SiwaNetwork/CASS/Прототип исходника фото.jpg

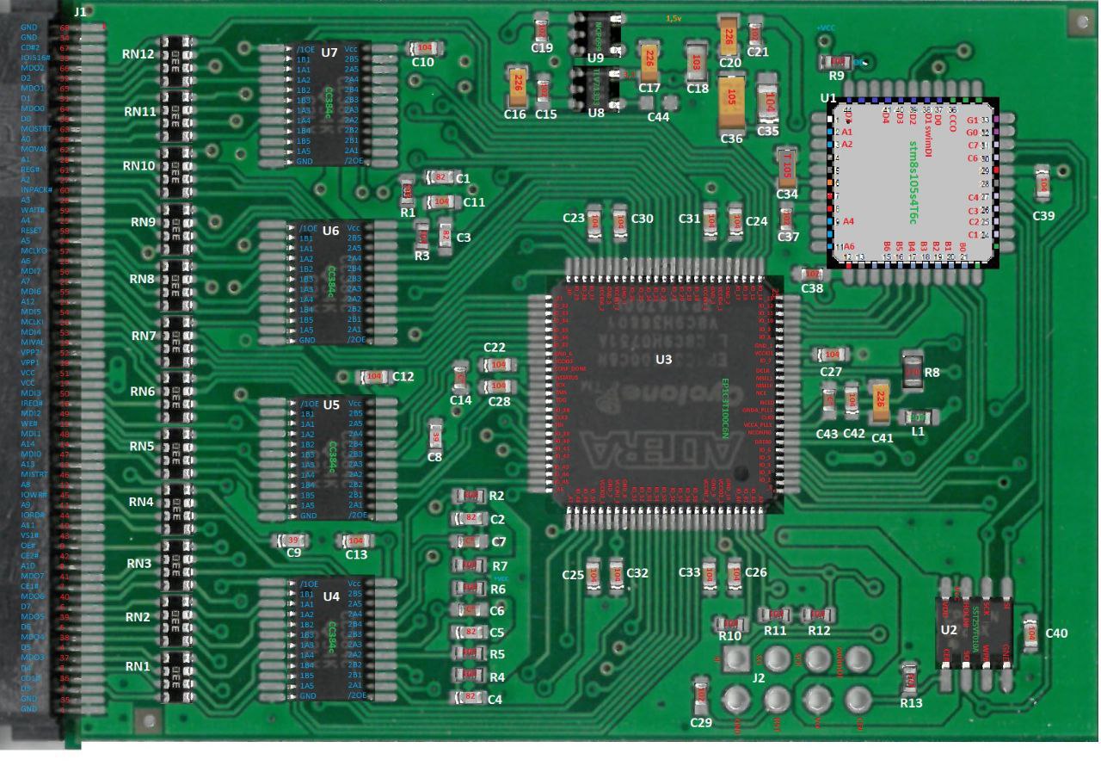
Прототип исходника фото.jpg
