SiwaNetwork/CASS/Корпус/Новая папка/Безымянный.png

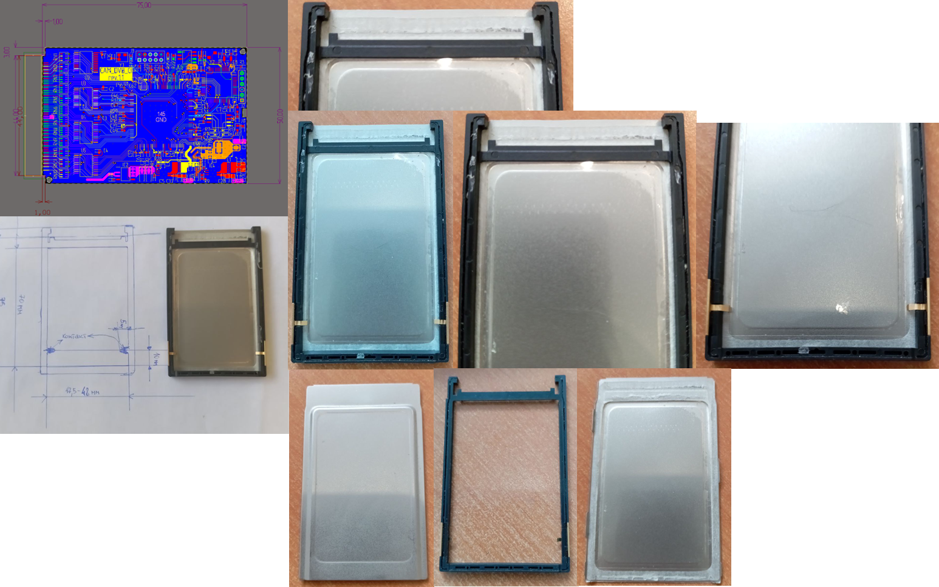
Корпус/Новая папка/Безымянный.png
