SiwaNetwork/CASS/CAM_LATTICE_STM/ECAD/README.md

# CAM_DVB_CI_v2

CAM модуль версии 2:
rev.2.0
* ПЛИС Lattice LFE5U-25F-6BG256C 
* шинники изменены на прямую версию
* добавлены тестовые пады для прошивки на станке

rev.2.01
* изменена распиновка ПЛИС

rev.2.02
* уменьшена ширина на 1мм

rev.2.1
todo
* изменить габариты платы в соответствии с новым корпусом
* внедрить коммутатор PCMCIA - JTAG
после тестирования на altera

* отказаться от шинников
