SiwaNetwork/CASS/CAM_LATTICE_STM/LATTICE REFERENCE/FPGA-SC-02033-2-0-ECP5U-25-Pinout color.xlsx

PAD | Pin/Ball Function | Bank | Dual Function | Differential | High Speed | DQS | CABGA256
0 | GND | - | - | - | - | - | A1
315 | PT42B | 1 | - | Comp_OF_PT42A | - | - | A10
304 | PT53A | 1 | - | True_OF_PT53B | - | - | A11
301 | PT53B | 1 | - | Comp_OF_PT53A | - | - | A12
288 | PT65A | 1 | - | True_OF_PT65B | - | - | A13
285 | PT65B | 1 | - | Comp_OF_PT65A | - | - | A14
283 | PT67B | 1 | - | Comp_OF_PT67A | - | - | A15
0 | GND | - | - | - | - | - | A16
368 | PT4A | 0 | - | True_OF_PT4B | - | - | A2
366 | PT6A | 0 | - | True_OF_PT6B | - | - | A3
363 | PT6B | 0 | - | Comp_OF_PT6A | - | - | A4
3 | VSSIO7 | - | - | - | - | - | -
350 | PT18A | 0 | - | True_OF_PT18B | - | - | A5
5 | VCCIO7 | - | - | - | - | - | -
347 | PT18B | 0 | - | Comp_OF_PT18A | - | - | A6
336 | PT29A | 0 | PCLKT0_0 | True_OF_PT29B | - | - | A7
8 | VCCAUX | - | - | - | - | - | -
333 | PT29B | 0 | PCLKC0_0 | Comp_OF_PT29A | - | - | A8
318 | PT42A | 1 | - | True_OF_PT42B | - | - | A9
11 | VSS | - | - | - | - | - | -
1 | PL2A | 7 | - | True_OF_PL2B | TRUE | LDQ8 | B1
316 | PT44A | 1 | - | True_OF_PT44B | - | - | B10
14 | VCC | - | - | - | - | - | -
310 | PT49A | 1 | - | True_OF_PT49B | - | - | B11
300 | PT56A | 1 | - | True_OF_PT56B | - | - | B12
17 | VSS | - | - | - | - | - | -
294 | PT60A | 1 | - | True_OF_PT60B | - | - | B13
286 | PT67A | 1 | - | True_OF_PT67B | - | - | B14
20 | VSSIO7 | - | - | - | - | - | -
277 | PR2B | 2 | S0_IN | Comp_OF_PR2A | TRUE | RDQ8 | B15
278 | PR2A | 2 | - | True_OF_PR2B | TRUE | RDQ8 | B16
23 | VCCIO7 | - | - | - | - | - | -
2 | PL2B | 7 | - | Comp_OF_PL2A | TRUE | LDQ8 | B2
365 | PT4B | 0 | - | Comp_OF_PT4A | - | - | B3
26 | VSSIO7 | - | - | - | - | - | -
357 | PT11B | 0 | - | Comp_OF_PT11A | - | - | B4
351 | PT15B | 0 | - | Comp_OF_PT15A | - | - | B5
29 | VCCIO7 | - | - | - | - | - | -
341 | PT22B | 0 | - | Comp_OF_PT22A | - | - | B6
335 | PT27B | 0 | PCLKC0_1 | Comp_OF_PT27A | - | - | B7
32 | VCCAUX | - | - | - | - | - | -
325 | PT35B | 1 | PCLKC1_0 | Comp_OF_PT35A | - | - | B8
324 | PT38A | 1 | GR_PCLK1_0 | True_OF_PT38B | - | - | B9
35 | VSS | - | - | - | - | - | -
7 | PL5A | 7 | - | True_OF_PL5B | TRUE | LDQ8 | C1
313 | PT44B | 1 | - | Comp_OF_PT44A | - | - | C10
38 | VCC | - | - | - | - | - | -
307 | PT49B | 1 | - | Comp_OF_PT49A | - | - | C11
297 | PT56B | 1 | - | Comp_OF_PT56A | - | - | C12
41 | VSS | - | - | - | - | - | -
291 | PT60B | 1 | - | Comp_OF_PT60A | - | - | C13
275 | PR2C | 2 | - | True_OF_PR2D | - | RDQ8 | C14
44 | VSSIO7 | - | - | - | - | - | -
269 | PR5B | 2 | - | Comp_OF_PR5A | TRUE | RDQ8 | C15
272 | PR5A | 2 | - | True_OF_PR5B | TRUE | RDQ8 | C16
47 | VCCIO7 | - | - | - | - | - | -
10 | PL5B | 7 | - | Comp_OF_PL5A | TRUE | LDQ8 | C2
4 | PL2C | 7 | - | True_OF_PL2D | - | LDQ8 | C3
50 | VSSIO6 | - | - | - | - | - | -
360 | PT11A | 0 | - | True_OF_PT11B | - | - | C4
354 | PT15A | 0 | - | True_OF_PT15B | - | - | C5
53 | VCCIO6 | - | - | - | - | - | -
344 | PT22A | 0 | - | True_OF_PT22B | - | - | C6
338 | PT27A | 0 | PCLKT0_1 | True_OF_PT27B | - | - | C7
56 | VCCAUX | - | - | - | - | - | -
328 | PT35A | 1 | PCLKT1_0 | True_OF_PT35B | - | - | C8
321 | PT38B | 1 | GR_PCLK1_1 | Comp_OF_PT38A | - | - | C9
59 | VSS | - | - | - | - | - | -
13 | PL8A | 7 | - | True_OF_PL8B | TRUE | LDQS8 | D1
312 | PT47A | 1 | - | True_OF_PT47B | - | - | D10
62 | VCC | - | - | - | - | - | -
306 | PT51A | 1 | - | True_OF_PT51B | - | - | D11
298 | PT58A | 1 | - | True_OF_PT58B | - | - | D12
65 | VSS | - | - | - | - | - | -
292 | PT62A | 1 | - | True_OF_PT62B | - | - | D13
273 | PR2D | 2 | - | Comp_OF_PR2C | - | RDQ8 | D14
68 | VSSIO6 | - | - | - | - | - | -
0 | GND | - | - | - | - | - | D15
266 | PR8A | 2 | - | True_OF_PR8B | TRUE | RDQS8 | D16
71 | VCCIO6 | - | - | - | - | - | -
0 | GND | - | - | - | - | - | D2
6 | PL2D | 7 | - | Comp_OF_PL2C | - | LDQ8 | D3
74 | VSSIO6 | - | - | - | - | - | -
359 | PT9B | 0 | - | Comp_OF_PT9A | - | - | D4
353 | PT13B | 0 | - | Comp_OF_PT13A | - | - | D5
77 | VCCIO6 | - | - | - | - | - | -
345 | PT20B | 0 | - | Comp_OF_PT20A | - | - | D6
339 | PT24B | 0 | GR_PCLK0_0 | Comp_OF_PT24A | - | - | D7
80 | VCCAUX | - | - | - | - | - | -
327 | PT33B | 1 | PCLKC1_1 | Comp_OF_PT33A | - | - | D8
322 | PT40A | 1 | - | True_OF_PT40B | - | - | D9
83 | VSS | - | - | - | - | - | -
24 | PL11D | 7 | - | Comp_OF_PL11C | - | LDQ8 | E1
309 | PT47B | 1 | - | Comp_OF_PT47A | - | - | E10
86 | VCC | - | - | - | - | - | -
303 | PT51B | 1 | - | Comp_OF_PT51A | - | - | E11
295 | PT58B | 1 | - | Comp_OF_PT58A | - | - | E12
89 | VSS | - | - | - | - | - | -
289 | PT62B | 1 | - | Comp_OF_PT62A | - | - | E13
270 | PR5C | 2 | - | True_OF_PR5D | - | RDQ8 | E14
92 | VSSIO6 | - | - | - | - | - | -
263 | PR8B | 2 | - | Comp_OF_PR8A | TRUE | RDQSN8 | E15
94 | VCCIO6 | - | - | - | - | - | -
255 | PR11D | 2 | - | Comp_OF_PR11C | - | RDQ8 | E16
16 | PL8B | 7 | - | Comp_OF_PL8A | TRUE | LDQSN8 | E2
97 | NC | - | - | - | - | - | -
98 | NC | - | - | - | - | - | -
99 | GND | - | - | - | - | - | -
100 | VCC | - | - | - | - | - | -
101 | VCC | - | - | - | - | - | -
102 | VSS | - | - | - | - | - | -
9 | PL5C | 7 | - | True_OF_PL5D | - | LDQ8 | E3
362 | PT9A | 0 | - | True_OF_PT9B | - | - | E4
105 | VCC | - | - | - | - | - | -
356 | PT13A | 0 | - | True_OF_PT13B | - | - | E5
348 | PT20A | 0 | - | True_OF_PT20B | - | - | E6
108 | VSS | - | - | - | - | - | -
342 | PT24A | 0 | GR_PCLK0_1 | True_OF_PT24B | - | - | E7
330 | PT33A | 1 | PCLKT1_1 | True_OF_PT33B | - | - | E8
111 | VSSIO8 | - | - | - | - | - | -
319 | PT40B | 1 | - | Comp_OF_PT40A | - | - | E9
25 | PL14A | 7 | - | True_OF_PL14B | TRUE | LDQ20 | F1
114 | VCCIO8 | - | - | - | - | - | -
0 | VCCIO1 | 1 | - | - | - | - | F10
0 | VCCIO1 | 1 | - | - | - | - | F11
117 | VSSIO8 | - | - | - | - | - | -
261 | PR8D | 2 | - | Comp_OF_PR8C | - | RDQ8 | F12
264 | PR8C | 2 | - | True_OF_PR8D | - | RDQ8 | F13
120 | VCCIO8 | - | - | - | - | - | -
267 | PR5D | 2 | - | Comp_OF_PR5C | - | RDQ8 | F14
258 | PR11C | 2 | - | True_OF_PR11D | - | RDQ8 | F15
123 | VCCAUX | - | - | - | - | - | -
254 | PR14A | 2 | - | True_OF_PR14B | TRUE | RDQ20 | F16
21 | PL11C | 7 | - | True_OF_PL11D | - | LDQ8 | F2
126 | VSS | - | - | - | - | - | -
12 | PL5D | 7 | - | Comp_OF_PL5C | - | LDQ8 | F3
15 | PL8C | 7 | - | True_OF_PL8D | - | LDQ8 | F4
129 | VCC | - | - | - | - | - | -
18 | PL8D | 7 | - | Comp_OF_PL8C | - | LDQ8 | F5
0 | VCCIO0 | 0 | - | - | - | - | F6
132 | VSS | - | - | - | - | - | -
0 | VCCIO0 | 0 | - | - | - | - | F7
0 | GND | - | - | - | - | - | F8
135 | VSSIO8 | - | - | - | - | - | -
0 | GND | - | - | - | - | - | F9
37 | PL20A | 7 | GR_PCLK7_1 | True_OF_PL20B | TRUE | LDQS20 | G1
138 | VCCIO8 | - | - | - | - | - | -
139 | VCC | - | - | - | - | - | -
140 | VCC | - | - | - | - | - | -
141 | VSS | - | - | - | - | - | -
142 | VSS | - | - | - | - | - | -
143 | VCC | - | - | - | - | - | -
144 | VCC | - | - | - | - | - | -
145 | GND | - | - | - | - | - | -
146 | GND | - | - | - | - | - | -
147 | RESERVED | - | - | - | - | - | -
148 | GND | - | - | - | - | - | -
149 | RESERVED | - | - | - | - | - | -
150 | GND | - | - | - | - | - | -
151 | GND | - | - | - | - | - | -
152 | GND | - | - | - | - | - | -
153 | GND | - | - | - | - | - | -
154 | GND | - | - | - | - | - | -
155 | GND | - | - | - | - | - | -
156 | GND | - | - | - | - | - | -
157 | GND | - | - | - | - | - | -
158 | GND | - | - | - | - | - | -
159 | GND | - | - | - | - | - | -
160 | GND | - | - | - | - | - | -
161 | GND | - | - | - | - | - | -
162 | GND | - | - | - | - | - | -
163 | GND | - | - | - | - | - | -
164 | RESERVED | - | - | - | - | - | -
165 | GND | - | - | - | - | - | -
166 | RESERVED | - | - | - | - | - | -
167 | GND | - | - | - | - | - | -
168 | GND | - | - | - | - | - | -
169 | RESERVED | - | - | - | - | - | -
170 | GND | - | - | - | - | - | -
171 | RESERVED | - | - | - | - | - | -
172 | GND | - | - | - | - | - | -
173 | GND | - | - | - | - | - | -
174 | GND | - | - | - | - | - | -
175 | GND | - | - | - | - | - | -
176 | GND | - | - | - | - | - | -
177 | VCC | - | - | - | - | - | -
178 | VSS | - | - | - | - | - | -
179 | VCC | - | - | - | - | - | -
180 | GND | - | - | - | - | - | -
181 | NC | - | - | - | - | - | -
182 | NC | - | - | - | - | - | -
0 | GND | - | - | - | - | - | G10
0 | VCCAUX | - | - | - | - | - | G11
185 | VCCIO3 | - | - | - | - | - | -
260 | PR11A | 2 | - | True_OF_PR11B | TRUE | RDQ8 | G12
187 | VSSIO3 | - | - | - | - | - | -
257 | PR11B | 2 | - | Comp_OF_PR11A | TRUE | RDQ8 | G13
252 | PR14C | 2 | VREF1_2 | True_OF_PR14D | - | RDQ20 | G14
190 | VSS | - | - | - | - | - | -
251 | PR14B | 2 | - | Comp_OF_PR14A | TRUE | RDQ20 | G15
242 | PR20A | 2 | GR_PCLK2_1 | True_OF_PR20B | TRUE | RDQS20 | G16
193 | VCC | - | - | - | - | - | -
28 | PL14B | 7 | - | Comp_OF_PL14A | TRUE | LDQ20 | G2
27 | PL14C | 7 | VREF1_7 | True_OF_PL14D | - | LDQ20 | G3
196 | VSS | - | - | - | - | - | -
22 | PL11B | 7 | - | Comp_OF_PL11A | TRUE | LDQ8 | G4
19 | PL11A | 7 | - | True_OF_PL11B | TRUE | LDQ8 | G5
199 | VCCAUX | - | - | - | - | - | -
0 | VCC | - | - | - | - | - | G6
0 | VCC | - | - | - | - | - | G7
202 | VCCIO3 | - | - | - | - | - | -
0 | GND | - | - | - | - | - | G8
0 | VCC | - | - | - | - | - | G9
205 | VSSIO3 | - | - | - | - | - | -
0 | GND | - | - | - | - | - | H1
0 | GND | - | - | - | - | - | H10
208 | VCCIO3 | - | - | - | - | - | -
0 | VCCIO2 | 2 | - | - | - | - | H11
248 | PR17A | 2 | - | True_OF_PR17B | TRUE | RDQ20 | H12
211 | VSSIO3 | - | - | - | - | - | -
245 | PR17B | 2 | - | Comp_OF_PR17A | TRUE | RDQ20 | H13
249 | PR14D | 2 | - | Comp_OF_PR14C | - | RDQ20 | H14
214 | VSS | - | - | - | - | - | -
239 | PR20B | 2 | - | Comp_OF_PR20A | TRUE | RDQSN20 | H15
0 | GND | - | - | - | - | - | H16
217 | VCC | - | - | - | - | - | -
40 | PL20B | 7 | - | Comp_OF_PL20A | TRUE | LDQSN20 | H2
30 | PL14D | 7 | - | Comp_OF_PL14C | - | LDQ20 | H3
220 | VSS | - | - | - | - | - | -
34 | PL17B | 7 | - | Comp_OF_PL17A | TRUE | LDQ20 | H4
31 | PL17A | 7 | - | True_OF_PL17B | TRUE | LDQ20 | H5
223 | VCCAUX | - | - | - | - | - | -
0 | VCCIO7 | 7 | - | - | - | - | H6
0 | VCCIO7 | 7 | - | - | - | - | H7
226 | VCCIO3 | - | - | - | - | - | -
0 | GND | - | - | - | - | - | H8
0 | GND | - | - | - | - | - | H9
229 | VSSIO3 | - | - | - | - | - | -
43 | PL23A | 7 | PCLKT7_1 | True_OF_PL23B | TRUE | LDQ20 | J1
0 | GND | - | - | - | - | - | J10
232 | VCCIO2 | - | - | - | - | - | -
0 | VCCIO2 | 2 | - | - | - | - | J11
243 | PR17D | 2 | - | Comp_OF_PR17C | - | RDQ20 | J12
235 | VSSIO2 | - | - | - | - | - | -
246 | PR17C | 2 | - | True_OF_PR17D | - | RDQ20 | J13
240 | PR20C | 2 | GR_PCLK2_0 | True_OF_PR20D | - | RDQ20 | J14
238 | VSS | - | - | - | - | - | -
233 | PR23B | 2 | PCLKC2_1 | Comp_OF_PR23A | TRUE | RDQ20 | J15
236 | PR23A | 2 | PCLKT2_1 | True_OF_PR23B | TRUE | RDQ20 | J16
241 | VCC | - | - | - | - | - | -
46 | PL23B | 7 | PCLKC7_1 | Comp_OF_PL23A | TRUE | LDQ20 | J2
39 | PL20C | 7 | GR_PCLK7_0 | True_OF_PL20D | - | LDQ20 | J3
244 | VSS | - | - | - | - | - | -
33 | PL17C | 7 | - | True_OF_PL17D | - | LDQ20 | J4
36 | PL17D | 7 | - | Comp_OF_PL17C | - | LDQ20 | J5
247 | VCCAUX | - | - | - | - | - | -
0 | VCCIO6 | 6 | - | - | - | - | J6
0 | VCCIO6 | 6 | - | - | - | - | J7
250 | VCCIO2 | - | - | - | - | - | -
0 | GND | - | - | - | - | - | J8
0 | GND | - | - | - | - | - | J9
253 | VSSIO2 | - | - | - | - | - | -
45 | PL23C | 7 | PCLKT7_0 | True_OF_PL23D | - | LDQ20 | K1
0 | GND | - | - | - | - | - | K10
256 | VCCIO2 | - | - | - | - | - | -
0 | VCCIO3 | 3 | - | - | - | - | K11
221 | PR29B | 3 | - | Comp_OF_PR29A | TRUE | RDQ32 | K12
259 | VSSIO2 | - | - | - | - | - | -
224 | PR29A | 3 | GR_PCLK3_0 | True_OF_PR29B | TRUE | RDQ32 | K13
237 | PR20D | 2 | - | Comp_OF_PR20C | - | RDQ20 | K14
262 | VSS | - | - | - | - | - | -
231 | PR23D | 2 | PCLKC2_0 | Comp_OF_PR23C | - | RDQ20 | K15
234 | PR23C | 2 | PCLKT2_0 | True_OF_PR23D | - | RDQ20 | K16
265 | VCC | - | - | - | - | - | -
48 | PL23D | 7 | PCLKC7_0 | Comp_OF_PL23C | - | LDQ20 | K2
42 | PL20D | 7 | - | Comp_OF_PL20C | - | LDQ20 | K3
268 | VSS | - | - | - | - | - | -
55 | PL29A | 6 | GR_PCLK6_0 | True_OF_PL29B | TRUE | LDQ32 | K4
58 | PL29B | 6 | - | Comp_OF_PL29A | TRUE | LDQ32 | K5
271 | VCCAUX | - | - | - | - | - | -
0 | GND | - | - | - | - | - | K6
0 | GND | - | - | - | - | - | K7
274 | VCCIO2 | - | - | - | - | - | -
0 | GND | - | - | - | - | - | K8
276 | VSSIO2 | - | - | - | - | - | -
0 | GND | - | - | - | - | - | K9
49 | PL26A | 6 | PCLKT6_1 | True_OF_PL26B | TRUE | LDQ32 | L1
279 | GND | - | - | - | - | - | -
280 | VCC | - | - | - | - | - | -
281 | VSS | - | - | - | - | - | -
282 | VCC | - | - | - | - | - | -
0 | VCC | - | - | - | - | - | L10
284 | VCCIO1 | - | - | - | - | - | -
0 | VCCIO3 | 3 | - | - | - | - | L11
219 | PR29D | 3 | - | Comp_OF_PR29C | - | RDQ32 | L12
287 | VSSIO1 | - | - | - | - | - | -
222 | PR29C | 3 | GR_PCLK3_1 | True_OF_PR29D | - | RDQ32 | L13
216 | PR32C | 3 | - | True_OF_PR32D | - | RDQ32 | L14
290 | VSS | - | - | - | - | - | -
227 | PR26B | 3 | PCLKC3_1 | Comp_OF_PR26A | TRUE | RDQ32 | L15
230 | PR26A | 3 | PCLKT3_1 | True_OF_PR26B | TRUE | RDQ32 | L16
293 | VCC | - | - | - | - | - | -
52 | PL26B | 6 | PCLKC6_1 | Comp_OF_PL26A | TRUE | LDQ32 | L2
63 | PL32C | 6 | - | True_OF_PL32D | - | LDQ32 | L3
296 | VSS | - | - | - | - | - | -
57 | PL29C | 6 | GR_PCLK6_1 | True_OF_PL29D | - | LDQ32 | L4
60 | PL29D | 6 | - | Comp_OF_PL29C | - | LDQ32 | L5
299 | VCCAUX | - | - | - | - | - | -
124 | CCLK | 8 | MCLK/SCK | - | - | - | N9
0 | VCCAUX | - | - | - | - | - | L7
302 | VCCIO1 | - | - | - | - | - | -
0 | VCC | - | - | - | - | - | L8
0 | VCC | - | - | - | - | - | L9
305 | VSSIO1 | - | - | - | - | - | -
51 | PL26C | 6 | PCLKT6_0 | True_OF_PL26D | - | LDQ32 | M1
133 | TDO | 40 | - | - | - | - | M10
308 | VCCIO1 | - | - | - | - | - | -
188 | PR47A | 3 | - | True_OF_PR47B | TRUE | RDQ44 | M11
192 | PR44C | 3 | - | True_OF_PR44D | - | RDQ44 | M12
311 | VSSIO1 | - | - | - | - | - | -
210 | PR35C | 3 | - | True_OF_PR35D | - | RDQ32 | M13
213 | PR32D | 3 | - | Comp_OF_PR32C | - | RDQ32 | M14
314 | VSS | - | - | - | - | - | -
225 | PR26D | 3 | PCLKC3_0 | Comp_OF_PR26C | - | RDQ32 | M15
228 | PR26C | 3 | PCLKT3_0 | True_OF_PR26D | - | RDQ32 | M16
317 | VCC | - | - | - | - | - | -
54 | PL26D | 6 | PCLKC6_0 | Comp_OF_PL26C | - | LDQ32 | M2
66 | PL32D | 6 | - | Comp_OF_PL32C | - | LDQ32 | M3
320 | VSS | - | - | - | - | - | -
69 | PL35C | 6 | - | True_OF_PL35D | - | LDQ32 | M4
87 | PL44C | 6 | - | True_OF_PL44D | - | LDQ44 | M5
323 | VCCAUX | - | - | - | - | - | -
91 | PL47A | 6 | - | True_OF_PL47B | TRUE | LDQ44 | M6
131 | CFG_0 | 8 | - | - | - | - | N10
326 | VCCIO1 | - | - | - | - | - | -
128 | CFG_1 | 8 | - | - | - | - | P10
130 | CFG_2 | 8 | - | - | - | - | R10
329 | VSSIO1 | - | - | - | - | - | -
61 | PL32A | 6 | - | True_OF_PL32B | TRUE | LDQS32 | N1
331 | VSS | - | - | - | - | - | -
332 | VCC | - | - | - | - | - | -
127 | DONE | 8 | - | - | - | - | P9
334 | VCCIO0 | - | - | - | - | - | -
186 | PR47B | 3 | - | Comp_OF_PR47A | TRUE | RDQ44 | N11
189 | PR44D | 3 | - | Comp_OF_PR44C | - | RDQ44 | N12
337 | VSSIO0 | - | - | - | - | - | -
206 | PR38A | 3 | - | True_OF_PR38B | TRUE | RDQ44 | N13
207 | PR35D | 3 | - | Comp_OF_PR35C | - | RDQ32 | N14
340 | VSS | - | - | - | - | - | -
0 | GND | - | - | - | - | - | N15
218 | PR32A | 3 | - | True_OF_PR32B | TRUE | RDQS32 | N16
343 | VCC | - | - | - | - | - | -
0 | GND | - | - | - | - | - | N2
72 | PL35D | 6 | - | Comp_OF_PL35C | - | LDQ32 | N3
346 | VSS | - | - | - | - | - | -
73 | PL38A | 6 | - | True_OF_PL38B | TRUE | LDQ44 | N4
90 | PL44D | 6 | - | Comp_OF_PL44C | - | LDQ44 | N5
349 | VCCAUX | - | - | - | - | - | -
93 | PL47B | 6 | - | Comp_OF_PL47A | TRUE | LDQ44 | N6
122 | INITN | 8 | - | - | - | - | T9
352 | VCCIO0 | - | - | - | - | - | -
110 | PB11A | 8 | D1/MISO/IO1 | True_OF_PB11B | - | - | T7
113 | PB11B | 8 | D0/MOSI/IO0 | Comp_OF_PB11A | - | - | T8
355 | VSSIO0 | - | - | - | - | - | -
67 | PL35A | 6 | - | True_OF_PL35B | TRUE | LDQ32 | P1
115 | PB13A | 8 | SN/CSN | True_OF_PB13B | - | - | R8
358 | VCCIO0 | - | - | - | - | - | -
184 | PR47C | 3 | LRC_GPLL0T_IN | True_OF_PR47D | - | RDQ44 | P11
183 | PR47D | 3 | LRC_GPLL0C_IN | Comp_OF_PR47C | - | RDQ44 | P12
361 | VSSIO0 | - | - | - | - | - | -
200 | PR41A | 3 | - | True_OF_PR41B | TRUE | RDQ44 | P13
203 | PR38B | 3 | - | Comp_OF_PR38A | TRUE | RDQ44 | P14
364 | VSS | - | - | - | - | - | -
215 | PR32B | 3 | - | Comp_OF_PR32A | TRUE | RDQSN32 | P15
212 | PR35A | 3 | - | True_OF_PR35B | TRUE | RDQ32 | P16
367 | VCC | - | - | - | - | - | -
64 | PL32B | 6 | - | Comp_OF_PL32A | TRUE | LDQSN32 | P2
369 | VSS | - | - | - | - | - | -
370 | VCC | - | - | - | - | - | -
371 | VCC | - | - | - | - | - | -
372 | GND | - | - | - | - | - | -
0 | NC | - | - | - | - | - | -
76 | PL38B | 6 | - | Comp_OF_PL38A | TRUE | LDQ44 | P3
79 | PL41A | 6 | - | True_OF_PL41B | TRUE | LDQ44 | P4
96 | PL47D | 6 | LLC_GPLL0C_IN | Comp_OF_PL47C | - | LDQ44 | P5
95 | PL47C | 6 | LLC_GPLL0T_IN | True_OF_PL47D | - | LDQ44 | P6
118 | PB13B | 8 | CS1N | Comp_OF_PB13A | - | - | P8
116 | PB15A | 8 | HOLDN/DI/BUSY/CSSPIN/CEN | True_OF_PB15B | - | - | N8
119 | PB15B | 8 | DOUT/CSON | Comp_OF_PB15A | - | - | M8
70 | PL35B | 6 | VREF1_6 | Comp_OF_PL35A | TRUE | LDQ32 | R1
121 | PB18A | 8 | WRITEN | - | - | - | M9
136 | TDI | 40 | - | - | - | - | R11
194 | PR44A | 3 | - | True_OF_PR44B | TRUE | RDQS44 | R12
198 | PR41C | 3 | - | True_OF_PR41D | - | RDQ44 | R13
197 | PR41B | 3 | - | Comp_OF_PR41A | TRUE | RDQ44 | R14
204 | PR38C | 3 | - | True_OF_PR38D | - | RDQ44 | R15
209 | PR35B | 3 | VREF1_3 | Comp_OF_PR35A | TRUE | RDQ32 | R16
75 | PL38C | 6 | - | True_OF_PL38D | - | LDQ44 | R2
82 | PL41B | 6 | - | Comp_OF_PL41A | TRUE | LDQ44 | R3
81 | PL41C | 6 | - | True_OF_PL41D | - | LDQ44 | R4
85 | PL44A | 6 | - | True_OF_PL44B | TRUE | LDQS44 | R5
103 | PB4A | 8 | D7/IO7 | True_OF_PB4B | - | - | T6
106 | PB4B | 8 | D6/IO6 | Comp_OF_PB4A | - | - | R6
104 | PB6A | 8 | D5/MISO2/IO5 | True_OF_PB6B | - | - | R7
107 | PB6B | 8 | D4/MOSI2/IO4 | Comp_OF_PB6A | - | - | P7
0 | GND | - | - | - | - | - | T1
134 | TCK | 40 | - | - | - | - | T10
137 | TMS | 40 | - | - | - | - | T11
0 | GND | - | - | - | - | - | T12
0 | GND | - | - | - | - | - | -
0 | GND | - | - | - | - | - | -
0 | GND | - | - | - | - | - | -
0 | GND | - | - | - | - | - | -
0 | GND | - | - | - | - | - | -
0 | GND | - | - | - | - | - | -
0 | GND | - | - | - | - | - | -
0 | GND | - | - | - | - | - | -
0 | GND | - | - | - | - | - | -
0 | GND | - | - | - | - | - | -
0 | GND | - | - | - | - | - | -
0 | GND | - | - | - | - | - | -
0 | GND | - | - | - | - | - | -
0 | GND | - | - | - | - | - | -
0 | GND | - | - | - | - | - | -
0 | GND | - | - | - | - | - | -
0 | GND | - | - | - | - | - | -
0 | GND | - | - | - | - | - | -
0 | GND | - | - | - | - | - | -
0 | GND | - | - | - | - | - | -
0 | GND | - | - | - | - | - | -
0 | GND | - | - | - | - | - | -
0 | GND | - | - | - | - | - | -
0 | GND | - | - | - | - | - | -
0 | GND | - | - | - | - | - | -
0 | GND | - | - | - | - | - | -
0 | GND | - | - | - | - | - | -
0 | GND | - | - | - | - | - | -
0 | GND | - | - | - | - | - | -
0 | GND | - | - | - | - | - | -
0 | GND | - | - | - | - | - | -
0 | GND | - | - | - | - | - | -
0 | GND | - | - | - | - | - | -
0 | GND | - | - | - | - | - | -
0 | GND | - | - | - | - | - | -
0 | GND | - | - | - | - | - | -
0 | GND | - | - | - | - | - | -
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
0 | NC | - | - | - | - | - | -
0 | NC | - | - | - | - | - | -
0 | NC | - | - | - | - | - | -
0 | NC | - | - | - | - | - | -
0 | NC | - | - | - | - | - | -
0 | NC | - | - | - | - | - | -
0 | NC | - | - | - | - | - | -
0 | NC | - | - | - | - | - | -
0 | NC | - | - | - | - | - | -
0 | NC | - | - | - | - | - | -
0 | NC | - | - | - | - | - | -
0 | NC | - | - | - | - | - | -
0 | NC | - | - | - | - | - | -
0 | NC | - | - | - | - | - | -
0 | NC | - | - | - | - | - | -
0 | NC | - | - | - | - | - | -
0 | NC | - | - | - | - | - | -
0 | NC | - | - | - | - | - | -
0 | NC | - | - | - | - | - | -
0 | NC | - | - | - | - | - | -
0 | NC | - | - | - | - | - | -
0 | NC | - | - | - | - | - | -
0 | NC | - | - | - | - | - | -
0 | NC | - | - | - | - | - | -
0 | NC | - | - | - | - | - | -
0 | NC | - | - | - | - | - | -
0 | NC | - | - | - | - | - | -
0 | NC | - | - | - | - | - | -
0 | NC | - | - | - | - | - | -
0 | NC | - | - | - | - | - | -
0 | NC | - | - | - | - | - | -
0 | NC | - | - | - | - | - | -
0 | NC | - | - | - | - | - | -
0 | NC | - | - | - | - | - | -
0 | NC | - | - | - | - | - | -
