SiwaNetwork/CASS/CAM_TIME/ECAD/cam_time_v3/README.md

# CAM_DVB_CI_v2

CAM модуль версии 2:
rev.2.0
* ПЛИС Lattice LFE5U-25F-6BG256C 
* шинники изменены на прямую версию
* добавлены тестовые пады для прошивки на станке

rev.2.1
todo
* изменить габариты платы в соответствии с новым корпусом

после тестирования на altera
* внедрить коммутатор PCMCIA - JTAG
* отказаться от шинников
