SiwaNetwork/CASS/ТЗ на конструирование оснастки для пресования.docx

ТЕХНИЧЕСКОЕ ЗАДАНИЕ
на конструирование оснастки
(пресс-форма)
для CAM модулей

# 1 Описание

Разрабатываемая оснастка предназначена для нанесения на пластиковую рамку (материал ABS) клея, установки в рамку печатной платы модуля и запрессовывания 2-х металлических крышек в пластиковую рамку.

# 2 Конструктивные требования

## 2.1 Форма для склеивания

Необходимо разработать 2 пластины «A» и «AA» для установки 6 и 12 пластиковых рамок соответственно (см. рисунки 1 и 2).

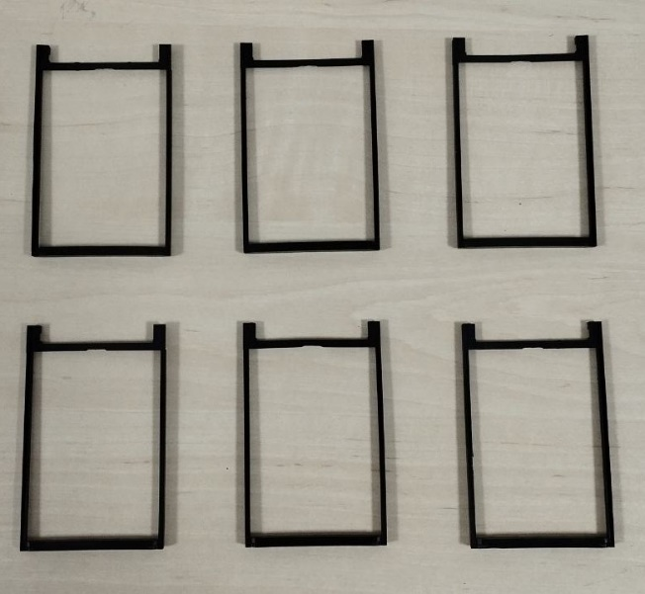
[picture p8: figure]
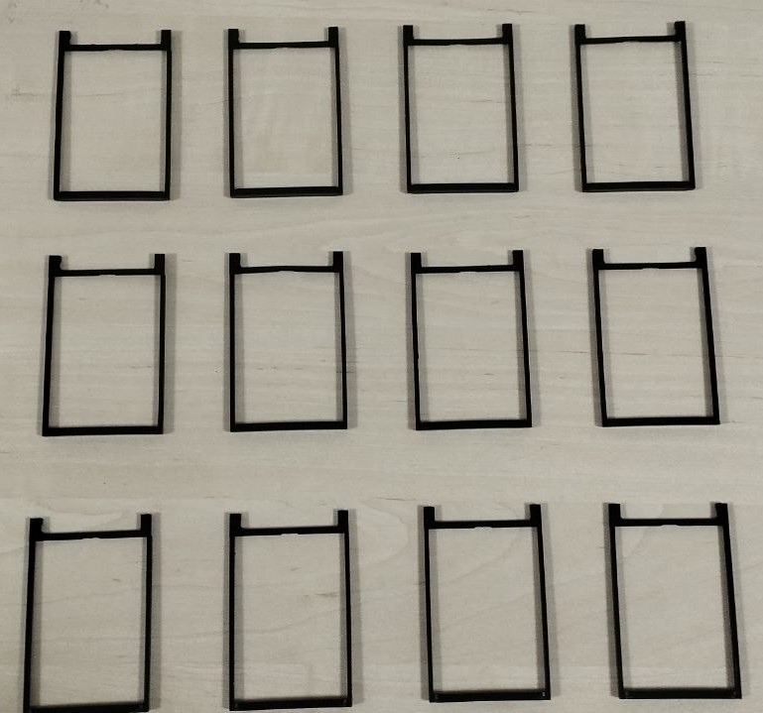
[picture p9: figure]

Рисунок 1 | | Рисунок 2

Пластина «А» должна состоять из склеенных между собой пластин «B», «C» и «D», а пластина «AA» должна состоять из склеенных между собой пластин «BB», «CC» и «DD».

### 2.1.1 Пластины «А» и «AA» отличаются только размером, связанным с количеством устанавливаемых изделий (6 и 12 шт.).

### 2.1.2 Толщина пластин «B», «BB», «C» и «CC» – 1 мм.

### 2.1.3 Толщина пластин «D» и «DD» – 10 мм.

### 2.1.4 В пластинах «B» и «BB» должны быть сделаны вырезы для установки пластиковых рамок, предназначенные для исключения смещения пластиковых рамок во время склеивания (см. рисунок 3 и 4).

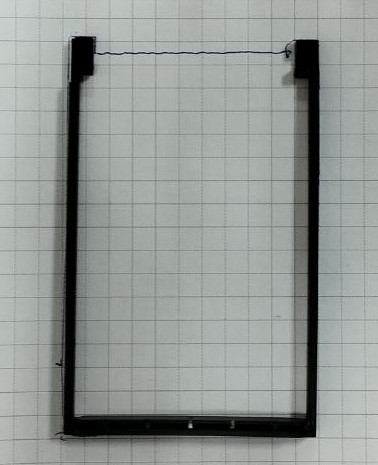
[picture p10: figure]
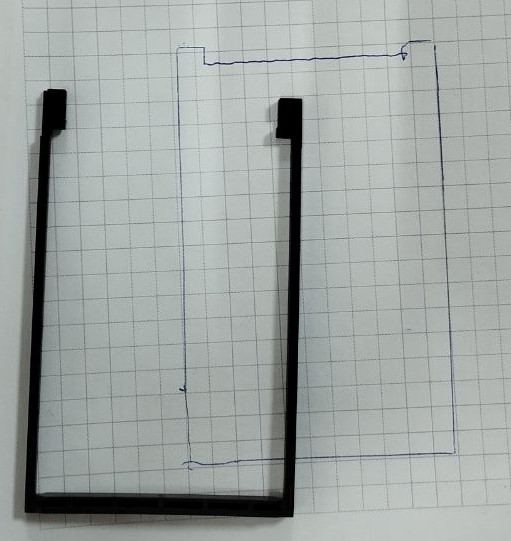
[picture p11: figure]

Рисунок 3 | | Рисунок 4

### 2.1.5 В пластинах «C» и «CC» должны быть сделаны вырезы шириной с пластиковую рамку и высотой с толщину нижней выпирающей части пластиковой рамки.

### 2.1.6 Пластины «D» и «DD» изготавливаются монолитными.

## 2.2 Форма для прессования

Необходимо разработать 2 пластины «E» и «EE» для установки 6 и 12 модулей соответственно (см. рисунки 5 и 6).

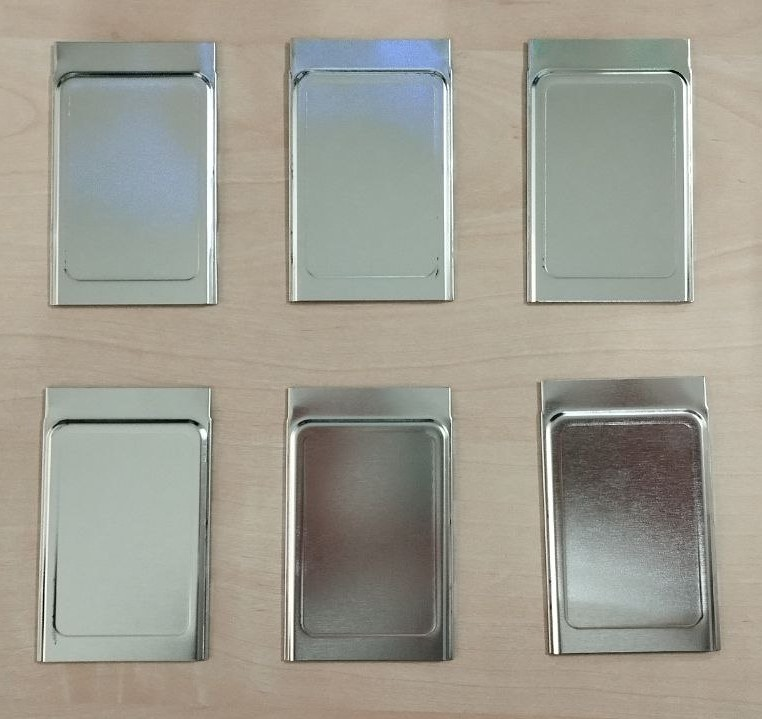
[picture p12: figure]
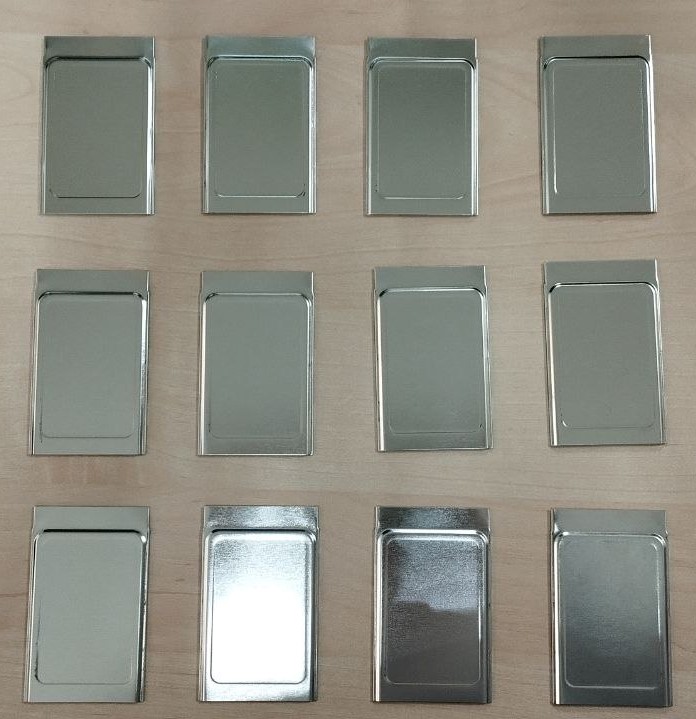
[picture p13: figure]

Рисунок 5 | | Рисунок 6

Пластина «E» должна состоять из склеенных между собой пластин «G», «H» и «K», а пластина «EE» должна состоять из склеенных между собой пластин «GG», «HH» и «KK».

### 2.2.1 Пластины «E» и «EE» отличаются только размером, связанным с количеством устанавливаемых изделий (6 и 12 шт.).

### 2.2.2 Толщина пластин «G», «GG», «H» и «HH» – 1 мм.

### 2.2.3 Толщина пластин «K» и «KK» – не менее 10 мм.

### 2.2.4 В пластинах «G» и «GG» должны быть сделаны вырезы для установки модуля, предназначенные для давления формы на модуль по краям (см. рисунок 7, 8 и 9).

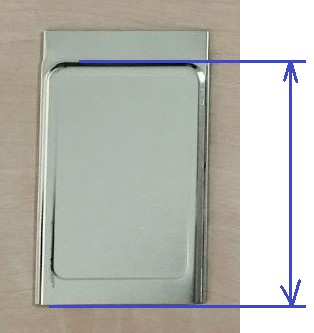
[picture p14: figure]
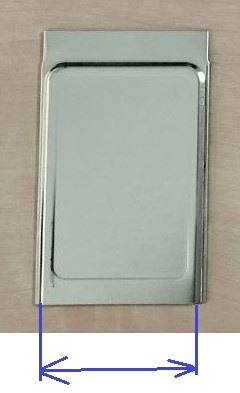
[picture p15: figure]
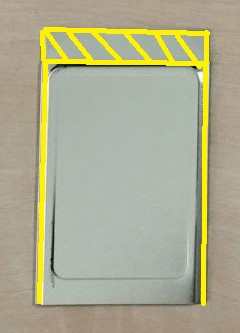
[picture p16: figure]

Рисунок 7 | | Рисунок 8 | | Рисунок 9 – области давления на модуль

### 2.2.5 В пластинах «H» и «HH» должны быть сделаны вырезы для установки модуля, предназначенные для давления формы на модуль (см. рисунок 8, 10 и 11).

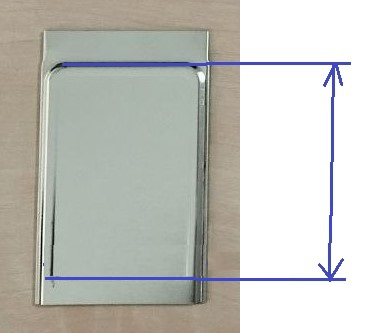
[picture p17: figure]
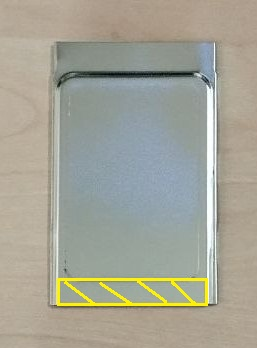
[picture p18: figure]

Рисунок 10 | | Рисунок 11 – область давления на модуль

### 2.2.6 Пластины «K» и «KK» изготавливаются монолитными.

## 2.3 В пластинах «A» и «E», пластинах «AA» и «EE» должны быть сделаны 4 отверстия диаметром 5 мм с целью позиционирования пластин между собой в соответствии с рисунком 12.

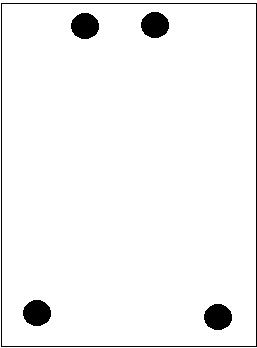
[picture p19: figure]

Рисунок 12 – схема ориентировочного расположения центровочных отверстий.

# 3 Описание использования оснастки

## 3.1 Далее будет описание работы с пластинами «А» и «E», с пластинами «АA» и «EE» аналогично.

## 3.2 В пластину «А» устанавливаются пластиковые рамки (см. рисунок 3).

## 3.3 Далее пластина устанавливается в ЧПУ-клеевой станок.

## 3.4 После нанесения клея на пластиковые рамки сверху них устанавливаются металлические крышки (см. рисунок 13 и 14).

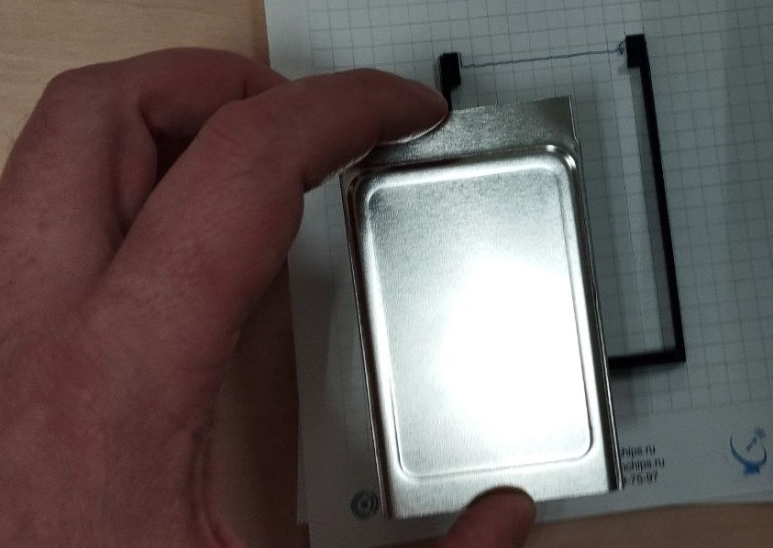
[picture p20: figure]

Рисунок 13

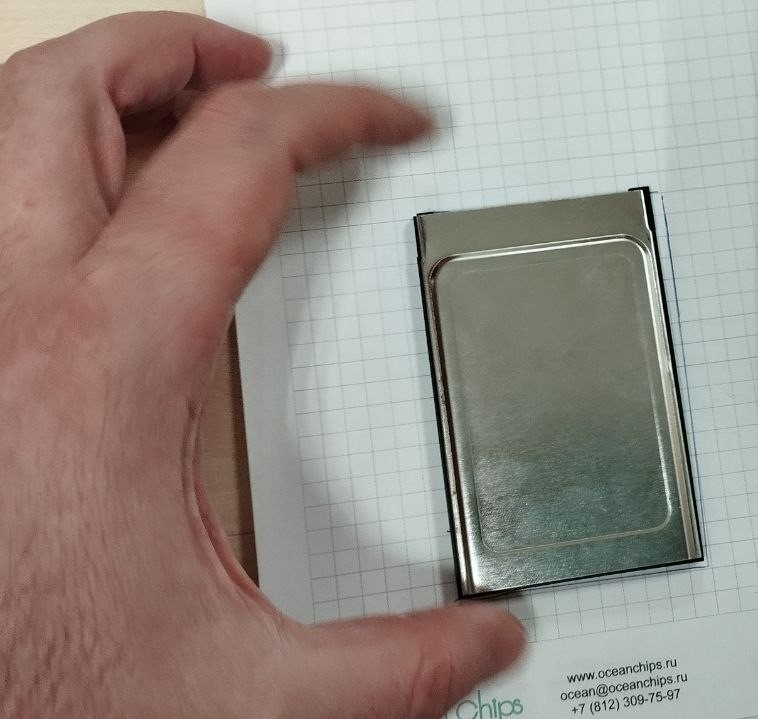
[picture p21: figure]

Рисунок 14

## 3.5 Далее берется пластина «E» и после нанесения на неё разделяющего состава пластина устанавливается сверху на пластину «А».

## 3.6 Обе пластины переворачиваются.

## 3.7 Пластина «А» убирается в сторону, при этом заготовка имеет вид в соответствии с рисунком 15.

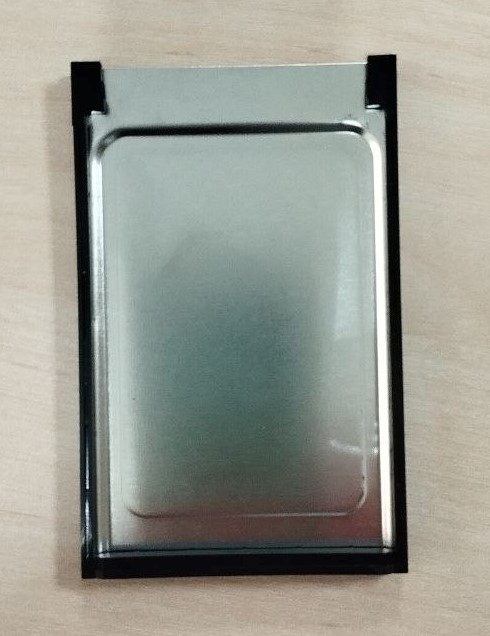
[picture p22: figure]

Рисунок 15

## 3.8 Пластина «EE» устанавливается в ЧПУ-клеевой станок.

## 3.9 После нанесения клея на пластиковые рамки сверху них устанавливаются печатные платы (см. рисунок 16).

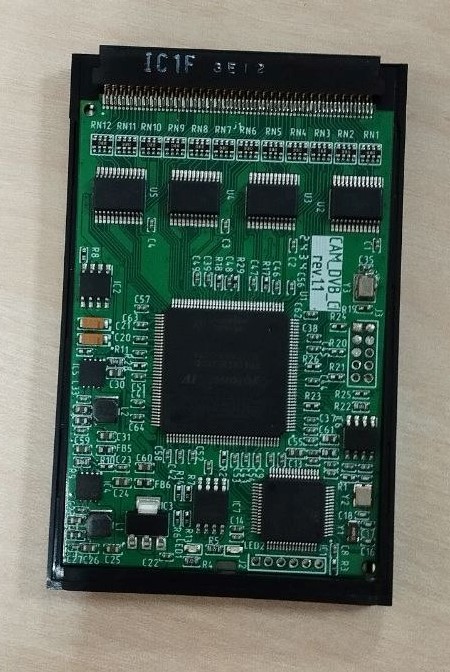
[picture p23: figure]

Рисунок 16

## 3.10 Пластина «EE» повторно устанавливается в ЧПУ-клеевой станок для нанесения клея на разъем модуля.

## 3.11 После нанесения клея на разъем модуля сверху них устанавливаются металлические крышки (см. рисунок 13 и 14).

## 3.12 Сверху пластины «EE» с модулями устанавливается ещё одна пластина «EE» (тоже обработанная разделяющим составом).

## 3.13 Далее этот сэндвич прессуется с помощью пресса или гнёта.

# 4 Материалы и способ прессования

Материалы пластин, выбор клея и способ прессования уточняются в процессе проектирования оснастки.
