SiwaNetwork/CASS/КД и ЭД/ТЕНШ.463269.01 ПС-ЛУ.docx

Изделие 3Ю-00-4Технические условияНМКБ.469332.001 ТУ

Общество с ограниченной ответственностью

### «ШИВА НЕТВОРК»

| | | Утверждаю Генеральный директор В.О. Миронов «___» ___________ 20___ г.

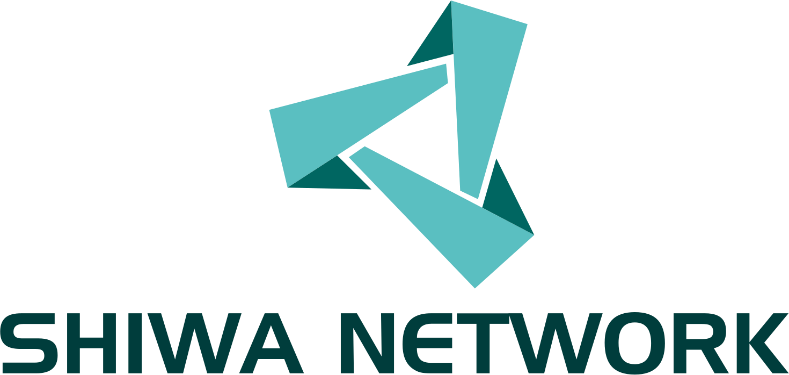
[picture p24: figure]

МОДУЛЬ УСЛОВНОГО ДОСТУПА
PRO

Паспорт

Лист утверждения

ТЕНШ.463269.01 ПС-ЛУ
| | | СОГЛАСОВАНО Главный конструктор А.Б. Михайлов «___» ___________ 20___ г.

Подп. и дата Инв. № дубл. Взам. инв. № Подп. и дата Инв. № подл. Формат А4

Подп. и дата Инв. № дубл. Взам. инв. № Подп. и дата Инв. № подл. Литера____ Формат А4
