SiwaNetwork/CASS/КД и ЭД/ТЕНШ.463269.01 ПС.docx

Блок антенный СДВ-Р-ШПаспортТСЮИ.464659.110 ПСТСЮИ.464659.110

Общество с ограниченной ответственностью

«ШИВА НЕТВОРК»
Утверждено ТЕНШ.463269.01 ПС-ЛУ


МОДУЛЬ УСЛОВНОГО ДОСТУПА
PRO

Паспорт

ТЕНШ.463269.01 ПС

| | | | | ТЕНШ.463269.01 ПС
Изм. | Лист | № докум. | Подп. | Дата
Разраб. | | Михайлов | | | Модуль условного доступа PRO Паспорт | | Лит. | | | | Лист | Листов
Пров. | | Терентьева-Руденко | | | | | | | | | 2 | 15
Норм. кконконтр. | | Миронов
Утв. | | Миронов

Перв. примен. | ТЕНШ.463269.01
Справ. №

# 1 Основные сведения и технические данные

Нач.ОТК Михайлов

## 1.1 Наименование: модуль условного доступа PRO

## 1.2 Обозначение: ТЕНШ.463269.01

## 1.3 Дата выпуска: ____.____.________.

## 1.4 Перед началом эксплуатации модуля условного доступа PRO (далее – Изделие) необходимо внимательно ознакомиться с эксплуатационной документацией.

## 1.5 Настоящий паспорт должен находиться в отделе, ответственном за эксплуатацию изделия.

## 1.6 Изделие разработано компанией ООО «ШИВА НЕТВОРК».

## 1.7 Изготовление, поставка, гарантийное и сервисное обслуживание, ремонт изделия осуществляется компанией ООО «ШИВА НЕТВОРК», 109028, г. Москва, вн. тер. г. муниципальный округ Таганский, ул. Земляной Вал, д. 50А, стр. 2, помещ. 1/13, почта: shiwanetwork@qmail.ru.

# 2 НАЗНАЧЕНИЕ И ОБЛАСТЬ ПРИМЕНЕНИЯ

## 2.1 Изделие представляет собой электронное устройство, используемое как адаптер системы кодирования к общим интерфейсам условного доступа в телевизорах и ресиверах цифрового телевидения для обеспечения доступа абонентов к зашифрованному медиаконтенту в цифровом телевидении.

2.2 Изделие – универсальная аппаратная платформа, предназначенная для установки программного обеспечения (далее – ПО) различных систем условного доступа (далее – СУД) от разных разработчиков. Представляет собой базовую аппаратную платформу с установленным загрузчиком (далее – Bootloader), обеспечивающим возможность работы с различными СУД.

# 3 ОПИСАНИЕ

## 2.3 Изделие выполнено в форум-факторе PCMCIA Type II.

## 2.4 Изделие представляет из себя компактное устройство, являющееся одним из основных элементов архитектуры цифрового телевидения. С помощью данного изделия осуществляется непосредственно дескремблирование сервисов, содержащихся в принятом сигнале.

## 2.5 Установка изделия выполняется в зависимости от выбранной СУД, делает оборудование универсальным и позволяет поменять абоненту или оператору пакет услуг оперативно и с минимальными затратами.

2.6 Изделие позволяет производить дескремблирование до 32 сервисов в зависимости от установленной СУД. Так же изделие является совместимым с профессиональным оборудованием. Для подключения изделия применяется CI интерфейс. Подключение может осуществляться со стороны IRD (профессионального приемника), так и при использовании выделенного оборудования для установки таких модулей так называемых дескремблеров. Контроль над правами для дешифрования осуществляется с помощью встроенных функций, установленных СУД.

## 2.7 Основные особенности:

Универсальная аппаратная база;

Предустановленный безопасный Bootloader;

Поддержка различных форматов шифрования;

Средства защиты от несанкционированного доступа;

Поддержка мультивендорности (возможность установки ПО различных СУД-вендоров);

Защищенная среда исполнения приложений;

Интерфейс DVB-CI: Совместимый с DVB-CI / PCMCIA;

Возможность удаленного обновления ПО;

Бескарточная технология управления доступом.

# 3 Характеристики ИЗДЕЛИЯ

## 3.1 Общие характеристики:

Процессорное ядро: Arm Cortex-M4;

Размеры: Type II PCMCIA-карта (100 мм x 58 мм x 5 мм);

Разъем: 68-контактный PCMCIA слот;

Рабочее напряжение: 3,0V – 5,5V;

Энергопотребление: <500 мВт;

TS пропускная способность: до 96 Mbps (200 Мбит/с);

Степень защиты: IP44.

## 3.2 Поддерживаемые стандарты:

DVB-CI;

MPEG-2, MPEG-4 SD и HD;

Аудио: MPEG2, AAC, HE-AAC, Dolby и др.

## 3.3 Программное обеспечение:

Поддержка различных СУД-систем;

Безопасный загрузчик;

Возможность обновления ПО;

Защита от несанкционированного доступа.

Начальник ОТК
| МП
| | | личная подпись | | расшифровка подписи | | год, месяц, число

# 4 Комплектность

## 4.1 Сведения о комплектности изделия приведены в таблице 5.1.

## 4.2 Комплект поставки оборудования определяется при заключении контракта на поставку. При поставке допускается общая упаковка.

## 4.3 Таблица 5.1

№ п.п | Наименование | Кол. | Номер
1 | Модуль условного доступа PRO ТЕНШ.463269.01 | 1 | Зав. № __________________ ID №____________________
2 | Упаковка | 1 | –

Документация
3 | Паспорт ТЕНШ.463269.01 ПС или гарантийный талон (в соответствии с договором поставки) | 1 | –
4 | Руководство пользователя ТЕНШ.463269.001 РО | 1 | -

Начальник ОТК
| МП
| | | личная подпись | | расшифровка подписи | | год, месяц, число

# 5 Ресурсы, сроки службы и хранения и гарантии изготовителя (поставщика)

## 5.1 Ресурсы, сроки службы и хранения

### 5.1.1 Средний срок службы – 10 лет с момента приемки представителем ОТК на предприятии-изготовителе.

### 5.1.2 Средняя наработка на отказ – 50 000 часов.

### 5.1.3 Указанные срок службы и срок хранения действительны при соблюдении потребителем требований настоящего паспорта.

## 5.2 Гарантии изготовителя (поставщика).

### 5.2.1 Предприятие-изготовитель (поставщик) гарантирует соответствие требований технических условий Изделия при соблюдении потребителем условий и правил хранения, транспортирования и эксплуатации, установленных настоящим паспортом.

### 5.2.2 Гарантийный срок эксплуатации – 1 (один) год с момента ввода изделия в эксплуатацию или продажи потребителю.

### 5.2.3 Гарантийный срок хранения, предшествующий гарантийному сроку эксплуатации – 2 (два) года с момента приемки изделия на предприятии-изготовителе (поставщик) до ввода изделия в эксплуатацию или продажи потребителю.

### 5.2.4 Предприятие изготовитель (поставщик) в пределах срока действия гарантий поставщика производит безвозмездное восстановление изделия в случае возникновения отказов и неисправностей не по вине потребителя.

## 5.3 Условия прерывания гарантийных обязательств

### 5.3.1 Несоответствие серийного или ID номера предъявляемого на гарантийное обслуживание изделия номеру, указанному в паспорте.

### 5.3.2 Наличие явных или скрытых механических повреждений изделия, вызванных нарушением правил транспортировки, хранения или эксплуатации.

### 5.3.3 Выявленное в процессе ремонта несоответствие Правилам и условиям эксплуатации, предъявляемым к изделию данного типа.

### 5.3.4 Наличие внутри корпуса изделия посторонних предметов, независимо от их природы.

### 5.3.5 Отказ изделия, вызванный воздействием факторов непреодолимой силы и/или действиями третьих лиц.

### 5.3.6 Установка и запуск изделия несертифицированным персоналом.

Начальник ОТК
| МП
| | | личная подпись | | расшифровка подписи | | год, месяц, число

# 6 свидетельство об упаковывании

## 6.1 Упаковка изделия осуществляется согласно требованиям, предусмотренным в документации на упаковку Изделия.

# 7 Свидетельство о приемке

## 7.1 Модуль условного доступа PRO ТЕНШ.463269.01 № ______________________ изготовлен и принят в соответствии с обязательными требованиями государственных стандартов, действующей технической документацией и признан годным для

________________________________________________________________________________________

_________________________________________________________________________________________

Руководитель предприятия | | | | | | | ТЕНШ.463269.01 ТУ
| | | | | | | обозначение документа, по которому производится поставка
| МП
| | | личная подпись | | | расшифровка подписи | | | год, месяц, число

Начальник ОТК
| МП
| | | личная подпись | | расшифровка подписи | | год, месяц, число

# 8 Ремонт

## 8.1 Краткие записи о произведенном ремонте

Сведения о проведении ремонтных работ приведены в таблице 9.1.

Таблица 9.1 – Сведения о проведении ремонтных работ

Дата сдачи в ремонт | Причина поступления в ремонт | Краткие сведения о ремонте (вид ремонта и описание) | Подпись лица, проводившего ремонт

## 8.2 Свидетельство о приемке и гарантии

## Модуль условного доступа PRO ТЕНШ.463269.01 № _________________________ после

| ремонта на
вид ремонта | | наименование предприятия, условное обозначение

принято в соответствии с требованиями технических условий на Изделие и признано годным для _________________________________________________________________________________________

_________________________________________________________________________________________

Ресурс изделия до очередного ремонта

параметр, характеризующий наработку

в течение срока службы ____ лет, в том числе срок хранения ____ лет в ___________________________ .

## условия хранения

## Исполнитель ремонта гарантирует соответствие изделия требованиям технических условий при соблюдении потребителем требований действующей эксплуатационной документации.

Начальник ОТК
| МП
| | | личная подпись | | расшифровка подписи | | год, месяц, число

# 9 ЗАМЕТКИ ПО ЭКСПЛУАТАЦИИ и хранению

## 9.1 Требования к условиям эксплуатации

### 9.1.1 Предельно допустимые значения внешних воздействующих факторов при эксплуатации изделия приведены в таблице 10.1.

Таблица 10.1 – Предельно допустимые значения внешних воздействующих факторов

Наименование параметра | Значение
Температура окружающей среды:
Температура хранения повышенная кратковременная, °С, не более | 70
Температура хранения пониженная кратковременная, °С, не менее | минус 50
Рабочая повышенная, °С, не более | 55
Рабочая пониженная, °С, не менее | минус 40
Повышенная относительная влажность среды при температуре 35 °С, %, не более | 80
Пониженное атмосферное давление, Па (мм рт.ст.) | 8,4∙10⁴ (630)
Повышенное атмосферное давление, Па (мм рт.ст.) | 107 (800)

## 9.2 Транспортирование

### 9.2.1 Транспортирование изделия производят в штатной упаковке при температуре от минус 50 °С до 50 °С всеми видами транспорта в условиях, исключающих прямое попадание атмосферных осадков:

- железнодорожным – на расстояние не более 10 000 км со скоростями, допустимыми на железнодорожном транспорте;
- морским, речным;
- воздушным – в герметизированных кабинах на высотах до 10 000 м;
- автомобильным – на расстояние до 1 000 км по шоссейным дорогам со скоростью, регламентируемой правилами дорожного движения, и до 200 км со скоростью, не превышающей 20 км/ч, по грунтовым дорогам.

## 9.3 Хранение

### 9.3.1 Изделие должно храниться в штатной упаковке в отапливаемом хранилище при температуре окружающей среды от 0 °С до плюс 35 °С и относительной влажности воздуха до 80 % в течение всего гарантийного срока хранения. Наличие в воздухе паров агрессивных веществ не допускается.

# 10 СВЕДЕНИЯ ОБ УТИЛИЗАЦИИ

## 10.1 Изделие после выработки технического ресурса подлежит утилизации в соответствии с установленными регламентами страны эксплуатанта.

Лист регистрации изменений

Изм. | Номера листов (страниц) | | | | Всего листов (страниц) в докум. | № докум. | Входящий № сопроводитель-ного докум. и дата | Подп. | Дата
| изме-нен-ных | заме-нен-ных | новых | аннулиро-ванных

Подп. и дата Инв. № дубл. Взам. инв. № Подп. и дата Инв. № подл. Формат А4

Лист 4 ТСЮИ.464659.110 ПС Изм. Лист № докум. Подп. Дата

ТЕНШ.463269.01 ПС Лист 15 Изм. Лист № докум. Подп. Дата Подп. и дата Инв. № дубл. Взам. инв. № Подп. и дата Инв. № подл. Формат А4
