SiwaNetwork/CASS/Корпус/Корпус.pdf

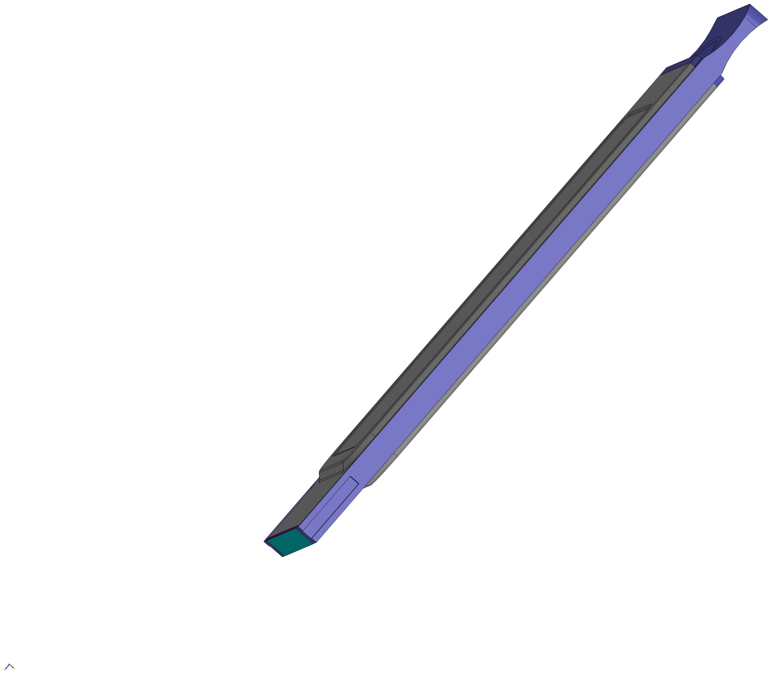
[picture p42: page 1]
