SiwaNetwork/CASS/Демо борд переходник/Демо итог/com_1300.jpg

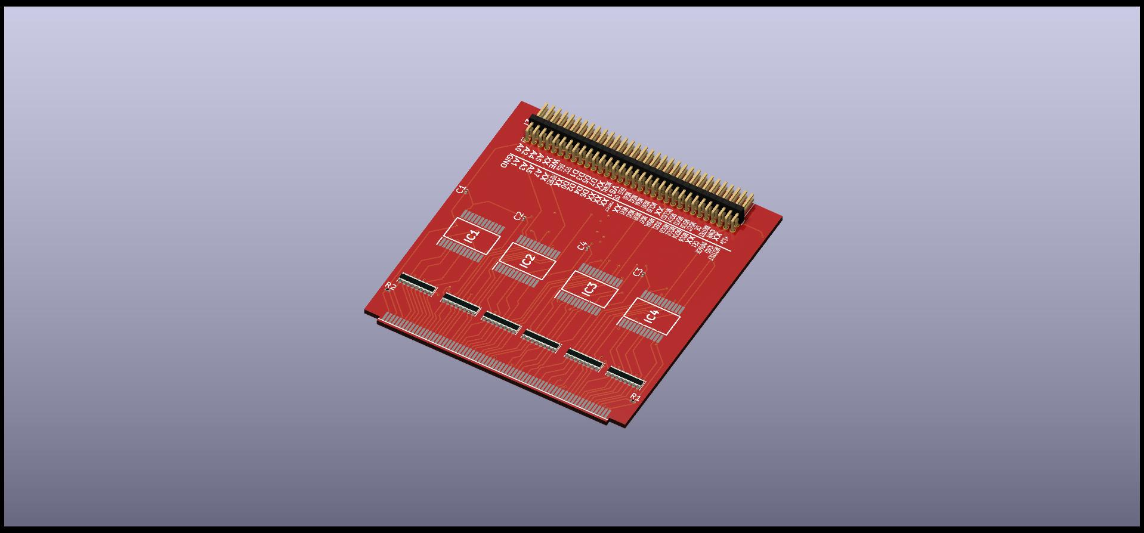
Демо борд переходник/Демо итог/com_1300.jpg
