SiwaNetwork/CASS/Демо борд переходник/Переходник.png

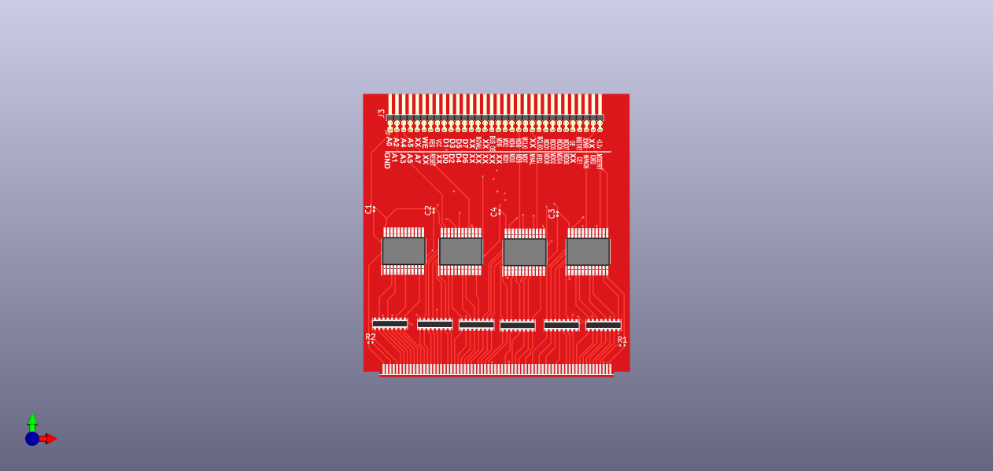
Демо борд переходник/Переходник.png
