SiwaNetwork/CASS/Корпус/Изображение WhatsApp 2025-01-17 в 09.19.33_c310d4a8.jpg

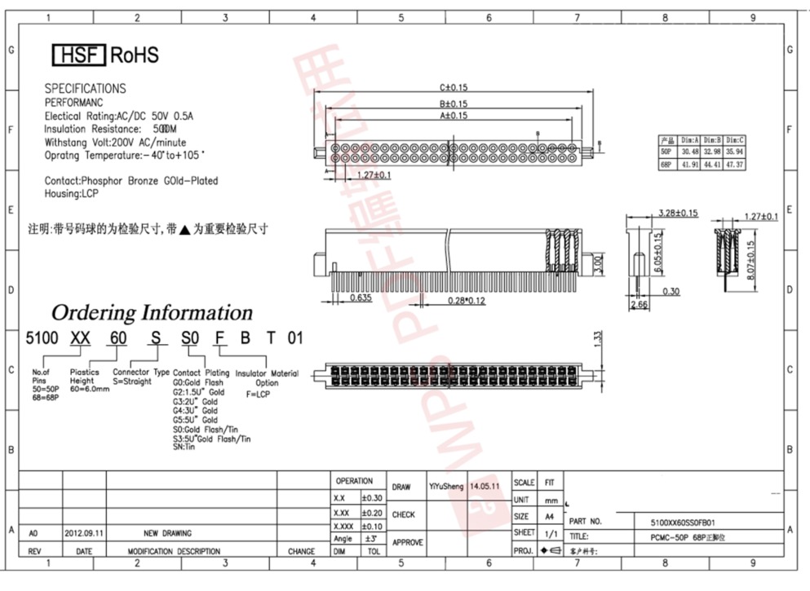
Корпус/Изображение WhatsApp 2025-01-17 в 09.19.33_c310d4a8.jpg
