SiwaNetwork/CASS/CAM_EXTENSION/CAM_EXT_v1_release_rev.1_BOM 2025-09-01 14-21_ans.xlsx

Designator | Comment | Description | Footprint | LibRef | Quantity | HelpURL | Value | EQ | REPLY | PN | MFR | Loss_QTY | 5sets_QTY | 5sets Total_QTY | 5sets_Unit price(CNY) | Total Price(CNY) | Lead time(days）
J1 | PCFSMT-K1-RLE10-B059C | Connector Card Bus Socket | IC9-68RD-0.635SF | IC9-68RD-0.635SF | 1 |  |  | out of stock. | replace with PCM-68P 卧贴 灿科盟 | IC9-68RD-0.635SF | HIROSE |  | 5 | 5 | 0 | 0
J2 | 92140-010LF | Connector | 92140010LF | 92140-010LF | 1 |  |  |  |  | 92140010LF | Amphenol |  | 5 | 5 | 73.33 | 366.65 | 15days
 |  |  |  |  |  |  |  |  |  |  |  |  |  |  | Total Price(CNY) | 366.65
