SiwaNetwork/CASS/CAM_LATTICE_STM/ECAD/CAM_DVB-CI_v2.1_release_rev.2.1_BOM 2025-09-03 00-40.xlsx

Designator | Comment | Description | Footprint | LibRef | Quantity | HelpURL | Value | EQ | REPLY | PN | MFR | Loss_QTY | 5sets_QTY | 5sets Total_QTY | 5sets_Unit price(CNY) | Total Price(CNY) | Lead time(days）
C1, C2, C3, C4, C5, C6, C8, C9, C10, C11, C15, C18, C39, C40, C41, C43, C44, C45, C46, C47, C48, C49, C50, C51, C52, C54, C55, C56, C57, C59, C60, C61, C62, C63, C65 | 0.1 µF | CAP CER 0.1UF 16V X7R 0402 | CAP 0402_1005 | CC0402KRX7R7BB104 | 35 |  | 0.1 µF |  |  | CC0402KRX7R7BB104 | YAGEO | 140 | 350 | 490 | 0.0063 | 3.087 | 7days
C7, C12 | 1 µF | CAP CER 1UF 10V X5R 0402 | CAP 0402_1005 | CC0402KRX5R6BB105 | 2 |  | 1 µF |  |  | CC0402KRX5R6BB105 | YAGEO | 80 | 20 | 100 | 0.0156 | 1.56 | 7days
C13, C42, C53, C58, C64 | 10 uF | CAP CER 10UF 10V X5R 0603 | CAP 0603_1608 | CC0603KRX5R6BB106 | 5 |  | 10 uF |  |  | CC0603KRX5R6BB106 | YAGEO | 50 | 50 | 100 | 0.1666 | 16.66 | 7days
C19, C20, C26, C32, C38 | 22 µF | CAP CER 22UF 16V X7R 1206 | CAP 1206_3216 - 0.8MM | CC1206MKX7R7BB226 | 5 |  | 22 µF | Please confirm the alternative model. | CONFIRM | EMK316BB7226ML-T | TAIYO | 50 | 50 | 100 | 0.9444 | 94.44 | 7days
C21, C27, C33 | 470 pF | CAP CER 470PF 16V X7R 0402 | CAP 0402_1005 | CC0402KRX7R7BB471 | 3 |  | 470 pF |  |  | CC0402KRX7R7BB471 | YAGEO | 70 | 30 | 100 | 0.0076 | 0.76 | 7days
C22, C23, C28, C29, C34, C35 | 22 µF | CAP CER 22UF 6.3V X5R 0603 | CAP 0603_1608 | CC0603MRX5R5BB226 | 6 |  | 22 µF |  |  | CC0603MRX5R5BB226 | YAGEO | 40 | 60 | 100 | 0.1879 | 18.79 | 7days
C24, C25, C30, C31, C36, C37 | 2.2 µF | CAP CER 2.2UF 6.3V X5R 0402 | CAP 0402_1005 | CC0402MRX5R5BB225 | 6 |  | 2.2 µF |  |  | CC0402MRX5R5BB225 | YAGEO | 40 | 60 | 100 | 0.0394 | 3.94 | 7days
C66 | 1 µF | CAP CER 1UF 16V X5R 0402 | CAP 0402_1005 | CC0402KRX5R7BB105 | 1 |  | 1 µF |  |  | CC0402KRX5R7BB105 | YAGEO | 90 | 10 | 100 | 0.0293 | 2.93 | 7days
D1 | 8240136 | TVS Diode (Uni-directional) | 8240136 | 8240136 | 1 |  |  |  |  | 8240136 | Wurth |  | 10 | 10 | 7.0889 | 70.889 | 7days
F1 | 0468.500NR | FUSE BOARD MOUNT 500MA 63VAC/VDC | FUSE 1206_3216 0.6MM | 0468.500NR | 1 |  |  |  |  | 0468.500NRHF | Littelfuse |  | 10 | 10 | 0.2889 | 2.889 | 7days
FB1, FB2, FB3, FB4, FB5, FB6 | 120 Ohms @ 100 MHz | FERRITE BEAD 120 OHM 0603 1LN | FER 0603_1608 | BLM18PG121SZ1D | 6 |  | 120 Ohms @ 100 MHz |  |  | BLM18PG121SZ1D | muRata | 40 | 60 | 100 | 0.1348 | 13.48 | 7days
IC1, IC2, IC3, IC5, IC7 | 74CBTLV3861PW,118 | Integrated Circuit | SOP65P640X110-24N | 74CBTLV3861PW,118 | 5 |  |  |  |  | 74CBTLV3861PW,118 | Nexperia | 1 | 50 | 51 | 2.6778 | 136.5678 | 7days
IC4 | SN74LVC2G08DCU | Integrated Circuit | SOP50P310X90-8N | SN74LVC2G08DCU | 1 |  |  |  |  | SN74LVC2G08DCUR | TI |  | 10 | 10 | 0.6111 | 6.111 | 7days
IC6 | 74HC1G14GW,125 | Integrated Circuit | SOT65P212X110-5N | 74HC1G14GW,125 | 1 |  |  |  |  | 74HC1G14GW,125 | Nexperia | 5 | 10 | 15 | 0.3923 | 5.8845 | 7days
IC9 | STM32F302C8T6 | Integrated Circuit | QFP50P900X900X160-48N | STM32F302C8T6 | 1 |  |  |  |  | STM32F302C8T6 | ST |  | 10 | 10 | 7.7778 | 77.778 | 7days
IC11 | LFE5U-25F-6BG256C | FPGA, 24K LUT, 137kbit RAM | BGA256C80P16X16_1400X1400X170 | LFE5U-25F-6BG256C | 1 |  |  |  |  | LFE5U-25F-6BG256C | LATTICE |  | 10 | 10 | 26.6667 | 266.667 | 7days
IC12 | W25Q64JVZPIQ | IC FLASH 64MBIT SPI/QUAD 8WSON | SON127P600X500X80-9N-D | W25Q64JVZPIQ | 1 |  |  |  |  | W25Q64JVZPIQ | Winbond |  | 10 | 10 | 3.1111 | 31.111 | 7days
J1 | PCFSMT-K1-RLE10-B059C | Connector Card Bus Socket | IC9-68RD-0.635SF | IC9-68RD-0.635SF | 1 |  |  | out of stock. | change with PCM-68P 卧贴 灿科盟 | PCM-68P 卧贴 | 灿科盟 |  | 10 | 10 | 0 | 0
J4 | PBS-4R | Connector | PBS-4R | PBS-4R | 1 |  | do not install | No need to buy? | Yes, no need to buy. My mistake. |  |  |  | 10 | 10 | 0 | 0
J5, J6 | U.FL-R-SMT-1 | Connector | U.FL-R-SMT-1 | U.FL-R-SMT-1 | 2 |  |  |  |  | U.FL-R-SMT-1(80) | HRS |  | 20 | 20 | 0.7177 | 14.354 | 7days
L1, L2, L3 | 2.2uH, 2A | Inductor | FNR3015S | FNR3015S2R2MT | 3 |  |  |  |  | FNR3015S2R2MT | cjiang |  | 30 | 30 | 0.2521 | 7.563 | 7days
LED1, LED2 | LTST-C190KGKT | LED, 0603, GREEN | LEDC1608X80N | LTST-C190KGKT | 2 |  |  |  |  | LTST-C190KGKT | LITEON | 30 | 20 | 50 | 0.1069 | 5.345 | 7days
R1, R2, R4, R5, R7, R8, R9 | CAT16-330J8LF | RES ARRAY 33 OHM 8 RES 2506 | RESNET 2506-16 CONCAVE | CAT16-330J8LF | 7 |  |  | Out of stock, and alternative models with the same parameters are also out of stock. | change with Panasonic EXB2HV330JV (Table 2) | CAT16-330J8LF | BOURNS |  | 70 | 70 | 0 | 0
R3, R6 | 220 Ohms | RES 220 OHM 1% 1/10W 0603 | YAGEO RES 0603_1608 | RC0603FR-07220RL | 2 |  | 220 Ohms |  |  | RC0603FR-07220RL | YAGEO | 80 | 20 | 100 | 0.0083 | 0.83 | 7days
R10, R12, R31, R32, R33, R34, R41 | 10 kOhms | RES 10K OHM 1% 1/16W 0402 | YAGEO RES 0402_1005 | RC0402FR-0710KL | 7 |  | 10 kOhms |  |  | RC0402FR-0710KL | YAGEO | 130 | 70 | 200 | 0.0038 | 0.76 | 7days
R11, R39 | 33 Ohms | RES 33 OHM 1% 1/16W 0402 | YAGEO RES 0402_1005 | RC0402FR-0733RL | 2 |  | 33 Ohms |  |  | RC0402FR-0733RL | YAGEO | 80 | 20 | 100 | 0.0046 | 0.46 | 7days
R13, R15, R17 | 15 kOhms | RES 15K OHM 1% 1/16W 0402 | YAGEO RES 0402_1005 | RC0402FR-0715KL | 3 |  | 15 kOhms |  |  | RC0402FR-0715KL | YAGEO | 70 | 30 | 100 | 0.0043 | 0.43 | 7days
R14 | 18 kOhms | RES 18K OHM 1% 1/16W 0402 | YAGEO RES 0402_1005 | RC0402FR-0718KL | 1 |  | 18 kOhms |  |  | RC0402FR-0718KL | YAGEO | 90 | 10 | 100 | 0.0043 | 0.43 | 7days
R16, R19, R20, R21, R22, R23, R24, R25, R29, R52, R53, R54 | 4.7 kOhms | RES 4.7K OHM 1% 1/16W 0402 | YAGEO RES 0402_1005 | RC0402FR-074K7L | 12 |  | 4.7 kOhms |  |  | RC0402FR-074K7L | YAGEO | 80 | 120 | 200 | 0.0046 | 0.92 | 7days
R18 | 3.3 kOhms | RES 3.3K OHM 1% 1/16W 0402 | YAGEO RES 0402_1005 | RC0402FR-073K3L | 1 |  | 3.3 kOhms |  |  | RC0402FR-073K3L | YAGEO | 90 | 10 | 100 | 0.0047 | 0.47 | 7days
R27 | 4.7 kOhms | RES 4.7K OHM 5% 1/16W 0402 | YAGEO RES 0402_1005 | RC0402JR-074K7L | 1 |  | 4.7 kOhms |  |  | RC0402JR-074K7L | YAGEO | 90 | 10 | 100 | 0.0041 | 0.41 | 7days
R30 | 1.1 kOhms | RES 1.1K OHM 1% 1/16W 0402 | YAGEO RES 0402_1005 | RC0402FR-071K1L | 1 |  | 1.1 kOhms |  |  | RC0402FR-071K1L | YAGEO | 90 | 10 | 100 | 0.0043 | 0.43 | 7days
R35, R37, R38, R40, R42, R43, R45 | 0 Ohms | RES 0 OHM JUMPER 1/16W 0402 | YAGEO RES 0402_1005 | RC0402JR-070RL | 7 |  | 0 Ohms |  |  | RC0402JR-070RL | YAGEO | 130 | 70 | 200 | 0.004 | 0.8 | 7days
R44 | 33 Ohms | RES 33 OHM 5% 1/16W 0402 | YAGEO RES 0402_1005 | RC0402JR-0733RL | 1 |  | 33 Ohms |  |  | RC0402JR-0733RL | YAGEO | 90 | 10 | 100 | 0.004 | 0.4 | 7days
R49, R50, R51 | 0 Ohms | RES 0 OHM JUMPER 1/16W 0402 | YAGEO RES 0402_1005 | RC0402FR-070RL | 3 |  | 0 Ohms |  |  | RC0402FR-070RL | YAGEO | 70 | 30 | 100 | 0.0039 | 0.39 | 7days
U1, U2, U3 | TLV62569DBVR | IC REG BUCK ADJ 2A SOT23-5 | SOT95P280X145-5N | TLV62569DBVR | 3 |  |  |  |  | TLV62569DBVR | TI | 5 | 30 | 35 | 0.4297 | 15.0395 | 7days
Y2 | 27 MHz | XTAL OSC XO 27.0000MHZ CMOS SMD | ABRACON ASE | ASE-27.000MHZ-ET | 1 |  | 27 MHz |  |  | ASE-27.000MHZ-ET | ABRACON |  | 10 | 10 | 10.5556 | 105.556 | 15days
 |  |  |  |  |  |  |  |  |  |  |  |  |  |  | Total Price(CNY) | 908.1318
