SiwaNetwork/CASS/CAM-ALTERA_STM/Производство/Копия CAM_DVB-CI_rev.1.1_release BOM-offer(1).xlsx

Designator | Comment | Description | Footprint | LibRef | Quantity | HelpURL | EQ | REPLY | P/N | Specifications | MFR | Package | Loss_QTY | 5sets_QTY | 5sets Total_QTY | 5sets_Unit price(CNY) | Total Price(CNY) | Lead time(days） | Loss_QTY | 1000sets_QTY | 1000sets Total_QTY | 1000sets_Unit price(CNY) | Total Price(CNY) | Lead time(days） | Loss_QTY | 10000sets_QTY | 10000sets Total_QTY | 10000sets_Unit price(CNY) | Total Price(CNY) | Lead time(days）
C1, C2, C3, C4, C5, C6, C8, C9, C10, C11, C22, C23, C27, C28, C32, C33, C35, C36, C37, C38, C39, C40, C41, C42, C43, C44, C45, C46, C47, C48, C49, C50, C51, C52, C53, C54, C55, C56, C57, C58, C61, C62, C63, C64, C65 | 0.1 µF | CAP CER 0.1UF 16V X7R 0402 | CAP 0402_1005 | CC0402KRX7R7BB104 | 45 |  |  |  | CC0402KRX7R7BB104 |  | Yageo | - | 75 | 225 | 300 | ￥0.0045 | ￥1.3548 | 7 days | 300 | 45000 | 45300 | ￥0.0031 | ￥141.2581 | 7 days | 500 | 450000 | 450500 | ￥0.0028 | ￥1259.4624 | 7 days
C7, C12 | 1 µF | CAP CER 1UF 10V X5R 0402 | CAP 0402_1005 | CC0402KRX5R6BB105 | 2 |  |  |  | CC0402KRX5R6BB105 |  | Yageo | - | 90 | 10 | 100 | ￥0.0112 | ￥1.1183 | 7 days | 100 | 2000 | 2100 | ￥0.0088 | ￥18.5161 | 7 days | 300 | 20000 | 20300 | ￥0.0081 | ￥163.7097 | 7 days
C13, C59, C60 | CC0603KRX5R6BB106 | CAP CER 10UF 10V X5R 0603 | CAP 0603_1608 | CC0603KRX5R6BB106 | 3 |  |  |  | CC0603KRX5R6BB106 | 0603 10uF ±10% 10V X5R | Yageo | 0603 | 85 | 15 | 100 | ￥0.1032 | ￥10.3226 | 7 days | 100 | 3000 | 3100 | ￥0.0946 | ￥293.3333 | 7 days | 300 | 30000 | 30300 | ￥0.0849 | ￥2573.8710 | 7 days
C14, C15 | 2.2 µF | CAP CER 2.2UF 10V X5R 0402 | CAP 0402_1005 | CC0402KRX5R6BB225 | 2 |  |  |  | CC0402KRX5R6BB225 | 0402 2.2uF ±10% 10V X5R | Yageo | 0402 | 90 | 10 | 100 | ￥0.0452 | ￥4.5161 | 7 days | 100 | 2000 | 2100 | ￥0.0355 | ￥74.5161 | 7 days | 300 | 20000 | 20300 | ￥0.0323 | ￥654.8387 | 7 days
C16, C17, C18, C19 | 12 pF | CAP CER 12PF 50V C0G/NPO 0402 | CAP 0402_1005 | CC0402FRNPO9BN120 | 4 |  |  |  | CC0402FRNPO9BN120 | Cap Ceramic 12pF 50V C0G 1% SMD 0402 125℃ T/R | Yageo | 0402 | 80 | 20 | 100 | ￥0.0151 | ￥1.5054 | 7 days | 100 | 4000 | 4100 | ￥0.0108 | ￥44.0860 | 7 days | 300 | 40000 | 40300 | ￥0.0103 | ￥416.0000 | 7 days
C20, C21 | 10 µF | CAP TANT 10UF 10% 16V 1206 | CAP POL 1206_3216 | T494A106K016AT | 2 |  |  |  | T494A106K016AT | A 10uF ±10% 16V | KEMET Corporation | 1206-2 | 5 | 10 | 15 | ￥5.0538 | ￥75.8065 | 7 days | 10 | 2000 | 2010 | ￥2.4731 | ￥4970.9677 | 7 days | 50 | 20000 | 20050 | ￥1.2903 | ￥25870.9677 | 7 days
C24, C25, C26, C30, C31 | 22 µF | CAP CER 22UF 6.3V X5R 0603 | CAP 0603_1608 | CC0603MRX5R5BB226 | 5 |  |  |  | CC0603MRX5R5BB226 | 0603 22uF ±20% 6.3V X5R | Yageo | 0603 | 75 | 25 | 100 | ￥0.0860 | ￥8.6022 | 7 days | 100 | 5000 | 5100 | ￥0.0742 | ￥378.3871 | 7 days | 300 | 50000 | 50300 | ￥0.0645 | ￥3245.1613 | 7 days
C29, C34 | 4.7 µF | CAP CER 4.7UF 10V X5R 0603 | CAP 0603_1608 | CC0603KRX5R6BB475 | 2 |  |  |  | CC0603KRX5R6BB475 | 0603 4.7uF ±10% 10V X5R | Yageo | 0603, 1608-2 | 90 | 10 | 100 | ￥0.0505 | ￥5.0538 | 7 days | 100 | 2000 | 2100 | ￥0.0473 | ￥99.3548 | 7 days | 300 | 20000 | 20300 | ￥0.0425 | ￥862.2043 | 7 days
FB1, FB2 | 600 Ohms @ 100 MHz | FERRITE BEAD 600 OHM 0603 1LN | FER 0603_1608 | BLM18KG601SN1D | 2 |  |  |  | BLM18KG601SN1D |  |  | - | 90 | 10 | 100 | ￥0.0613 | ￥6.1290 | 7 days | 100 | 2000 | 2100 | ￥0.0473 | ￥99.3548 | 7 days | 300 | 20000 | 20300 | ￥0.0373 | ￥757.4301 | 7 days
FB3, FB4, FB5, FB6 | 220 Ohms @ 100 MHz | FERRITE BEAD 220 OHM 0603 1LN | FER 0603_1608 | BLM18EG221SN1D | 4 |  |  |  | BLM18EG221SN1D | 220Ω Impedance Ferrite Bead 0603 (1608 Metric) Surface Mount 2A 1 Lines 50mOhm Max DCR -55℃ ~ 125℃ | muRata | 0603-2 | 80 | 20 | 100 | ￥0.1387 | ￥13.8710 | 7 days | 100 | 4000 | 4100 | ￥0.0946 | ￥387.9570 | 7 days | 300 | 40000 | 40300 | ￥0.0882 | ￥3553.3333 | 7 days
IC1 | STM32F405RGT6 | Integrated Circuit | QFP50P1200X1200X160-64N | STM32F405RGT6 | 1 |  |  |  | STM32F405RGT6 | MCU 32Bit ARM Cortex M4F RISC 1Mb Flash 2.5V/3.3V 64Pin LQFP Tray | ST Microelectronics | LQFP-64 | 0 | 5 | 5 | ￥16.9892 | ￥84.9462 | 7 days | 2 | 1000 | 1002 | ￥14.6237 | ￥14652.9032 | 7 days | 5 | 10000 | 10005 | ￥13.9785 | ￥139854.8387 | 7 days
IC2 | TPS2041BD | Integrated Circuit | SOIC127P600X175-8N | TPS2041BD | 1 |  |  |  | TPS2041BD |  |  | - | 0 | 5 | 5 | ￥2.3656 | ￥11.8280 | 7 days | 10 | 1000 | 1010 | ￥1.1828 | ￥1194.6237 | 7 days | 20 | 10000 | 10020 | ￥1.0753 | ￥10774.1935 | 7 days
IC3 | NCP1117ST25T3G | IC REG LINEAR 2.5V 1A SOT223 | ON SEMI SOT-223 ST(318H) | NCP1117ST25T3G | 1 |  |  |  | NCP1117ST25T3G | ON SEMICONDUCTOR NCP1117ST25T3G Fixed LDO Voltage Regulator, 15V to 20V In, 1.07V Dropout, 2.5V/1A Out, SOT-223-3 | ON Semiconductor | SOT-223 | 0 | 5 | 5 | ￥3.9785 | ￥19.8925 | 15 days | 10 | 1000 | 1010 | ￥1.9892 | ￥2009.1398 | 15 days | 10 | 10000 | 10010 | ￥1.9355 | ￥19374.1935 | 15 days
IC4, IC5 | ST1S10PUR | Integrated Circuit | SON80P400X400X100-9N-D | ST1S10PUR | 2 |  |  |  | ST1S10PUR | Conv DC-DC 2.5V to 18V Synchronous Step Down Single-Out 0.8V to 15.3V 3A 8Pin DFN EP T/R | ST Microelectronics | DFN-8 | 0 | 10 | 10 | ￥4.3011 | ￥43.0108 | 7 days | 10 | 2000 | 2010 | ￥3.7634 | ￥7564.5161 | 7 days | 20 | 20000 | 20020 | ￥3.5484 | ￥71038.7097 | 7 days
IC6 | EPCS16SI8N | Integrated Circuit | SOIC127P600X175-8N | EPCS16SI8N | 1 |  | DC:18+ |  | EPCS16SI8N | FPGA Configuration Memory, Flash, 16Mbit, 40MHz, JTAG, Serial, SOIC, 8Pins | Altera | SOIC-8 | 0 | 5 | 5 | ￥28.4946 | ￥142.4731 | 7 days | 2 | 1000 | 1002 | ￥21.2903 | ￥21332.9032 | 7 days | 5 | 10000 | 10005 | ￥19.3548 | ￥193645.1613 | 7 days
IC7 | W25Q64CVSSIG | Integrated Circuit | SOIC127P790X216-8N | W25Q64CVSSIG | 1 |  | discontinued | Позицию IC7 W25Q64CVSSIG, можно заменить на W25Q64JVSSIQ. | W25Q64JVSSIQ |  | WINBIND | - | 0 | 5 | 5 | ￥2.8000 | ￥14.0000 | 7 days | 10 | 1000 | 1010 | ￥1.6667 | ￥1683.3670 | 7 days | 20 | 10000 | 10020 | ￥1.4516 | ￥14545.1613 | 7 days
J1 | IC9-68RD-0.635SF | Connector Card Bus Socket | IC9-68RD-0.635SF | IC9-68RD-0.635SF | 1 |  | discontinued | 1. Позиция J1 - IC9-68RD-0.635SF – альтернативный вариант PCFSMT-K1-RLE10-B059C-GW другой завод устанавливает такие разъёмы. Как альтернатива еще есть разъемы: IC1FA-68PD-1.27DS(72), IC1F-68RD-1.27SF(52), IC1K-68RD-1.27SF(71), 10014744-002SLF, 5146228-4, IC1HA-68RD-1.27SH(51), IC1BB-68RD-1.27SH, 5146233-1. | IC1F-68RD-1.27SF |  | HIROSE | - | 0 | 5 | 5 | ￥98.4000 | ￥492.0000 | 15 days |  | 1000 | 1000 | ￥43.5484 | ￥43548.3871 | 15 days |  | 10000 | 10000 | ￥43.0108 | ￥430107.5269 | 22-24weeks
J2 | PBS2-6 | Connector, Header, Pitch 2mm, H=4.3mm | PBS2-6 | PBS2-6 | 1 |  |  | Позиции J2-J3 не закупаем и не монтируем. | DS1026-01-1x6S8BV |  | CONNFLY | - | 0 | 5 | 5 |  |  |  | 5 | 1000 | 1005 |  |  |  | 10 | 10000 | 10010
J3 | PBD2-10 | Connector | PBD2-10 | PBD2-10 | 1 |  | Please confirm the alternative model number. | Позиции J2-J3 не закупаем и не монтируем. | 2005FV-2x5P |  | HanElectricity(瀚源) | - | 0 | 5 | 5 |  |  |  | 5 | 1000 | 1005 |  |  |  | 10 | 10000 | 10010
L1, L2 | 10 µH | FIXED IND 10UH 1.3A 180 MOHM SMD | BOURNS SRN4018 | SRN4018-100M | 2 |  |  |  | SRN4018-100M | 1515 10uH ±20% 1.3A | Bourns J.W. Miller | 4mm x 4mm x 1.8mm-2 | 0 | 10 | 10 | ￥2.6882 | ￥26.8817 | 15 days | 10 | 2000 | 2010 | ￥1.7204 | ￥3458.0645 | 15 days | 20 | 20000 | 20020 | ￥1.1828 | ￥23679.5699 | 18 weeks
LED1 |  | LED, 0603, GREEN | LEDC1608X80N | LTST-C190KGKT | 1 |  |  |  | LTST-C190KGKT | LED; SMD; 0603; green; 18-71mcd; 1.6x0.8x0.8mm; 130°; 1.9÷2.4V; 20mA | Liteon | 0603 | 95 | 5 | 100 | ￥0.0991 | ￥9.9052 | 7 days | 100 | 1000 | 1100 | ￥0.0768 | ￥84.5037 | 7 days | 200 | 10000 | 10200 | ￥0.0595 | ￥607.2181 | 7 days
LED2 | LTST-C190KGKT | LED, 0603, GREEN | LEDC1608X80N | LTST-C190KGKT | 1 |  |  |  | LTST-C190KGKT | LED; SMD; 0603; green; 18-71mcd; 1.6x0.8x0.8mm; 130°; 1.9÷2.4V; 20mA | Liteon | 0603 | 95 | 5 | 100 | ￥0.0991 | ￥9.9052 | 7 days | 100 | 1000 | 1100 | ￥0.0768 | ￥84.5037 | 7 days | 200 | 10000 | 10200 | ￥0.0595 | ￥607.2181 | 7 days
R1, R3, R6, R7, R8, R10, R12, R13, R14, R21, R23, R25, R26, R28 | 10 kOhms | RES 10K OHM 1% 1/16W 0402 | RES 0402_1005 | RC0402FR-0710KL | 14 |  |  |  | RC0402FR-0710KL | 0402 10kΩ ±1% | Yageo | 0402-2 | 130 | 70 | 200 | ￥0.0025 | ￥0.4946 | 7 days | 200 | 14000 | 14200 | ￥0.0018 | ￥25.9570 | 7 days | 300 | 140000 | 140300 | ￥0.0017 | ￥241.3763 | 7 days
R2, R19 | 33 Ohms | RES 33 OHM 1% 1/16W 0402 | RES 0402_1005 | RC0402FR-0733RL | 2 |  |  |  | RC0402FR-0733RL | 0402 33Ω ±1% | Yageo | 0402-2 | 90 | 10 | 100 | ￥0.0028 | ￥0.2796 | 7 days | 100 | 2000 | 2100 | ￥0.0023 | ￥4.7419 | 7 days | 300 | 20000 | 20300 | ￥0.0019 | ￥39.2903 | 7 days
R4, R5 | 220 Ohms | RES 220 OHM 1% 1/10W 0603 | RES 0603_1608 | RC0603FR-07220RL | 2 |  |  |  | RC0603FR-07220RL | 0603 220Ω ±1% | Yageo | 0603-2 | 90 | 10 | 100 | ￥0.0055 | ￥0.5484 | 7 days | 100 | 2000 | 2100 | ￥0.0043 | ￥9.0323 | 7 days | 300 | 20000 | 20300 | ￥0.0039 | ￥78.5806 | 7 days
R9 | 31.6 kOhms | RES 31.6K OHM 1% 1/10W 0603 | RES 0603_1608 | RC0603FR-0731K6L | 1 |  |  |  | RC0603FR-0731K6L | 0603 31.6kΩ ±1% | Yageo | 0603 | 95 | 5 | 100 | ￥0.0055 | ￥0.5484 | 7 days | 100 | 1000 | 1100 | ￥0.0043 | ￥4.7312 | 7 days | 300 | 10000 | 10300 | ￥0.0039 | ￥39.8710 | 7 days
R11 | 5.11 kOhms | RES 5.11K OHM 1% 1/10W 0603 | RES 0603_1608 | RC0603FR-075K11L | 1 |  |  |  | RC0603FR-075K11L | 0603 5.11kΩ ±1% | Yageo | 0603 (1608 Metric) | 95 | 5 | 100 | ￥0.0059 | ￥0.5914 | 7 days | 100 | 1000 | 1100 | ￥0.0046 | ￥5.0860 | 7 days | 300 | 10000 | 10300 | ￥0.0042 | ￥43.1935 | 7 days
R17, R18, R29 | 0 Ohms | RES 0 OHM JUMPER 1/16W 0402 | RES 0402_1005 | RC0402JR-070RL | 3 |  |  |  | RC0402JR-070RL | 0402 0Ω ±5% | Yageo | 0402-2 | 85 | 15 | 100 | ￥0.0029 | ￥0.2903 | 7 days | 100 | 3000 | 3100 | ￥0.0019 | ￥6.0000 | 7 days | 300 | 30000 | 30300 | ￥0.0019 | ￥58.6452 | 7 days
R22 | 33 Ohms | RES 33 OHM 1% 1/10W 0603 | RES 0603_1608 | RC0603FR-0733RL | 1 |  |  |  | RC0603FR-0733RL | 0603 33Ω ±1% | Yageo | 0603 [1608 Metric]-2 | 95 | 5 | 100 | ￥0.0055 | ￥0.5484 | 7 days | 100 | 1000 | 1100 | ￥0.0043 | ￥4.7312 | 7 days | 300 | 10000 | 10300 | ￥0.0039 | ￥39.8710 | 7 days
R24 | 1 kOhms | RES 1K OHM 1% 1/16W 0402 | RES 0402_1005 | RC0402FR-071KL | 1 |  |  |  | RC0402FR-071KL | 0402 1kΩ ±1% | Yageo | 0402-2 | 95 | 5 | 100 | ￥0.0026 | ￥0.2581 | 7 days | 100 | 1000 | 1100 | ￥0.0019 | ￥2.1290 | 7 days | 300 | 10000 | 10300 | ￥0.0018 | ￥18.8280 | 7 days
RN1, RN2, RN3, RN4, RN5, RN6, RN7, RN8, RN9, RN10, RN11, RN12 | CAY16-330J4LF | RES ARRAY 4 RES 33 OHM 1206 | RESNET 1206-8 CONVEX | CAY16-330J4LF | 12 |  |  |  | CAY16-330J4LF | Res Thick Film Array 33Ω 5% 0.25W(1/4W) ±200ppm/℃ ISOL Molded 8Pin 1206(4 X 0603) Convex SMD T/R | Bourns J.W. Miller | 1206-8 | 40 | 60 | 100 | ￥0.1665 | ￥16.6462 | 15 days | 100 | 12000 | 12100 | ￥0.0960 | ￥1161.4699 | 15 days | 100 | 120000 | 120100 | ￥0.0608 | ￥7296.3978 | 15 days
U1 | EP4CE22E22C6N | IC FPGA 79 I/O 144EQFP | QFP50P2200X2200X165-145N | EP4CE22E22C6N_1 | 1 |  | Few available, alternatives recommended | Позиция U1 EP4CE22E22C6N в каком количестве есть? Плюс возможно ставить варианты с любым индексом в конце EP4CE22E22C6N (I7N, C8N) так же можно установить вариант с меньшим количеством ячеек EP4CE15E22I7N нас устроит любой индекс в конце микросхемы! | EP4CE15E22I7N |  | Intel | - | 0 | 5 | 5 | ￥283.8710 | ￥1419.3548 | 7 days |  | 1000 | 1000 | ￥249.4624 | ￥249462.3656 | 15 days |  | 10000 | 10000 | ￥220.4301 | ￥2204301.0753 | 15 days
U2, U3, U4, U5 | SN74CBTD3384CDBR | Integrated Circuit | SOP65P780X200-24N | SN74CBTD3384CDBR | 4 |  |  |  | SN74CBTD3384CDBR | 10Bit FET Bus Switches With Level Shifting with -2V Undershoot 24-SSOP -40℃ to 85℃ | TI | SSOP-24 | 1 | 20 | 21 | ￥5.0538 | ￥106.1290 | 15 days | 10 | 4000 | 4010 | ￥2.0430 | ￥8192.4731 | 15 days | 15 | 40000 | 40015 | ￥2.0215 | ￥80890.5376 | 15 days
Y1 | FC-135 | Crystal or Oscillator | FC135 | FC-135_32.7680KA-A3 | 1 |  |  |  | FC-135_32.7680KA-A3 | Crystal 0.032768MHz ±20ppm (Tol) 12.5pF FUND 70000Ω 2Pin SMD T/R | Epson Electronics | 3.2 mm x 1.5 mm | 0 | 5 | 5 | ￥10.3226 | ￥51.6129 | 15 days | 10 | 1000 | 1010 | ￥0.7957 | ￥803.6559 | 15 days | 20 | 10000 | 10020 | ￥0.7957 | ￥7972.9032 | 15 days
Y2 | DSX321G-25M-12P | Crystal or Oscillator | DSX321G20M | DSX321G-25M | 1 |  |  |  | DSX321G-25M | 20MHz 12pF 20ppm | KDS | SMD-3225_4P | 0 | 5 | 5 | ￥4.3011 | ￥21.5054 | 15 days | 10 | 1000 | 1010 | ￥1.0753 | ￥1086.0215 | 15 days | 10 | 10000 | 10010 | ￥0.9140 | ￥9148.9247 | 15 days
Y3 | 27 MHz | XTAL OSC XO 27.0000MHZ CMOS SMD | ABRACON ASE | ASE-27.000MHZ-ET | 1 |  |  |  | ASE-27.000MHZ-ET | ABRACON ASE-27MHz-ET Oscillator, 27MHz, 100ppm, SMD, 3.2mm x 2.5mm, CMOS, 3.3V, ASE Series | Abracon | 4-SMD, No Lead (DFN, LCC) | 0 | 5 | 5 | ￥10.7527 | ￥53.7634 | 15 days | 10 | 1000 | 1010 | ￥4.8387 | ￥4887.0968 | 15 days | 10 | 10000 | 10010 | ￥4.6237 | ￥46282.7957 | 15 days
 |  |  |  |  |  |  |  |  |  |  |  |  |  |  |  | Total Price(CNY) | ￥2655.6931 |  |  |  |  | Total Price(CNY) | ￥367776.1345 |  |  |  |  | Total Price(CNY) | ￥3300043.0598
