SiwaNetwork/CASS/PCMCIA_CARDBUS_XILINX_BGA/com_1300_information/BOM.xlsx

Collated Components:
Item,"Qty","Reference(s)","Value","LibPart","Footprint","Datasheet","Datasheet","Footprint","Reference","Value"
1,"6","C1, C2, C4, C15, C16, C17","10uF","Device:C_Polarized_Small_US","Capacitor_Tantalum_SMD:CP_EIA-3216-18_Kemet-A","~","~","","C","C_Polarized_Small_US"
2,"4","C3, C5, C21, C83","12p","Device:C_Small","Capacitor_SMD:C_0402_1005Metric","~","~","Capacitor_SMD:C_0603_1608Metric","C24","C-OPEN"
3,"58","C6, C7, C11, C18, C20, C23, C28, C29, C30, C31, C32, C33, C35, C36, C37, C38, C39, C40, C41, C42, C43, C44, C45, C46, C47, C48, C49, C50, C51, C52, C53, C54, C55, C56, C57, C58, C59, C60, C61, C62, C63, C64, C65, C66, C67, C68, C69, C70, C71, C72, C73, C74, C75, C77, C78, C79, C80, C81","100nF","Device:C_Small","Capacitor_SMD:C_0201_0603Metric","~","~","Capacitor_SMD:C_0603_1608Metric","C24","C-OPEN"
4,"8","C8, C9, C12, C13, C24, C26, C27, C34","C-OPEN","Device:C_Small","Capacitor_SMD:C_0402_1005Metric","~","~","Capacitor_SMD:C_0603_1608Metric","C24","C-OPEN"
5,"3","C10, C14, C22","4.7uF","Device:C_Small","Capacitor_SMD:C_0402_1005Metric","~","~","","C","C_Small"
6,"1","C19","22pF","Device:C_Small","Capacitor_SMD:C_0201_0603Metric","~","~","","C","C_Small"
7,"1","C25","1nF","Device:C_Small","Capacitor_SMD:C_0201_0603Metric","~","~","","C","C_Small"
8,"2","C76, C82","2u2","Device:C_Small","Capacitor_SMD:C_0402_1005Metric","~","~","Capacitor_SMD:C_0603_1608Metric","C24","C-OPEN"
9,"1","J1","Conn_02x20_Counter_Clockwise","Connector_Generic:Conn_02x20_Odd_Even","Connector_PinSocket_2.00mm:PinSocket_2x20_P2.00mm_Horizontal","~","~","","J","Conn_02x20_Odd_Even"
10,"1","J2","9-68RD-0.635SF","PC_Card_Connector:9-68RD-0.635SF","PC_Card:IC9_Series","","","Connector_PCBEdge:IC9_Series","J?","9-68RD-0.635SF"
11,"1","J3","MEC1-108-01-S-D-RA1-SL","Connector:MEC1-108-01-S-D-RA1-SL","Connector_PinSocket_1.27mm:PinSocket_2x08_P1.27mm_Vertical_SMD","","","Connector_Card:SAMTEC_MEC1-108-02-X-D-NP-A","J3","MEC1-108-01-S-D-RA1-SL"
12,"1","J4","Conn_02x10_Top_Bottom","Connector_Generic:Conn_02x08_Top_Bottom","Connector_PinHeader_1.27mm:PinHeader_2x08_P1.27mm_Vertical_SMD","~","~","","J","Conn_02x08_Top_Bottom"
13,"1","L1","1.5uH","Device:L_Small","Inductor_SMD:L_0805_2012Metric","~","~","","L","L_Small"
14,"2","R1, R4","47","Device:R_Small","Resistor_SMD:R_0402_1005Metric","~","~","","R","R_Small"
15,"1","R2","220K","Device:R_Small","Resistor_SMD:R_0402_1005Metric","~","~","","R","R_Small"
16,"1","R3","10K",":R_Small_1","Resistor_SMD:R_0603_1608Metric","~","~","","R","R_Small_1"
17,"3","R5, R7, R13","100K","Device:R_Small","Resistor_SMD:R_0402_1005Metric","~","~","","R","R_Small"
18,"1","R8","49.9K","Device:R_Small","Resistor_SMD:R_0402_1005Metric","~","~","","R","R_Small"
19,"1","R9","0",":R_Small_1","Resistor_SMD:R_0402_1005Metric","~","~","","R","R_Small_1"
20,"2","R10, R15","0","Device:R_Small","Resistor_SMD:R_0201_0603Metric","~","~","","R","R_Small"
21,"1","R11","4.7K","Device:R_Small","Resistor_SMD:R_0402_1005Metric","~","~","","R","R_Small"
22,"1","R12","13K","Device:R_Small","Resistor_SMD:R_0402_1005Metric","~","~","","R","R_Small"
23,"1","R14","330","Device:R_Small","Resistor_SMD:R_0402_1005Metric","~","~","","R","R_Small"
24,"3","R16, R17, R23","R-OPEN","Device:R_Small","Resistor_SMD:R_0402_1005Metric","~","~","","R","R_Small"
25,"2","R21, R22","56","Device:R_Small","Resistor_SMD:R_0402_1005Metric","~","~","Resistor_SMD:R_0603_1608Metric","R22","56"
26,"7","RN1, RN2, RN3, RN4, RN5, RN6, RN7","8 x 180R","Device:R_Pack08","Resistor_SMD:R_Cat16-8","~","~","","RN","R_Pack08"
27,"1","RN8","8 x 10K","Device:R_Pack08","Resistor_SMD:R_Cat16-8","~","~","","RN","R_Pack08"
28,"2","TP1, TP2","TestPoint_Small","Connector:TestPoint_Small","TestPoint:TestPoint_Pad_D1.0mm","~","~","","TP","TestPoint_Small"
29,"1","U1","LT1963AxST-3.3","Regulator_Linear:LT1963AxST-3.3","Package_TO_SOT_SMD:SOT-223-3_TabPin2","https://www.analog.com/media/en/technical-documentation/data-sheets/1963aff.pdf","https://www.analog.com/media/en/technical-documentation/data-sheets/1963aff.pdf","Package_TO_SOT_SMD:SOT-223-3_TabPin2","U","LT1963AxST-3.3"
30,"1","U2","STM32F415RGTx","MCU_ST_STM32F4:STM32F415RGTx","Package_QFP:LQFP-64_10x10mm_P0.5mm","http://www.st.com/st-web-ui/static/active/en/resource/technical/document/datasheet/DM00035129.pdf","http://www.st.com/st-web-ui/static/active/en/resource/technical/document/datasheet/DM00035129.pdf","Package_QFP:LQFP-64_10x10mm_P0.5mm","U","STM32F415RGTx"
31,"1","U3","AM29LV320DT90EC","Storage:AM29LV320DT90EC","Package_SO:TSOP-I-48_18.4x12mm_P0.5mm","https://pdf.datasheetcatalog.com/datasheets/2300/175457_DS.pdf","https://pdf.datasheetcatalog.com/datasheets/2300/175457_DS.pdf","Package_SO:TSOP-I-48_18.4x12mm_P0.5mm","U","AM29LV320DT90EC"
32,"1","U4","TC74LCX373FT","Storage:TC74LCX373FT","Package_SO:SSOP-20_4.4x6.5mm_P0.65mm","https://mm.digikey.com/Volume0/opasdata/d220001/medias/docus/894/TC74LCX373F-FT-FW.pdf","https://mm.digikey.com/Volume0/opasdata/d220001/medias/docus/894/TC74LCX373F-FT-FW.pdf","Package_SO:SSOP-20_4.4x6.5mm_P0.65mm","U?","TC74LCX373FT"
33,"1","U5","XC3S400-4FT256C","FPGA_Xilinx:XC3S400-4FT256C","Package_BGA:Xilinx_FTG256","https://eu.mouser.com/datasheet/2/903/ds099-1595375.pdf","https://eu.mouser.com/datasheet/2/903/ds099-1595375.pdf","Package_BGA:Xilinx_FTG256","U","XC3S400-4FT256C"
34,"1","U6","LP3982IMM-ADJ","Regulator_Linear:LP3982IMM-ADJ","Package_SO:VSSOP-8_3.0x3.0mm_P0.65mm","http://www.ti.com/lit/ds/symlink/lp3982.pdf","http://www.ti.com/lit/ds/symlink/lp3982.pdf","Package_SO:VSSOP-8_3.0x3.0mm_P0.65mm","U6","LP3982IMM-ADJ"
35,"1","U7","LTC3411EMS","Regulator_Switching:LTC3411EMS","Package_DFN_QFN:DFN-10-1EP_3x3mm_P0.5mm_EP1.7x2.5mm","","","Package_DFN_QFN:DFN-10-1EP_3x3mm_P0.5mm_EP1.7x2.5mm","U7","LTC3411EMS"
36,"1","U17","MT48LC16M16A2TG-7E","Storage:MT48LC16M16A2TG-7E","Package_SO:TSOP-II-54_22.2x10.16mm_P0.8mm","file:///Users/digitalfantazy/Downloads/mt48lc64m4a2p-7e_af80921c9c.pdf","file:///Users/digitalfantazy/Downloads/mt48lc64m4a2p-7e_af80921c9c.pdf","Package_SO:TSOP-II-54_22.2x10.16mm_P0.8mm","U","MT48LC16M16A2TG-7E"
37,"1","Y1","16mHz","Device:Crystal_GND24_Small","Crystal:Crystal_SMD_3225-4Pin_3.2x2.5mm","~","~","","Y","Crystal_GND24_Small"
38,"1","Y2","40mHZ","Device:Crystal_GND24_Small","Crystal:Crystal_SMD_2520-4Pin_2.5x2.0mm","~","~","","Y","Crystal_GND24_Small"
