SiwaNetwork/CASS/CAM_EXTENSION/cam_ext_v1/Output/CAM_EXT_v1_release_rev.1_BOM 2025-09-01 14-21.xlsx

Designator | Comment | Description | Footprint | LibRef | Quantity | HelpURL | Value
J1 | PCFSMT-K1-RLE10-B059C | Connector Card Bus Socket | IC9-68RD-0.635SF | IC9-68RD-0.635SF | 1
J2 | 92140-010LF | Connector | 92140010LF | 92140-010LF | 1
