SiwaNetwork/CASS/CAM_LATTICE_STM/LATTICE REFERENCE/logicbone-master/logicbone-bom.ods

Item | Reference(s) | Value | LibPart | Footprint | MPN Base | MPN Deluxe | Manufacturer | Qty | Order | Price | Total | Price Upg. | Total Upgr. | Link | Datasheet
1 | C101, C102, C103, C105, C106, C107, C110, C111, C112, C113, C114, C115, C116, C118, C120, C121, C122, C123, C124, C200, C201, C210, C211, C220, C221, C230, C231, C251, C257, C260, C261, C264, C265, C266, C280, C300, C301, C302, C309, C310, C311, C316, C317, C318, C319, C401, C402, C403, C411, C412, C413, C421, C422, C423, C431, C432, C433, C451, C452, C454, C455, C456, C461, C462, C463, C464, C465, C467, C469, C500, C501, C502, C503, C512, C522, C532, C542 | 100nF | Device:C_Small | Capacitor_SMD:C_0402_1005Metric | 0402YC104MAT2A |  | AVX Corporation | 77 | 1200 | $0.005 | $0.40 |  | $0.40 | https://www.digikey.com/product-detail/en/avx-corporation/0402YC104MAT2A/478-0402YC104MAT2ACT-ND/11570233 | ~
2 | C104, C117, C150, C151, C152, C153, C154, C155, C156, C157, C158, C159, C160, C161, C162, C163, C164, C165, C166, C167, C168, C169, C170, C250, C255, C303, C304, C308, C315, C400, C410, C420, C430, C440, C441, C442, C443, C445, C460, C533, C543 | 10uF | Device:C_Small | Capacitor_SMD:C_0603_1608Metric | JMK107ABJ106MA-T |  | Taiyo Yuden | 41 | 500 | $0.032 | $1.30 |  | $1.30 | https://www.digikey.com/product-detail/en/taiyo-yuden/JMK107ABJ106MA-T/587-5869-1-ND/7674989 | ~
3 | C108, C109 | 12pF | Device:C_Small | Capacitor_SMD:C_0402_1005Metric | CL05C120JB5NNNC |  | Samsung | 2 | 100 | $0.026 | $0.05 |  | $0.05 | https://www.digikey.com/product-detail/en/samsung-electro-mechanics/CL05C120JB5NNNC/1276-1178-1-ND/3889264 | ~
4 | C119, C125, C126, C127 | 4.7uF/35V | Device:C_Small | Capacitor_SMD:C_0805_2012Metric | CL21A475KLCLQNC |  | Samsung | 4 | 100 | $0.079 | $0.31 |  | $0.31 | https://www.digikey.com/product-detail/en/samsung-electro-mechanics/CL21A475KLCLQNC/1276-6722-1-ND/5961581 | ~
5 | C198, C199 | 47uF | Device:CP | Capacitor_Tantalum_SMD:CP_EIA-3216-10_Kemet-I | DNP | DNP | DNP | 2 |  |  | $0.00 |  | $0.00 |  | ~
6 | C252, C253, C258, C259, C305, C306, C307, C312, C313, C314, C404, C405, C406, C414, C415, C424, C425, C426, C434, C435, C504, C505, C506, C507, C510, C511, C520, C521, C530, C531, C540, C541 | 10nF | Device:C_Small | Capacitor_SMD:C_0402_1005Metric | ‎CL05B103KO5NNNC‎ |  | Samsung | 32 | 500 | $0.007 | $0.21 |  | $0.21 | https://www.digikey.com/product-detail/en/samsung-electro-mechanics/CL05B103KO5NNNC/1276-1051-1-ND/3889137 | ~
7 | D1 | LED_RED_GREEN | Device:LED_Dual_CACA | KiCAD_Magic:LED_0805_DUAL | IN-S85DATRG |  | Inolux | 1 | 15 | $0.291 | $0.29 |  | $0.29 | https://www.mouser.com/ProductDetail/743-IN-S85DATRG | http://www.inolux-corp.com/datasheet/SMDLED/Bi-Color%20Top%20View/IN-S85DATRG_V1.0.pdf
8 | D2, D3, D4, D5 | LED_ALT | Device:LED_ALT | LED_SMD:LED_0603_1608Metric | SML-D13M8WT86 |  | Rohm Semiconductor | 4 | 50 | $0.193 | $0.77 |  | $0.77 | https://www.mouser.com/ProductDetail/755-SML-D13M8WT86 | https://d1d2qsbl8m0m72.cloudfront.net/en/products/databook/datasheet/opto/led/chip_mono/sml-d12x8_d13x8-e.pdf
9 | D6 | SS24FL | Device:D_Schottky_ALT | Diode_SMD:D_SOD-123F | SS24FL |  | ON Semiconductor | 1 | 15 | $0.209 | $0.21 |  | $0.21 | https://www.mouser.com/ProductDetail/512-SS24FL | https://www.onsemi.com/pub/Collateral/SS26FL-D.PDF
10 | D7, D8 | D5V0F4U6SO | Logicbone:D5V0F4U6SO | Package_TO_SOT_SMD:SOT-23-6 | D5V0F4U6SO-7 |  | Diodes Incorporated | 2 | 25 | $0.264 | $0.53 |  | $0.53 | https://www.digikey.com/product-detail/en/diodes-incorporated/D5V0F4U6SO-7/D5V0F4U6SO-7DICT-ND/4457883
11 | D9, D10 | TPD4E02B04 | Logicbone:TPD4E02B04 | Package_SON:USON-10_2.5x1.0mm_P0.5mm | TPD4E02B04DQAR |  | Texas Instruments | 2 | 25 | $0.465 | $0.93 |  | $0.93 | https://www.mouser.com/ProductDetail/595-TPD4E02B04DQAR | http://www.ti.com/lit/ds/symlink/tpd4e02b04.pdf
12 | FB1, FB2, FB3, FB4, FB5, FB7, FB8, FB9 | MPZ1608S600 | Device:Ferrite_Bead_Small | Inductor_SMD:L_0603_1608Metric | MPZ1608S600ATDH5 |  | TDK | 8 | 100 | $0.039 | $0.31 |  | $0.31 | https://www.mouser.com/ProductDetail/810-MPZ1608S600ATDH5 | ~
13 | FID1, FID2, FID3, FID4, FID5, FID6 | Fiducial | Mechanical:Fiducial | Fiducial:Fiducial_0.75mm_Mask1.5mm | DNP | DNP | DNP | 6 |  |  | $0.00 |  | $0.00 |  | ~
14 | H1, H2, H3, H4 | MountingHole | Mechanical:MountingHole | MountingHole:MountingHole_3.2mm_M3 | DNP | DNP | DNP | 4 |  |  | $0.00 |  | $0.00 |  | ~
15 | H5 | 9774025360 | Mechanical:MountingHole_Pad | Logicbone:wurth-9774025360 | 9774025360R |  | Wurth | 1 | 15 | $0.907 | $0.91 |  | $0.91 | https://www.mouser.com/ProductDetail/710-9774025360R | https://www.mouser.com/datasheet/2/445/9774025360R-1728785.pdf
16 | IC1 | ECP5UM-CABGA381 | Logicbone:ECP5UM-CABGA381 | Logicbone:caBGA-381_20x20_17.0x17.0mm | LFE5UM5G-45F-8BG381C | LFE5UM5G-85F-8BG381C | Lattice Semiconductor | 1 | 12 | $31.260 | $31.26 | $54.890 | $54.89 | https://www.digikey.com/product-detail/en/lattice-semiconductor-corporation/LFE5UM5G-45F-8BG381C/220-2107-ND/6173744
17 | IC2, IC3 | DDR3-TFBGA78 | KiCAD-Magic:DDR3-TFBGA78 | Package_BGA:FBGA-78_7.5x11mm_Layout2x3x13_P0.8mm | MT41K512M8DA-107:P | AS4C1G8MD3L-12BCN | Micron | 2 | 24 | $6.409 | $12.82 | $21.082 | $42.16 | https://www.digikey.com/product-detail/en/micron-technology-inc/MT41K512M8DA-107-P/557-1764-ND/5956624 | https://www.mouser.ca/datasheet/2/671/4Gb_DDR3L-1283964.pdf
18 | IC4 | MXL7704 | Logicbone:MXL7704 | Package_DFN_QFN:QFN-32-1EP_5x5mm_P0.5mm_EP3.65x3.65mm | MxL7704-AQB-R |  | MaxLinear | 1 | 12 | $4.058 | $4.06 |  | $4.06 | https://www.digikey.com/product-detail/en/maxlinear-inc/MXL7704-AQB-R/1016-2220-1-ND/10322951 | https://www.maxlinear.com/ds/mxl7704.pdf
19 | IC5 | PI6CG18401 | Logicbone:PI6CG18401 | Package_DFN_QFN:QFN-32-1EP_5x5mm_P0.5mm_EP3.1x3.1mm | PI6CG18401ZHIEX |  | Diodes Incorporated | 1 | 12 | $2.590 | $2.59 |  | $2.59 | https://www.mouser.com/ProductDetail/729-PI6CG18401ZHIEX
20 | IC6 | NCP349 | Logicbone:NCP349 | Logicbone:DFN6_1.6x2mm | NCP349MNBK |  | ON Semiconductor | 1 | 15 | $0.682 | $0.68 |  | $0.68 | https://www.mouser.com/ProductDetail/863-NCP349MNBKTBG
21 | IC7 | FPF2595 | Logicbone:FPF2595 | Logicbone:WLCSP-12_3x4_1.3x1.8mm | FPF2595UCX |  | ON Semiconductor | 1 | 15 | $0.783 | $0.78 |  | $0.78 | https://www.mouser.com/ProductDetail/512-FPF2595UCX | https://www.onsemi.com/pub/Collateral/FPF2595-D.pdf
22 | IC8 | FUSB307 | Logicbone:FUSB307 | Package_DFN_QFN:UQFN-16-1EP_3x3mm_P0.5mm_EP1.75x1.75mm | FUSB307BMPX |  | ON Semiconductor | 1 | 15 | $1.020 | $1.02 |  | $1.02 | https://www.mouser.com/ProductDetail/863-FUSB307BMPX | https://www.onsemi.com/pub/Collateral/FUSB307B-D.PDF
23 | IC9 | TLA2518 | Logicbone:TLA2518 | Package_DFN_QFN:WQFN-16-1EP_3x3mm_P0.5mm_EP1.75x1.75mm | TLA2518IRTER |  | Texas Instruments | 1 | 12 | $3.142 | $3.14 |  | $3.14 | https://www.digikey.com/product-detail/en/texas-instruments/TLA2518IRTER/296-TLA2518IRTERCT-ND/11502569 | http://www.ti.com/lit/ds/symlink/tla2518.pdf
24 | IC10 | W25Q128 | Memory_Flash:AT25SF081-XMHF-X | Package_DFN_QFN:DFN-8-1EP_6x5mm_P1.27mm_EP4x4mm | W25Q128JVPIQ |  | Winbond | 1 | 12 | $1.342 | $1.34 |  | $1.34 | https://www.digikey.com/product-detail/en/winbond-electronics/W25Q128JVPIQ/W25Q128JVPIQ-ND/6819668 | https://www.winbond.com/resource-files/w25q128jv%20revf%2003272018%20plus.pdf
25 | IC12 | 74LVC1G07 | Logicbone:74AUC1G07 | Package_TO_SOT_SMD:SOT-353_SC-70-5 | 74LVC1G07GW,125 |  | Nexperia | 1 | 15 | $0.141 | $0.14 |  | $0.14 | https://www.mouser.com/ProductDetail/771-74LVC1G07GW-G | https://assets.nexperia.com/documents/data-sheet/74LVC1G07.pdf
26 | IC13 | TPS51206 | Logicbone:TPS51206 | Logicbone:WSON-10EP-2x2mm | TPS51206DSQR |  | Texas Instruments | 1 | 15 | $0.683 | $0.68 |  | $0.68 | https://www.mouser.com/ProductDetail/595-TPS51206DSQR | http://www.ti.com/lit/ds/symlink/tps51206.pdf
27 | IC14 | KSZ9031RNXCC | Interface_Ethernet:KSZ9031RNXCA | Package_DFN_QFN:QFN-48-1EP_7x7mm_P0.5mm_EP5.15x5.15mm | KSZ9031RNXCC |  | Microchip | 1 | 12 | $2.810 | $2.81 |  | $2.81 | https://www.digikey.com/product-detail/en/microchip-technology/KSZ9031RNXCC-TR/KSZ9031RNXCC-CT-ND/7917225 | http://ww1.microchip.com/downloads/en/DeviceDoc/00002117C.pdf
28 | IC17, IC18 | NCP110AMX110 | Logicbone:NCP110 | Package_DFN_QFN:UDFN-4-1EP_1x1mm_P0.65mm_EP0.48x0.48mm | NCP110AMX120TBG |  | ON Semiconductor | 2 | 25 | $0.270 | $0.54 |  | $0.54 | https://www.mouser.com/ProductDetail/863-NCP110AMX120TBG | https://www.onsemi.com/pub/Collateral/NCP110-D.PDF
29 | IC19, IC20 | NCP115AMX250 | Logicbone:NCP110 | Package_DFN_QFN:UDFN-4-1EP_1x1mm_P0.65mm_EP0.48x0.48mm | NCP115AMX250TCG |  | ON Semiconductor | 2 | 25 | $0.197 | $0.39 |  | $0.39 | https://www.mouser.com/ProductDetail/863-NCP115AMX250TCG | https://www.onsemi.com/pub/Collateral/NCP115-D.PDF
30 | J1 | NGFF-KEY-E | Logicbone:NGFF-KEY-E | Logicbone:TE-2199230-4 | 2199230-4 |  | TE Connectivity | 1 | 15 | $1.010 | $1.01 |  | $1.01 | https://www.mouser.com/ProductDetail/571-2199230-4
31 | J2, J5 | USB_C_Receptacle | Connector:USB_C_Receptacle | Logicbone:Molex-1054500101 | 1054500101 |  | Molex | 2 | 25 | $1.949 | $3.90 |  | $3.90 | https://www.digikey.com/product-detail/en/molex/1054500101/WM12856CT-ND/5843891 | https://www.usb.org/sites/default/files/documents/usb_type-c.zip
32 | J3 | ARJM11xx-502 | Logicbone:ARJM11xx-502 | Logicbone:ARJM11B1_502 | ARJM11B1-502-AB-ER2-T |  | Abracon | 1 | 12 | $4.752 | $4.75 |  | $4.75 | https://www.digikey.com/product-detail/en/abracon-llc/ARJM11B1-502-AB-ER2-T/535-14133-1-ND/7675242
33 | J4 | TC2050-IDC-NL | Connector_Generic:Conn_02x05_Odd_Even | Connector:Tag-Connect_TC2050-IDC-NL_2x05_P1.27mm_Vertical | TC2050-IDC-NL |  | Tag Connect | 1 |  | $0.000 | $0.00 |  | $0.00 |  | ~
34 | J6 | Micro_SD_MEM2075 | Logicbone:Micro_SD_MEM2075 | Logicbone:MEM2075 | MEM2075-00-140-01-A |  | GCT | 1 | 12 | $1.860 | $1.86 |  | $1.86 | https://www.digikey.com/product-detail/en/gct/MEM2075-00-140-01-A/2073-MEM2075-00-140-01-ACT-ND/9859685 | https://gct.co/files/drawings/mem2075.pdf
35 | J7 | u.FL | Connector:Conn_Coaxial | Connector_Coaxial:U.FL_Hirose_U.FL-R-SMT-1_Vertical | DNP | DNP | DNP | 1 |  |  | $0.00 |  | $0.00 |  | ~
36 | L1 | 2.2uH | Device:L | Inductor_SMD:L_0805_2012Metric | TFM201610ALM-2R2MTAA |  | TDK | 1 | 15 | $0.374 | $0.37 |  | $0.37 | https://www.mouser.com/ProductDetail/810-TFM2161ALM2R2MTA | ~
37 | L2, L4 | 0.47uH | Device:L | Inductor_SMD:L_0805_2012Metric | TFM201610ALM-R47MTAA |  | TDK | 2 | 25 | $0.374 | $0.75 |  | $0.75 | https://www.mouser.com/ProductDetail/810-TFM2161ALMR47MTA | https://product.tdk.com/info/en/catalog/datasheets/inductor_commercial_power_tfm201610alm_en.pdf
38 | L3 | 1uH | Device:L | Inductor_SMD:L_0805_2012Metric | MAKK2016T1R0M |  | Taiyo Yuden | 1 | 15 | $0.180 | $0.18 |  | $0.18 | https://www.mouser.com/ProductDetail/963-MAKK2016T1R0M | ~
39 | P8, P9 | BB_2x23 | Connector_Generic:Conn_02x23_Odd_Even | Connector_PinHeader_2.54mm:PinHeader_2x23_P2.54mm_Vertical | PPPC232LFBN-RC |  | Sullins Connector | 2 | 25 | $2.333 | $4.67 |  | $4.67 | https://www.digikey.com/product-detail/en/sullins-connector-solutions/PPPC232LFBN-RC/S7126-ND/810262 | ~
40 | Q1 | Q_PMOS_GSD | Device:Q_PMOS_GSD | Package_TO_SOT_SMD:SOT-23 | FDV304P |  | ON Semiconductor | 1 | 15 | $0.200 | $0.20 |  | $0.20 | https://www.mouser.com/ProductDetail/512-FDV304P | https://www.onsemi.com/pub/Collateral/FDV304P-D.PDF
41 | R1, R2, R6, R37 | 33 | Device:R | Resistor_SMD:R_0402_1005Metric | ERJ-2RKF33R0X |  | Panasonic | 4 | 100 | $0.201 | $0.80 |  | $0.80 | https://www.digikey.com/product-detail/en/panasonic-electronic-components/ERJ-2RKF33R0X/P33-0LCT-ND/1746675 | ~
42 | R3, R4, R10, R27, R28 | 240 | Device:R | Resistor_SMD:R_0402_1005Metric | ERJ-2RKF2400X |  | Panasonic | 5 | 100 | $0.021 | $0.11 |  | $0.11 | https://www.mouser.com/ProductDetail/667-ERJ-2RKF2400X | ~
43 | R5, R39 | 100 | Device:R_Small | Resistor_SMD:R_0402_1005Metric | ERJ-2RKF1000X |  | Panasonic | 2 | 100 | $0.017 | $0.03 |  | $0.03 | https://www.mouser.com/ProductDetail/667-ERJ-2RKF1000X | ~
44 | R7 | 12.1k | Device:R_Small | Resistor_SMD:R_0402_1005Metric | ERJ-2RKF1212X |  | Panasonic | 1 | 100 | $0.015 | $0.02 |  | $0.02 | https://www.mouser.com/ProductDetail/667-ERJ-2RKF1212X | ~
46 | R11, R12, R18, R32 | 5.1k | Device:R | Resistor_SMD:R_0402_1005Metric | ERJ-2RKF5101X |  | Panasonic | 4 | 100 | $0.017 | $0.07 |  | $0.07 | https://www.mouser.com/ProductDetail/667-ERJ-2RKF5101X | ~
47 | R8, R13, R19, R20, R21, R22, R23, R24, R25, R29, R30, R31, R35 | 10k | Device:R | Resistor_SMD:R_0402_1005Metric | ERJ-2RKF1002X |  | Panasonic | 13 | 200 | $0.016 | $0.21 |  | $0.21 | https://www.mouser.com/ProductDetail/667-ERJ-2RKF1002X | ~
48 | R14, R15, R16, R38 | 47 | Device:R | Resistor_SMD:R_0402_1005Metric | ERJ-2RKF47R0X |  | Panasonic | 4 | 100 | $0.017 | $0.07 |  | $0.07 | https://www.mouser.com/ProductDetail/667-ERJ-2RKF47R0X | ~
49 | R17, R26 | 1.5k | Device:R | Resistor_SMD:R_0402_1005Metric | ERJ-2RKF1501X |  | Panasonic | 2 | 100 | $0.006 | $0.01 |  | $0.01 | https://www.digikey.com/product-detail/en/panasonic-electronic-components/ERJ-2RKF1501X/P1-50KLCT-ND/194105 | ~
50 | R33 | 750 | Device:R | Resistor_SMD:R_0402_1005Metric | ERJ-2RKF7500X |  | Panasonic | 1 | 100 | $0.018 | $0.02 |  | $0.02 | https://www.mouser.com/ProductDetail/667-ERJ-2RKF7500X | ~
51 | R34, R36 | 1.2k | Device:R | Resistor_SMD:R_0402_1005Metric | ERJ-2RKF1201X |  | Panasonic | 2 | 100 | $0.016 | $0.03 |  | $0.03 | https://www.mouser.com/ProductDetail/667-ERJ-2RKF1201X | ~
53 | RN1, RN2, RN3 | 47 | Device:R_Network08 | KiCAD_Magic:EXBD-1206 | EXB-D10C470J |  | Panasonic | 3 | 100 | $0.163 | $0.49 |  | $0.49 | https://www.mouser.com/ProductDetail/667-EXB-D10C470J | http://www.vishay.com/docs/31509/csc.pdf
54 | RN4, RN5, RN6, RN7, RN8, RN11 | 10k | Device:R_Pack04 | Resistor_SMD:R_Array_Concave_4x0603 | CAT16-103J4GLF |  | Bourns | 6 | 100 | $0.014 | $0.08 |  | $0.08 | https://www.mouser.com/ProductDetail/652-CAT16-103J4GLF | ~
55 | RN9 | 470 | Device:R_Pack04 | Resistor_SMD:R_Array_Concave_4x0603 | CAT16-471J4LF |  | Bourns | 1 | 100 | $0.092 | $0.09 |  | $0.09 | https://www.mouser.com/ProductDetail/652-CAT16-471J4LF | ~
56 | SW1, SW2 | SW_SPST | Switch:SW_SPST | Button_Switch_SMD:SW_SPST_PTS810 | PTS810 SJK 250 SMTR LFS |  | C&K Switches | 2 | 25 | $0.165 | $0.33 |  | $0.33 | https://www.mouser.com/ProductDetail/611-PTS810SJK250SMTR | https://dznh3ojzb2azq.cloudfront.net/products/Tactile/PTS810/documents/datasheet.pdf
57 | Y1 | 25MHz | Logicbone:Crystal_GND24 | Crystal:Crystal_SMD_2520-4Pin_2.5x2.0mm | ECS-250-18-36B-CKY-TR |  | ECS Inc. | 1 | 15 | $0.363 | $0.36 |  | $0.36 | https://www.mouser.com/ProductDetail/520-250-18-36B-CKYT | https://ecsxtal.com/store/pdf/ECX-2236B.pdf
 |  |  |  |  |  |  |  |  |  | Total: | $88.90 | Total Upgr: | $141.87
