SiwaNetwork/CASS/CAM_LATTICE_STM/LATTICE REFERENCE/ECP5-Development-Board-master/Project Outputs for Free Documents/BOM/ECP5_V2_BOM-ECP5_V2.xlsx

Category | Description | LibRef | Manufacturer 1 | Manufacturer Lifecycle 1 | Manufacturer Part Number 1 | Quantity | Supplier 1 | Supplier Currency 1 | Supplier Order Qty 1 | Supplier Part Number 1 | Supplier Stock 1 | Supplier Subtotal 1 | Supplier Subtotal per Board 1 | Supplier Unit Price 1
 | KEMET - C0603C471K3RACTU - SMD Multilayer Ceramic Capacitor, 470 pF, 25 V, 0603 [1608 Metric], ± 10%, X7R, C Series KEMET | C0603C471K3RACTU | KEMET (https://octopart-clicks.com/click/altium?sku=399-9086-6-ND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) | Volume Production | C0603C471K3RACTU (https://octopart-clicks.com/click/altium?sku=399-9086-6-ND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) | 3 | Digi-Key | USD | 3 | 399-9086-6-ND (https://octopart-clicks.com/click/altium?sku=399-9086-6-ND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) | 24786 | 0.3 | 0.3 | 0.1
 | CAP CER 22UF 6.3V X5R 0805 | CL21A226MQCLRNC | Samsung (https://octopart-clicks.com/click/altium?sku=1276-2413-6-ND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) | Volume Production | CL21A226MQCLRNC (https://octopart-clicks.com/click/altium?sku=1276-2413-6-ND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) | 9 | Digi-Key | USD | 9 | 1276-2413-6-ND (https://octopart-clicks.com/click/altium?sku=1276-2413-6-ND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) | 270184 | 3.24 | 3.24 | 0.36
 | Ceramic capacitor SMD 0805 2.2 µF 25 V 10 % | CL21A225KAFNNNG | Samsung (https://octopart-clicks.com/click/altium?sku=1276-6458-6-ND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) | Volume Production | CL21A225KAFNNNG (https://octopart-clicks.com/click/altium?sku=1276-6458-6-ND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) | 6 | Digi-Key | USD | 6 | 1276-6458-6-ND (https://octopart-clicks.com/click/altium?sku=1276-6458-6-ND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) | 303121 | 0.9 | 0.9 | 0.15
 | Feed Through Capacitors 22nF X7R 20% 25V | CX0603MRX7R8BB223 | Yageo (https://octopart-clicks.com/click/altium?sku=311-1234-6-ND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) | Volume Production | CX0603MRX7R8BB223 (https://octopart-clicks.com/click/altium?sku=311-1234-6-ND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) | 9 | Digi-Key | USD | 9 | 311-1234-6-ND (https://octopart-clicks.com/click/altium?sku=311-1234-6-ND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) | 11069 | 8.28 | 8.28 | 0.92
 | ON SEMICONDUCTOR/FAIRCHILD - 1N914BWS. - SMALL SIGNAL DIODE | 1N914BWS | ON Semiconductor / Fairchild (https://octopart-clicks.com/click/altium?manufacturer=ON%20Semiconductor%20%2F%20Fairchild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) | Volume Production | 1N914BWS (https://octopart-clicks.com/click/altium?manufacturer=ON%20Semiconductor%20%2F%20Fairchild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) | 5 | Digi-Key | USD | 5 | 1N914BWSDKR-ND (https://octopart-clicks.com/click/altium?manufacturer=ON%20Semiconductor%20%2F%20Fairchild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) | 133269 | 0.8 | 0.8 | 0.16
 | LED Uni-Color Green 572nm 2-Pin Chip 0603(1608Metric) T/R | LGL29K-G2J1-24-Z | Osram Opto (https://octopart-clicks.com/click/altium?sku=475-2709-6-ND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) | Volume Production | LGL29K-G2J1-24-Z (https://octopart-clicks.com/click/altium?sku=475-2709-6-ND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) | 5 | Digi-Key | USD | 5 | 475-2709-6-ND (https://octopart-clicks.com/click/altium?sku=475-2709-6-ND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) | 99386 | 2.1 | 2.1 | 0.42
 | DIODE SCHOTTKY 30V 2A SMA | STPS2L30AF | STMicroelectronics (https://octopart-clicks.com/click/altium?sku=497-12310-6-ND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) | Volume Production | STPS2L30AF (https://octopart-clicks.com/click/altium?sku=497-12310-6-ND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) | 1 | Digi-Key | USD | 1 | 497-12310-6-ND (https://octopart-clicks.com/click/altium?sku=497-12310-6-ND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) | 8273 | 0.45 | 0.45 | 0.45
 | Diode Zener Single 3.6V 5% 200mW 2-Pin SOD-323 T/R | BZT52C3V6S-TP | MCC (https://octopart-clicks.com/click/altium?sku=BZT52C3V6S-TPMSDKR-ND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) | Volume Production | BZT52C3V6S-TP (https://octopart-clicks.com/click/altium?sku=BZT52C3V6S-TPMSDKR-ND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) | 2 | Digi-Key | USD | 2 | BZT52C3V6S-TPMSDKR-ND (https://octopart-clicks.com/click/altium?sku=BZT52C3V6S-TPMSDKR-ND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) | 5013 | 0.52 | 0.52 | 0.26
 | 10-WAY SIL VERT SOCKET L/FREE | M20-7821046 | Harwin (https://octopart-clicks.com/click/altium?sku=952-1847-ND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) | Volume Production | M20-7821046 (https://octopart-clicks.com/click/altium?sku=952-1847-ND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) | 1 | Digi-Key | USD | 1 | 952-1847-ND (https://octopart-clicks.com/click/altium?sku=952-1847-ND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) | 421 | 1.28 | 1.28 | 1.28
 | 08-WAY SIL VERT SOCKET L/FREE | M20-7820842 | Harwin (https://octopart-clicks.com/click/altium?sku=952-1823-ND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) | Volume Production | M20-7820842 (https://octopart-clicks.com/click/altium?sku=952-1823-ND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) | 2 | Digi-Key | USD | 2 | 952-1823-ND (https://octopart-clicks.com/click/altium?sku=952-1823-ND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) | 1172 | 2.2 | 2.2 | 1.1
 | 06-WAY SIL VERT SOCKET L/FREE | M20-7820646 | Harwin (https://octopart-clicks.com/click/altium?sku=952-1809-ND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) | Volume Production | M20-7820646 (https://octopart-clicks.com/click/altium?sku=952-1809-ND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) | 1 | Digi-Key | USD | 1 | 952-1809-ND (https://octopart-clicks.com/click/altium?sku=952-1809-ND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) | 1757 | 0.96 | 0.96 | 0.96
Connectors, Interconnects | CONN MICRO SD R/A PUSH-PUSH SMD | DM3AT-SF-PEJM5 | Hirose (https://octopart-clicks.com/click/altium?sku=HR1964CT-ND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) | Volume Production | DM3AT-SF-PEJM5 (https://octopart-clicks.com/click/altium?sku=HR1964CT-ND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) | 1 | Digi-Key | USD | 1 | HR1964CT-ND (https://octopart-clicks.com/click/altium?sku=HR1964CT-ND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) | 0 | 2.67 | 2.67 | 2.67
Connectors, Interconnects | CONN RCPT MICRO USB AB R/A SMD | 0475890001 | Molex (https://octopart-clicks.com/click/altium?sku=WM17143CT-ND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) | Volume Production | 0475890001 (https://octopart-clicks.com/click/altium?sku=WM17143CT-ND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) | 2 | Digi-Key | USD | 2 | WM17143CT-ND (https://octopart-clicks.com/click/altium?sku=WM17143CT-ND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) | 21393 | 1.56 | 1.56 | 0.78
 | CONN HEADER VERT 6POS 2.54MM | 67997-106HLF | Amphenol ICC / FCI (https://octopart-clicks.com/click/altium?manufacturer=Amphenol%20ICC%20%2F%20FCI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) | Unknown | 67997-106HLF (https://octopart-clicks.com/click/altium?manufacturer=Amphenol%20ICC%20%2F%20FCI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) | 1 | Digi-Key | USD | 1 | 609-3393-ND (https://octopart-clicks.com/click/altium?manufacturer=Amphenol%20ICC%20%2F%20FCI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) | 1446 | 1.78 | 1.78 | 1.78
 | FIXED IND 2.2UH 2A 80 MOHM SMD | L1210R2R2MDWIT | KEMET (https://octopart-clicks.com/click/altium?sku=399-9598-6-ND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) | Volume Production | L1210R2R2MDWIT (https://octopart-clicks.com/click/altium?sku=399-9598-6-ND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) | 3 | Digi-Key | USD | 3 | 399-9598-6-ND (https://octopart-clicks.com/click/altium?sku=399-9598-6-ND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) | 480 | 1.56 | 1.56 | 0.52
 | Res General Purpose Thick Film 0603 10K Ohm 1% 1/10W ±100ppm/°C Molded SMD Paper T/R | RC0603FR-0710KL | Yageo Phycomp (https://octopart-clicks.com/click/altium?sku=311-10.0KHRDKR-ND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) | Volume Production | RC0603FR-0710KL (https://octopart-clicks.com/click/altium?sku=311-10.0KHRDKR-ND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) | 4 | Digi-Key | USD | 4 | 311-10.0KHRDKR-ND (https://octopart-clicks.com/click/altium?sku=311-10.0KHRDKR-ND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) | 9049474 | 0.4 | 0.4 | 0.1
 | RES SMD 1.1K OHM 1% 1/10W 0603 | RC0603FR-071K1L | Yageo (https://octopart-clicks.com/click/altium?sku=311-1.10KHRDKR-ND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) | Volume Production | RC0603FR-071K1L (https://octopart-clicks.com/click/altium?sku=311-1.10KHRDKR-ND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) | 4 | Digi-Key | USD | 4 | 311-1.10KHRDKR-ND (https://octopart-clicks.com/click/altium?sku=311-1.10KHRDKR-ND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) | 532951 | 0.4 | 0.4 | 0.1
 | RES SMD 4.7K OHM 1% 1/10W 0603 | RC0603FR-074K7L | Yageo Phycomp (https://octopart-clicks.com/click/altium?sku=311-4.70KHRCT-ND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) | Volume Production | RC0603FR-074K7L (https://octopart-clicks.com/click/altium?sku=311-4.70KHRCT-ND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) | 2 | Digi-Key | USD | 2 | 311-4.70KHRCT-ND (https://octopart-clicks.com/click/altium?sku=311-4.70KHRCT-ND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) | 975603 | 0.2 | 0.2 | 0.1
 | Res Thick Film 0603 15K Ohm 1% 1/10W ?100ppm/?C Molded SMD Paper T/R | RC0603FR-0715KL | Yageo (https://octopart-clicks.com/click/altium?sku=311-15.0KHRCT-ND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) | Volume Production | RC0603FR-0715KL (https://octopart-clicks.com/click/altium?sku=311-15.0KHRCT-ND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) | 9 | Digi-Key | USD | 9 | 311-15.0KHRCT-ND (https://octopart-clicks.com/click/altium?sku=311-15.0KHRCT-ND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) | 3371624 | 0.9 | 0.9 | 0.1
 | RES SMD 549 OHM 1% 1/10W 0603 | RC0603FR-07549RL |  |  |  | 5 | Digi-Key |  |  | 311-549HRDKR-ND
 | YAGEO (PHYCOMP) - RC0603FR-0718KL - SMD Chip Resistor, 0603 [1608 Metric], 18 kohm, RC Series, 75 V, Thick Film, 100 mW | RC0603FR-0718KL | Yageo (https://octopart-clicks.com/click/altium?sku=311-18.0KHRDKR-ND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) | Volume Production | RC0603FR-0718KL (https://octopart-clicks.com/click/altium?sku=311-18.0KHRDKR-ND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) | 1 | Digi-Key | USD | 1 | 311-18.0KHRDKR-ND (https://octopart-clicks.com/click/altium?sku=311-18.0KHRDKR-ND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) | 0 | 0.1 | 0.1 | 0.1
 | YAGEO - RC0603FR-073K3L - SMD Chip Resistor, 0603 [1608 Metric], 3.3 kohm, RC Series, 75 V, Thick Film, 100 mW | RC0603FR-073K3L | Yageo Phycomp (https://octopart-clicks.com/click/altium?sku=311-3.30KHRDKR-ND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) | Volume Production | RC0603FR-073K3L (https://octopart-clicks.com/click/altium?sku=311-3.30KHRDKR-ND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) | 1 | Digi-Key | USD | 1 | 311-3.30KHRDKR-ND (https://octopart-clicks.com/click/altium?sku=311-3.30KHRDKR-ND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) | 1074036 | 0.1 | 0.1 | 0.1
 | Res Thick Film 0603 22 Ohm 1% 0.1W(1/10W) ±100ppm/C Pad SMD T/R | RC0603FR-0722RL |  |  |  | 4 | Digi-Key |  |  | 311-22.0HRCT-ND
 | ALCOSWITCH - TE CONNECTIVITY - 1825910-6 - TACT SWITCH, SPST, 0.05A, 24VDC, SOLDER | 1825910-6 |  |  |  | 1 | Digi-Key |  |  | 450-1650-ND
 | ECP5 Series 44 K LUTs 203 I/O 1.1 V Slow Surface Mount FPGA - CABGA-381 | LFE5UM-45F-6BG381C | Lattice Semiconductor (https://octopart-clicks.com/click/altium?manufacturer=Lattice%20Semiconductor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) | Not Recommended for New Design | LFE5UM-45F-6BG381C (https://octopart-clicks.com/click/altium?manufacturer=Lattice%20Semiconductor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) | 1 | Digi-Key | USD |  | 220-1994-ND (https://octopart-clicks.com/click/altium?manufacturer=Lattice%20Semiconductor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) | 0
 | IC FLASH 128M SPI 133MHZ 8SOIC | IS25LP128F-JBLE |  |  |  | 1 | Digi-Key |  |  | IS25LP128F-JBLE-ND
 | 1-A HIGH EFFICIENCY STEP-DOWN | TLV62569DBVR | Texas Instruments (https://octopart-clicks.com/click/altium?sku=296-47360-6-ND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) | Unknown | TLV62569DBVR (https://octopart-clicks.com/click/altium?sku=296-47360-6-ND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) | 3 | Digi-Key | USD | 3 | 296-47360-6-ND (https://octopart-clicks.com/click/altium?sku=296-47360-6-ND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) | 2561 | 1.59 | 1.59 | 0.53
 | IC Dram 256M Parallel 54TSOP | MT48LC16M16A2TG-6A:GTR |  |  |  | 1 | Digi-Key |  |  | 1450-1352-6-ND
 | FTDI - FT231XS-R - USB Interface, Transceiver, USB 2.0, 2.97 V, 5.5 V, SSOP, 20 RoHS Compliant: Yes | FT231XS-R | FTDI (https://octopart-clicks.com/click/altium?sku=768-1129-6-ND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) | Volume Production | FT231XS-R (https://octopart-clicks.com/click/altium?sku=768-1129-6-ND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) | 1 | Digi-Key | USD | 1 | 768-1129-6-ND (https://octopart-clicks.com/click/altium?sku=768-1129-6-ND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) | 3286 | 2.12 | 2.12 | 2.12
 | SMD Crystal Oscillator 25MHz 3.3V 15pF 4-Pin CSMD | FNETHE025 | Diodes (https://octopart-clicks.com/click/altium?sku=FNETHE025DKR-ND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) | Volume Production | FNETHE025 (https://octopart-clicks.com/click/altium?sku=FNETHE025DKR-ND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) | 1 | Digi-Key |  |  | FNETHE025DKR-ND (https://octopart-clicks.com/click/altium?sku=FNETHE025DKR-ND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) | 0
