SiwaNetwork/CASS/CAM-ALTERA_STM/Производство/EQ - CAM_DVB-CI GERBERS rev.1.1 2024-07-10 09-17.xls

Customer P/N （客户型号）： | EQ-CAM_DVB-CI GERBERS rev.1.1 2024-07-10 09-17 |  | Engineering Department Design For Manufacture and Engineering Confirmation Sheet 工程确认单
P/N（工厂型号）：
Prepared（制作者）：
Date（日期）： | 2024-08-24
NOTE(注意 ): Customer's reply in column yellow area（客户的回复在黄色区域）.
No. | Types of Problems（问题类型） | Problem Description（问题描述） | suggestions（建议） |  | Attachments（附图） | Reply（回复）
1 | Other | The specification indicate the board thickness is 0.8mm, but in the gerber drawing showed the board thickness is 0.86mm ,they are mismatch | A | We suggset follow the finidhed board thickness is 0.8mm. | PIC1 | В
 |  |  | B | We suggset follow the finidhed board thickness is 0.86mm.
 |  |  | C
2 | Other | Please clarify the finish surface treatment requirements. | A | suggest follow HASL lead-free treatment for this order. | PIC2 | В
 |  |  | B | suggest the finish surface use HASL Tin-lead treatment.
 |  |  | C
3 | Other | Customer requires that solder thickness should be 27um. It is too tight for us to control it. | A | We suggest following the common requirement to control the solder thickness as 1-40um. | PIC3 | А
 |  |  | B
 |  |  | C
4 | Other | You require the thickness of the solder mask is 25um, it is too thickness and difficult to make .Please confirm . | A | We suggest the solder mask thickness follow 8-30um to make . | PIC4 | А
 |  |  | B | these boards to have 2 pass solder mask in requires, but the price will be increase if you choose this one.
 |  |  | C
5 | Other | See the attached picture, please make sure that our company is assembling the plate correctly? Top and bottom add 5mm craft edge each, size 85*102mm | A | The panel drawing is OK . | PIC5 | А
 |  |  | B
 |  |  | C
6 | Other | Please find the attached file for the working gerber. Please confirm. | A | The working gerber is OK . |  | А
 |  |  | B
 |  |  | C
