SiwaNetwork/CASS/КД и ЭД/КД оснастка/Комплект оснастки.xlsx

Количество и комплект одного образца технилогической оснастки
№ п/п | Наименование | Децимальный номер | Количество, шт.
1 | Плита | ТЕНШ.741428.001 | 2
2 | Плита | ТЕНШ.741428.002 | 1
3 | Штырь | ТЕНШ.716611.001 | 4
