SiwaNetwork/CASS/CAM_LATTICE_STM/LATTICE REFERENCE/logicbone-master/package3d/arjm11b1-502.step

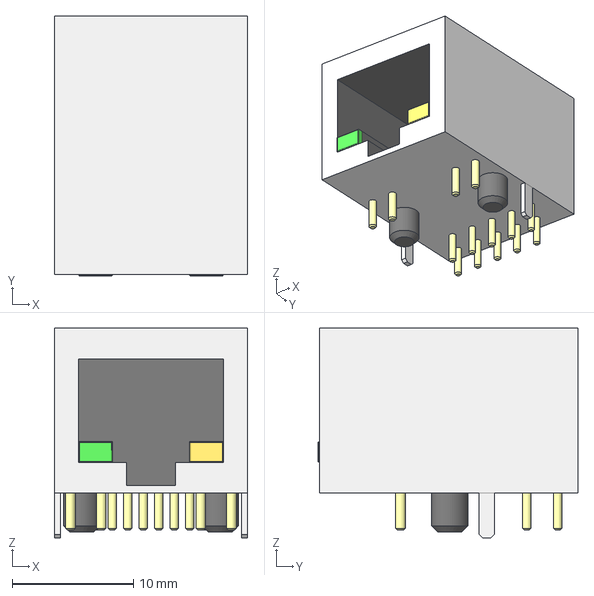
[picture p46: CAD file, 2025-04-04]
CAM_LATTICE_STM/LATTICE REFERENCE/logicbone-master/package3d/arjm11b1-502.step
15.9 x 21.4 x 17.3 mm
