SiwaNetwork/CASS/CAM_LATTICE_STM/LATTICE REFERENCE/ul_LFE5U-45F-7BG256I/AltiumDesigner/caBGA256_LAT.step

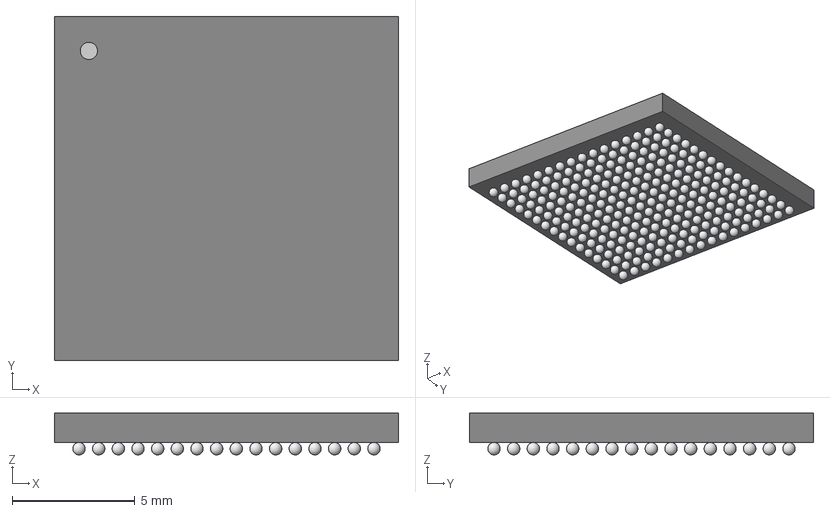
[picture p47: CAD file, 2025-04-04]
CAM_LATTICE_STM/LATTICE REFERENCE/ul_LFE5U-45F-7BG256I/AltiumDesigner/caBGA256_LAT.step
14.0 x 14.0 x 1.70 mm
