SiwaNetwork/CASS/БИБЛИОТЕКА/LIB_SN74CBTD3384CDBR/SN74CBTD3384CDBR/3D/SN74CBTD3384CDBR.stp

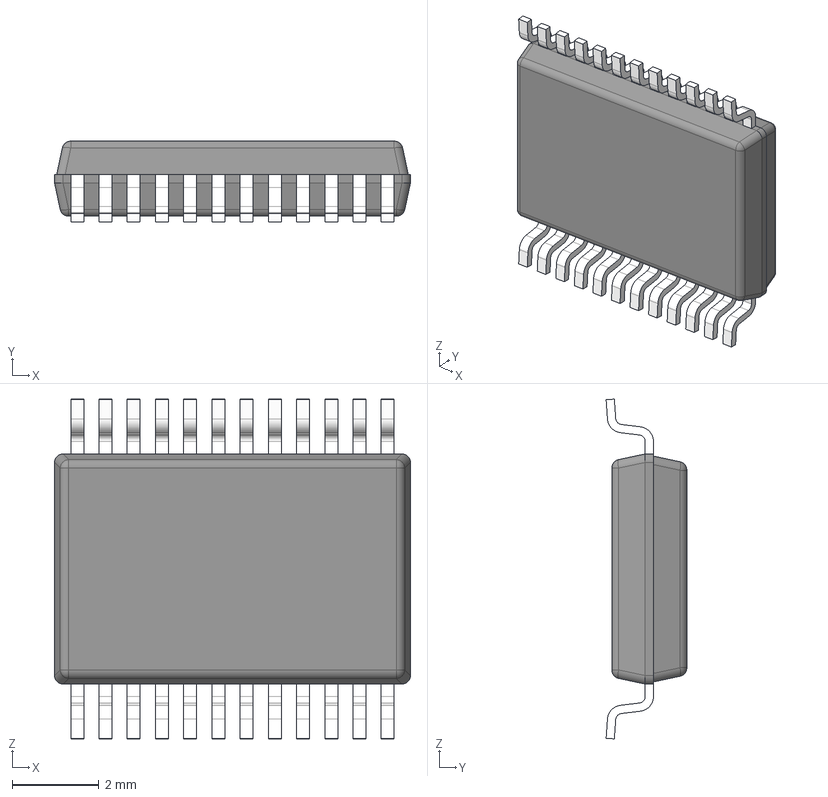
[picture p48: CAD file, 2024-04-08]
БИБЛИОТЕКА/LIB_SN74CBTD3384CDBR/SN74CBTD3384CDBR/3D/SN74CBTD3384CDBR.stp
8.20 x 1.86 x 7.83 mm
BODY_MSA24
LEAD_MSA24 x 24
