SiwaNetwork/CASS/БИБЛИОТЕКА/W25Q64BVSSIG/W25Q64BVSSIG.step

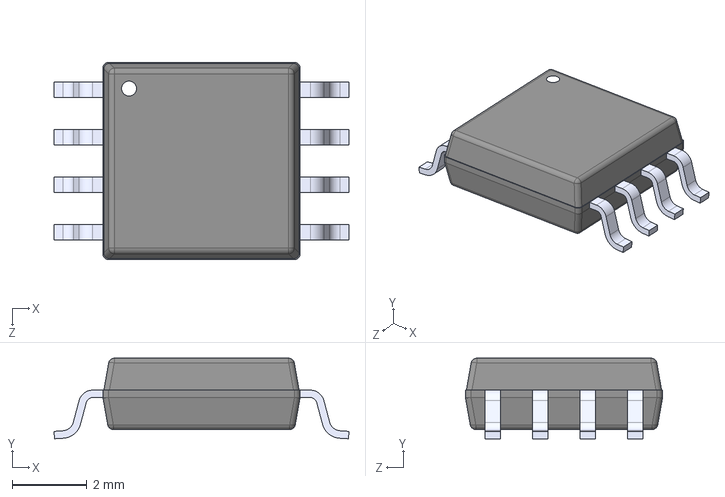
[picture p49: CAD file, 2024-04-12]
БИБЛИОТЕКА/W25Q64BVSSIG/W25Q64BVSSIG.step
7.90 x 2.16 x 5.28 mm
