SiwaNetwork/CASS/КД и ЭД/КД оснастка/Модели/Плита пресс 6 мульти.stp

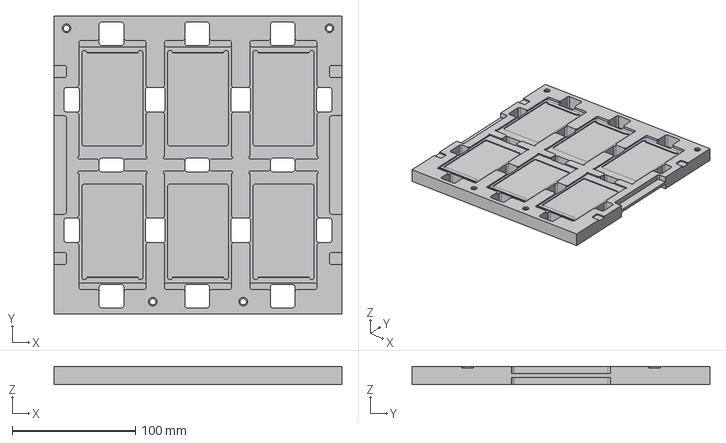
[picture p50: CAD file, 2025-05-29]
КД и ЭД/КД оснастка/Модели/Плита пресс 6 мульти.stp
233.5 x 242.0 x 15.0 mm
