SiwaNetwork/CASS/КД и ЭД/КД оснастка/Модели/Старое/рамка-плита.stp

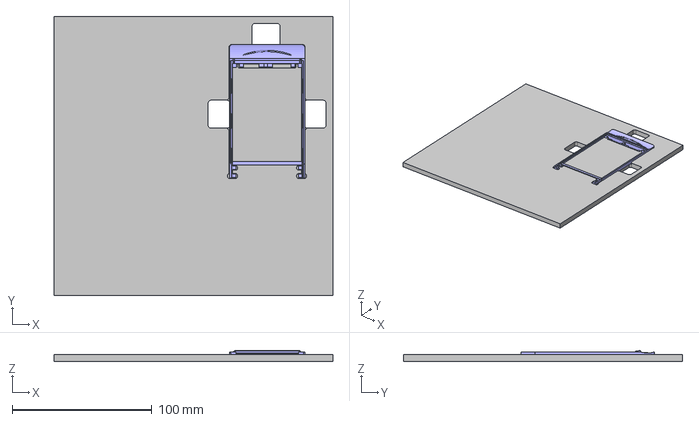
[picture p51: CAD file, 2025-05-29]
КД и ЭД/КД оснастка/Модели/Старое/рамка-плита.stp
200.0 x 200.0 x 7.70 mm
03.001 Рамка
