SiwaNetwork/CASS/КД и ЭД/КД оснастка/Плита _ ТЕНШ.741428.002/Плита_ТЕНШ.741428.002.stp

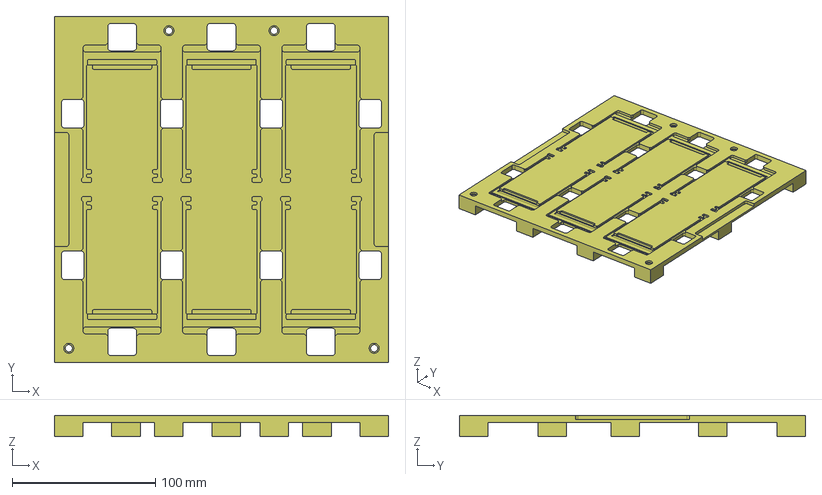
[picture p52: CAD file, 2025-05-29]
КД и ЭД/КД оснастка/Плита _ ТЕНШ.741428.002/Плита_ТЕНШ.741428.002.stp
233.5 x 242.0 x 15.0 mm
