SiwaNetwork/CASS/КД и ЭД/КД оснастка/Штырь_ТЕНШ.716611.001/Штырь_ТЕНШ.716611.001.stp

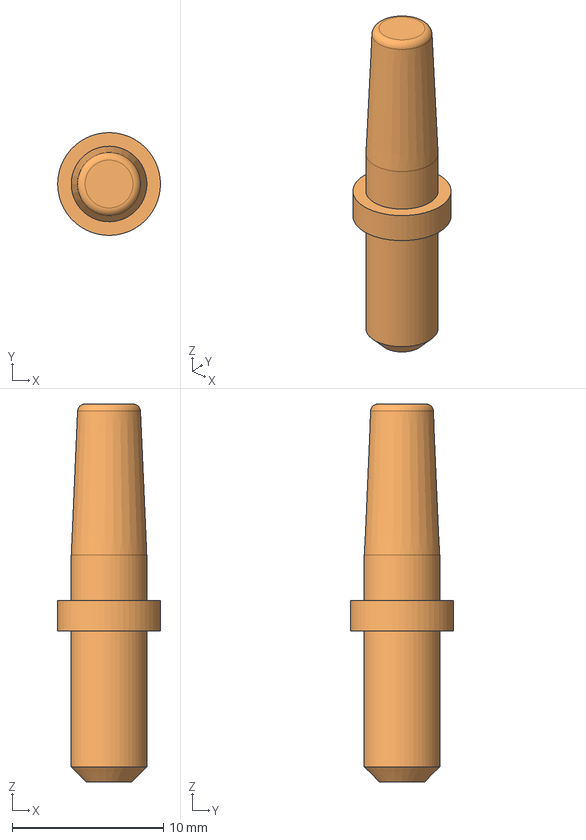
[picture p53: CAD file, 2025-05-29]
КД и ЭД/КД оснастка/Штырь_ТЕНШ.716611.001/Штырь_ТЕНШ.716611.001.stp
6.79 x 6.80 x 25.0 mm
