SiwaNetwork/CASS/Корпус/03.002 Крышка.STEP

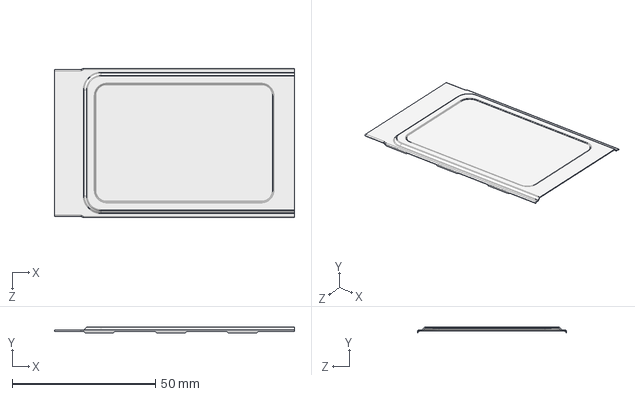
[picture p54: CAD file, 2025-05-27]
Корпус/03.002 Крышка.STEP
83.8 x 2.00 x 52.2 mm
