SiwaNetwork/CASS/Корпус/PCMCIA/03.001 Рамка.SLDPRT

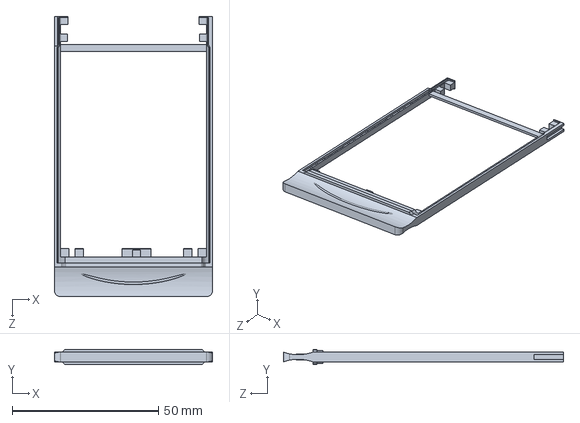
[picture p55: CAD file, 2025-01-25]
Корпус/PCMCIA/03.001 Рамка.SLDPRT
54.0 x 5.10 x 95.6 mm
