SiwaNetwork/CASS/Корпус/Новая папка/Архив/PCMCIA Connectors 5535651-1.SLDPRT

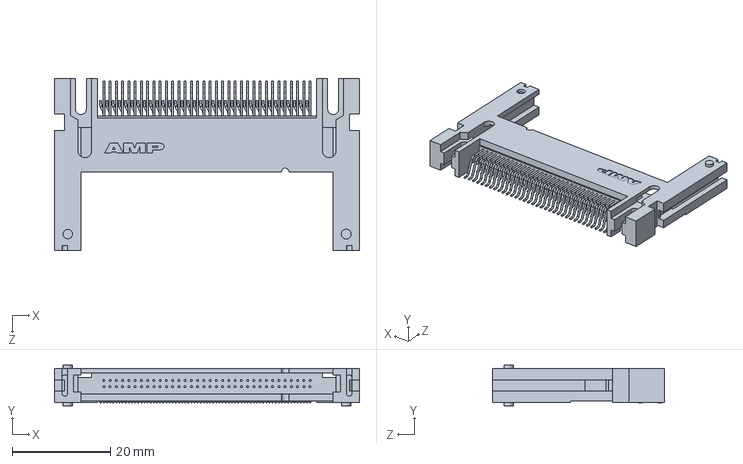
[picture p56: CAD file, 2024-09-22]
Корпус/Новая папка/Архив/PCMCIA Connectors 5535651-1.SLDPRT
62.0 x 8.31 x 35.0 mm
