SiwaNetwork/CASS/Корпус/Новая папка/Рамка 2.SLDPRT

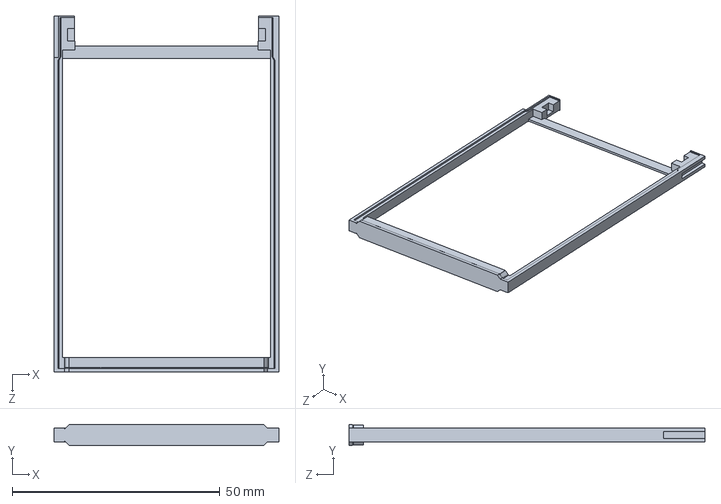
[picture p57: CAD file, 2024-09-22]
Корпус/Новая папка/Рамка 2.SLDPRT
54.0 x 5.10 x 85.6 mm
