SiwaNetwork/CASS/CAM_LATTICE_STM/LATTICE REFERENCE/logicbone-master/package3d/usb4110.step

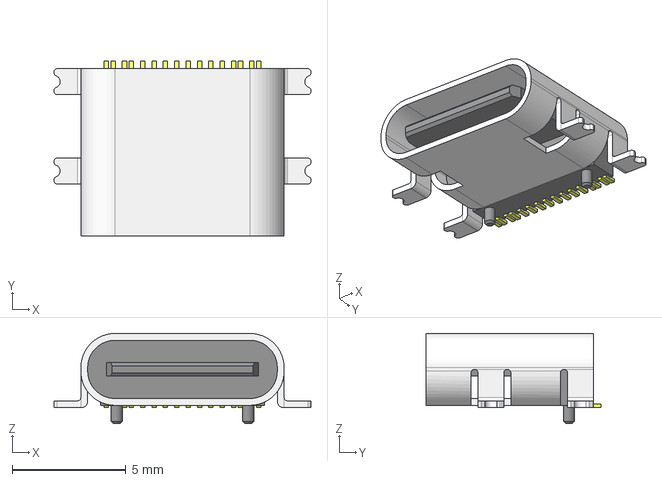
[picture p58: CAD file, 2025-04-04]
CAM_LATTICE_STM/LATTICE REFERENCE/logicbone-master/package3d/usb4110.step
11.3 x 7.68 x 3.96 mm
