SiwaNetwork/CASS/КД и ЭД/КД оснастка/Модели/Старое/Плита пресс.stp

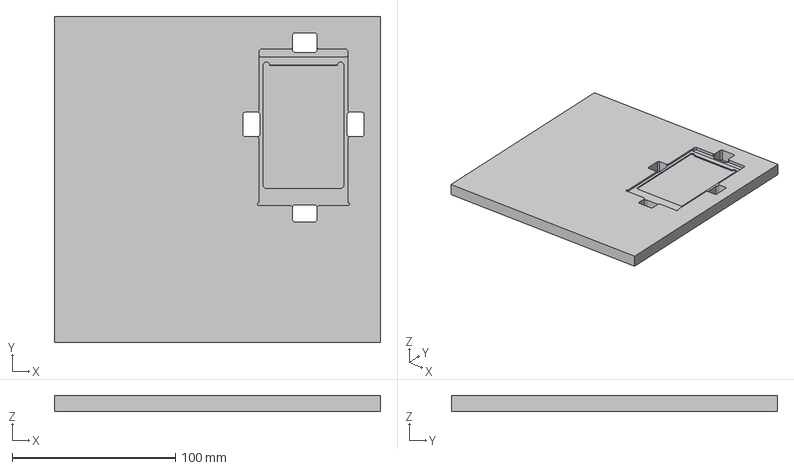
[picture p59: CAD file, 2025-05-29]
КД и ЭД/КД оснастка/Модели/Старое/Плита пресс.stp
200.0 x 200.0 x 10.0 mm
