SiwaNetwork/CASS/Корпус/PCMCIA/03.002 Крышка.SLDPRT

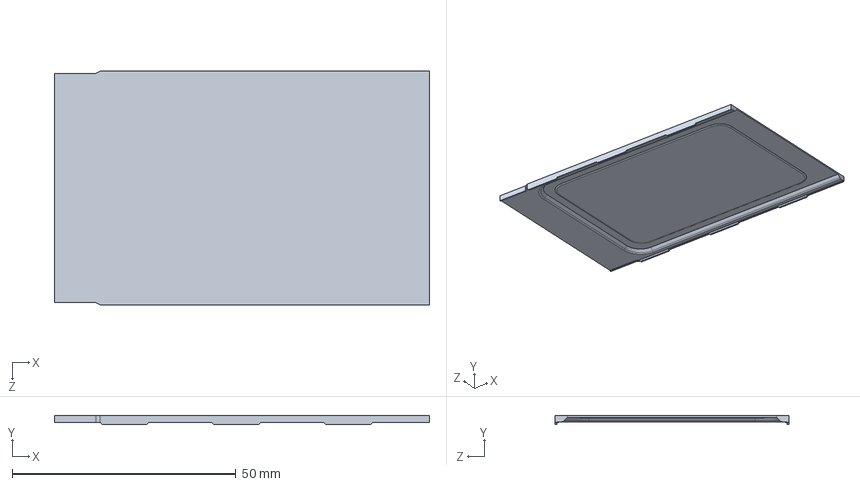
[picture p60: CAD file, 2025-01-25]
Корпус/PCMCIA/03.002 Крышка.SLDPRT
83.8 x 2.00 x 52.2 mm
