SiwaNetwork/CASS/Корпус/Новая папка/Архив/PCMCIA Connectors 5146547-1.SLDPRT

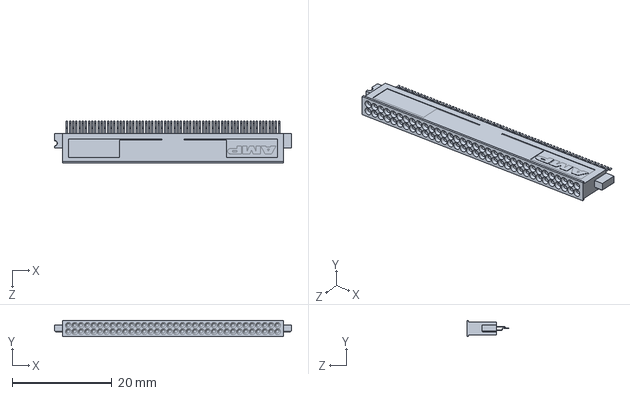
[picture p61: CAD file, 2024-09-22]
Корпус/Новая папка/Архив/PCMCIA Connectors 5146547-1.SLDPRT
47.5 x 3.30 x 8.48 mm
