SiwaNetwork/CASS/КД и ЭД/КД оснастка/Модели/Старое/Плита для рамки2.stp

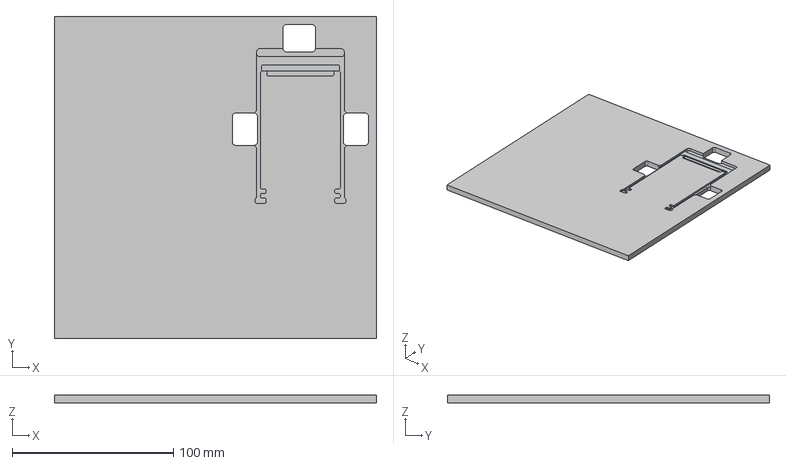
[picture p62: CAD file, 2025-05-29]
КД и ЭД/КД оснастка/Модели/Старое/Плита для рамки2.stp
200.0 x 200.0 x 5.00 mm
