SiwaNetwork/CASS/Корпус/Новая папка/Крышка 2.SLDPRT

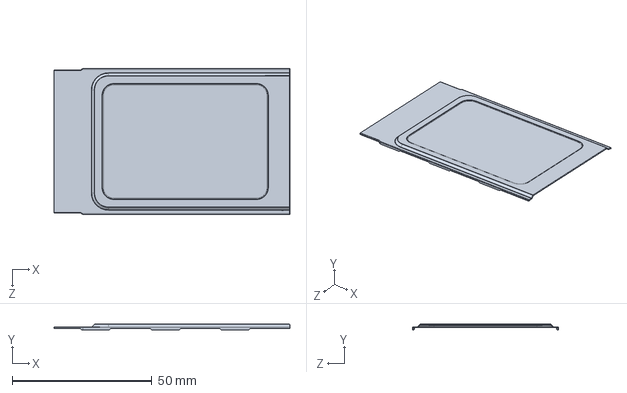
[picture p63: CAD file, 2024-09-22]
Корпус/Новая папка/Крышка 2.SLDPRT
84.4 x 2.00 x 52.2 mm
