SiwaNetwork/CASS/CAM_LATTICE_STM/LATTICE REFERENCE/logicbone-master/package3d/bb-pin-header-2x23.step

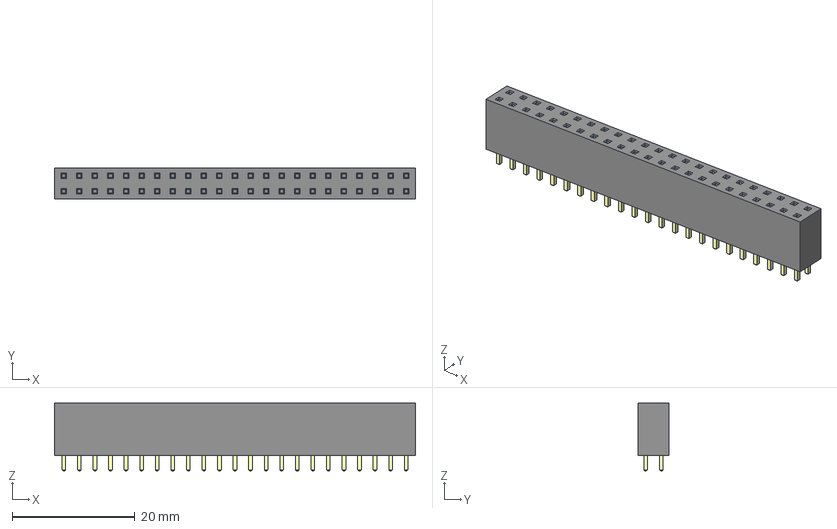
[picture p64: CAD file, 2025-04-04]
CAM_LATTICE_STM/LATTICE REFERENCE/logicbone-master/package3d/bb-pin-header-2x23.step
58.9 x 5.00 x 11.1 mm
