SiwaNetwork/CASS/CAM_LATTICE_STM/LATTICE REFERENCE/logicbone-master/package3d/microsd-mem2075.step

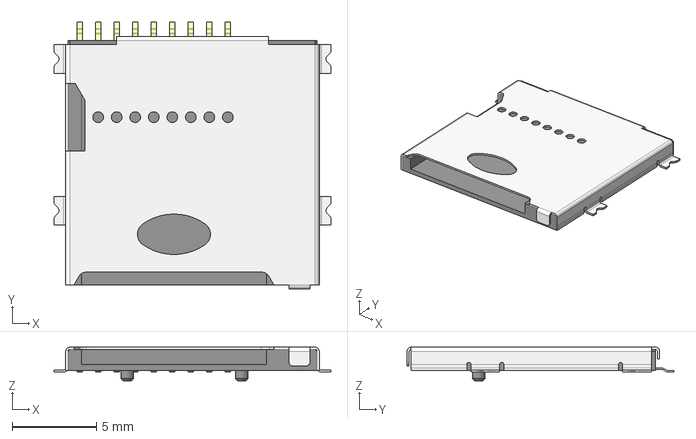
[picture p65: CAD file, 2025-04-04]
CAM_LATTICE_STM/LATTICE REFERENCE/logicbone-master/package3d/microsd-mem2075.step
16.4 x 15.8 x 2.00 mm
