SiwaNetwork/CASS/Корпус/Новая папка/Крышка 1.SLDPRT

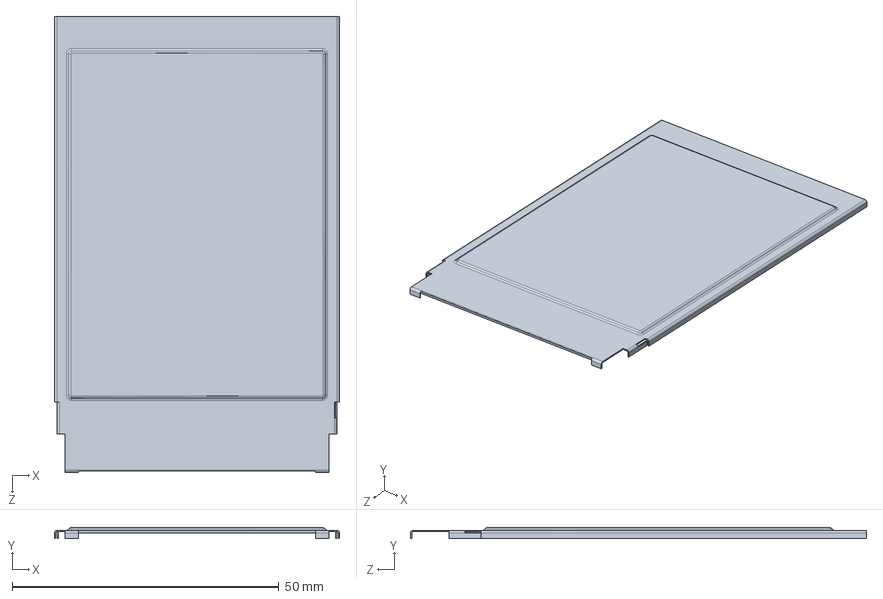
[picture p66: CAD file, 2024-09-22]
Корпус/Новая папка/Крышка 1.SLDPRT
53.5 x 2.00 x 85.5 mm
