SiwaNetwork/CASS/CAM_LATTICE_STM/LATTICE REFERENCE/logicbone-master/package3d/c-2199119-4-c-3d.stp

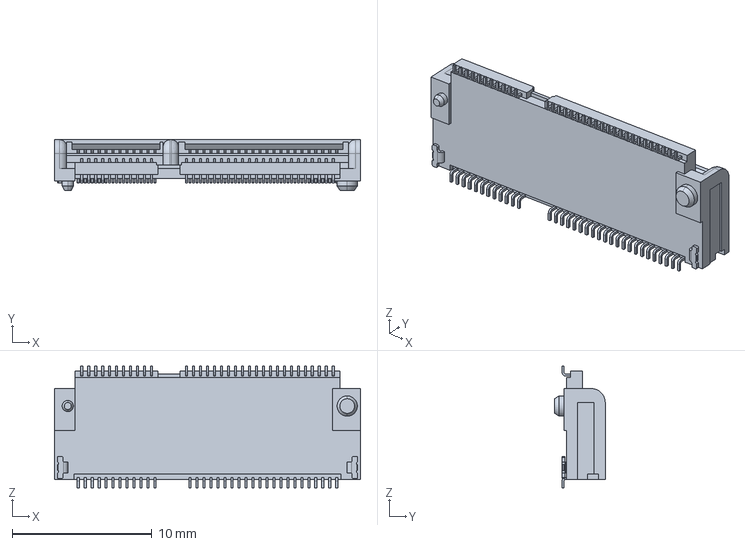
[picture p67: CAD file, 2025-04-04]
CAM_LATTICE_STM/LATTICE REFERENCE/logicbone-master/package3d/c-2199119-4-c-3d.stp
21.9 x 3.62 x 8.70 mm
