SiwaNetwork/CASS/Корпус/Новая папка/Лист.SLDPRT

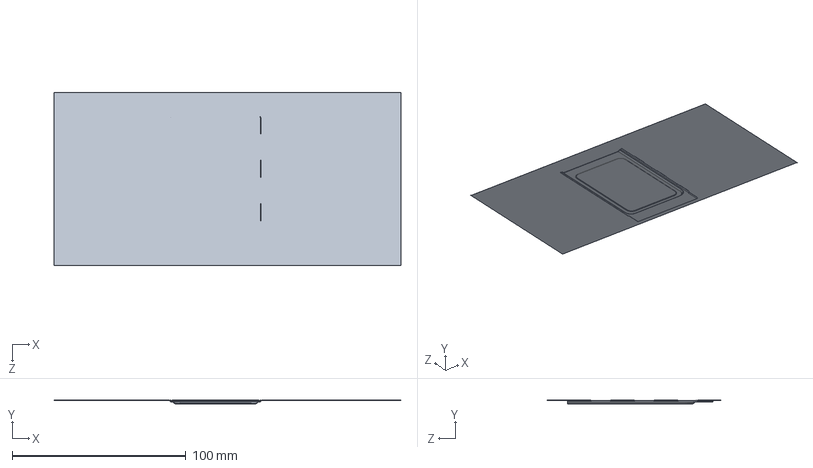
[picture p68: CAD file, 2024-09-22]
Корпус/Новая папка/Лист.SLDPRT
200.0 x 2.03 x 100.0 mm
