SiwaNetwork/CASS/Корпус/Новая папка/PCMCIA Mechanism, 5 mm, without Eject, with EMI Clip.SLDPRT

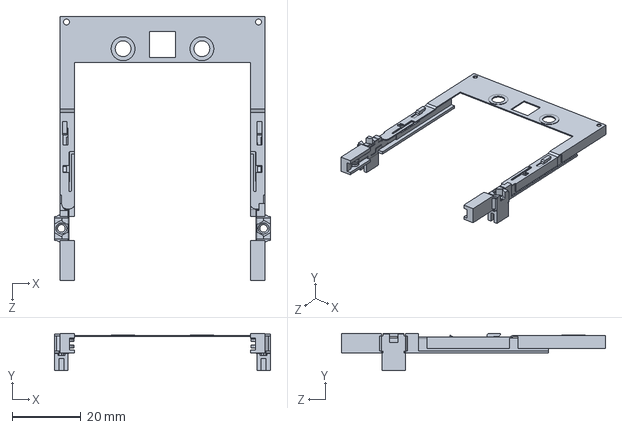
[picture p70: CAD file, 2024-09-22]
Корпус/Новая папка/PCMCIA Mechanism, 5 mm, without Eject, with EMI Clip.SLDPRT
63.0 x 10.9 x 77.0 mm
