SiwaNetwork/CASS/CAM_LATTICE_STM/LATTICE REFERENCE/logicbone-master/package3d/cabga-381-ecp5.step

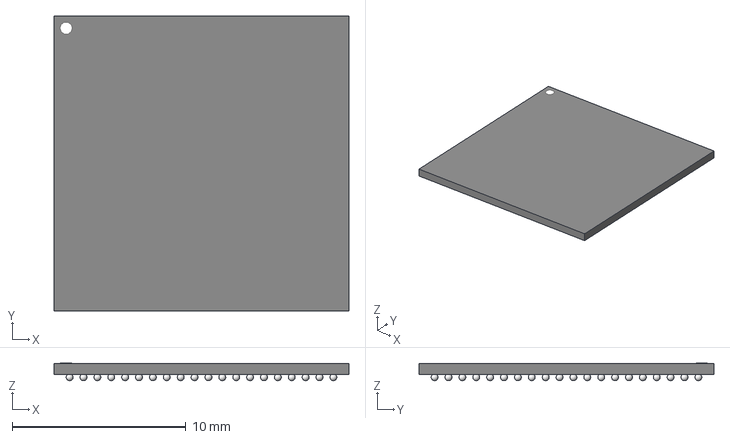
[picture p71: CAD file, 2025-04-04]
CAM_LATTICE_STM/LATTICE REFERENCE/logicbone-master/package3d/cabga-381-ecp5.step
17.0 x 17.0 x 1.01 mm
