SiwaNetwork/CASS/Корпус/Новая папка/Рамка 1.SLDPRT

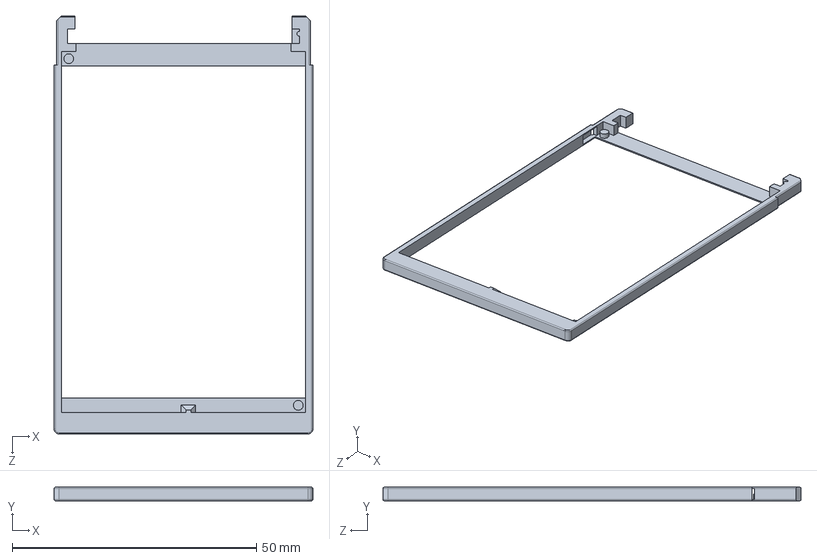
[picture p72: CAD file, 2024-09-22]
Корпус/Новая папка/Рамка 1.SLDPRT
53.0 x 2.80 x 85.6 mm
