SiwaNetwork/CASS/Корпус/Новая папка/Крышка 4.SLDPRT

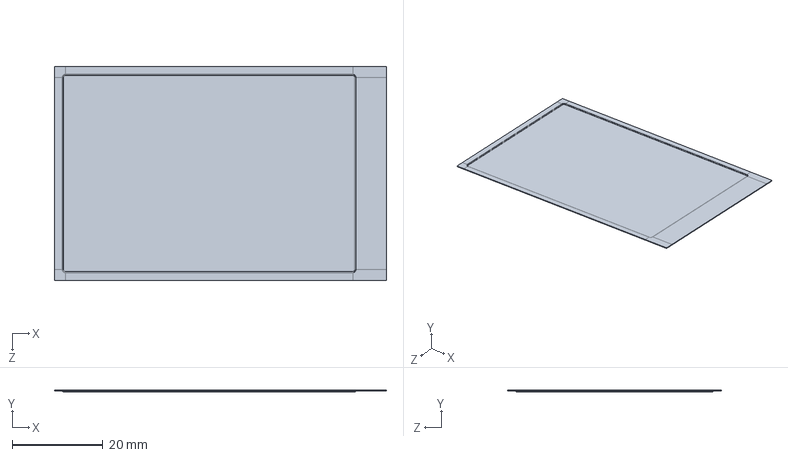
[picture p74: CAD file, 2024-09-22]
Корпус/Новая папка/Крышка 4.SLDPRT
73.0 x 0.4 x 47.0 mm
