SiwaNetwork/CASS/CAM_LATTICE_STM/LATTICE REFERENCE/logicbone-master/package3d/WSON10-2x2mm-EP.step

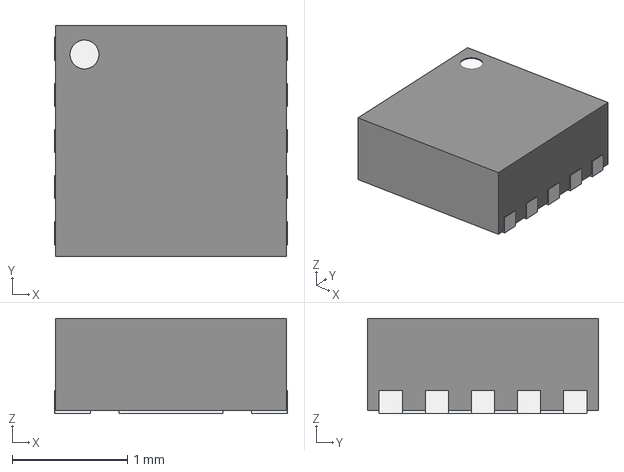
[picture p75: CAD file, 2025-04-04]
CAM_LATTICE_STM/LATTICE REFERENCE/logicbone-master/package3d/WSON10-2x2mm-EP.step
2.02 x 2.00 x 0.825 mm
