SiwaNetwork/CASS/CAM_LATTICE_STM/LATTICE REFERENCE/logicbone-master/package3d/c-2199230-4-b2-3d.stp

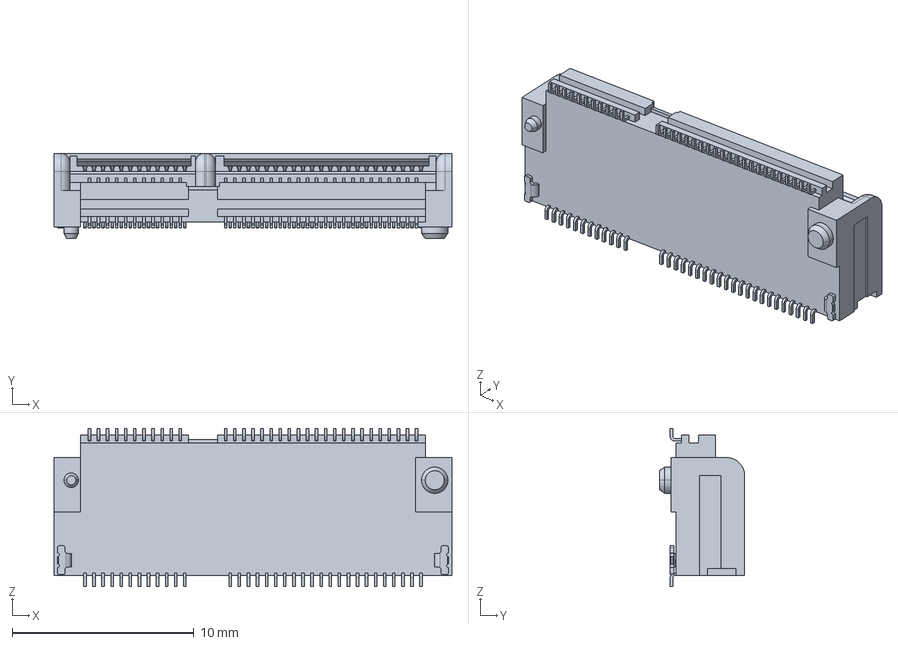
[picture p76: CAD file, 2025-04-04]
CAM_LATTICE_STM/LATTICE REFERENCE/logicbone-master/package3d/c-2199230-4-b2-3d.stp
21.9 x 4.70 x 8.70 mm
