SiwaNetwork/CASS/Корпус/Новая папка/Рамка 3.STEP

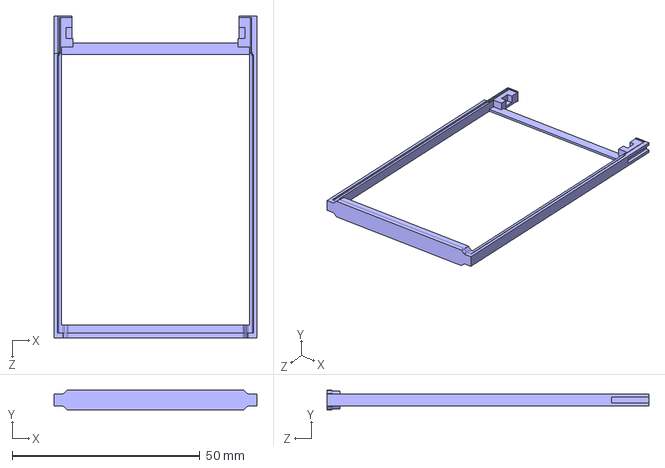
[picture p77: CAD file, 2024-09-13]
Корпус/Новая папка/Рамка 3.STEP
54.0 x 5.30 x 85.6 mm
