SiwaNetwork/CASS/CAM_LATTICE_STM/LATTICE REFERENCE/logicbone-master/package3d/dfn6-2x1.6mm.step

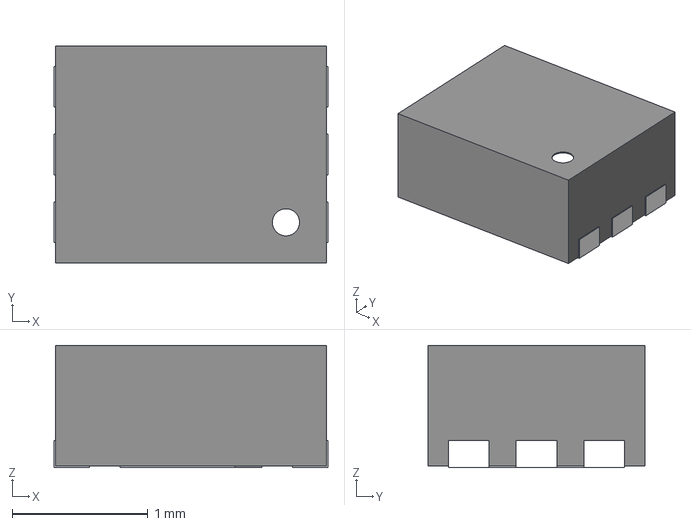
[picture p78: CAD file, 2025-04-04]
CAM_LATTICE_STM/LATTICE REFERENCE/logicbone-master/package3d/dfn6-2x1.6mm.step
2.02 x 1.60 x 0.9 mm
