SiwaNetwork/CASS/CAM_LATTICE_STM/LATTICE REFERENCE/logicbone-master/package3d/wurth-9774025360.step

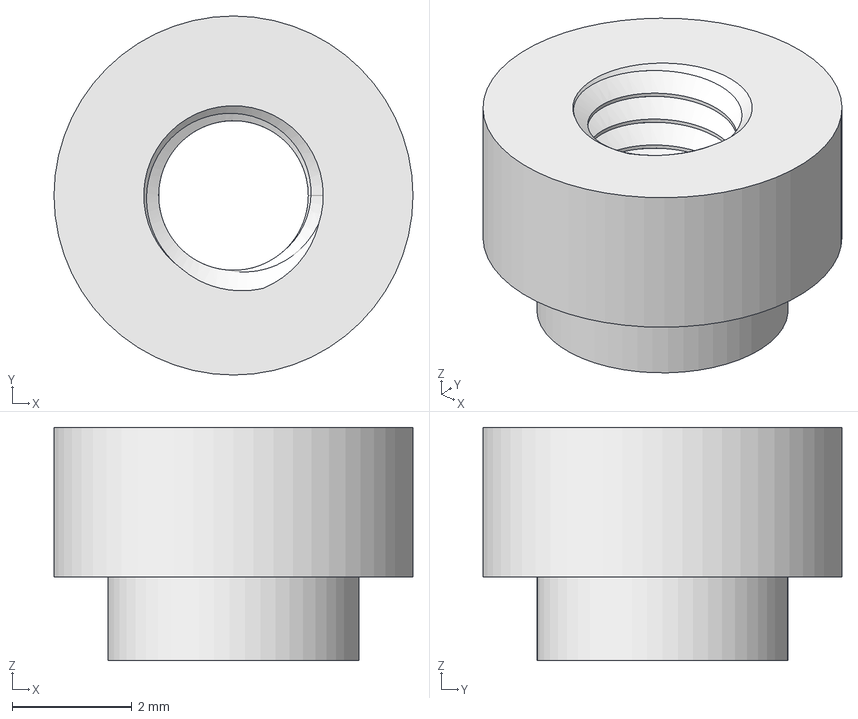
[picture p79: CAD file, 2025-04-04]
CAM_LATTICE_STM/LATTICE REFERENCE/logicbone-master/package3d/wurth-9774025360.step
6.00 x 6.00 x 3.90 mm
