SiwaNetwork/CASS/CAM_LATTICE_STM/LATTICE REFERENCE/logicbone-master/package3d/wlcsp12-p04mm.step

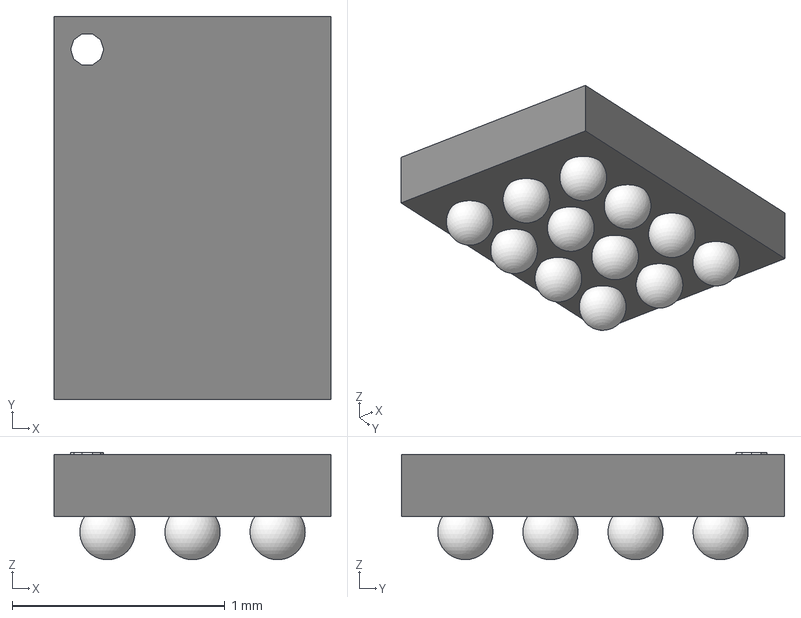
[picture p80: CAD file, 2025-04-04]
CAM_LATTICE_STM/LATTICE REFERENCE/logicbone-master/package3d/wlcsp12-p04mm.step
1.30 x 1.80 x 0.505 mm
