SiwaNetwork/CASS/(list of files, cad)

Other CAD files:
CAM_LATTICE_STM/LATTICE REFERENCE/ul_LFE5U-45F-7BG256I/caBGA256_LAT.step
КД и ЭД/КД оснастка/Плита _ ТЕНШ.741428.001/Плита_ТЕНШ.741428.001.stp
КД и ЭД/КД оснастка/Модели/Плита для рамки 6 мульти.stp
Корпус/Новая папка/PCMCIA Connectors 5535651-1(1).SLDPRT
КД и ЭД/КД оснастка/Модели/Штырь.stp
Корпус/PCMCIA/03.002 Крышка (для выреза из рамки).SLDPRT
Корпус/Новая папка/PCMCIA Connectors 5146547-1(1).SLDPRT
Корпус/Новая папка/Крышка 3.STEP
CAM_LATTICE_STM/LATTICE REFERENCE/logicbone-master/package3d/1054500101.stp
CAM_LATTICE_STM/LATTICE REFERENCE/logicbone-master/package3d/arjm11b1-502.fcstd
CAM_LATTICE_STM/LATTICE REFERENCE/logicbone-master/package3d/bb-pin-header-2x23.FCStd
CAM_LATTICE_STM/LATTICE REFERENCE/logicbone-master/package3d/microsd-mem2075.fcstd
CAM_LATTICE_STM/LATTICE REFERENCE/logicbone-master/package3d/usb4085.fcstd
CAM_LATTICE_STM/LATTICE REFERENCE/logicbone-master/package3d/usb4110.fcstd
БИБЛИОТЕКА/EP4CE22E22C8N/Allegro/qfp50p2200x2200x165-145n.psm
БИБЛИОТЕКА/EP4CE22E22C8N/DEHDL/ep4ce22e22c8n/chips/chips.prt
БИБЛИОТЕКА/LIB_SN74CBTD3384CDBR/SN74CBTD3384CDBR/Allegro/sop65p780x200-24n.psm
БИБЛИОТЕКА/LIB_SN74CBTD3384CDBR/SN74CBTD3384CDBR/DEHDL/sn74cbtd3384cdbr/chips/chips.prt
БИБЛИОТЕКА/XC3S400-4TQ144C/Allegro/qfp50p2200x2200x160-144n.psm
БИБЛИОТЕКА/XC3S400-4TQ144C/DEHDL/xc3s400_4tq144c/chips/chips.prt
Корпус/03.002 Крышка.SLDDRW
Корпус/03.002 Крышка.SLDPRT
Корпус/Новая папка/Крышка 3.SLDDRW
Корпус/Новая папка/Крышка 3.SLDPRT
Корпус/Новая папка/Рамка 3.SLDDRW
Корпус/Новая папка/Рамка 3.SLDPRT
