SiwaNetwork/CASS/CAM_LATTICE_STM/LATTICE REFERENCE/logicbone-master/ddr3-tuning.ods

 | Inner Speed | Outer Speed
 | 6.7972 | 5.54599 | ps/mm
Net | Inner1 | Outer1 | Time1 | Error1 | Inner2 | Outer2 | Time2 | Error2
DDR3_CLK | 22.043 | 0 | 149.8306796 | 0 | 10.494 | 0 | 221.1604964 | 0
DDR3_A0 | 20.581 | 0 | 139.8931732 | -9.93750639999999 | 10.765 | 0 | 213.0650312 | -8.09546519999998
DDR3_A1 | 19.318 | 0 | 131.3083096 | -18.52237 | 10.197 | 0.8 | 205.05615 | -16.1043464
DDR3_A2 | 19.318 | 0 | 131.3083096 | -18.52237 | 11.57 | 1.6 | 218.8254976 | -2.33499879999999
DDR3_A3 | 22.145 | 0 | 150.523994 | 0.693314399999991 | 0 | 10.197 | 207.07645403 | -14.08404237
DDR3_A4 | 21.718 | 0 | 147.6215896 | -2.20909 | 12.577 | 0 | 233.109974 | 11.9494776
DDR3_A5 | 22.347 | 0 | 151.8970284 | 2.06634880000001 | 12.696 | 0 | 238.1942796 | 17.0337832
DDR3_A6 | 0 | 25.003 | 138.66638797 | -11.16429163 | 9.963 | 0 | 206.38689157 | -14.77360483
DDR3_A7 | 22.625 | 0 | 153.78665 | 3.95597040000001 | 0 | 12.694 | 224.18744706 | 3.02695066000001
DDR3_A8 | 24.333 | 0 | 165.3962676 | 15.565588 | 0 | 11.386 | 228.54290974 | 7.38241333999997
DDR3_A9 | 23.533 | 0 | 159.9585076 | 10.127828 | 11.04 | 0 | 234.9995956 | 13.8390992
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
