SiwaNetwork/CASS/CAM-ALTERA_STM/CAM_DVB-CI SCH 2024-03-08 16-16.PDF

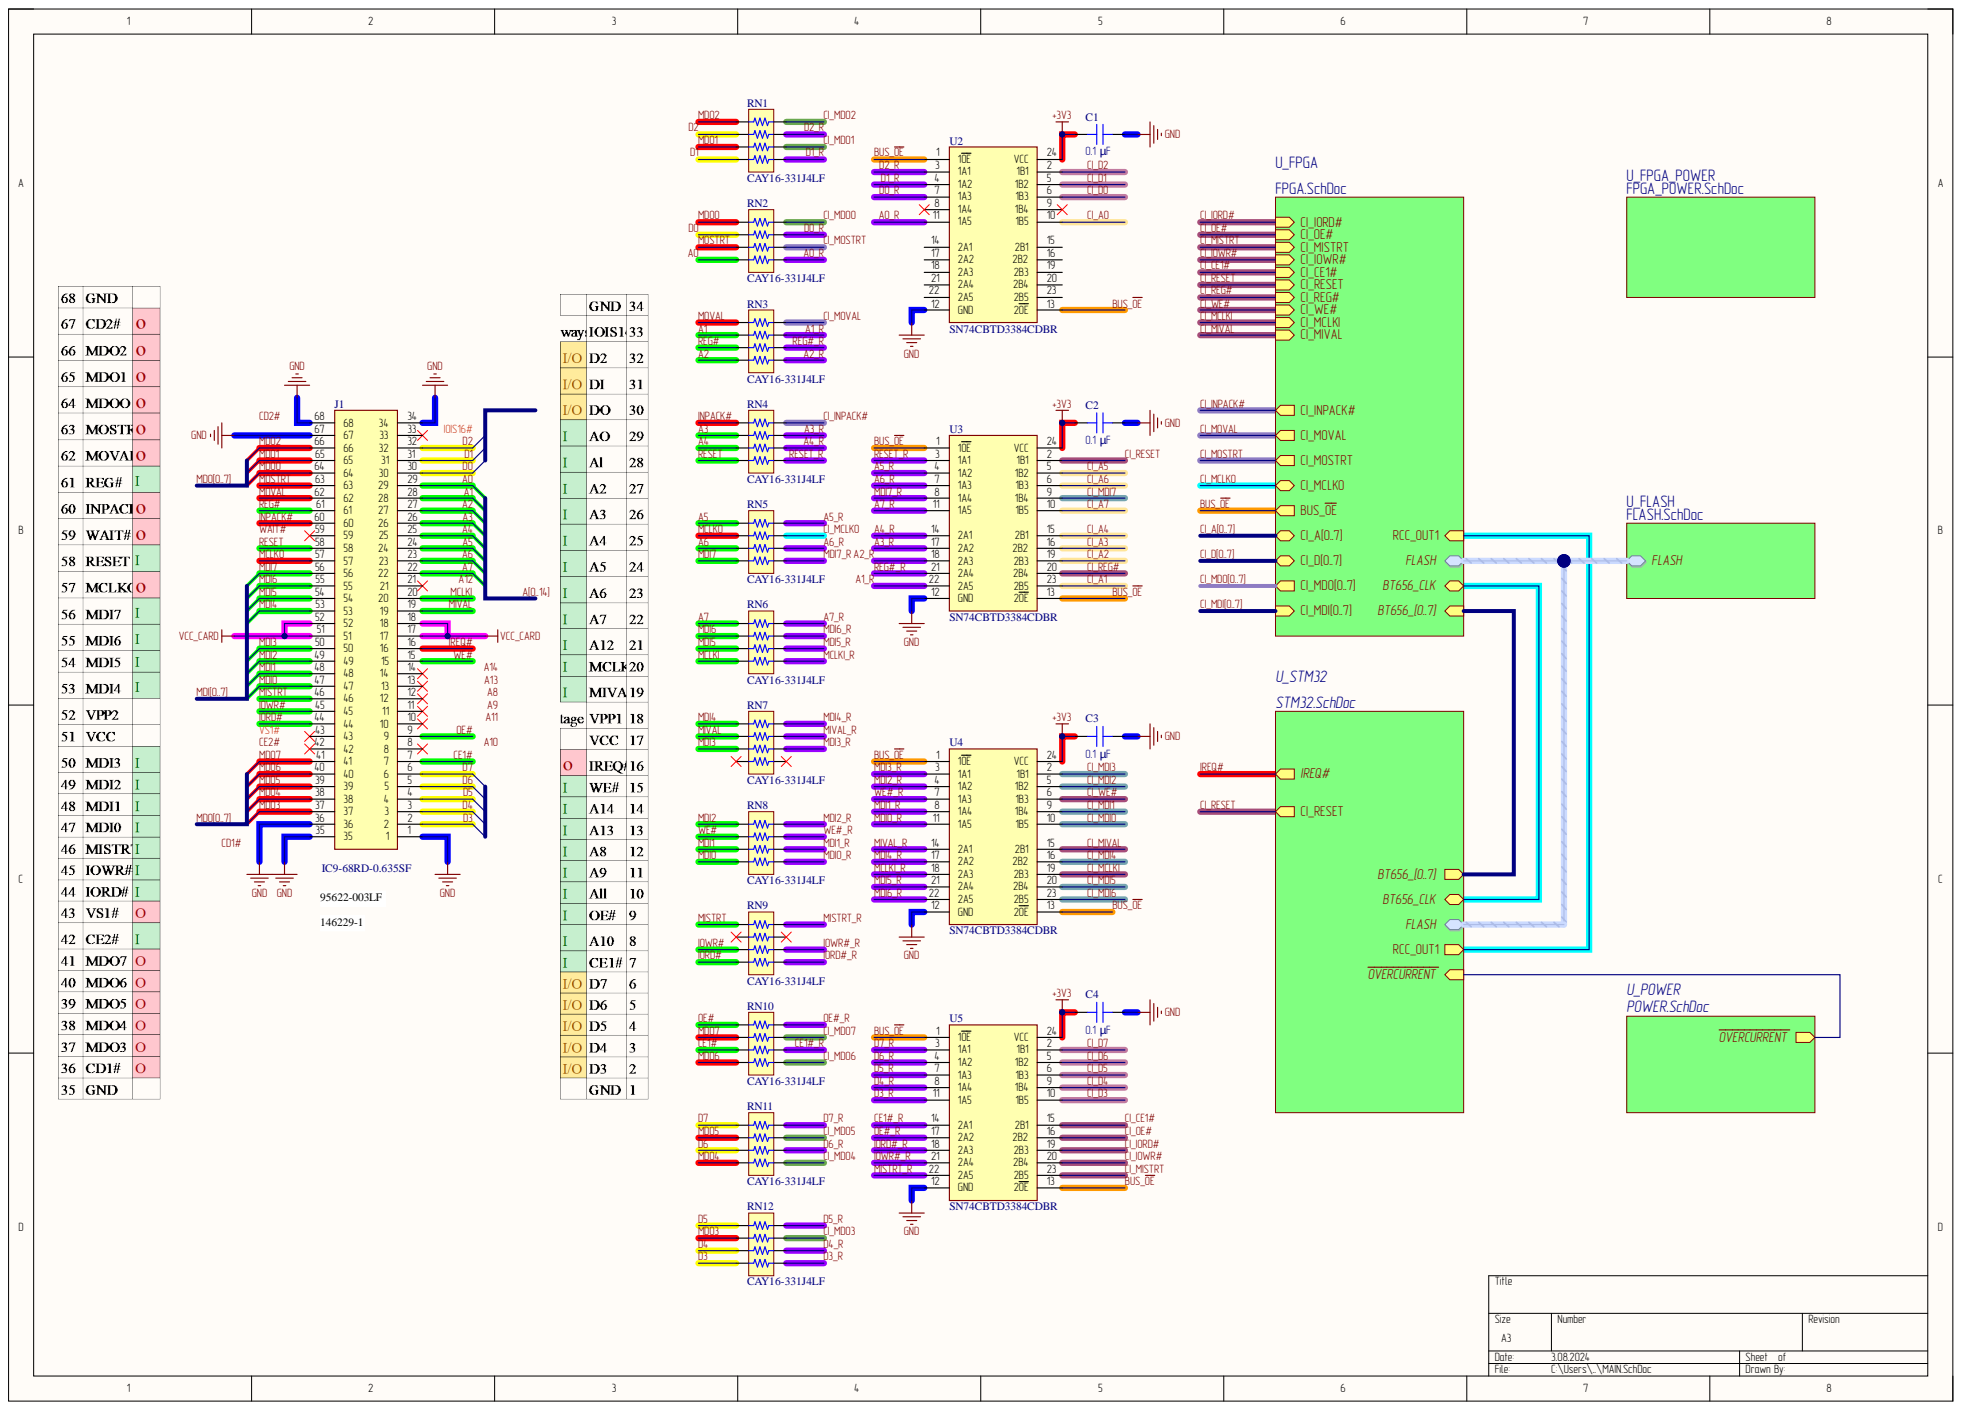
[picture p81: page 1]

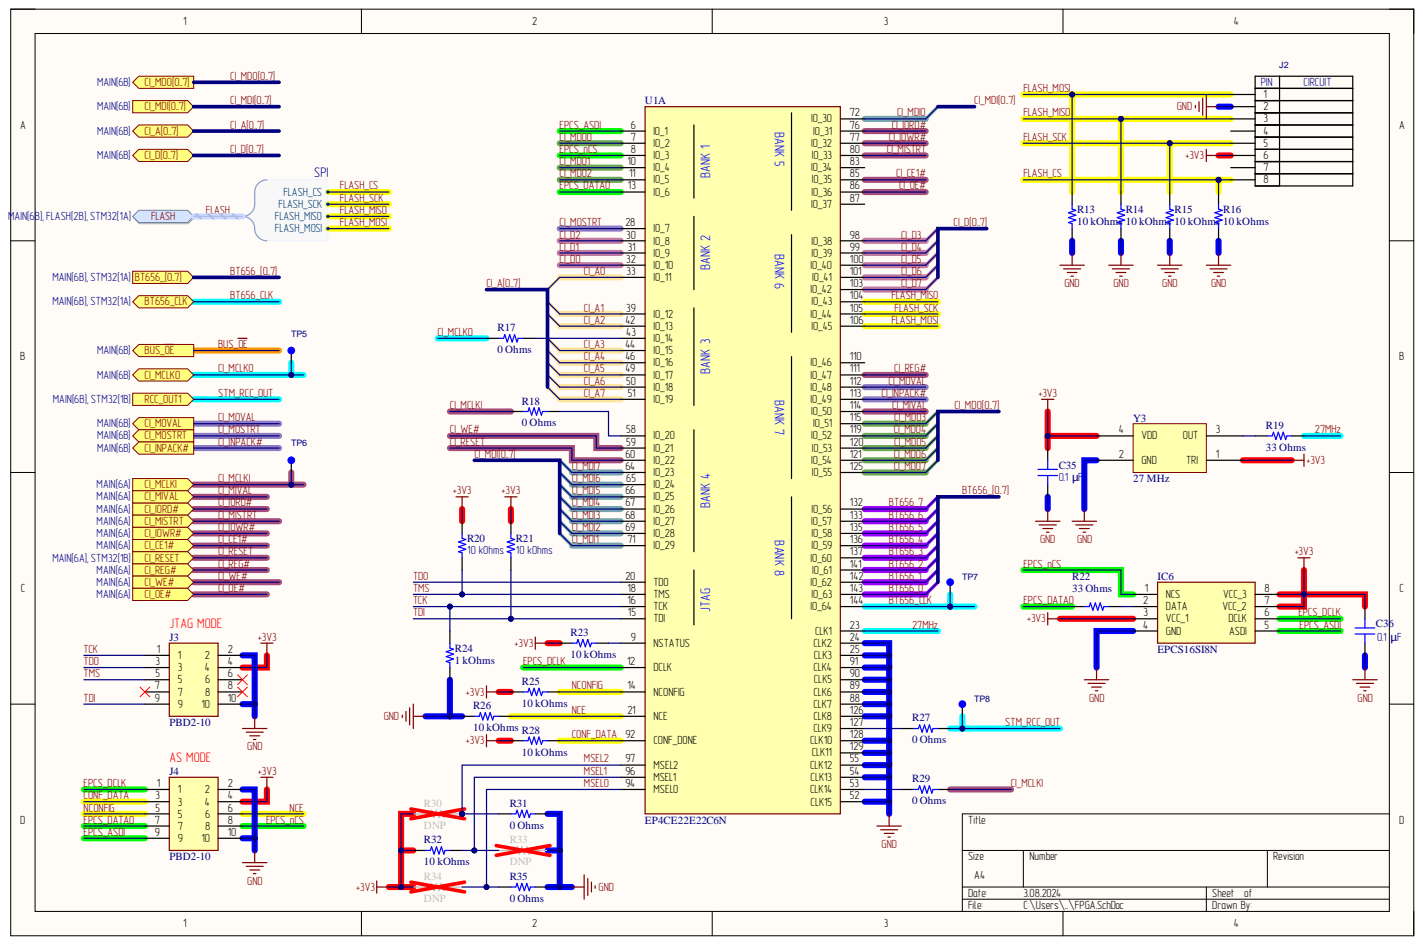
[picture p82: page 2]

BANK 5 BANK 6 BANK 7 BANK 8

BANK 1 BANK 2 BANK 3 BANK 4

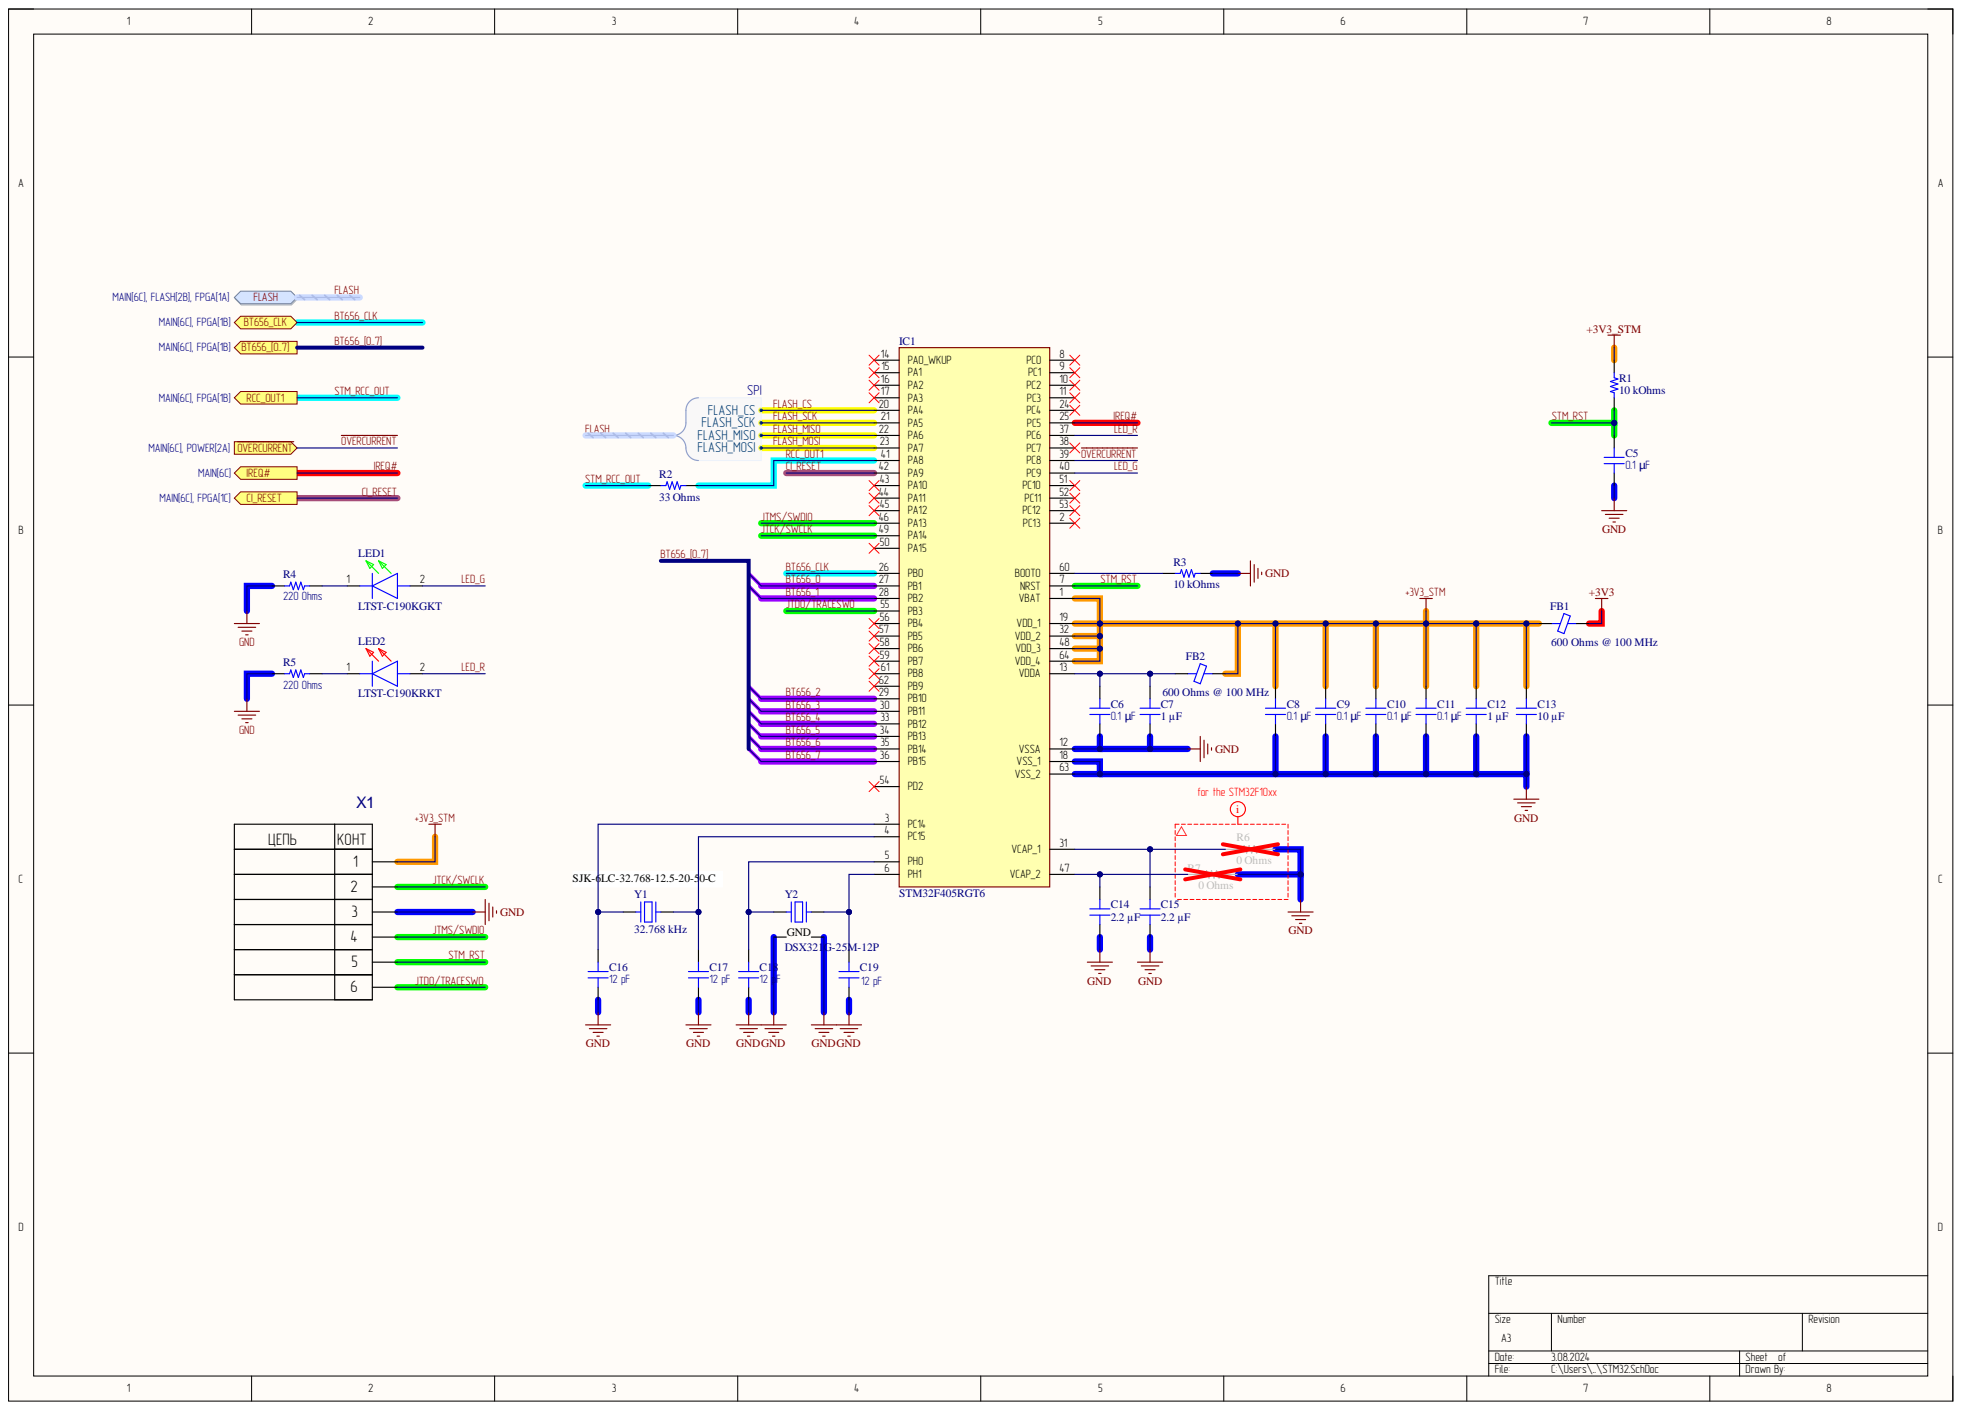
[picture p83: page 3]

4 7 | R 7 Ohm | 0 Ohm s

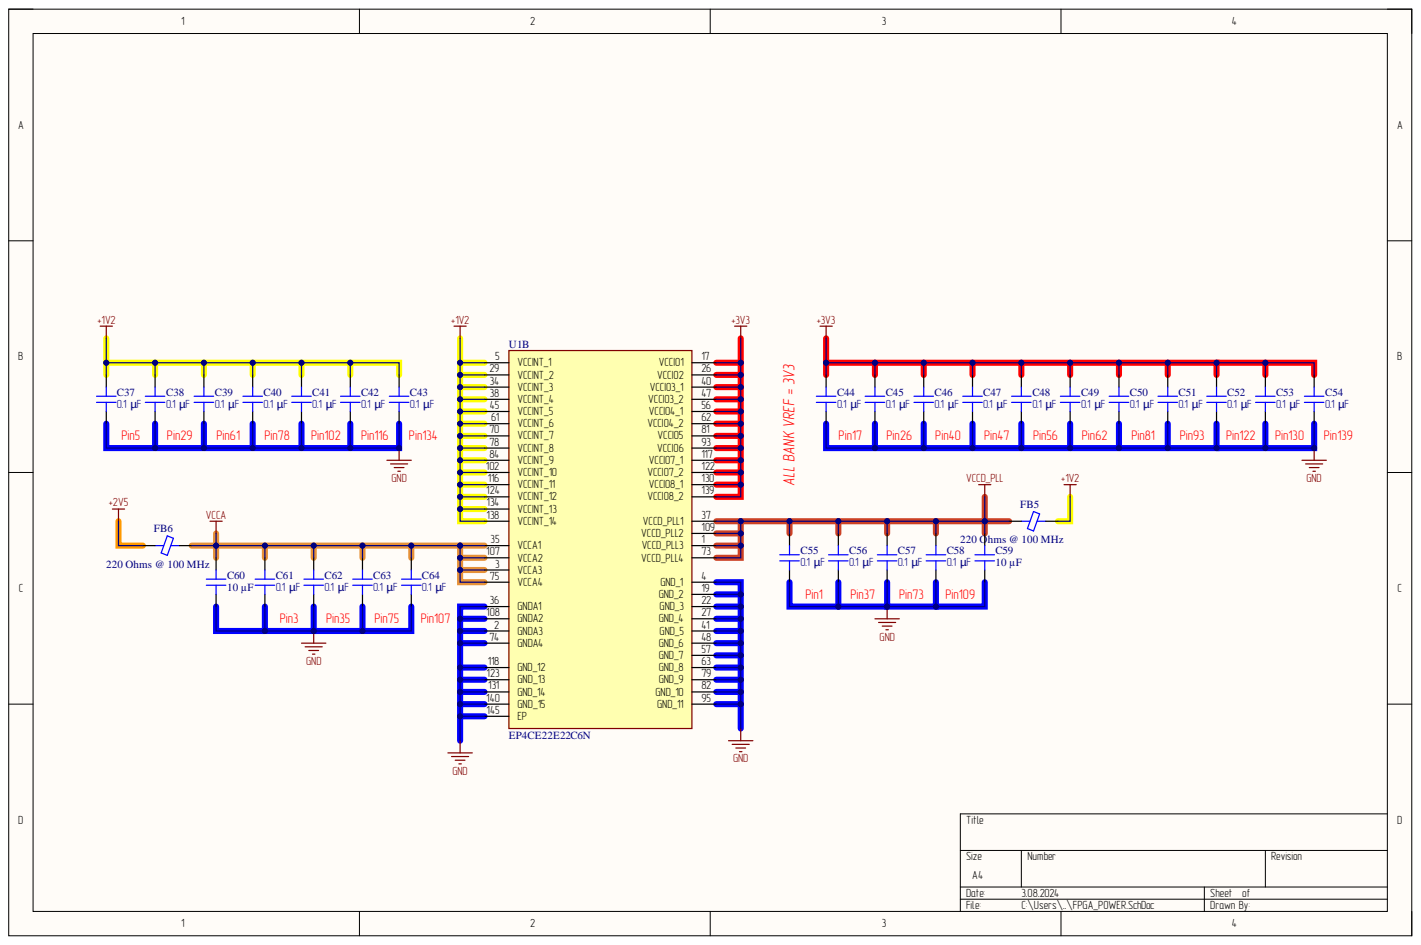
[picture p84: page 4]

VCCA3 3

Pin1 | Pin37 | Pin73 | Pin109

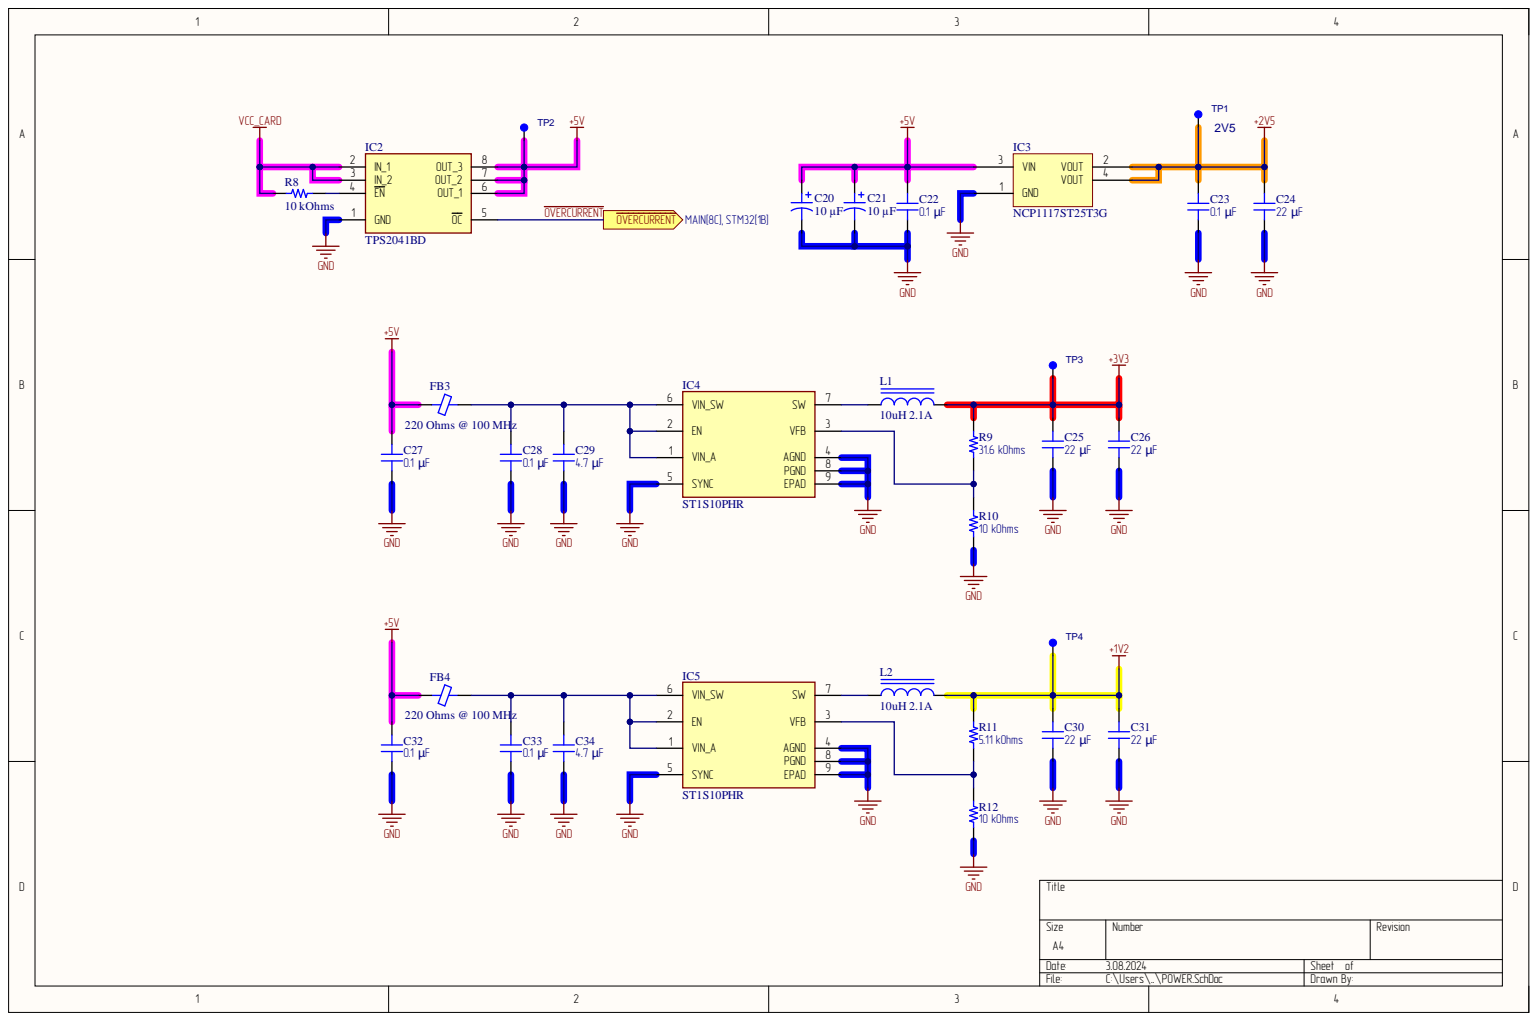
[picture p85: page 5]

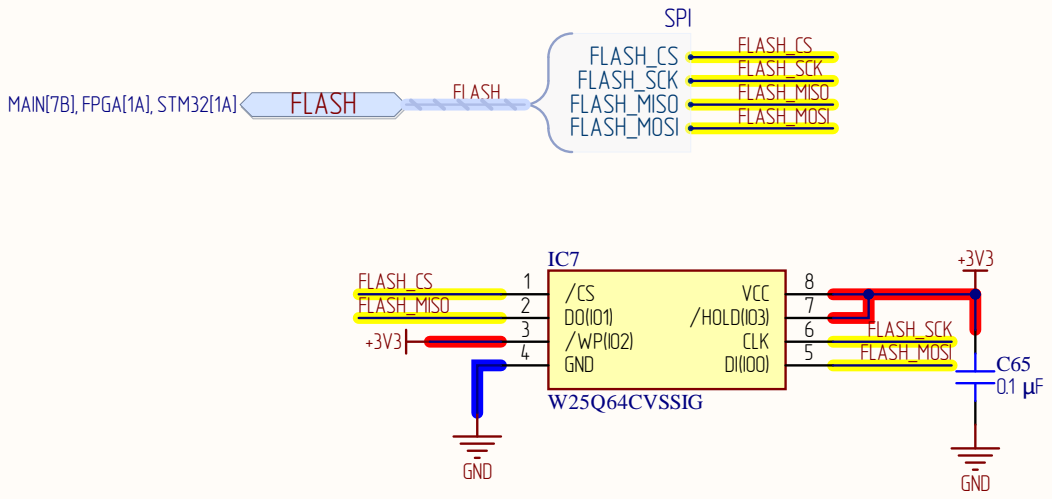
[picture p86: page 6]
