SiwaNetwork/CASS/CAM_STAND/ECAD/Project Outputs for CAM_STAND_v1/CAM_STAND_v1_rev.1.0_ SCH 2025-04-14 14-09.PDF

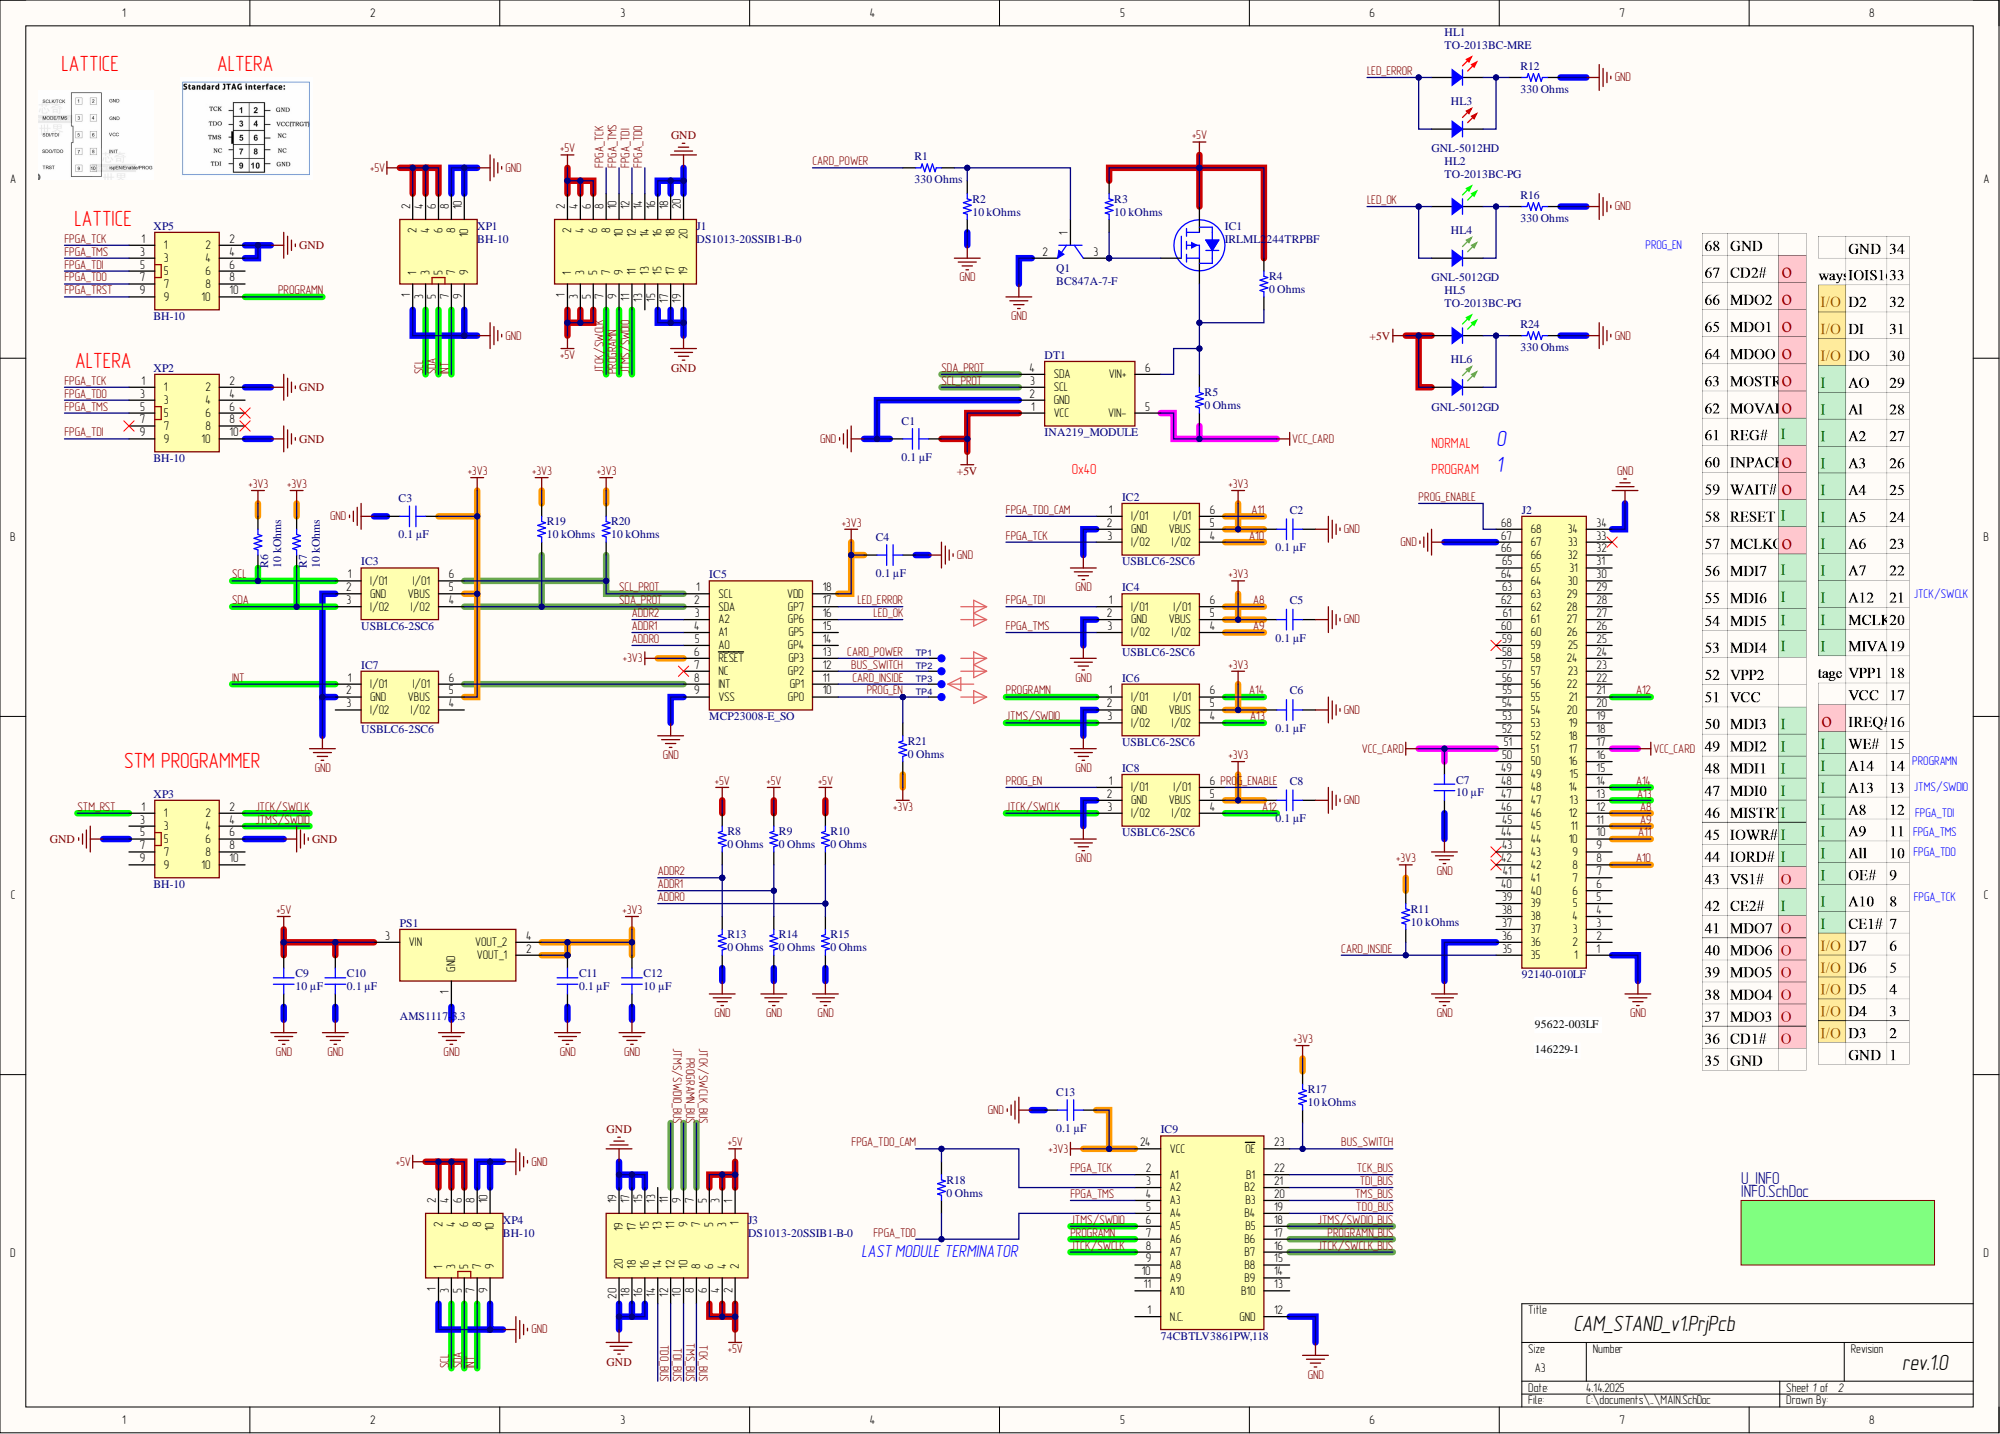
[picture p87: page 1]

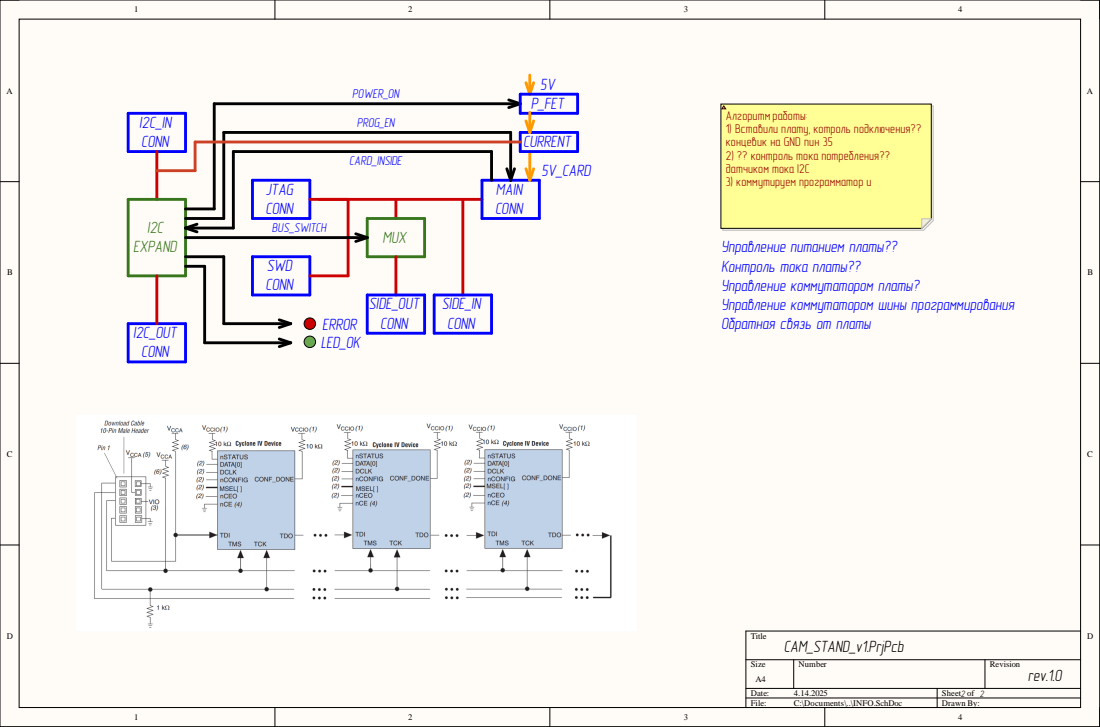
[picture p88: page 2]

Алгоритм работы:
1) Вставили плату, котроль подключения??
концевик на GND пин 35
2) ?? контроль тока потребления??
датчиком тока I2C
3) коммутируем программатор и

Управление питанием платы??
Контроль тока платы??
Управление коммутатором платы?
Управление коммутатором шины программирования
Обратная связь от платы
