SiwaNetwork/CASS/CAM_STAND/ECAD/Project Outputs for CAM_STAND_v1/CAM_STAND_v1_rev.1.4_ SCH 2025-02-20 19-13.PDF

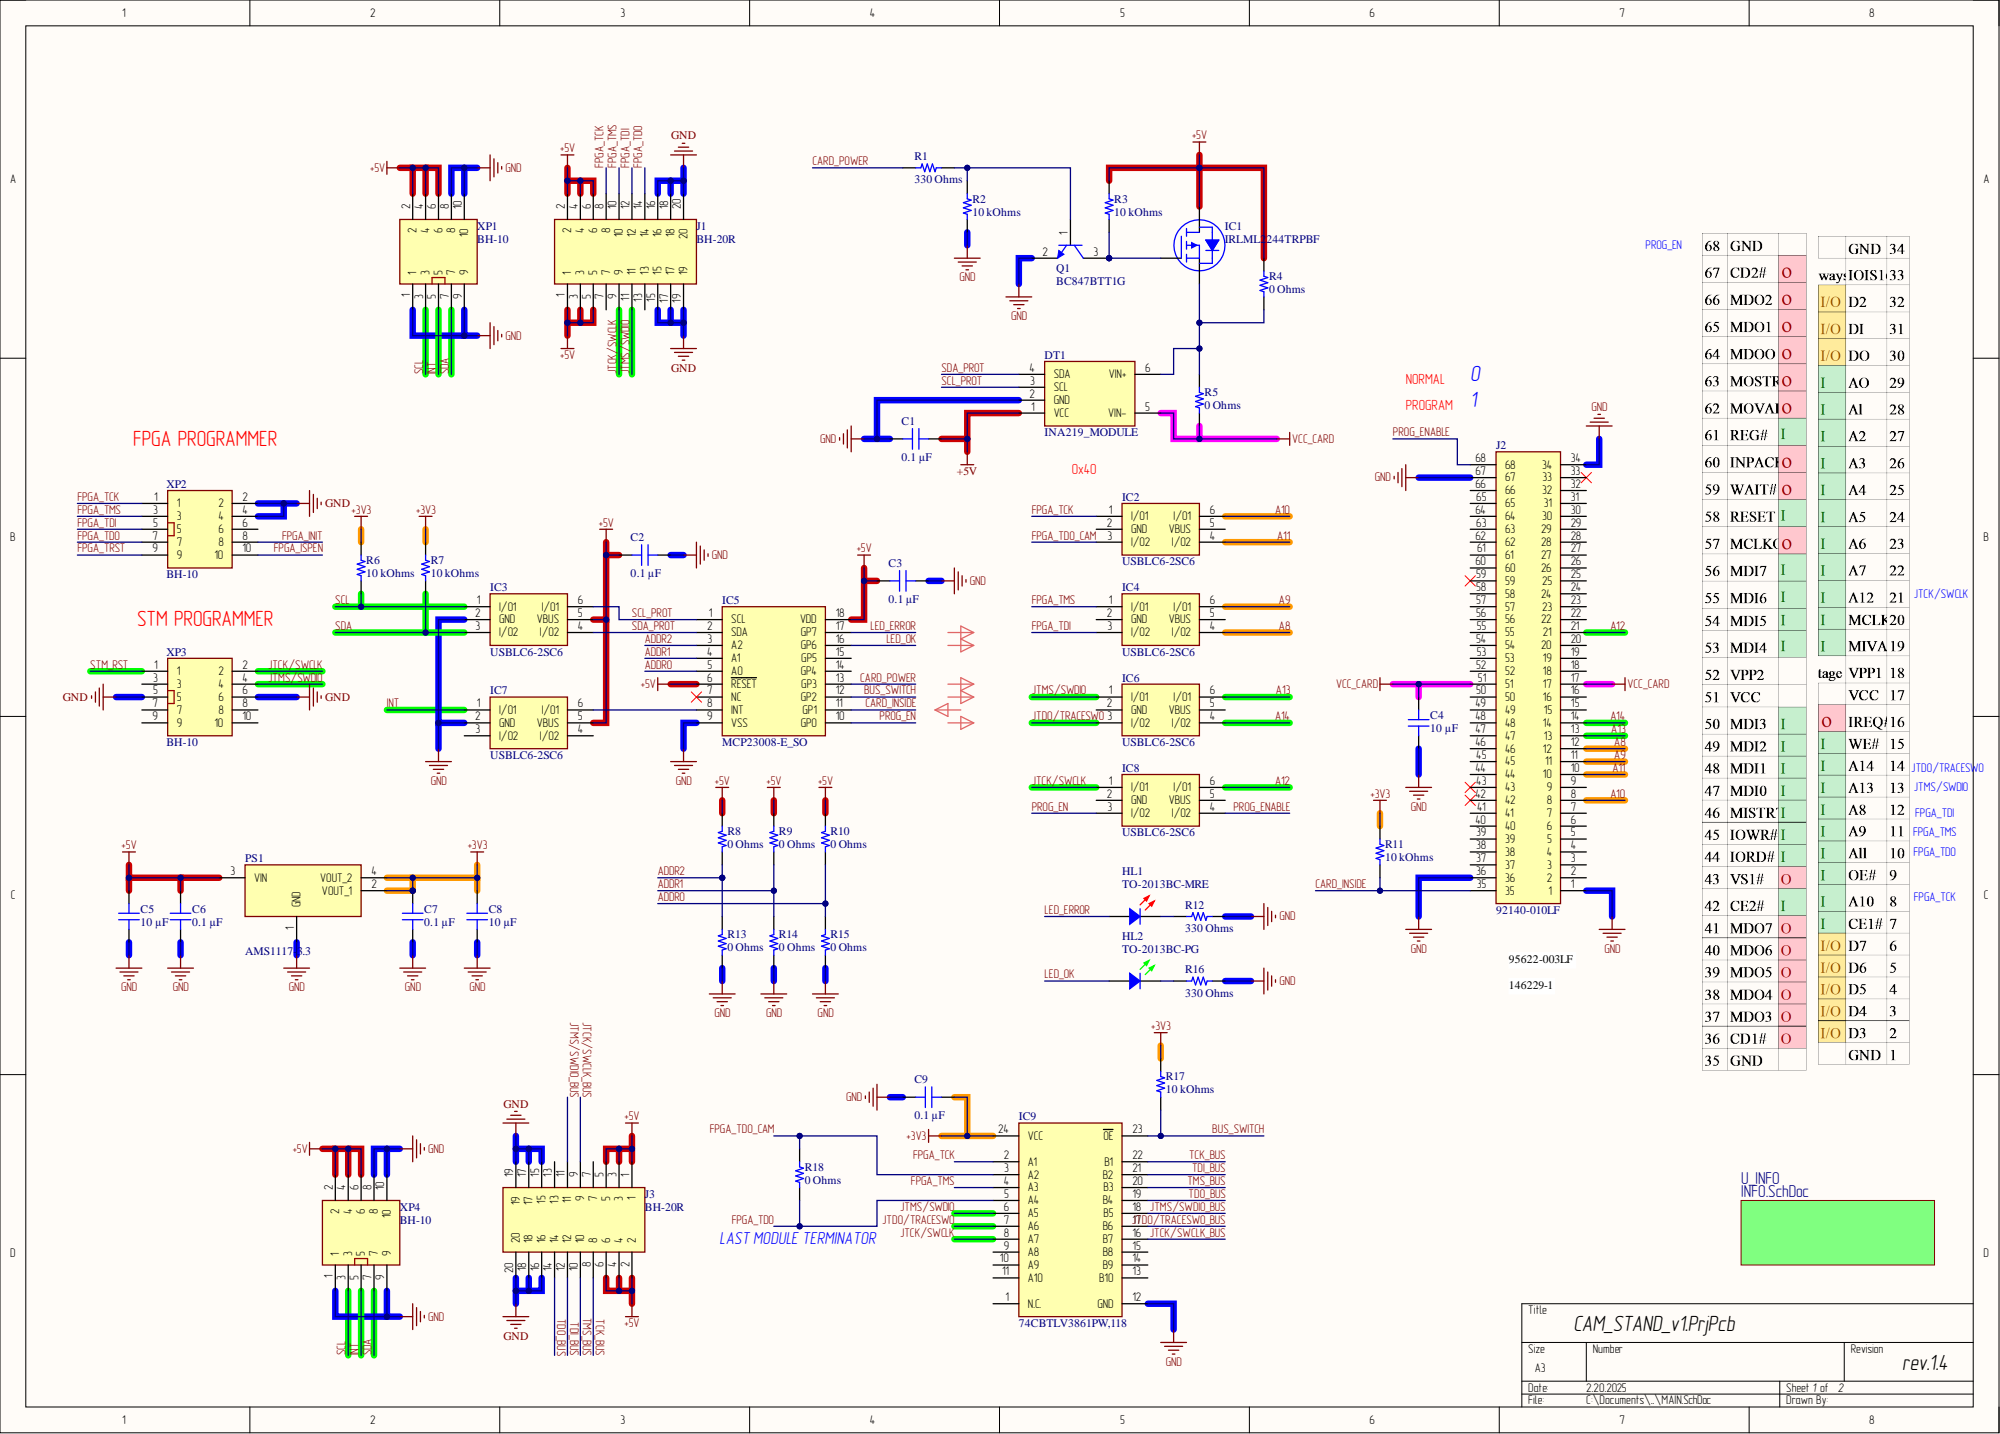
[picture p89: page 1]

I/O2 3 | SDA 2

ADDR2 | A2 3 | LED_OK

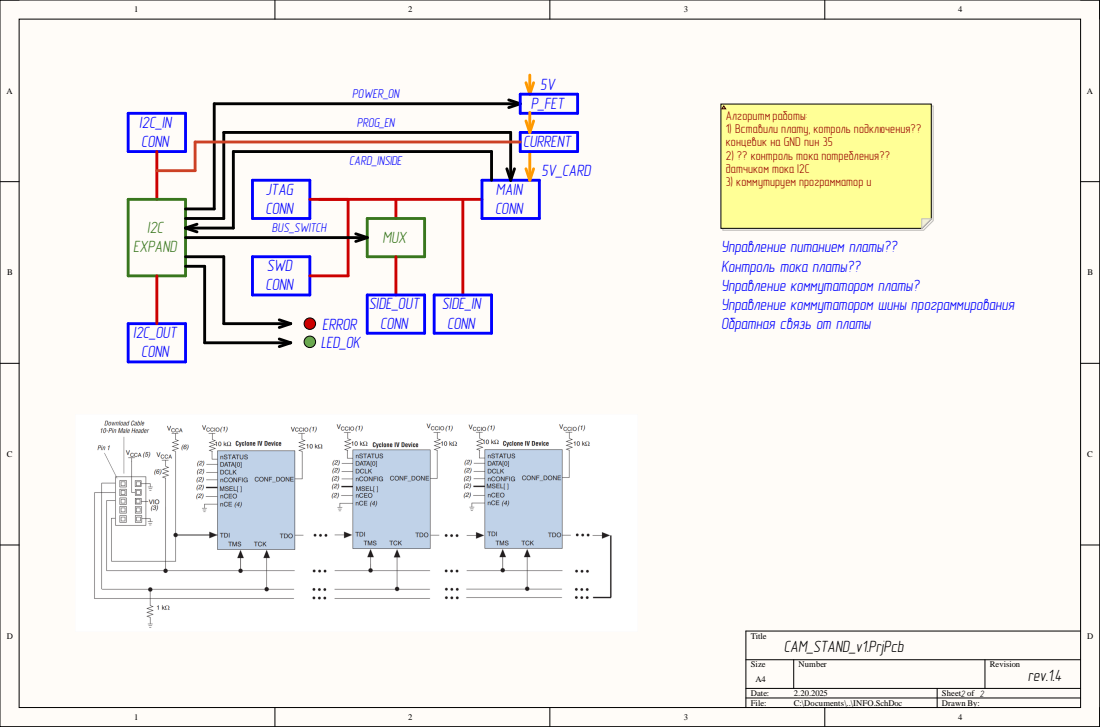
[picture p90: page 2]

Алгоритм работы:
1) Вставили плату, котроль подключения??
концевик на GND пин 35
2) ?? контроль тока потребления??
датчиком тока I2C
3) коммутируем программатор и

Управление питанием платы??
Контроль тока платы??
Управление коммутатором платы?
Управление коммутатором шины программирования
Обратная связь от платы
