SiwaNetwork/CASS/Корпус/PCMCIA/Документы/83808-21111lf.pdf

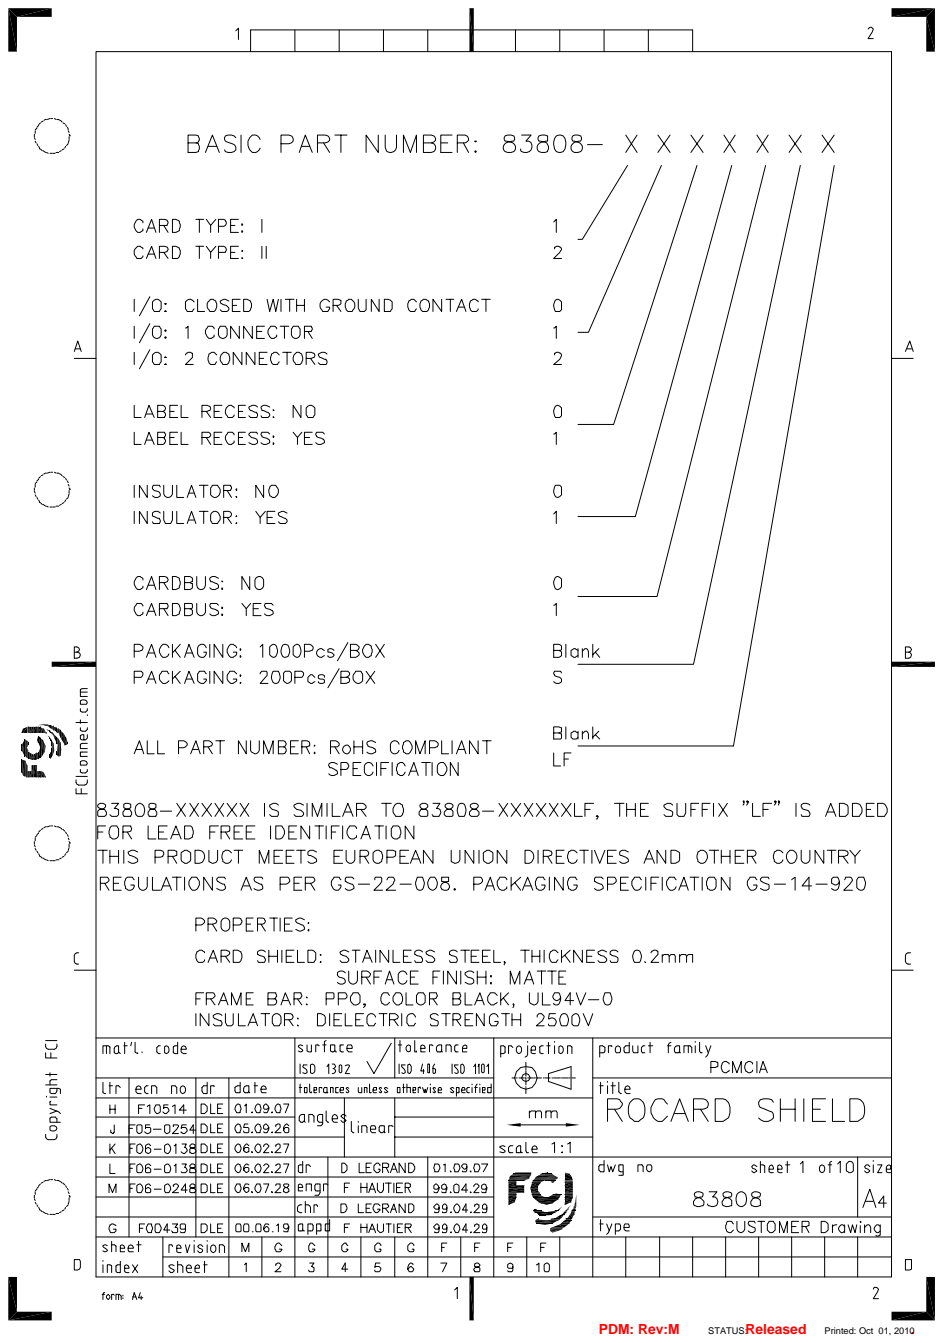
[picture p91: page 1]
PDM: Rev:M; Released; . STATUS:; Printed: Oct 01, 2010

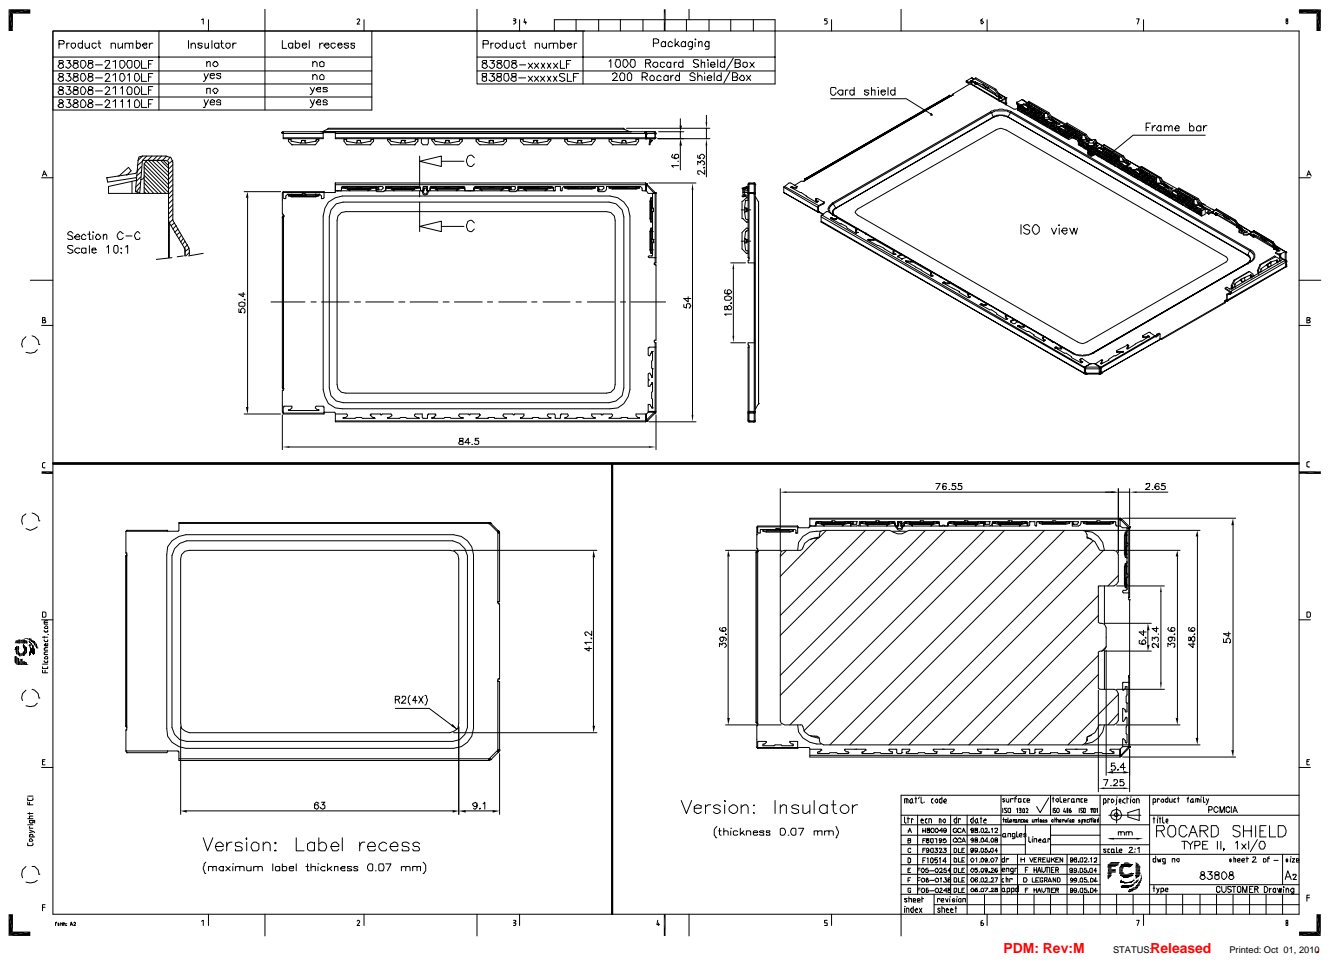
[picture p92: page 2]

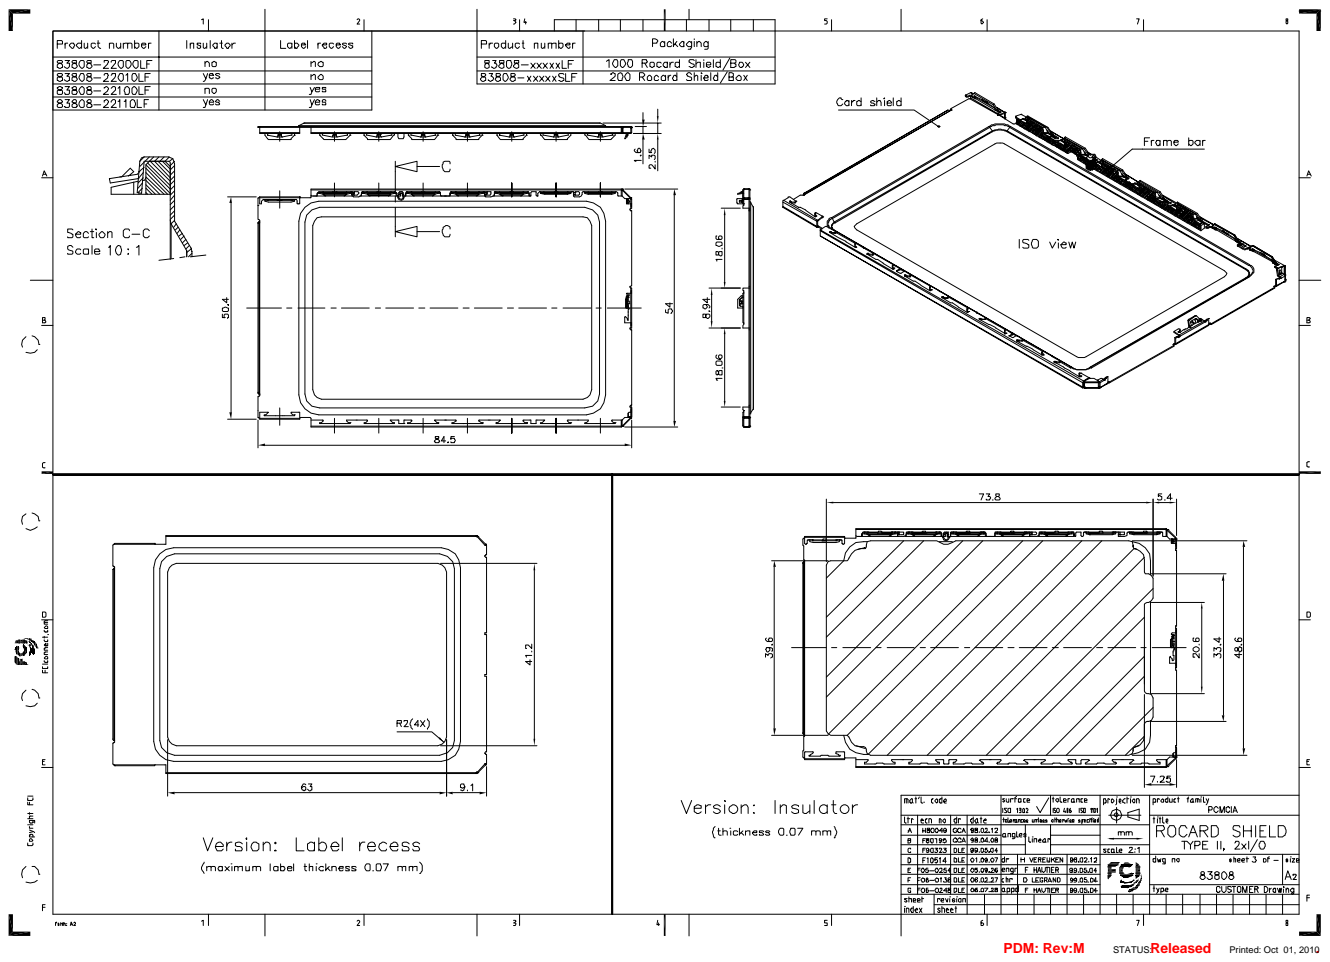
[picture p93: page 3]

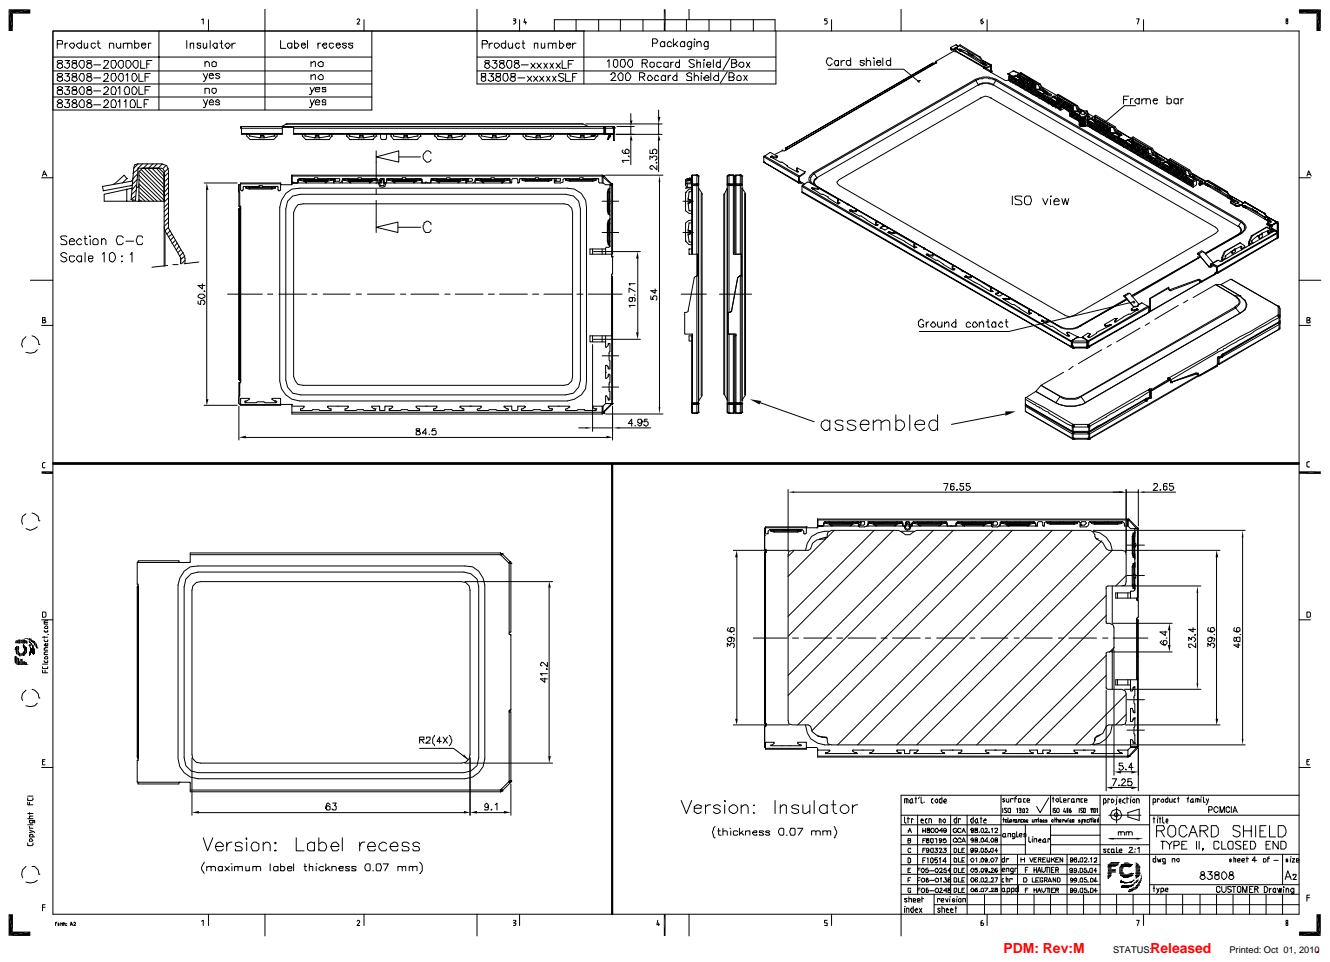
[picture p94: page 4]

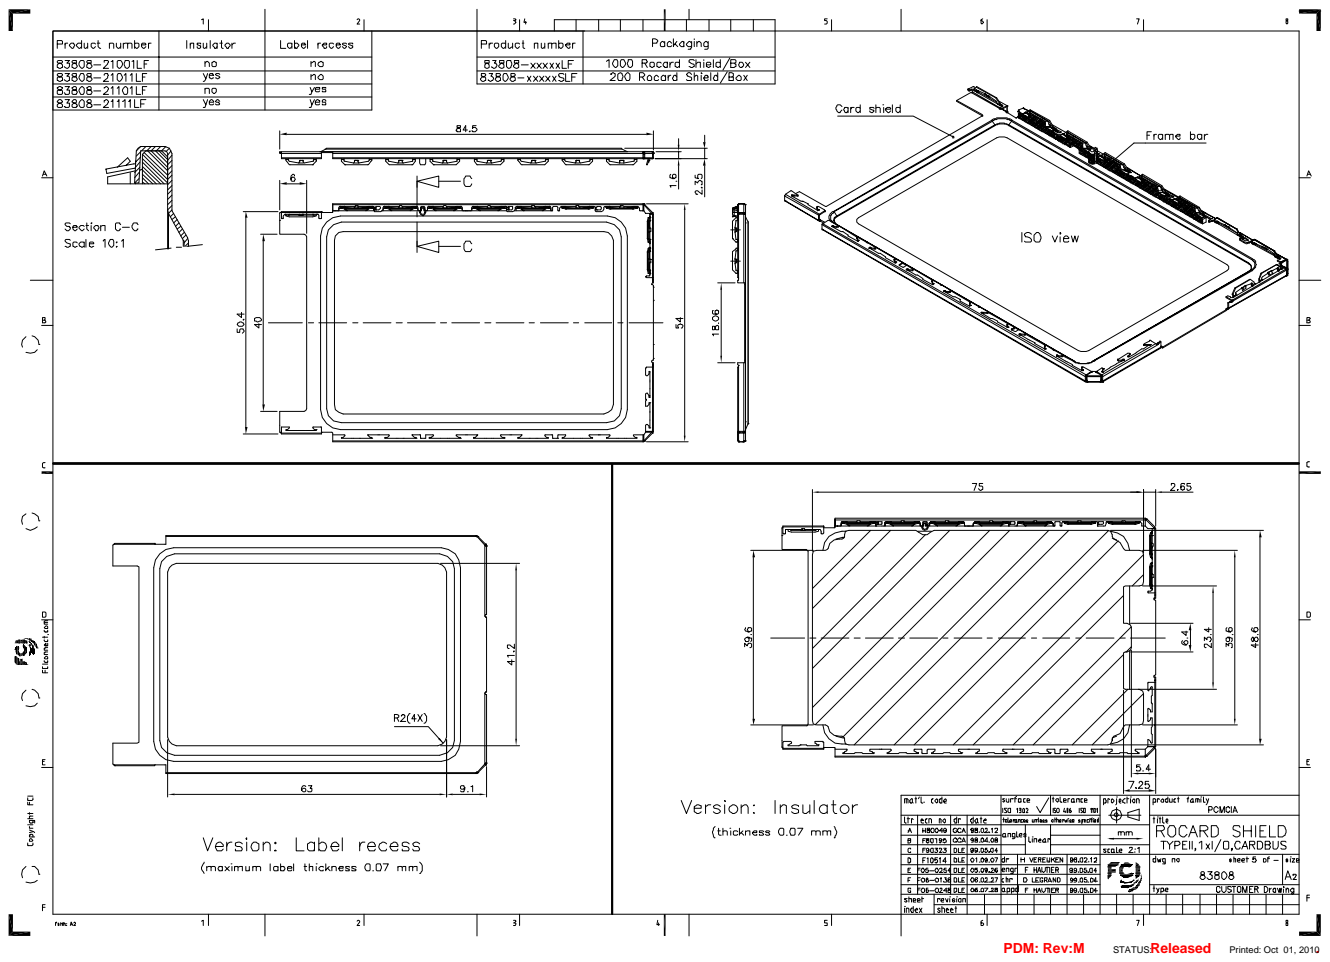
[picture p95: page 5]

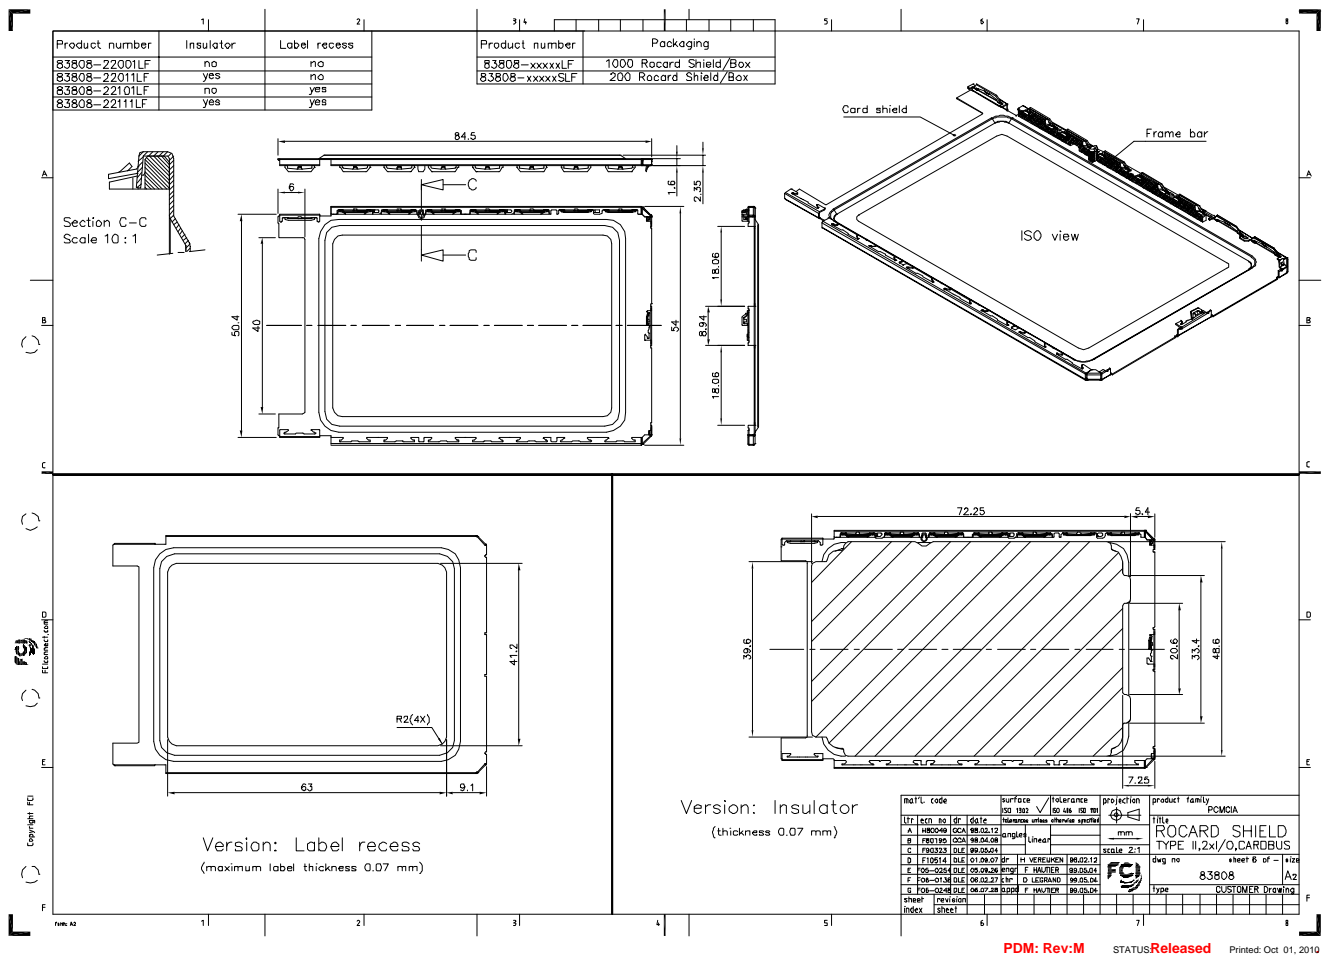
[picture p96: page 6]

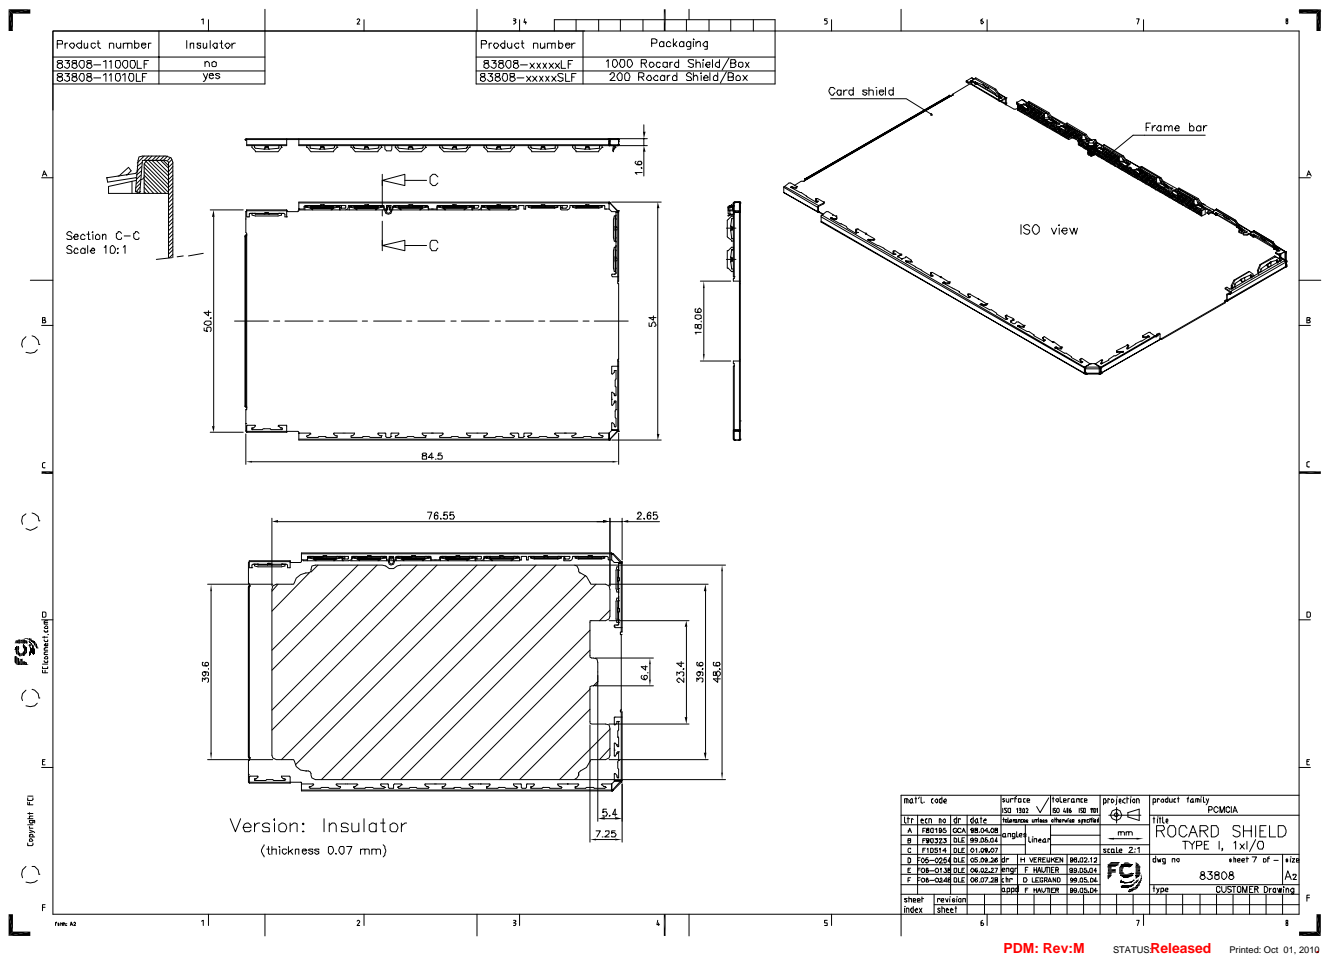
[picture p97: page 7]

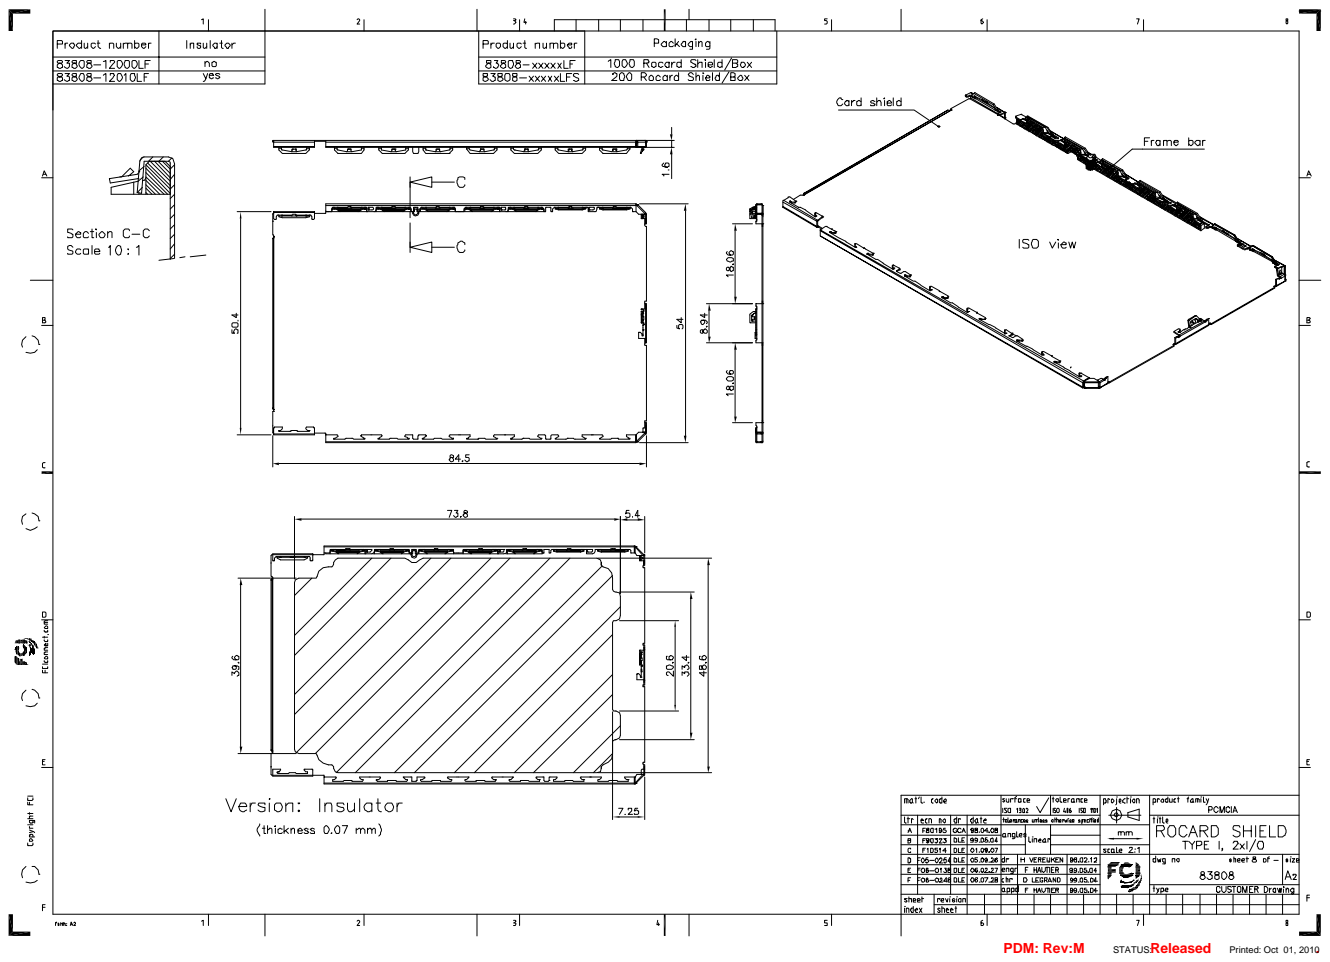
[picture p98: page 8]

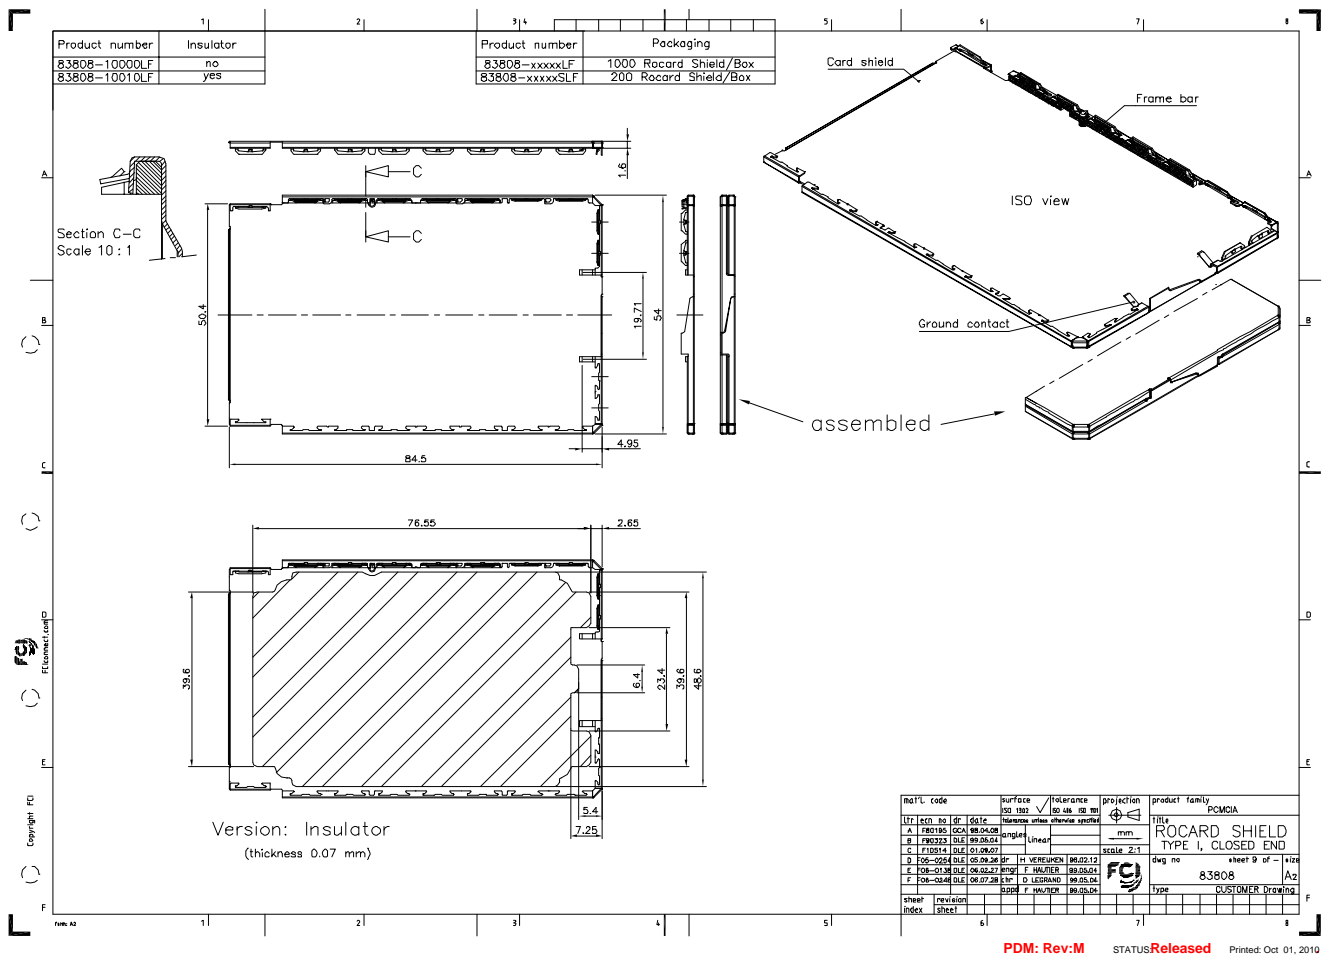
[picture p99: page 9]

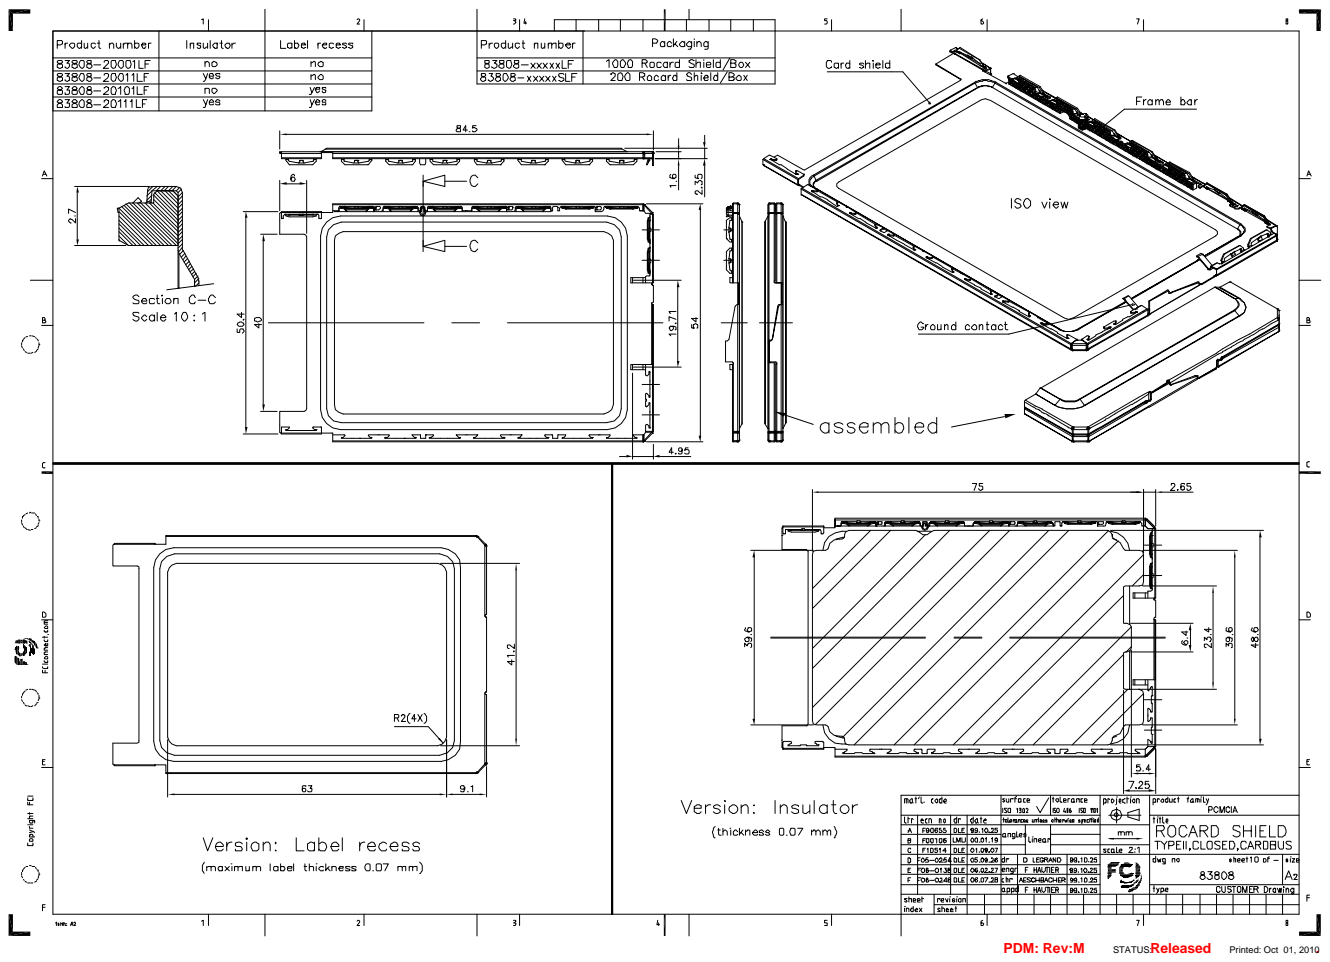
[picture p100: page 10]
