SiwaNetwork/CASS/CAM-ALTERA_STM/V1.4/ECAD/Project Outputs for CAM_DVB-CI_v1.4/CAM_DVB-CI_v1.4_ SCH 2025-03-16 23-31.PDF

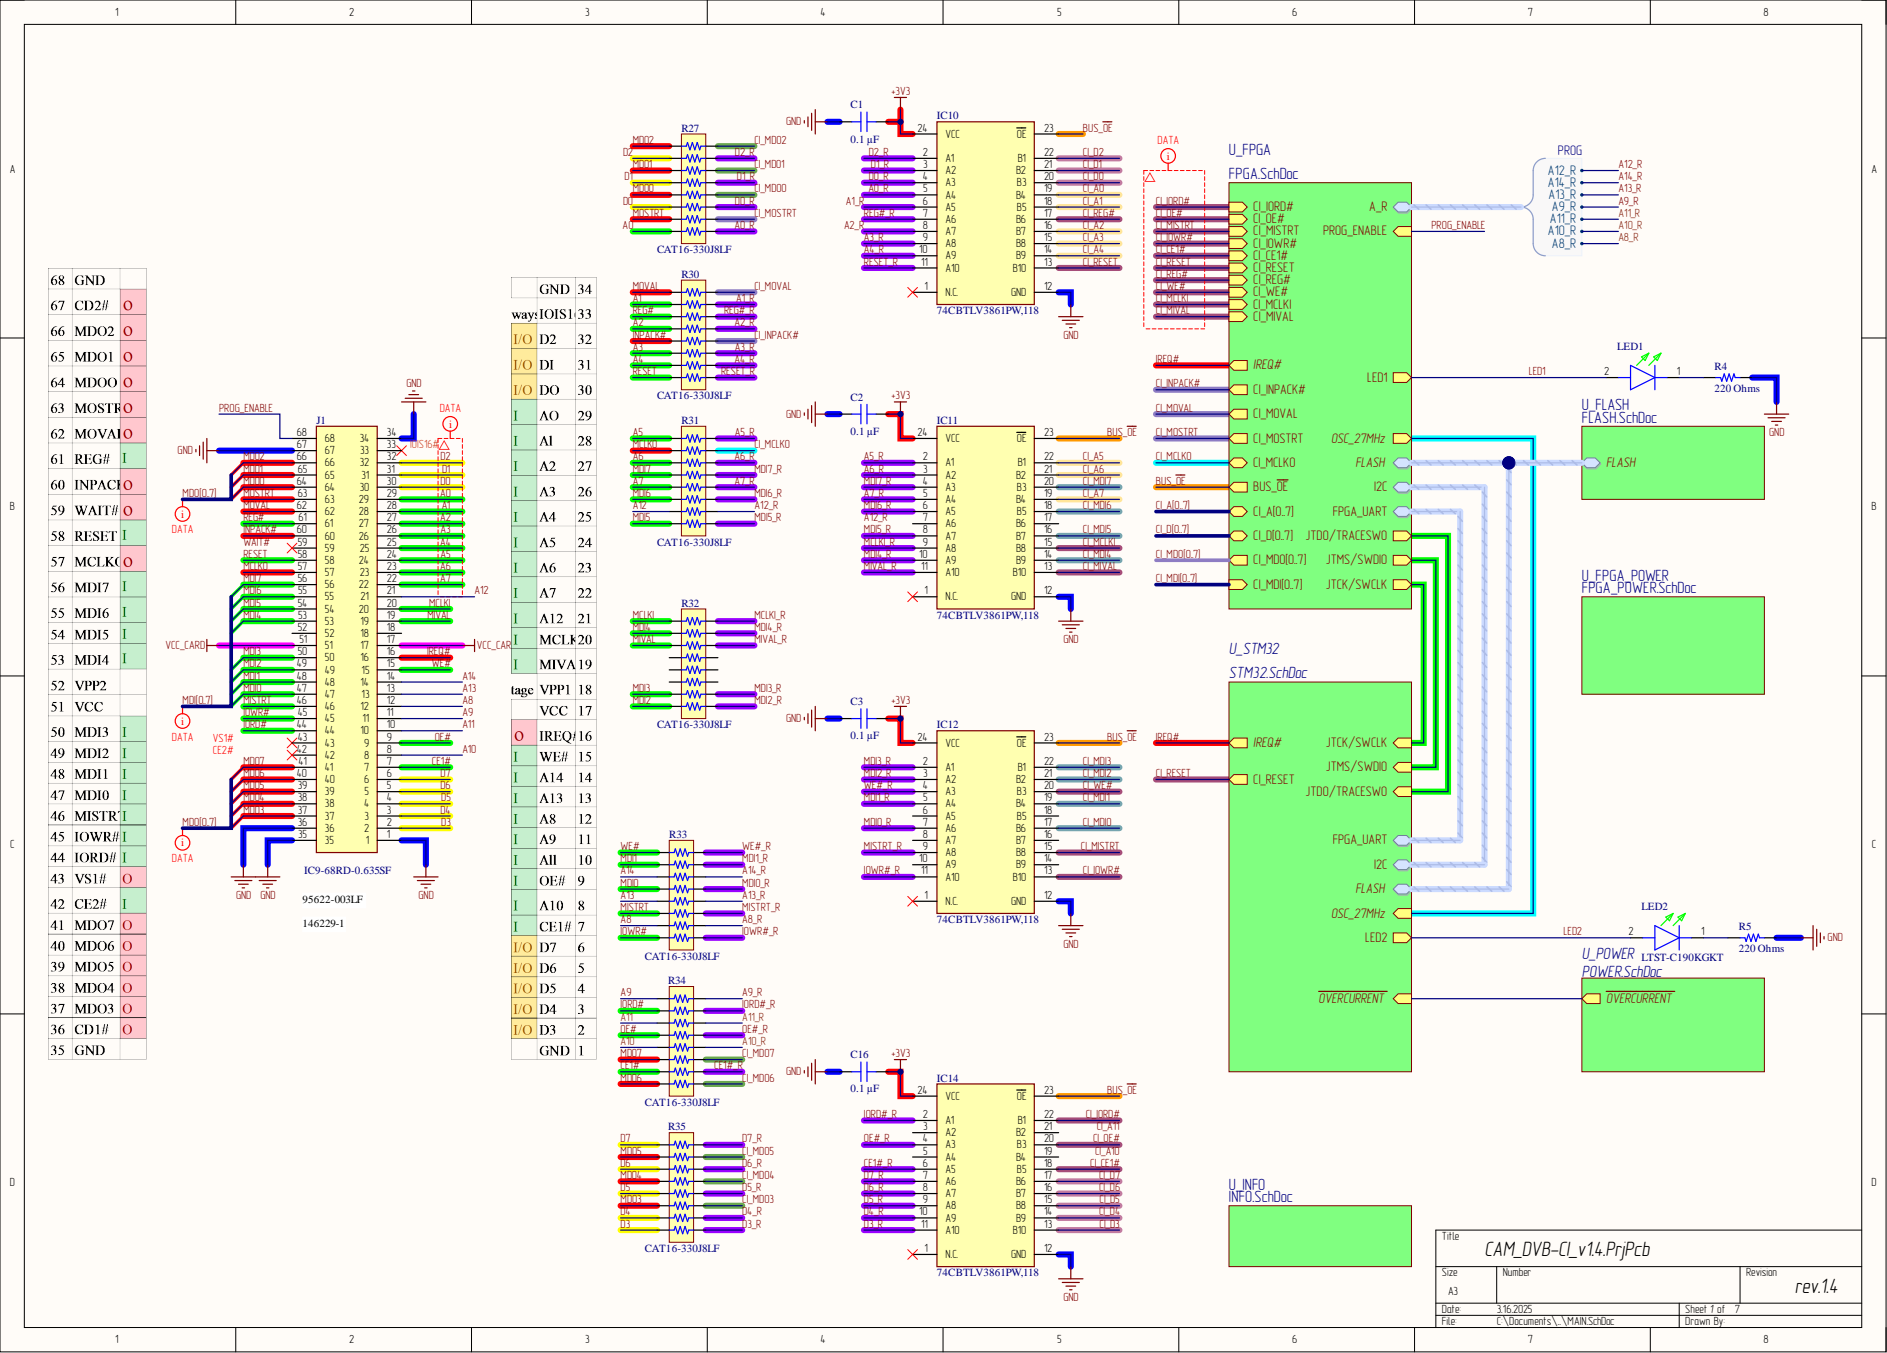
[picture p101: page 1]

_ MDI[ 0 . . | MDI 5 | 2 0 M CLK I

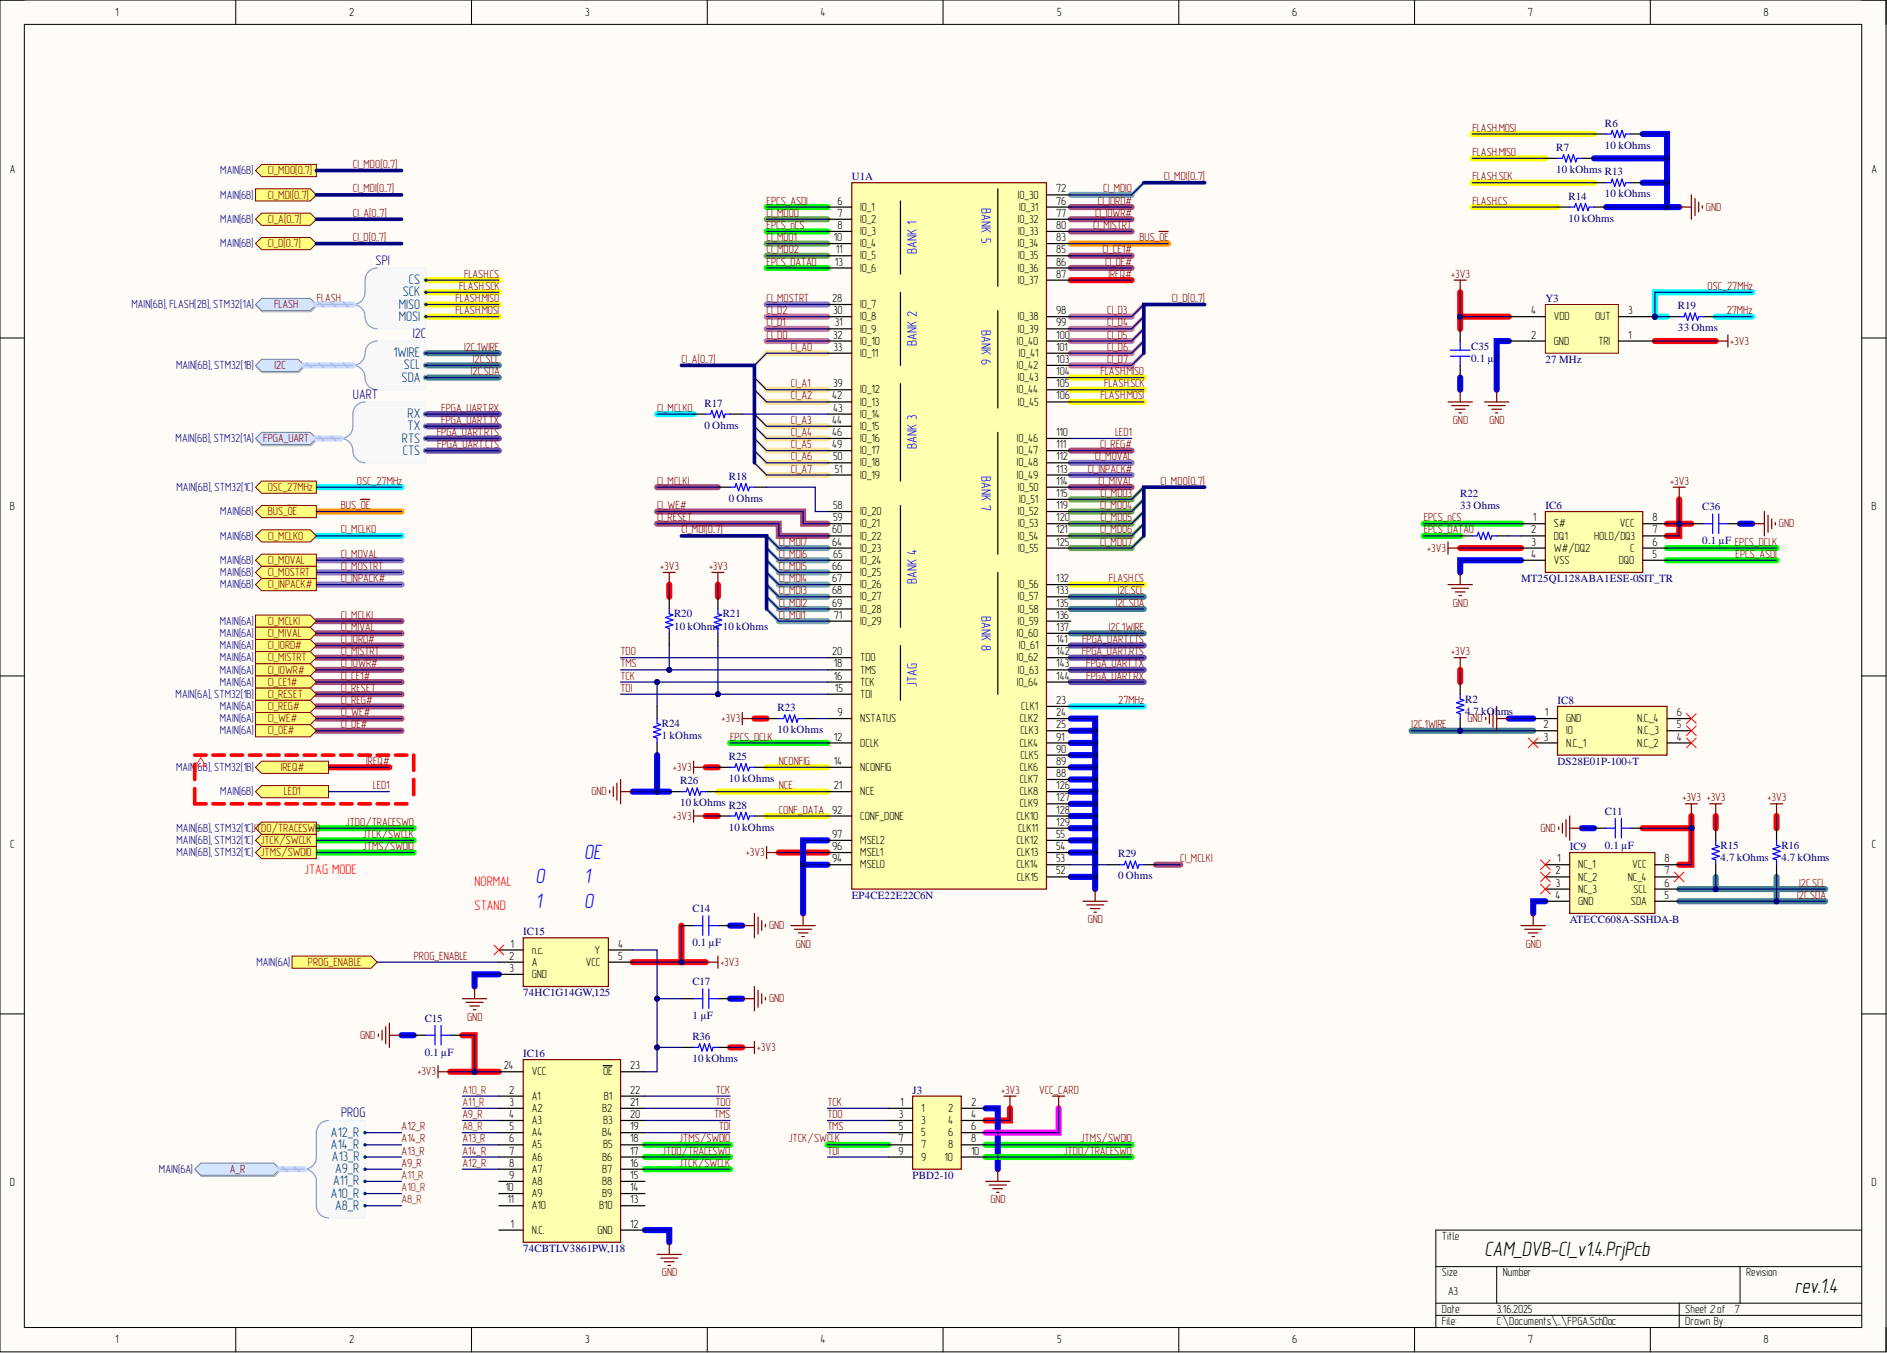
[picture p102: page 2]

BANK 5 BANK 6 BANK 7 BANK 8

BANK 1 BANK 2 BANK 3 BANK 4

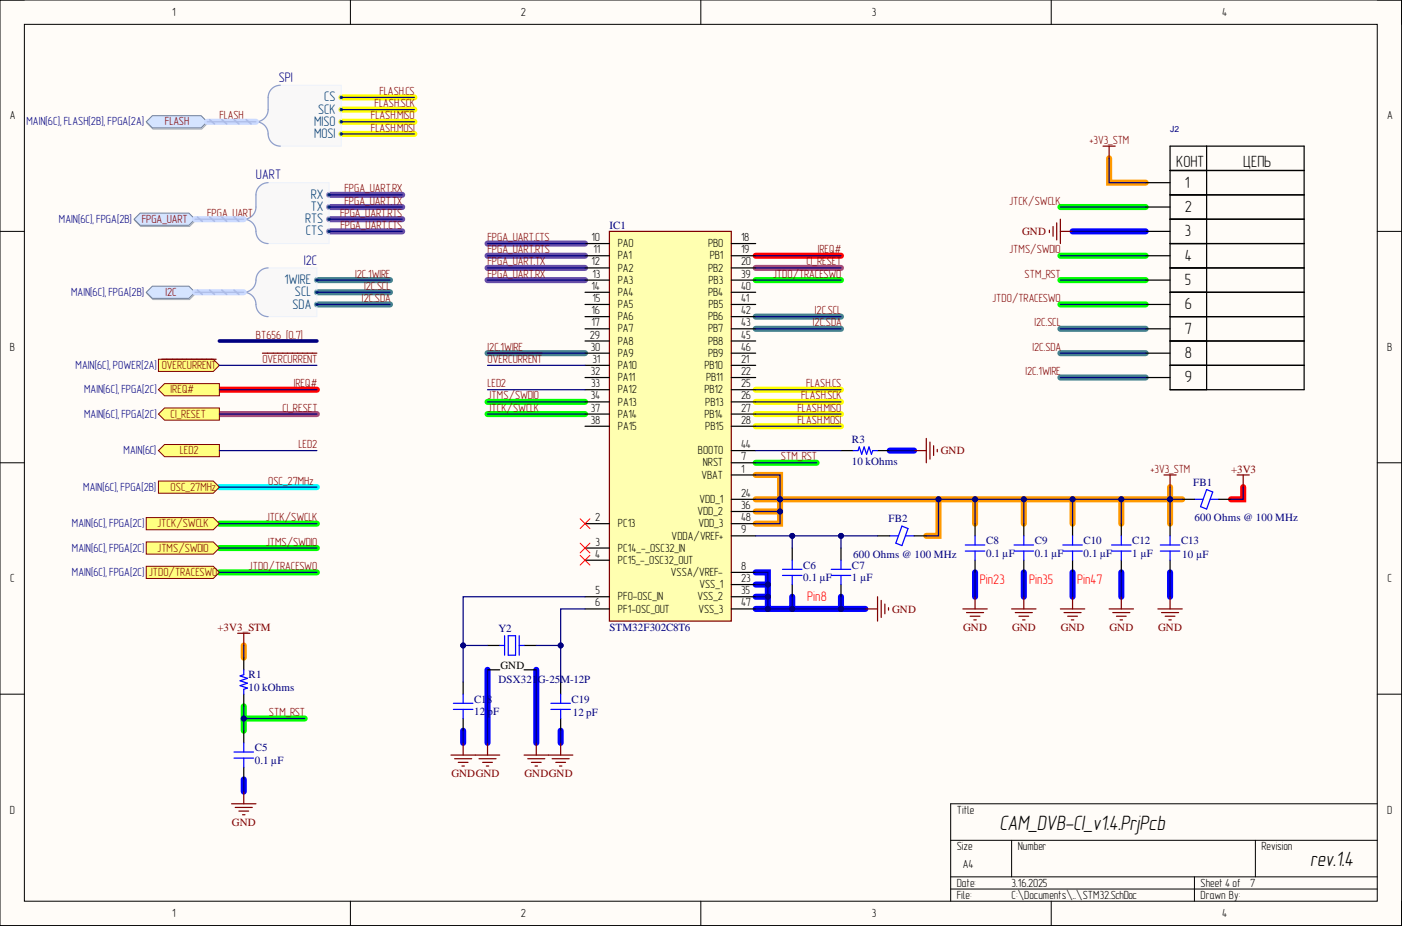
[picture p103: page 3]

2 4
3 6
4 8

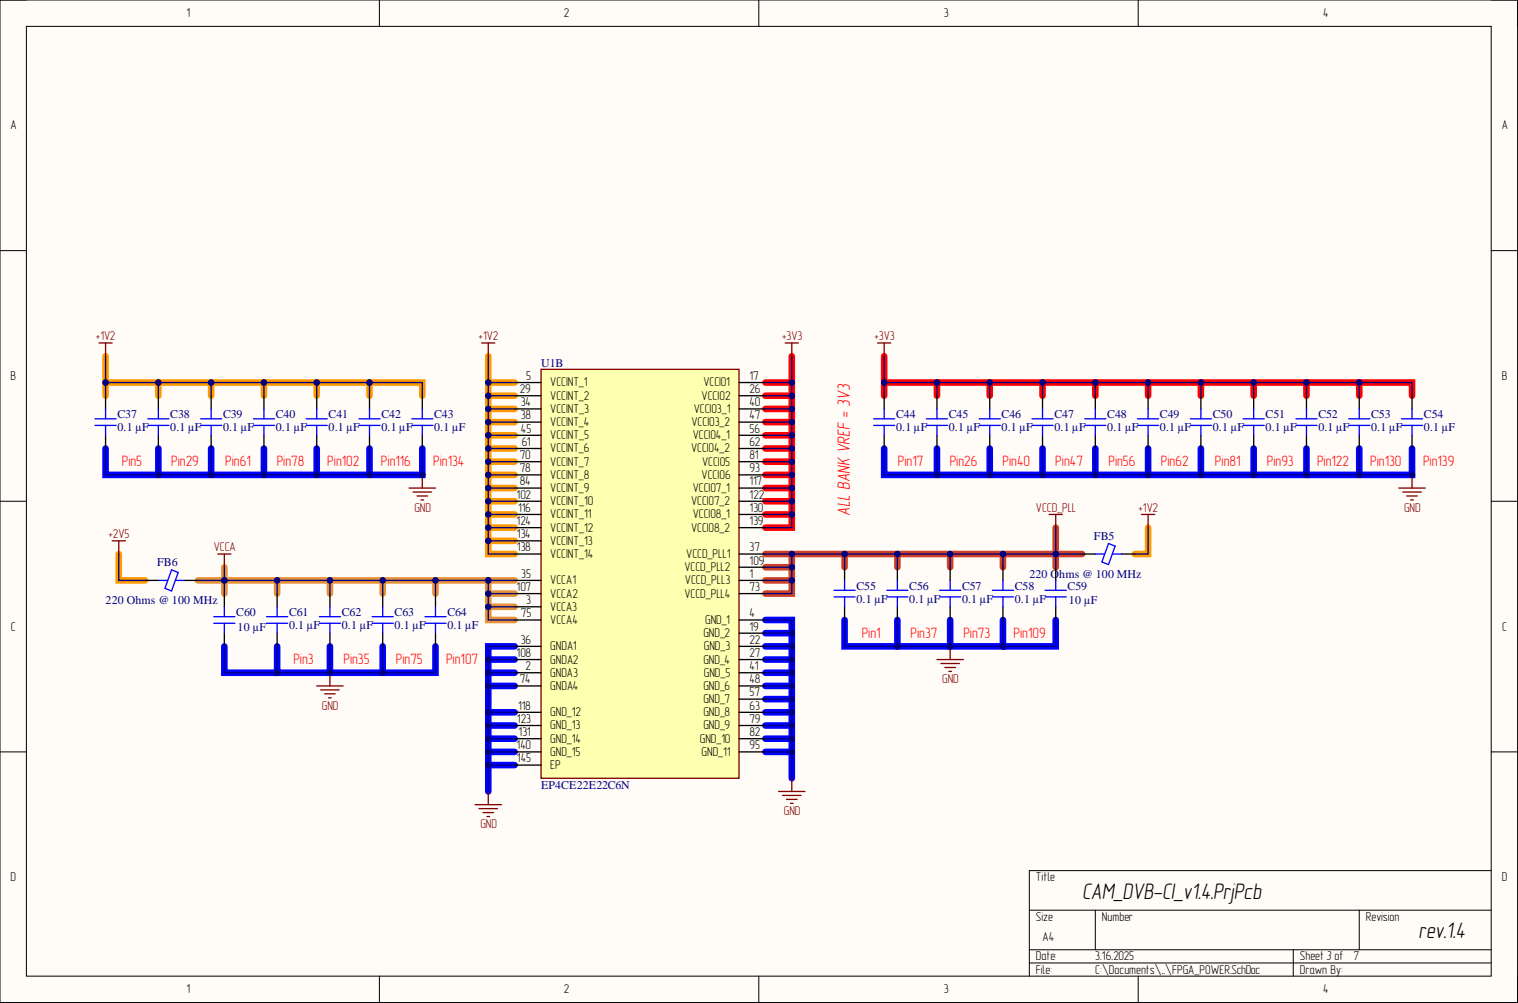
[picture p104: page 4]

VCCA3 3

Pin1 | Pin37 | Pin73 | Pin109

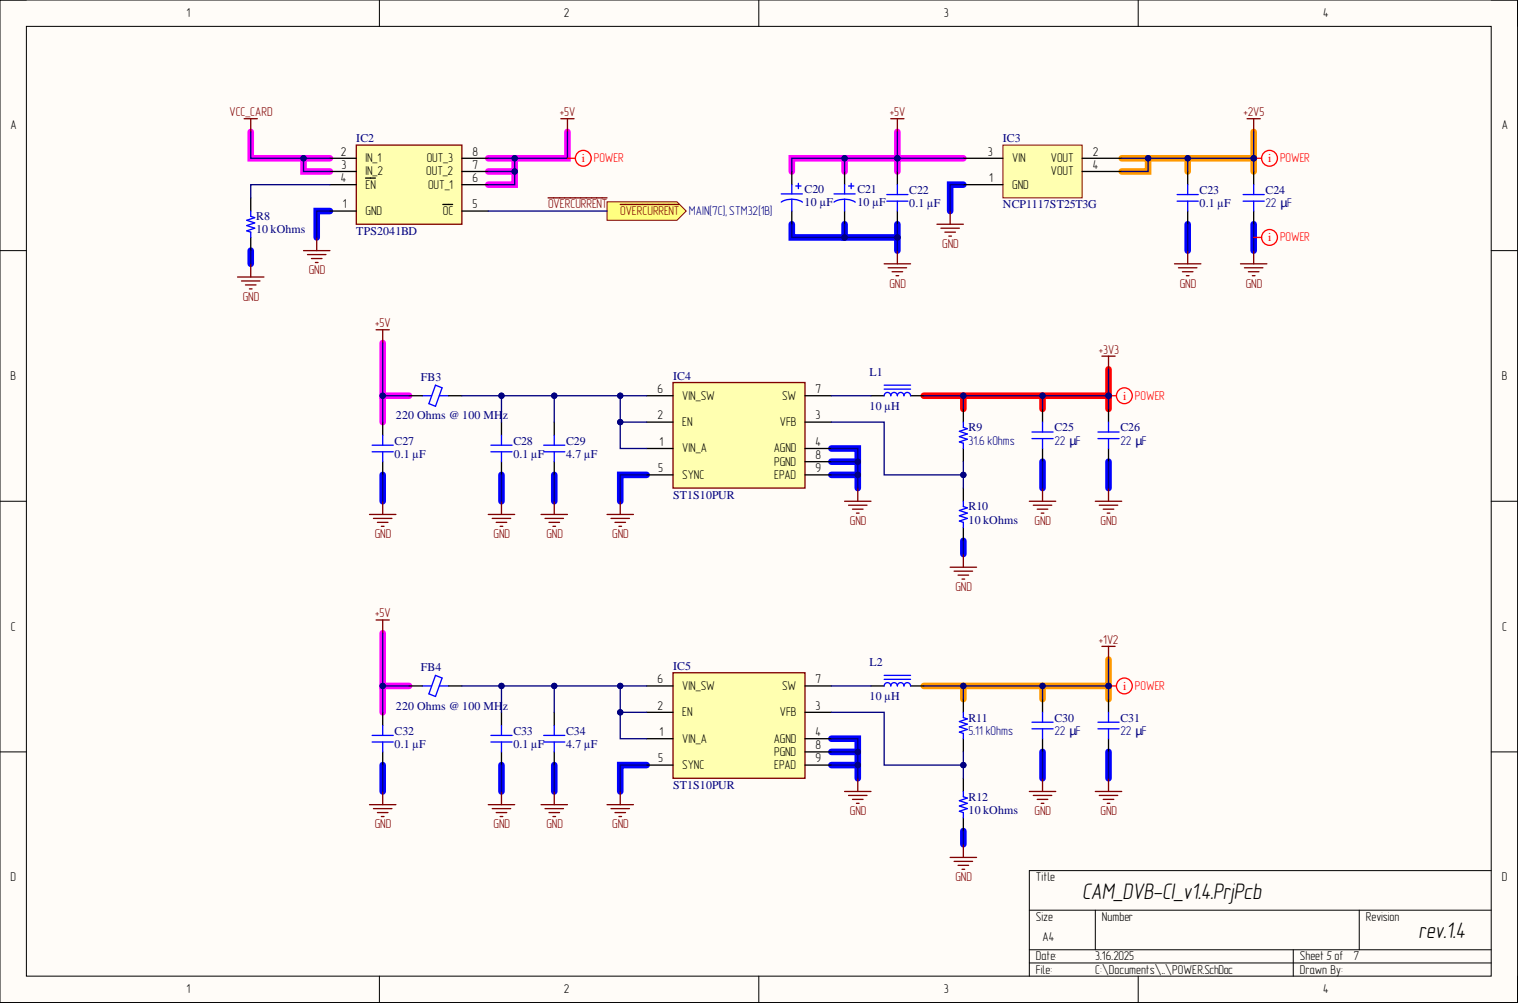
[picture p105: page 5]

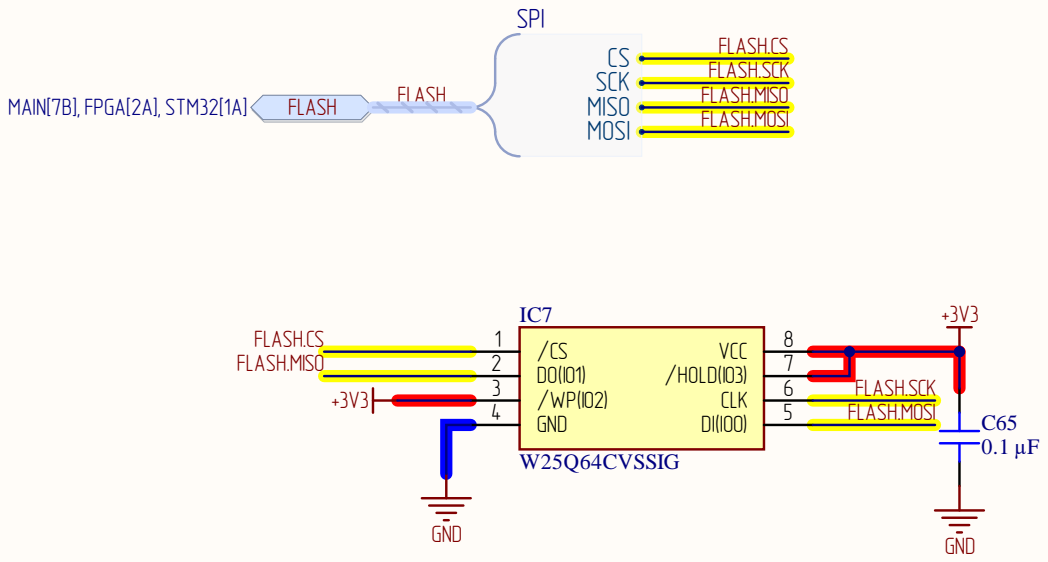
[picture p106: page 6]

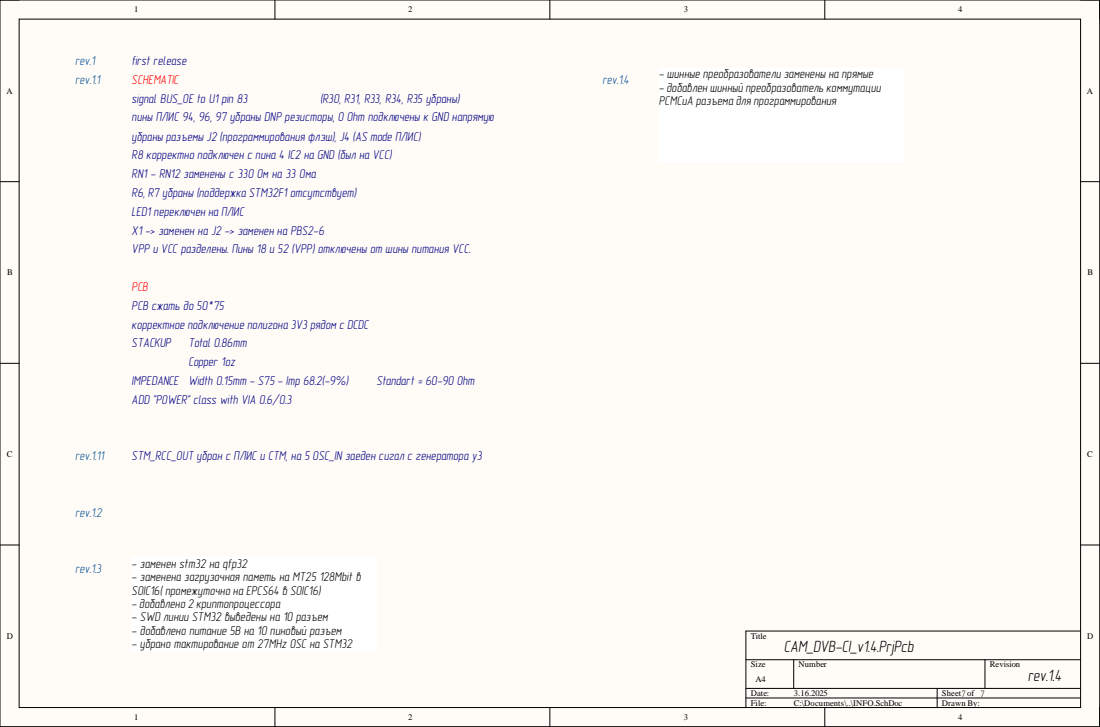
[picture p107: page 7]

SCHEMATIC
signal BUS_OE to U1 pin 83
пины ПЛИС 94, 96, 97 убраны DNP резисторы, 0 Ohm подключены к GND напрямую
убраны разъемы J2 (программирования флэш), J4 (AS mode ПЛИС)
R8 корректно подключен с пина 4 IC2 на GND (был на VCC)
RN1 - RN12 заменены с 330 Ом на 33 Ома
R6, R7 убраны (поддержка STM32F1 отсутствует)
LED1 переключен на ПЛИС
X1 -> заменен на J2 -> заменен на PBS2-6
VPP и VCC разделены. Пины 18 и 52 (VPP) отключены от шины питания VCC.

- добавлен шинный преобразователь коммутации
РСМСиА разъема для программирования

PCB
PCB сжать до 50*75
корректное подключение полигона 3V3 рядом с DCDC

ADD "POWER" class with VIA 0.6/0.3

- заменена загрузочная паметь на MT25 128Mbit в
SOIC16( промежуточно на EPCS64 в SOIC16)
- добавлено 2 криптопроцессора
- SWD линии STM32 выведены на 10 разъем
- добавлено питание 5В на 10 пиновый разъем
