SiwaNetwork/CASS/Корпус/68PIN SMT母头(1)[1].pdf

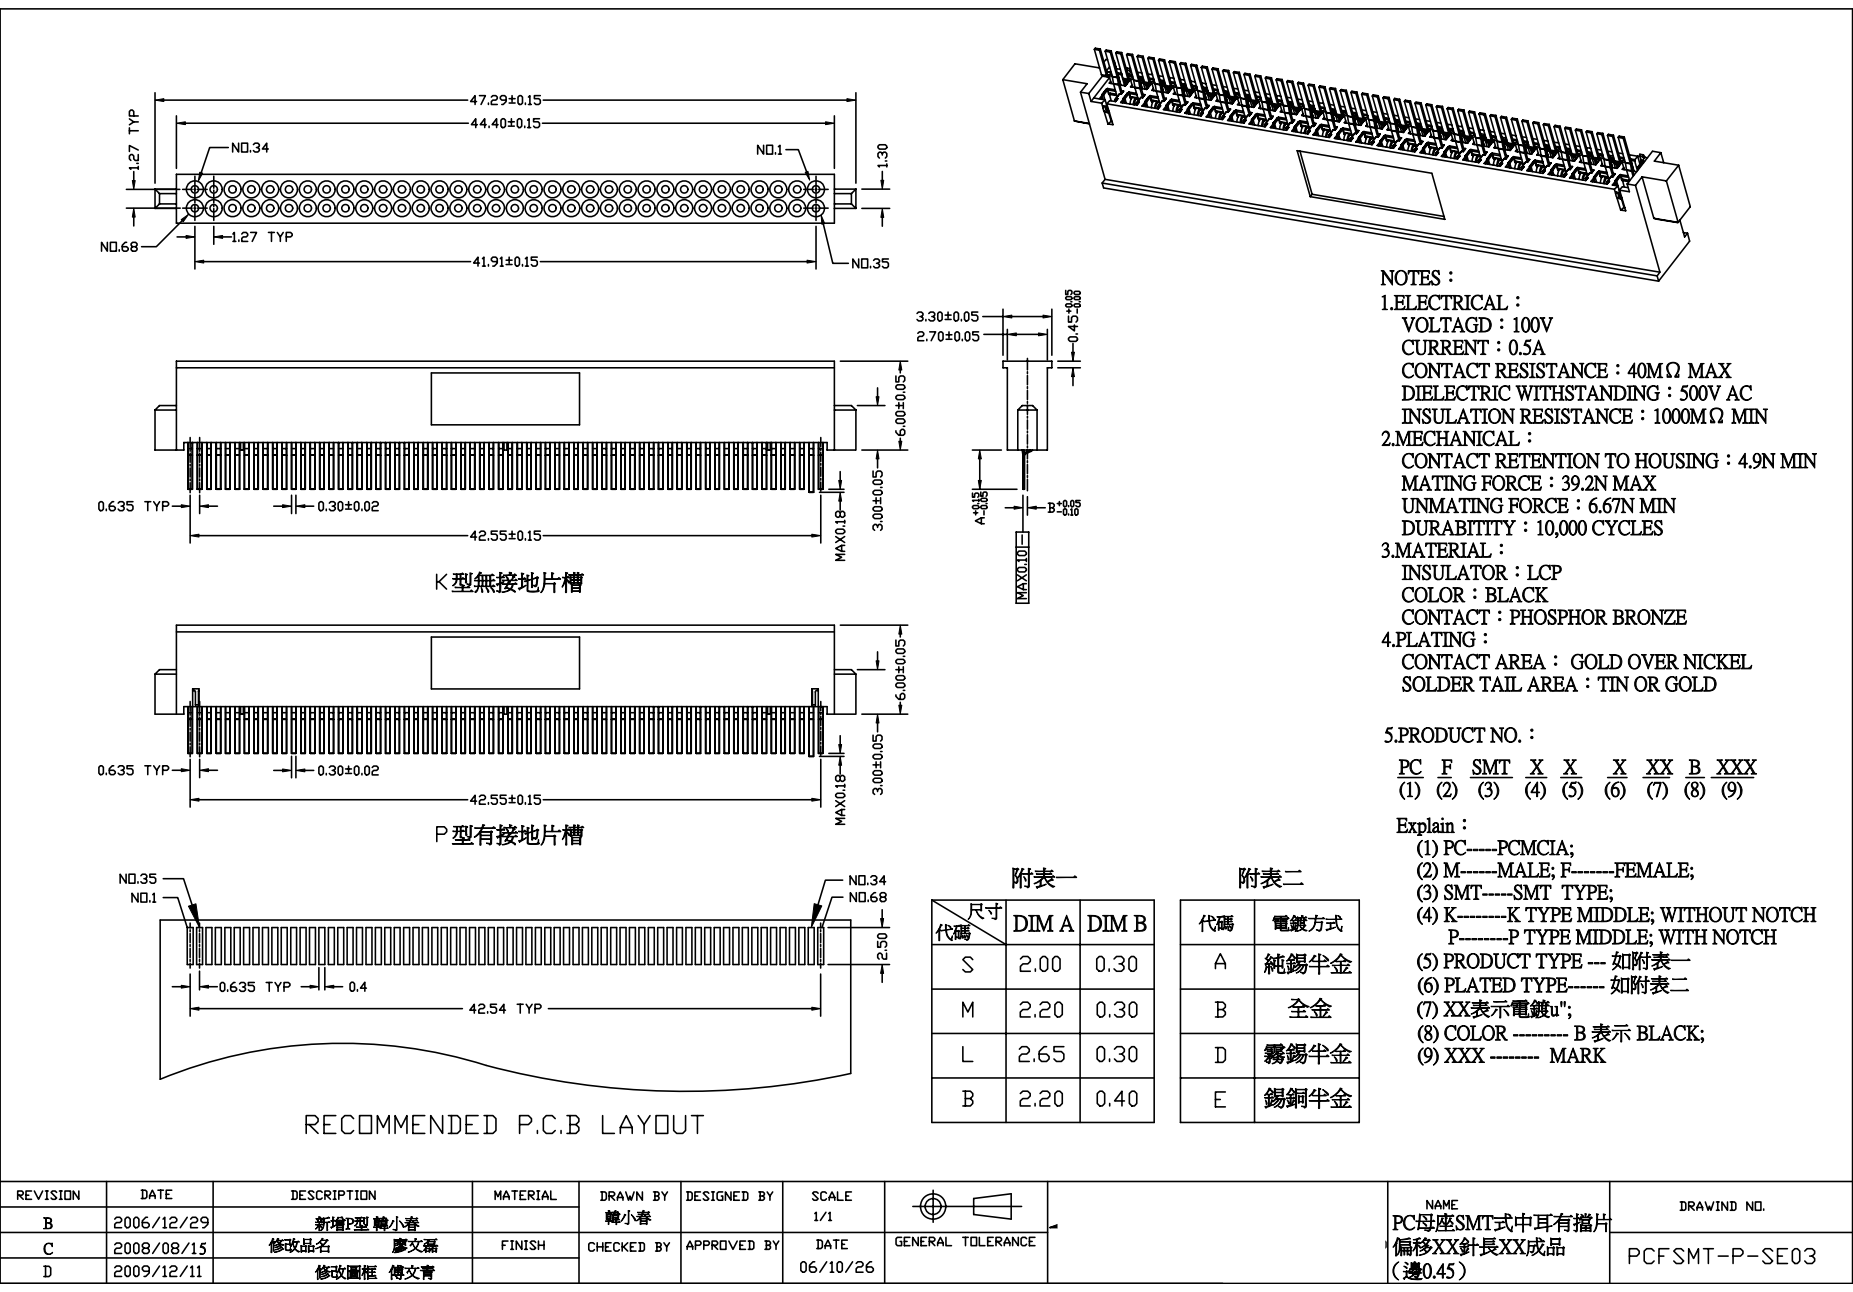
[picture p108: page 1]
