SiwaNetwork/CASS/Корпус/PCFSMT-K1-RLE10-B059C-GW常出[1][1].pdf

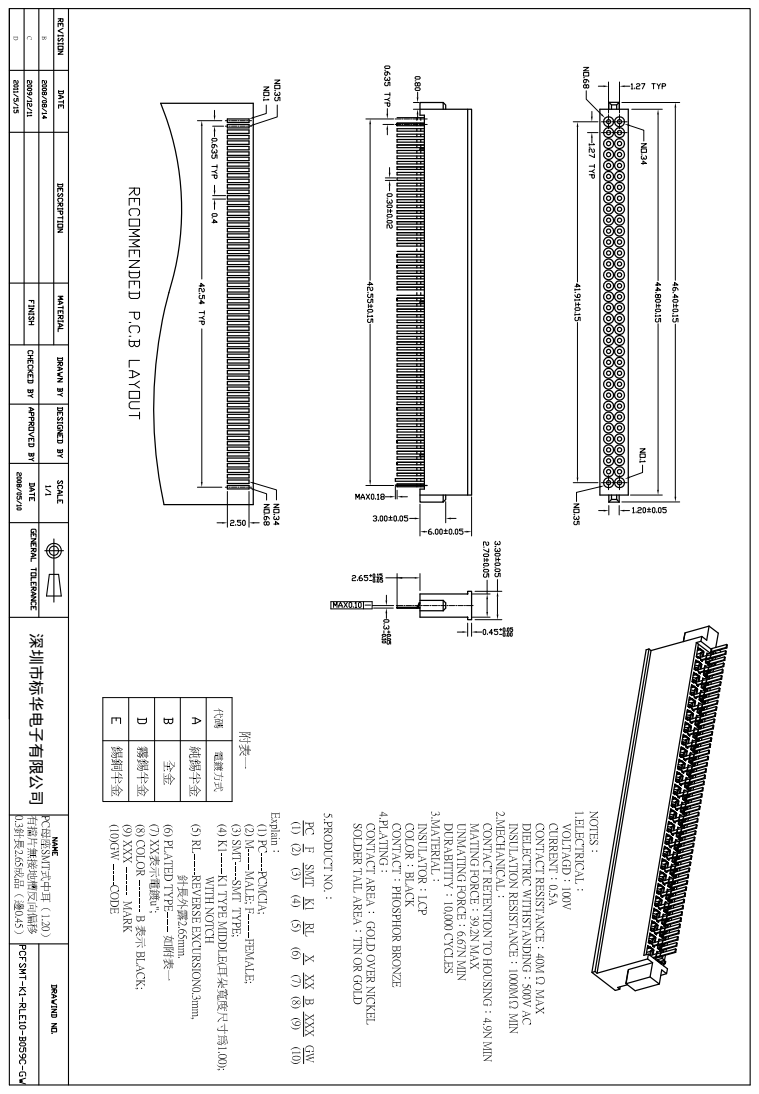
[picture p109: page 1]
深圳市标华电子有限公司
