SiwaNetwork/CASS/Корпус/PCFSMT-K1-RLE10-B059C-GW常出.pdf

深圳市标华电子有限公司
