SiwaNetwork/CASS/Корпус/5c-558877-1.pdf

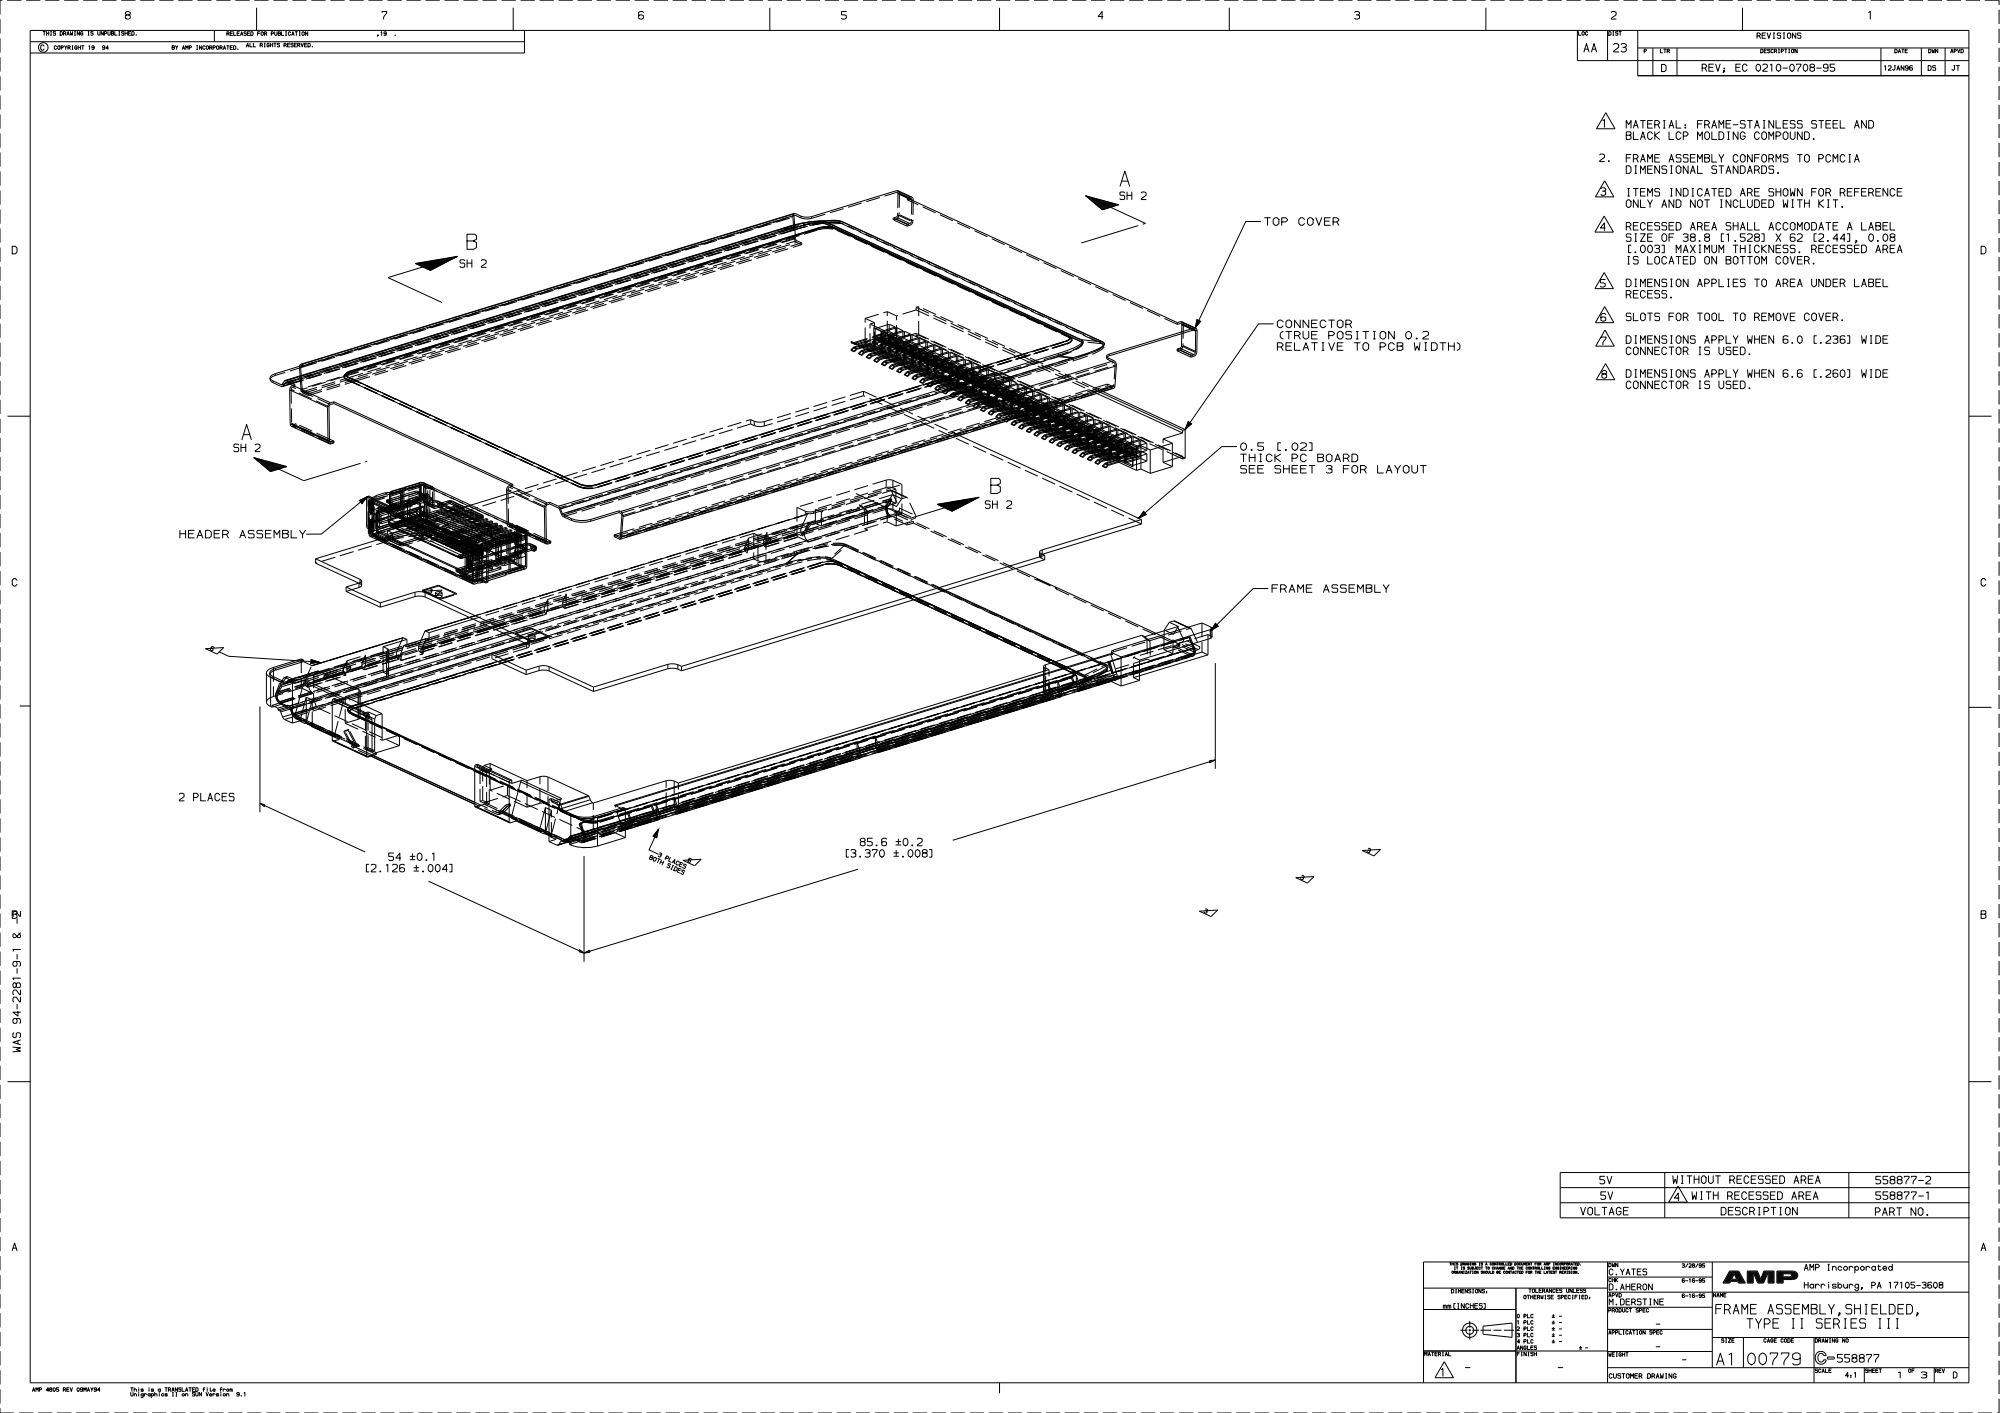
[picture p110: page 1]

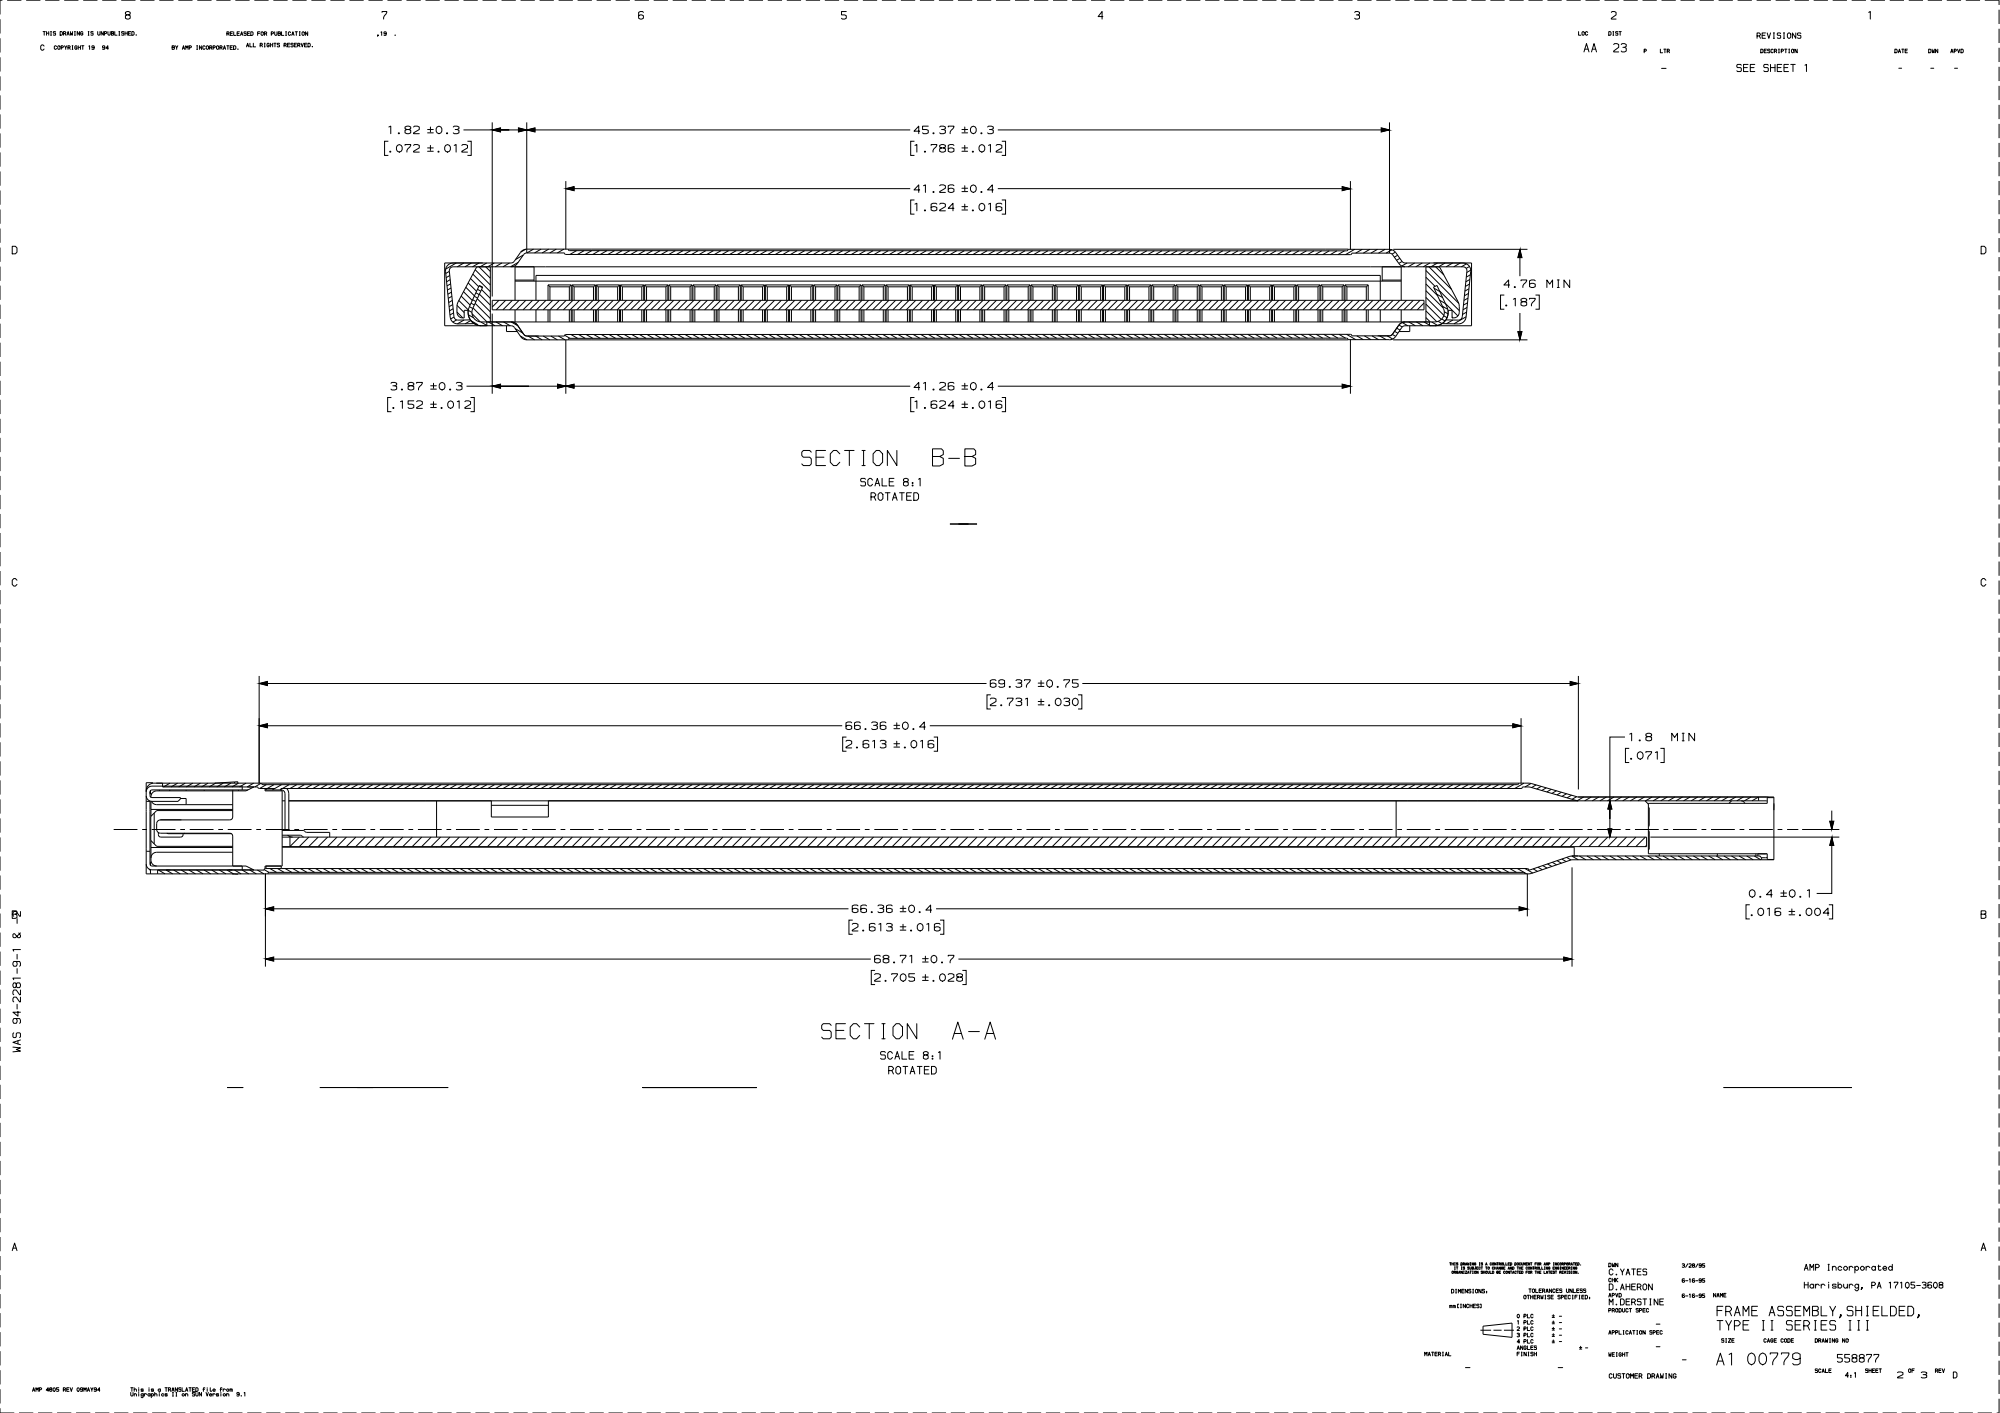
[picture p111: page 2]

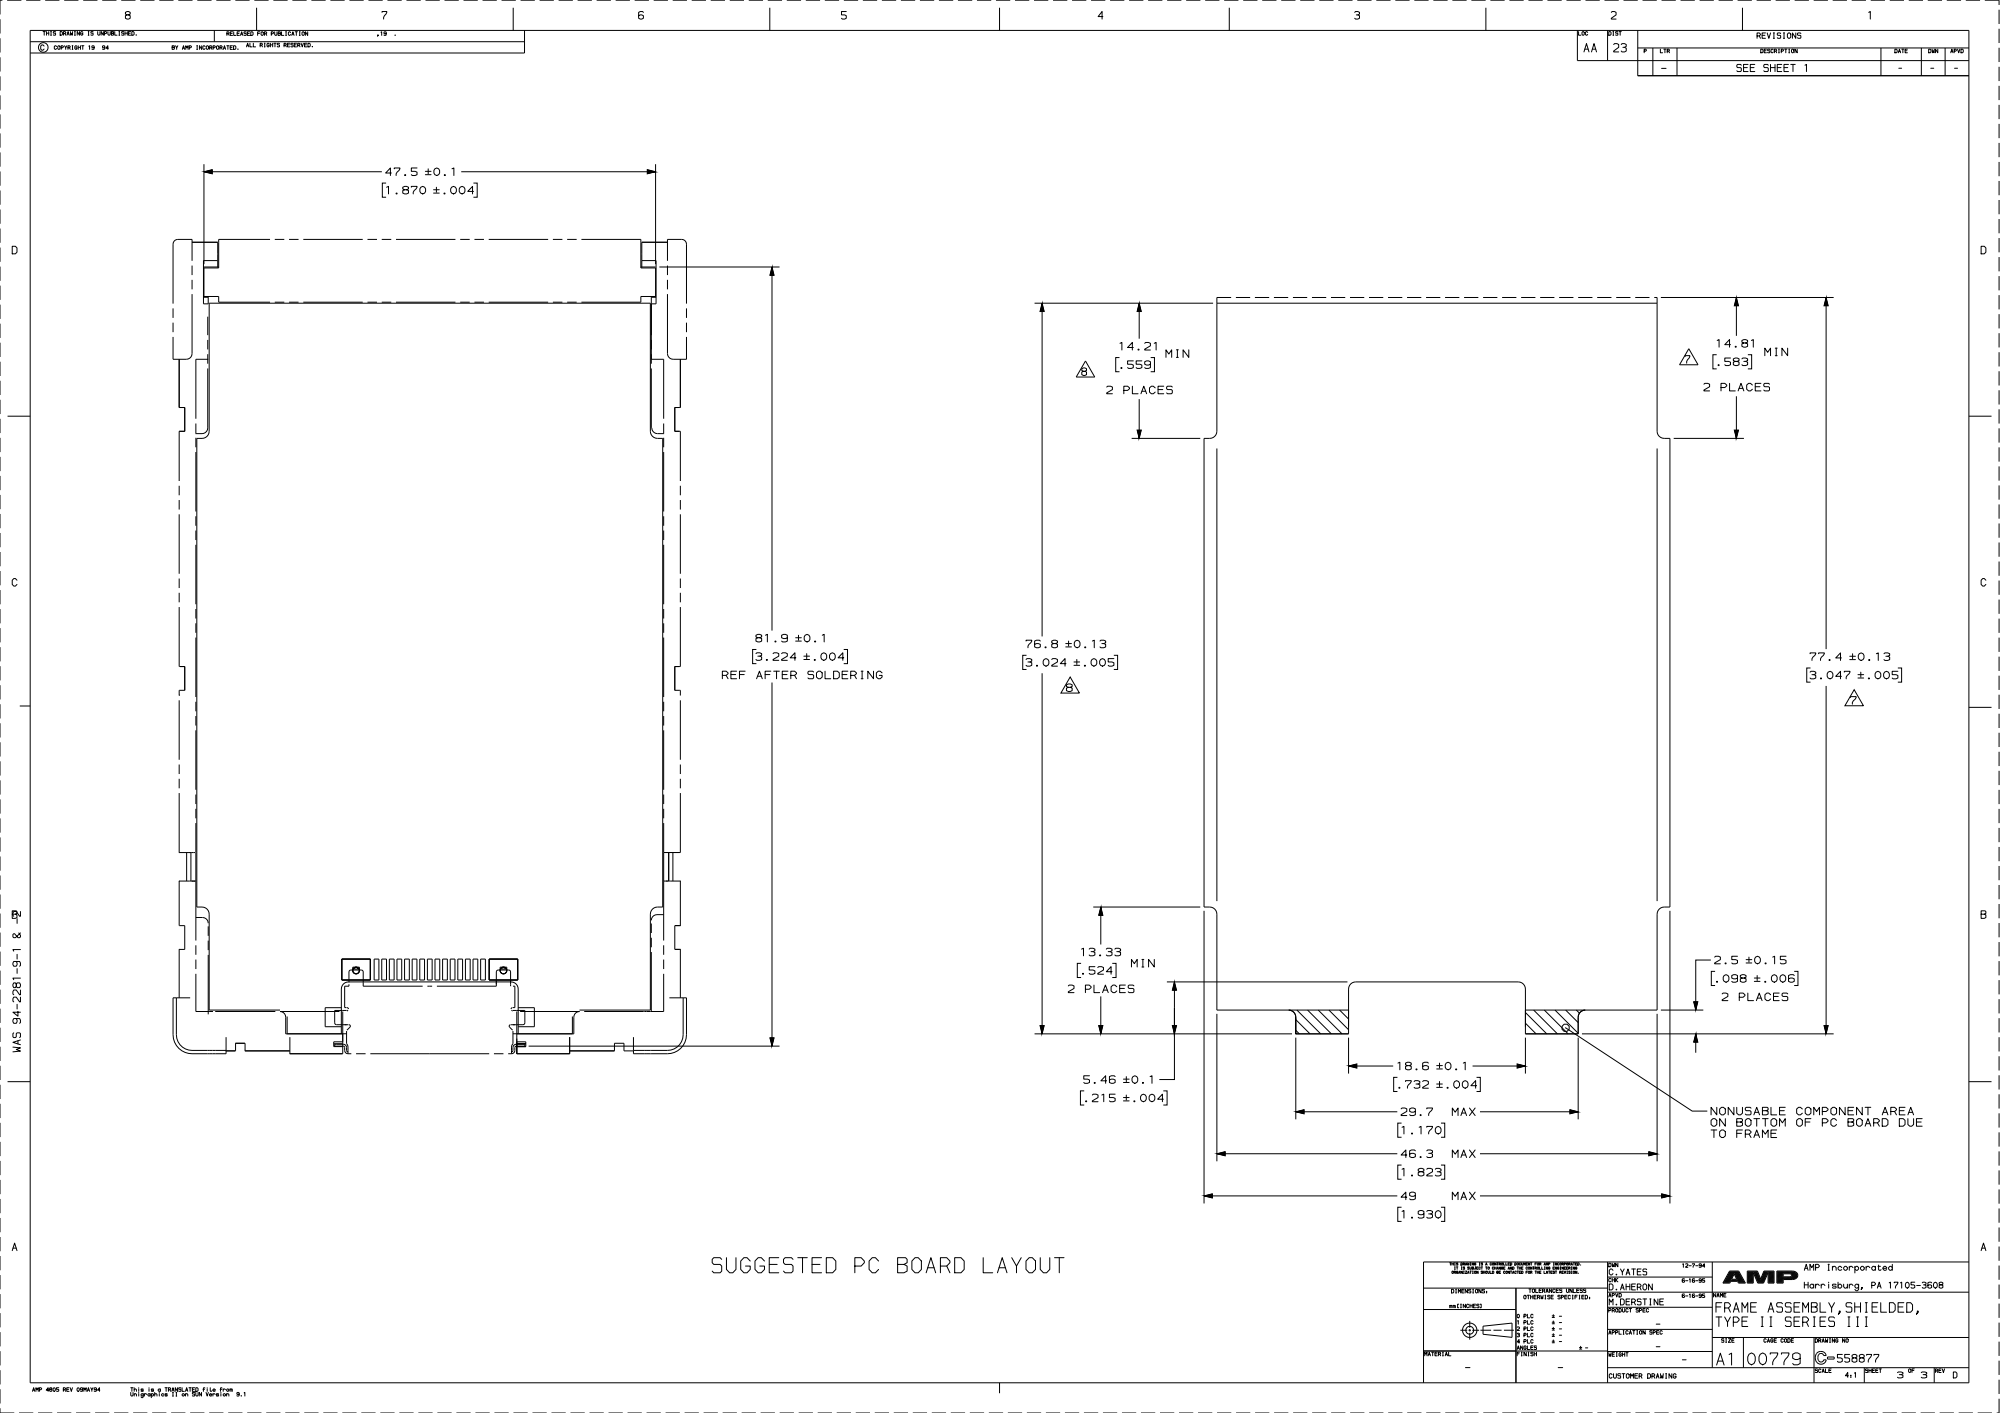
[picture p112: page 3]
