SiwaNetwork/CASS/INCUBATION/joker-tv-fpga-master/Joker_TV_SCH.pdf

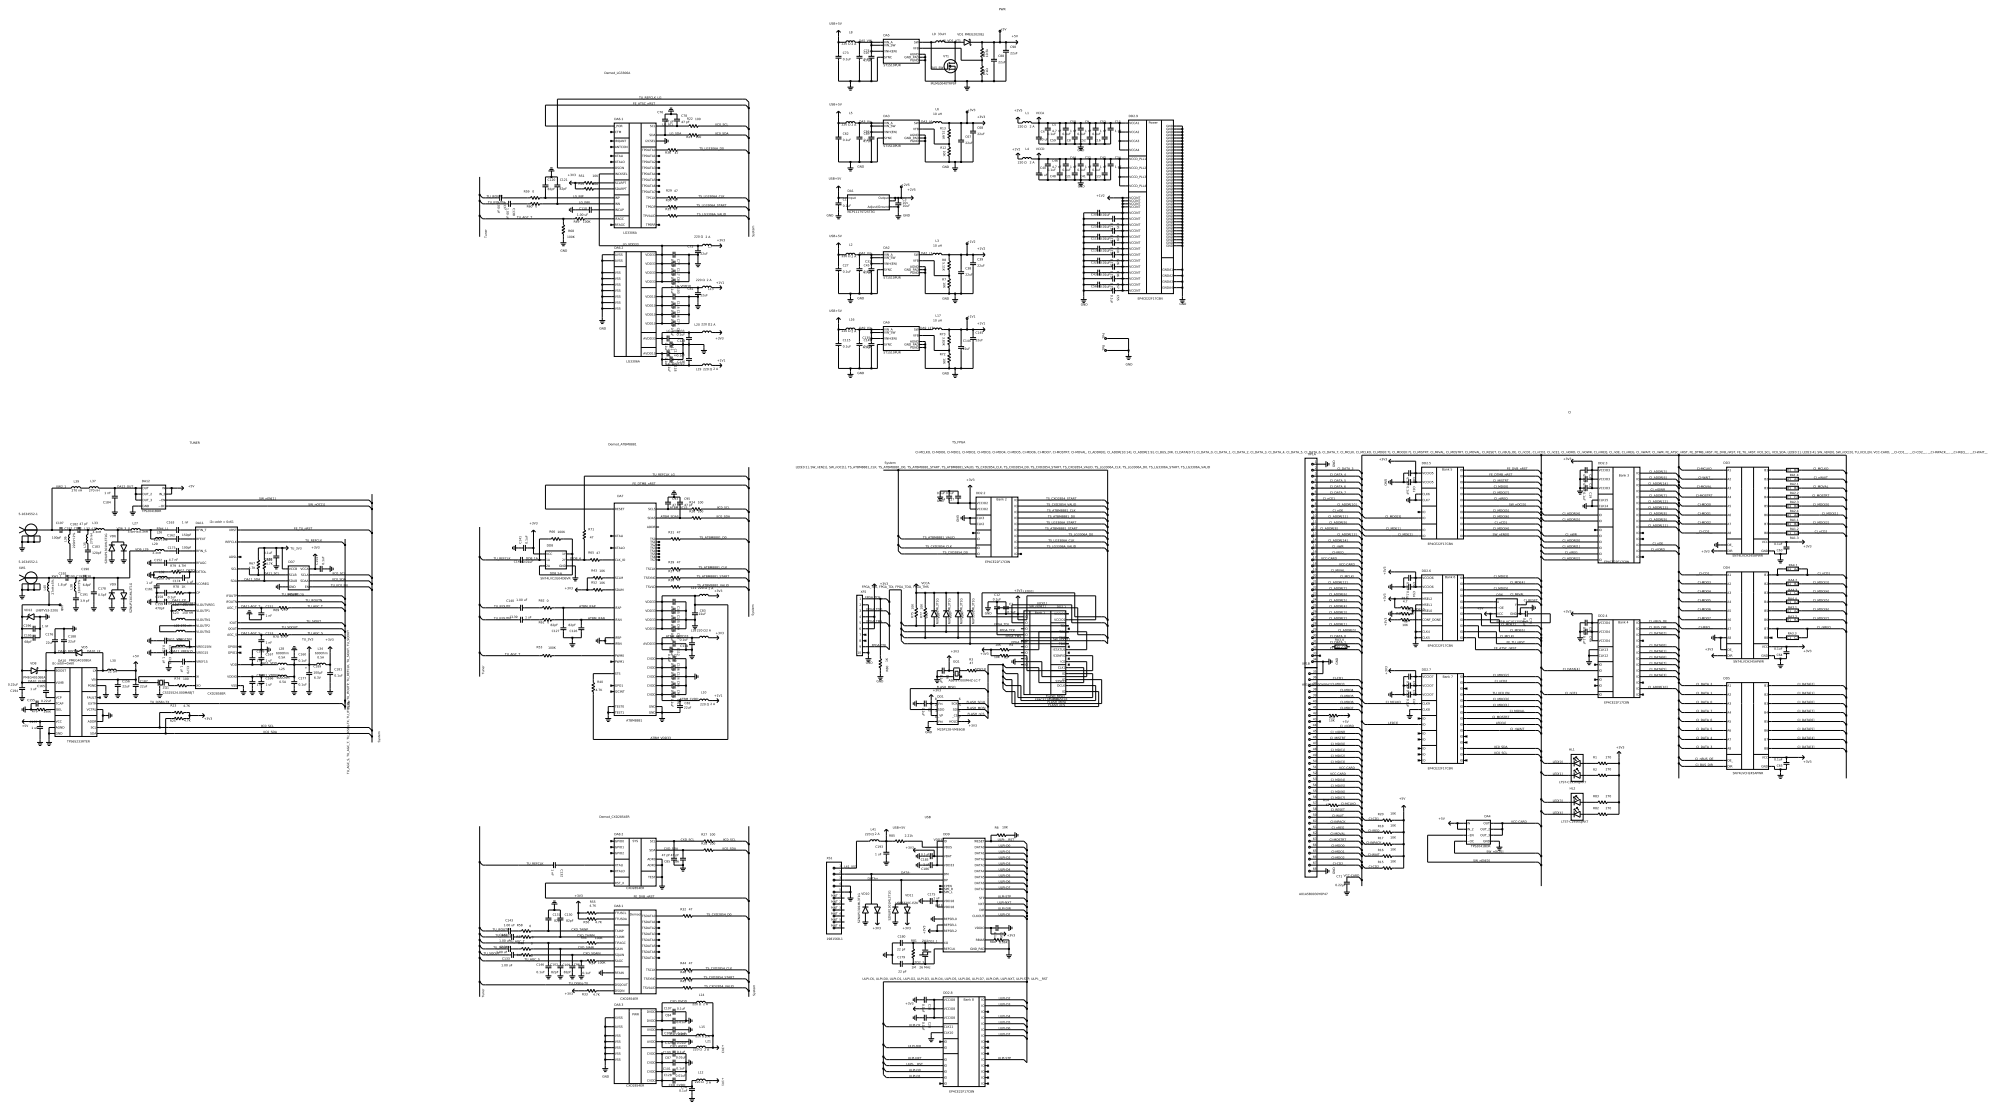
[picture p113: page 1]
