SiwaNetwork/CASS/БИБЛИОТЕКА/W25Q64BVSSIG/Исходная.pdf

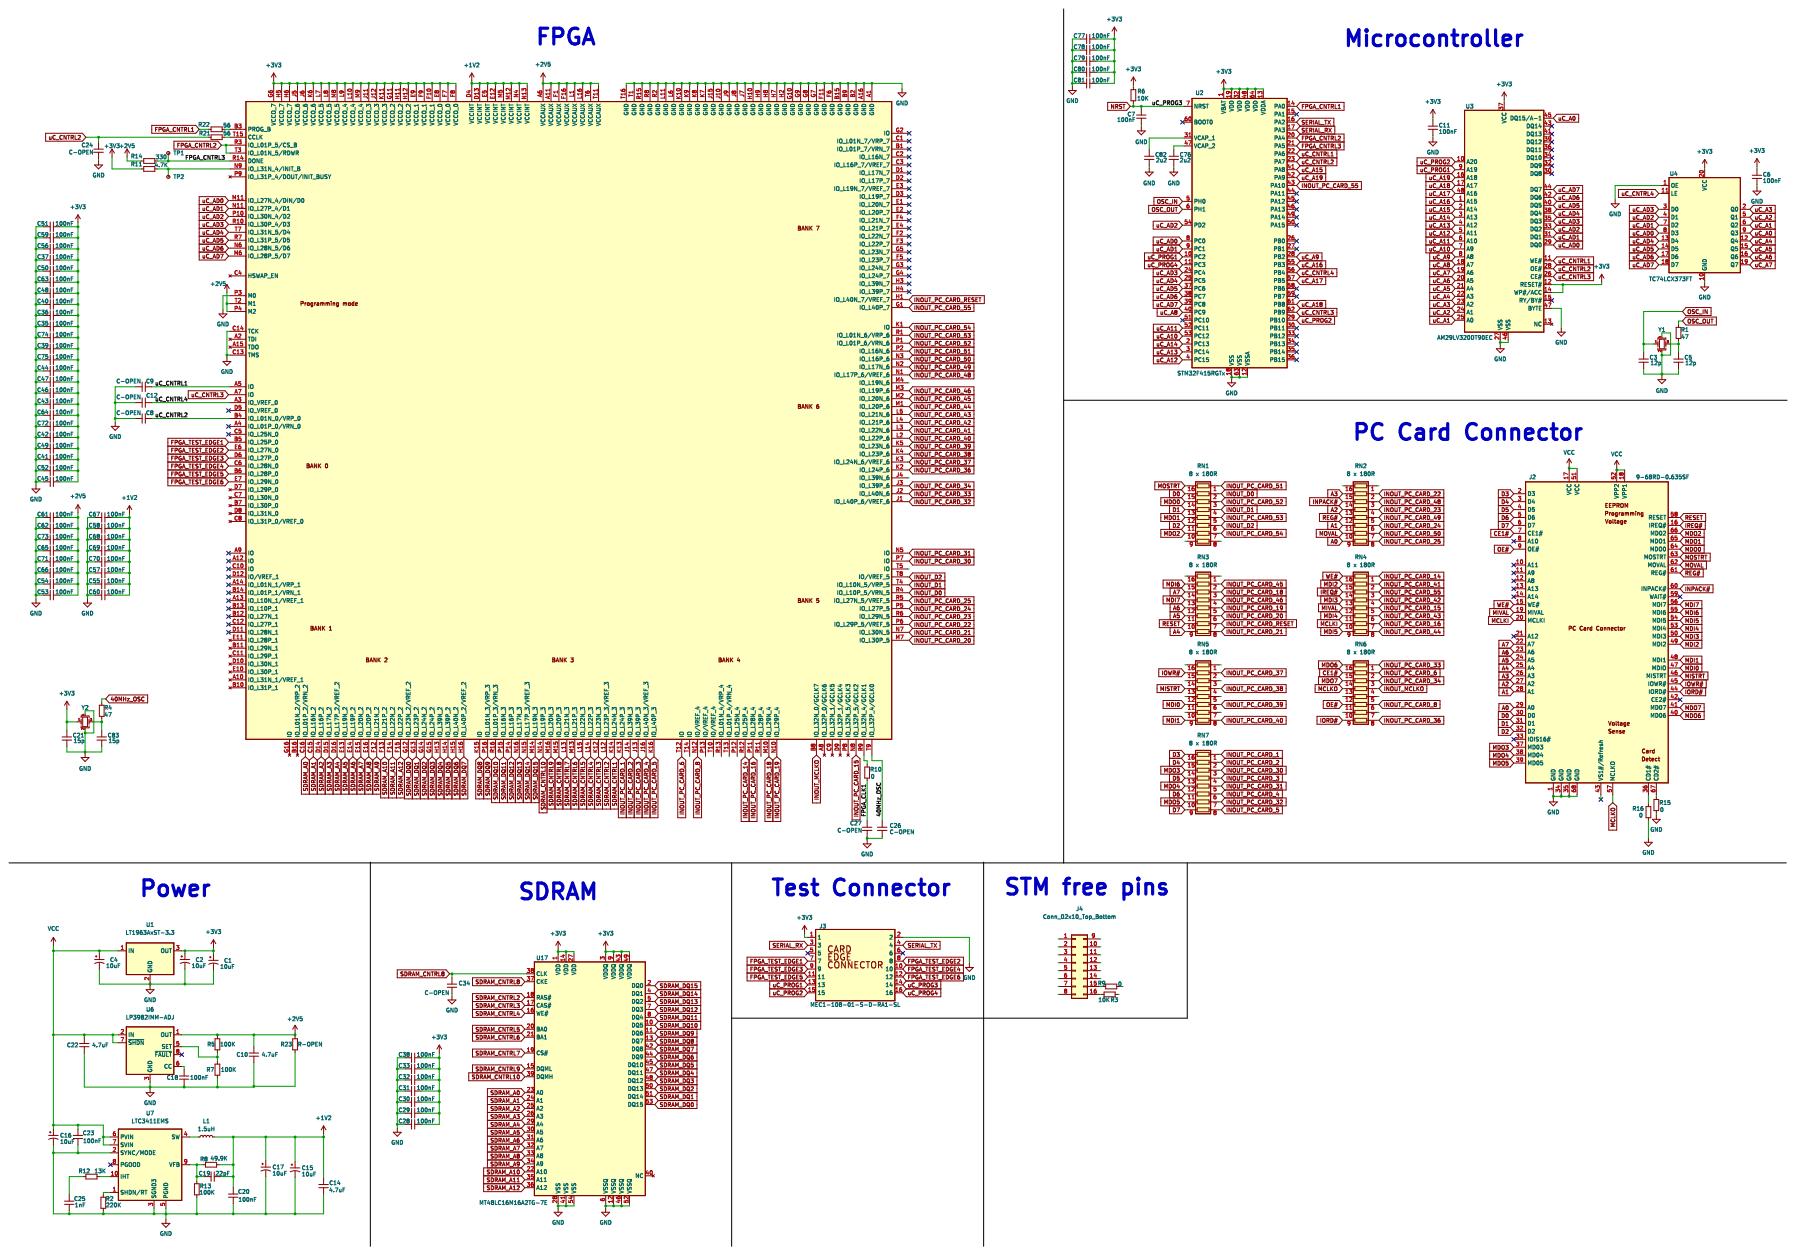
[picture p114: page 1]
