SiwaNetwork/CASS/БИБЛИОТЕКА/W25Q64BVSSIG/Последний вариант.pdf

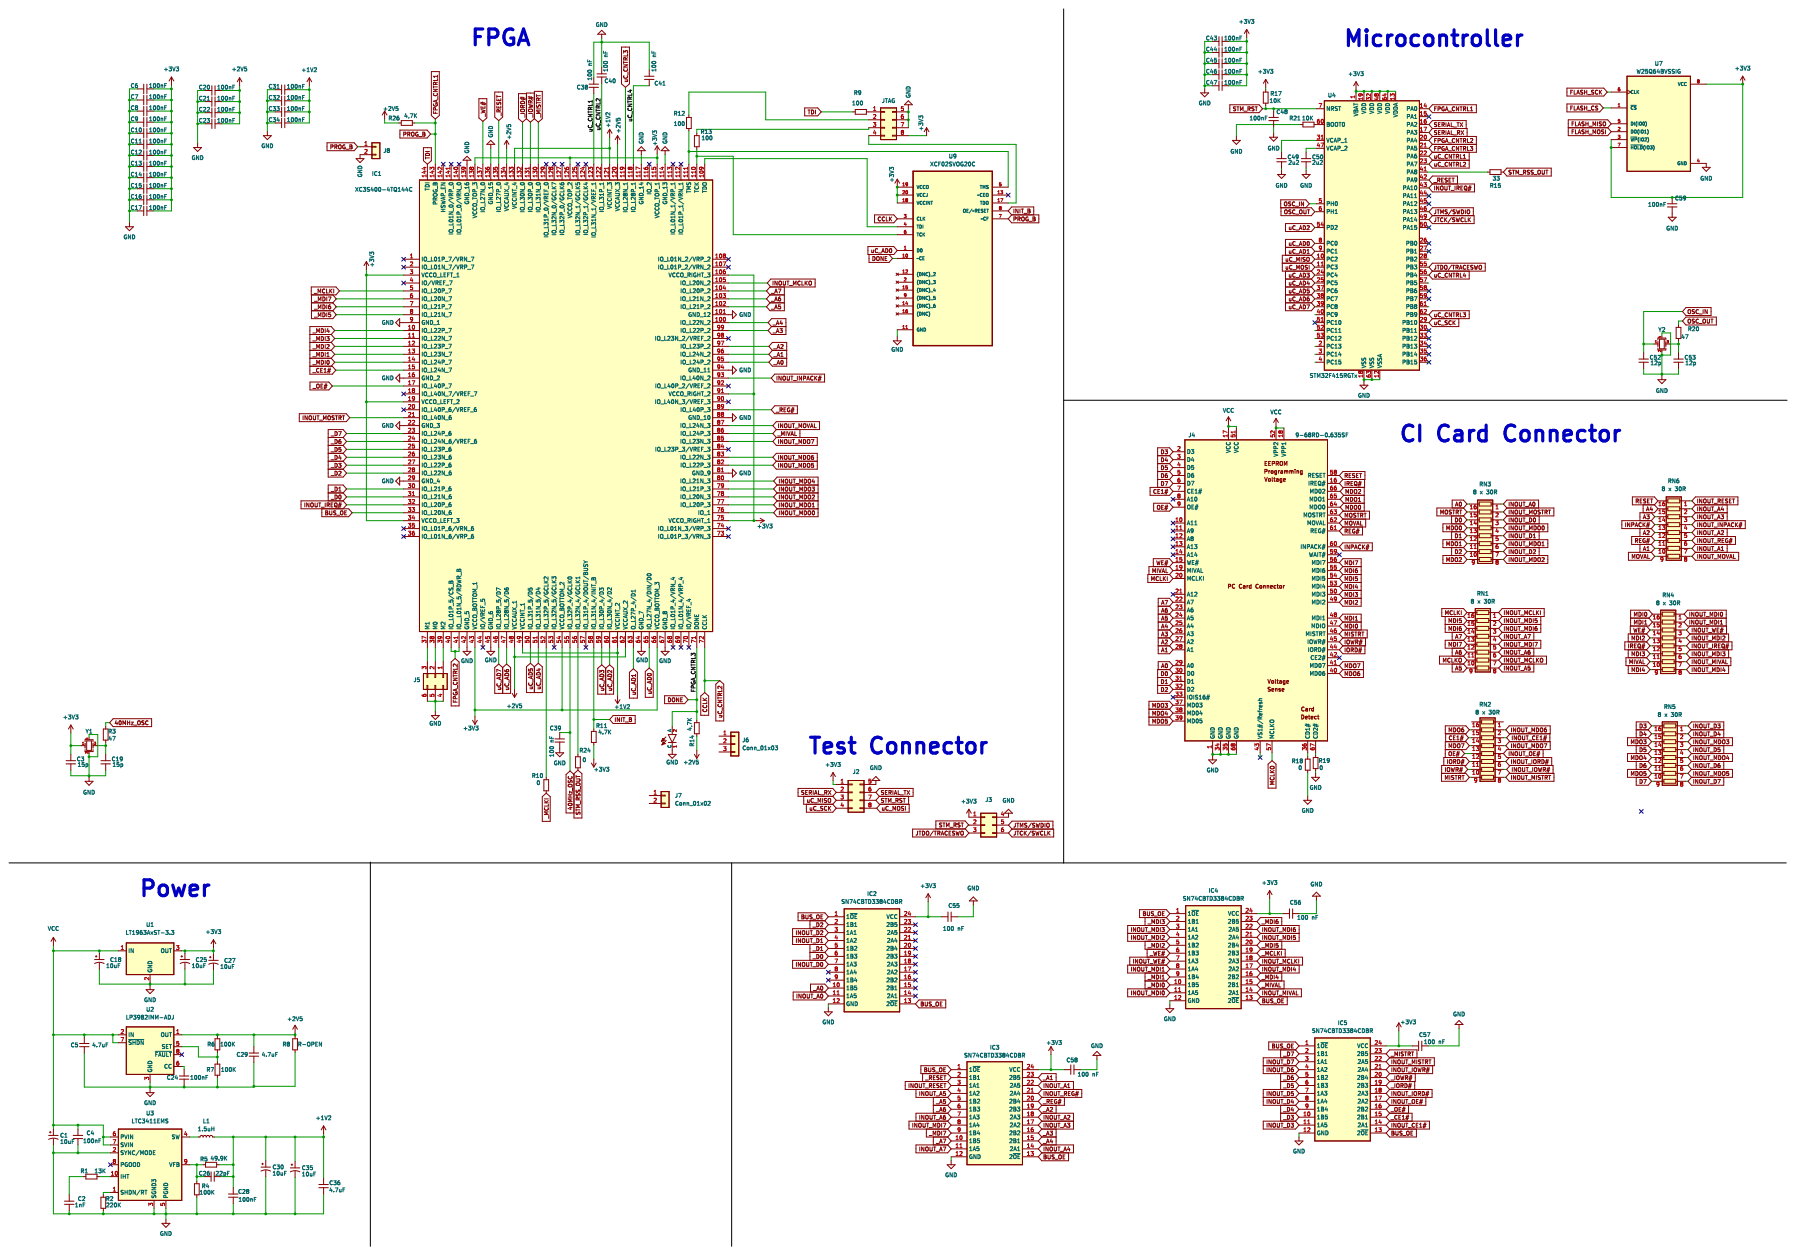
[picture p115: page 1]
