SiwaNetwork/CASS/КД и ЭД/КД оснастка/Плита _ ТЕНШ.741428.001/Плита _ ТЕНШ.741428.001.pdf

ÁÁ

Á-Á

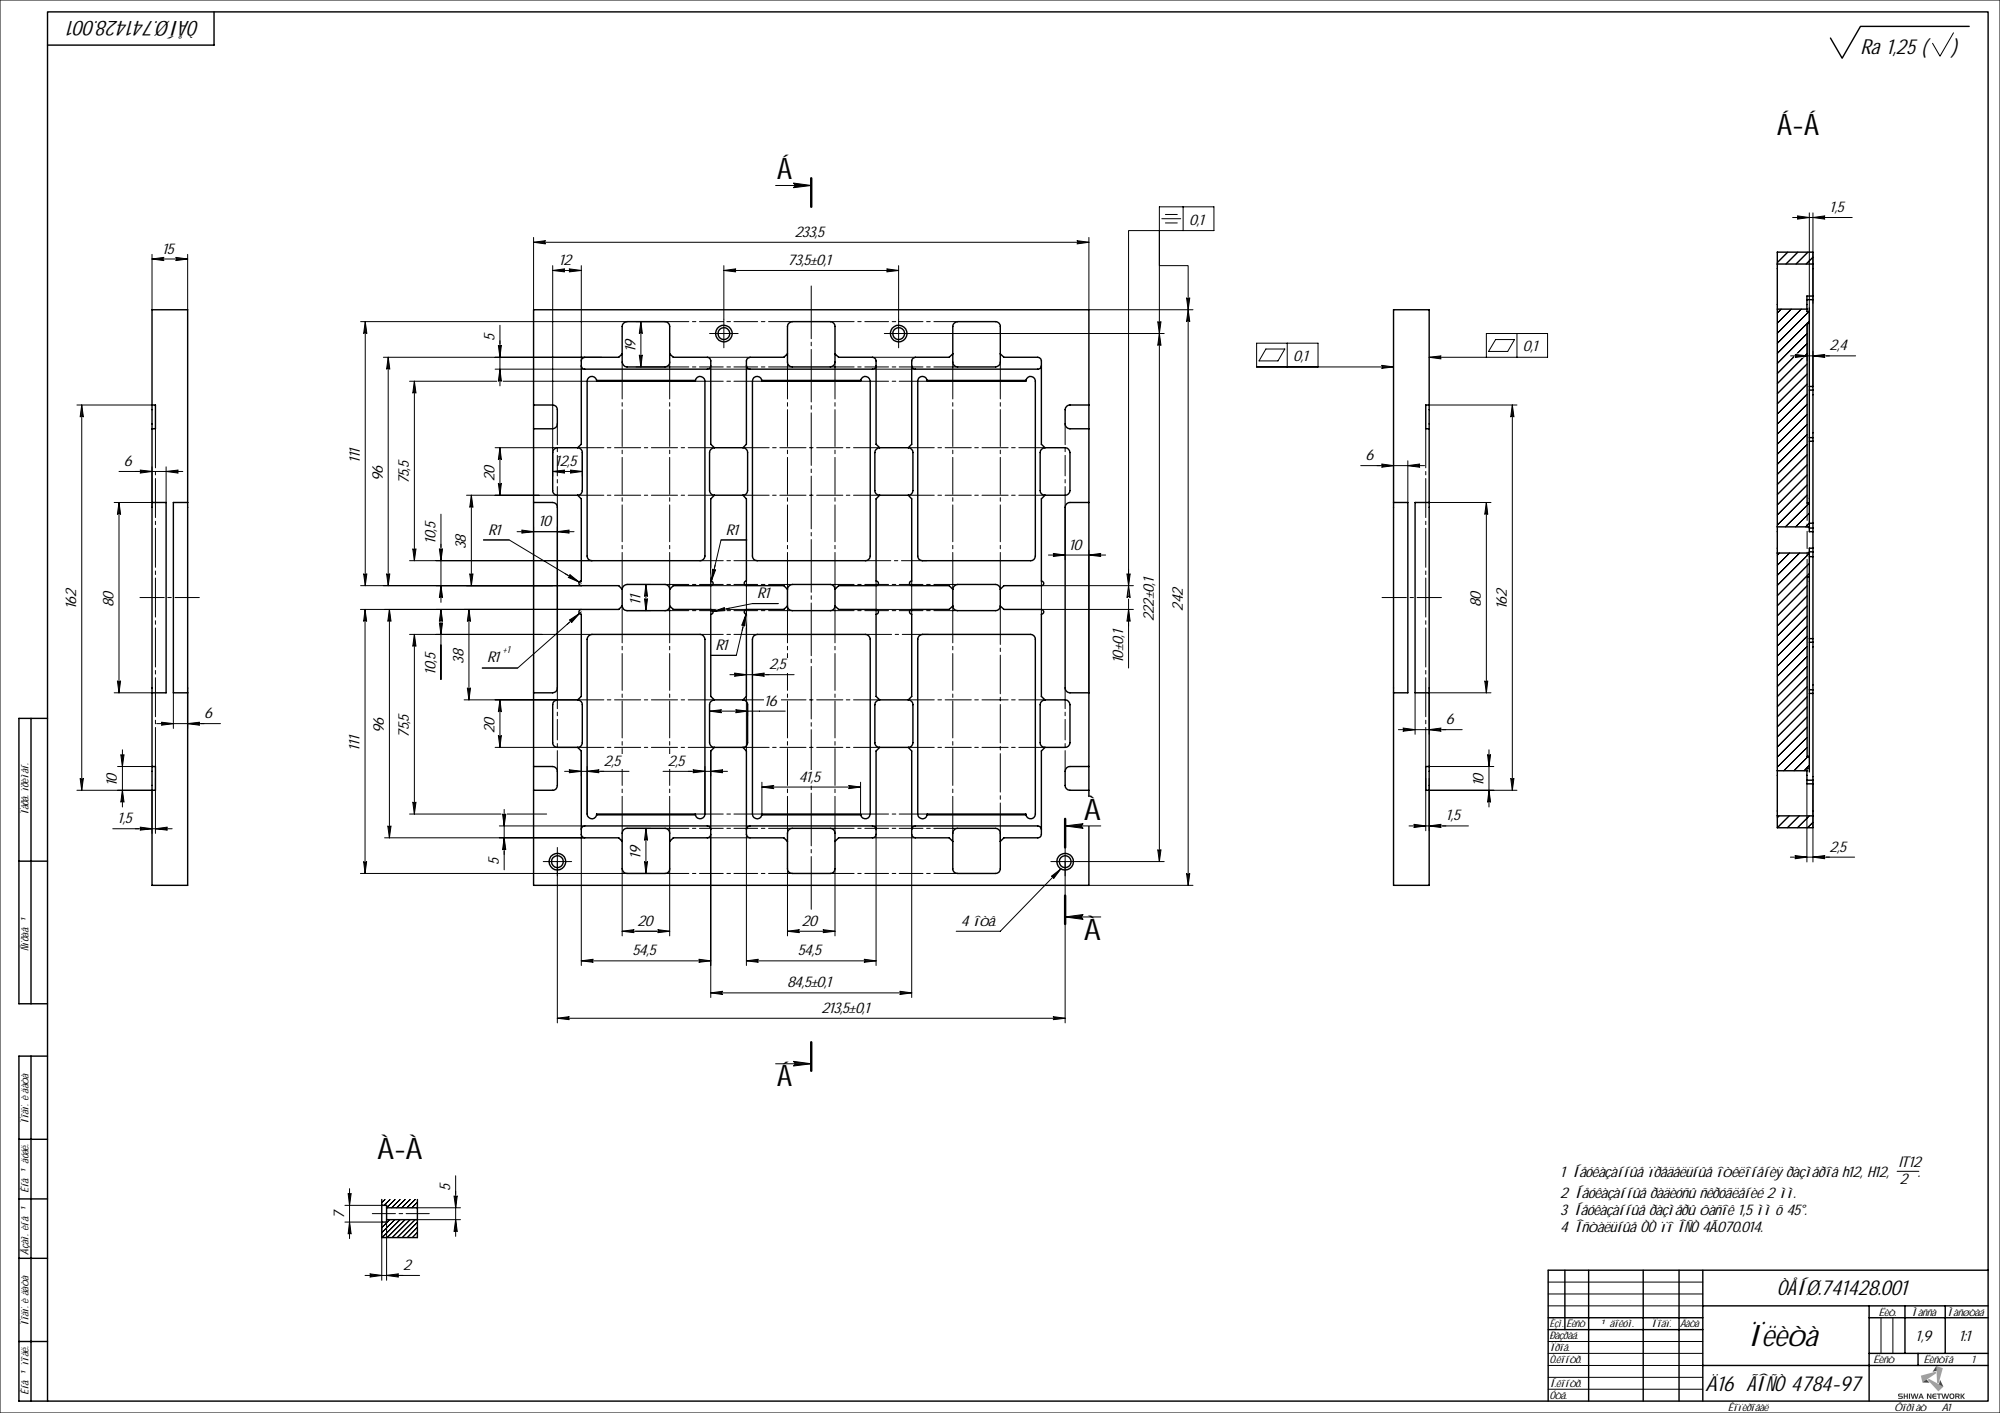
[picture p116: page 1]
4 îòâ.; Èíâ; Êîïèðîâàë; Ôîðìàò A1

¹ ïîäë. Ïîäï. è äàòà Âçàì. èíâ. ¹ Èíâ. ¹ äóáë. Ïîäï. è äàòà Ñïðàâ. ¹ Ïåðâ. ïðèìåí.

1 Íåóêàçàííûå ïðåäåëüíûå îòêëîíåíèÿ ðàçìåðîâ h12, H12,
2 Íåóêàçàííûå ðàäèóñû ñêðóãëåíèé 2 ìì.
3 Íåóêàçàííûå ðàçìåðû ôàñîê 1,5 ìì õ 45°.
4 Îñòàëüíûå ÒÒ ïî ÎÑÒ 4Ã.070.014.

ÒÅÍØ.741428.001

Ïëèòà | Ëèò. | Ìàññà | Ìàñøòàá

Èçì. Ëèñò | ¹ äîêóì. | Ïîäï. | Äàòà | | | 1,9 | 1:1 1
Ðàçðàá.
Ïðîâ.
Ò.êîíòð. | | | | Ëèñò | Ëèñòîâ

Í.êîíòð.
Óòâ.

Ä16 ÃÎÑÒ 4784-97
