SiwaNetwork/CASS/КД и ЭД/КД оснастка/Плита _ ТЕНШ.741428.002/Плита _ ТЕНШ.741428.002.pdf

ÃÃ

Á(2:1)

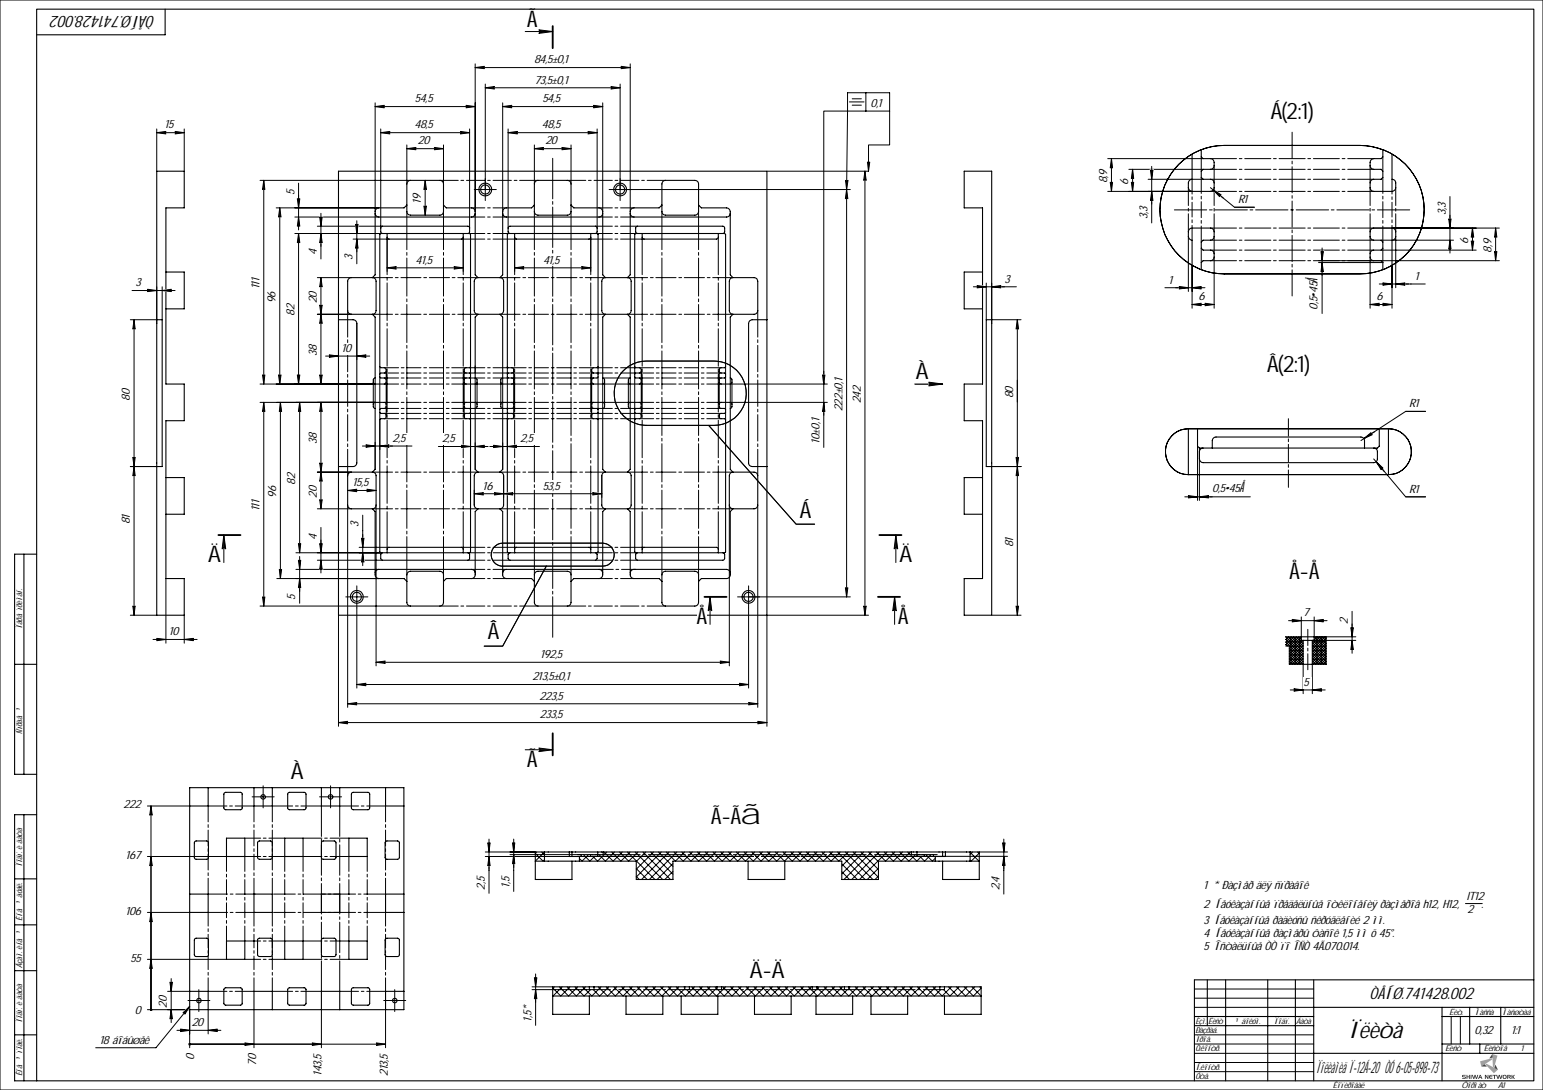
[picture p117: page 1]
18 áîáûøåê; Êîïèðîâàë; Ôîðìàò A1

Èíâ. ¹ ïîäë. Ïîäï. è äàòà Âçàì. èíâ. ¹ Èíâ. ¹ äóáë. Ïîäï. è äàòà Ñïðàâ. ¹ Ïåðâ. ïðèìåí.

1 * Ðàçìåð äëÿ ñïðàâîê
2 Íåóêàçàííûå ïðåäåëüíûå îòêëîíåíèÿ ðàçìåðîâ h12, H12,
3 Íåóêàçàííûå ðàäèóñû ñêðóãëåíèé 2 ìì.
4 Íåóêàçàííûå ðàçìåðû ôàñîê 1,5 ìì õ 45°.
5 Îñòàëüíûå ÒÒ ïî ÎÑÒ 4Ã.070.014.

ÒÅÍØ.741428.002

Ïëèòà | Ëèò. | Ìàññà | Ìàñøòàá

Èçì. Ëèñò | ¹ äîêóì. | Ïîäï. | Äàòà | | | 0,32 | 1:1 1
Ðàçðàá.
Ïðîâ.
Ò.êîíòð. | | | | Ëèñò | Ëèñòîâ

Í.êîíòð.
Óòâ.

Ïîëèàìèä Ï-12Á-20 ÒÓ 6-05-898-73
