SiwaNetwork/CASS/КД и ЭД/КД оснастка/Штырь_ТЕНШ.716611.001/Штырь_ТЕНШ.716611.001.pdf

| 25

13 2

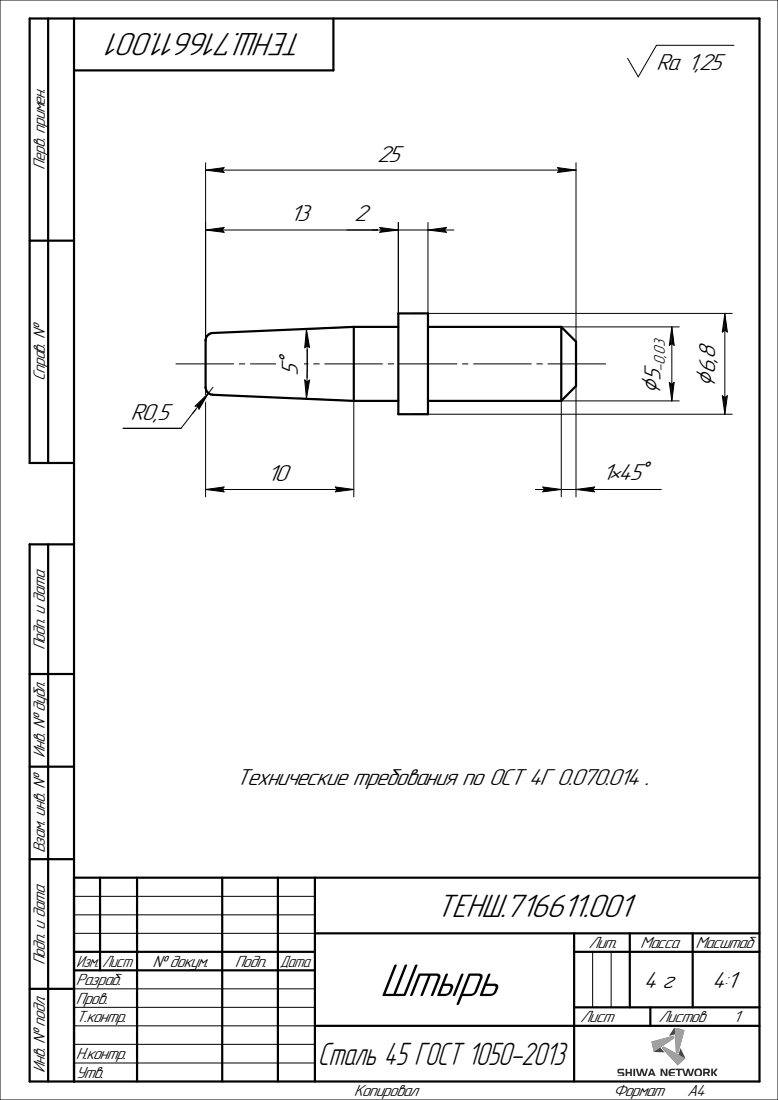
[picture p118: page 1]
Копировал; Формат A4

1 Инв. № подл. Подп. и дата Взам. инв. № Инв. № дубл. Подп. и дата Справ. № Перв. примен.

Технические требования по ОСТ 4Г 0.070.014 .

ТЕНШ.716611.001

Штырь | Лит. | Масса | Масштаб

Изм. Лист | № докум. | Подп. | Дата | | | | | 4 г | 4:1
Разраб.
Пров.
Т.контр. | | | | Лист | Листов

Сталь 45 ГОСТ 1050-2013

Н.контр.
Утв.
