SiwaNetwork/CASS/CAM_LATTICE_STM/ECAD/cam_dvb_ci_v2.03/Output/CAM_DVB-CI_v2.03_release_Revision_ SCH 2025-09-01 20-58.PDF

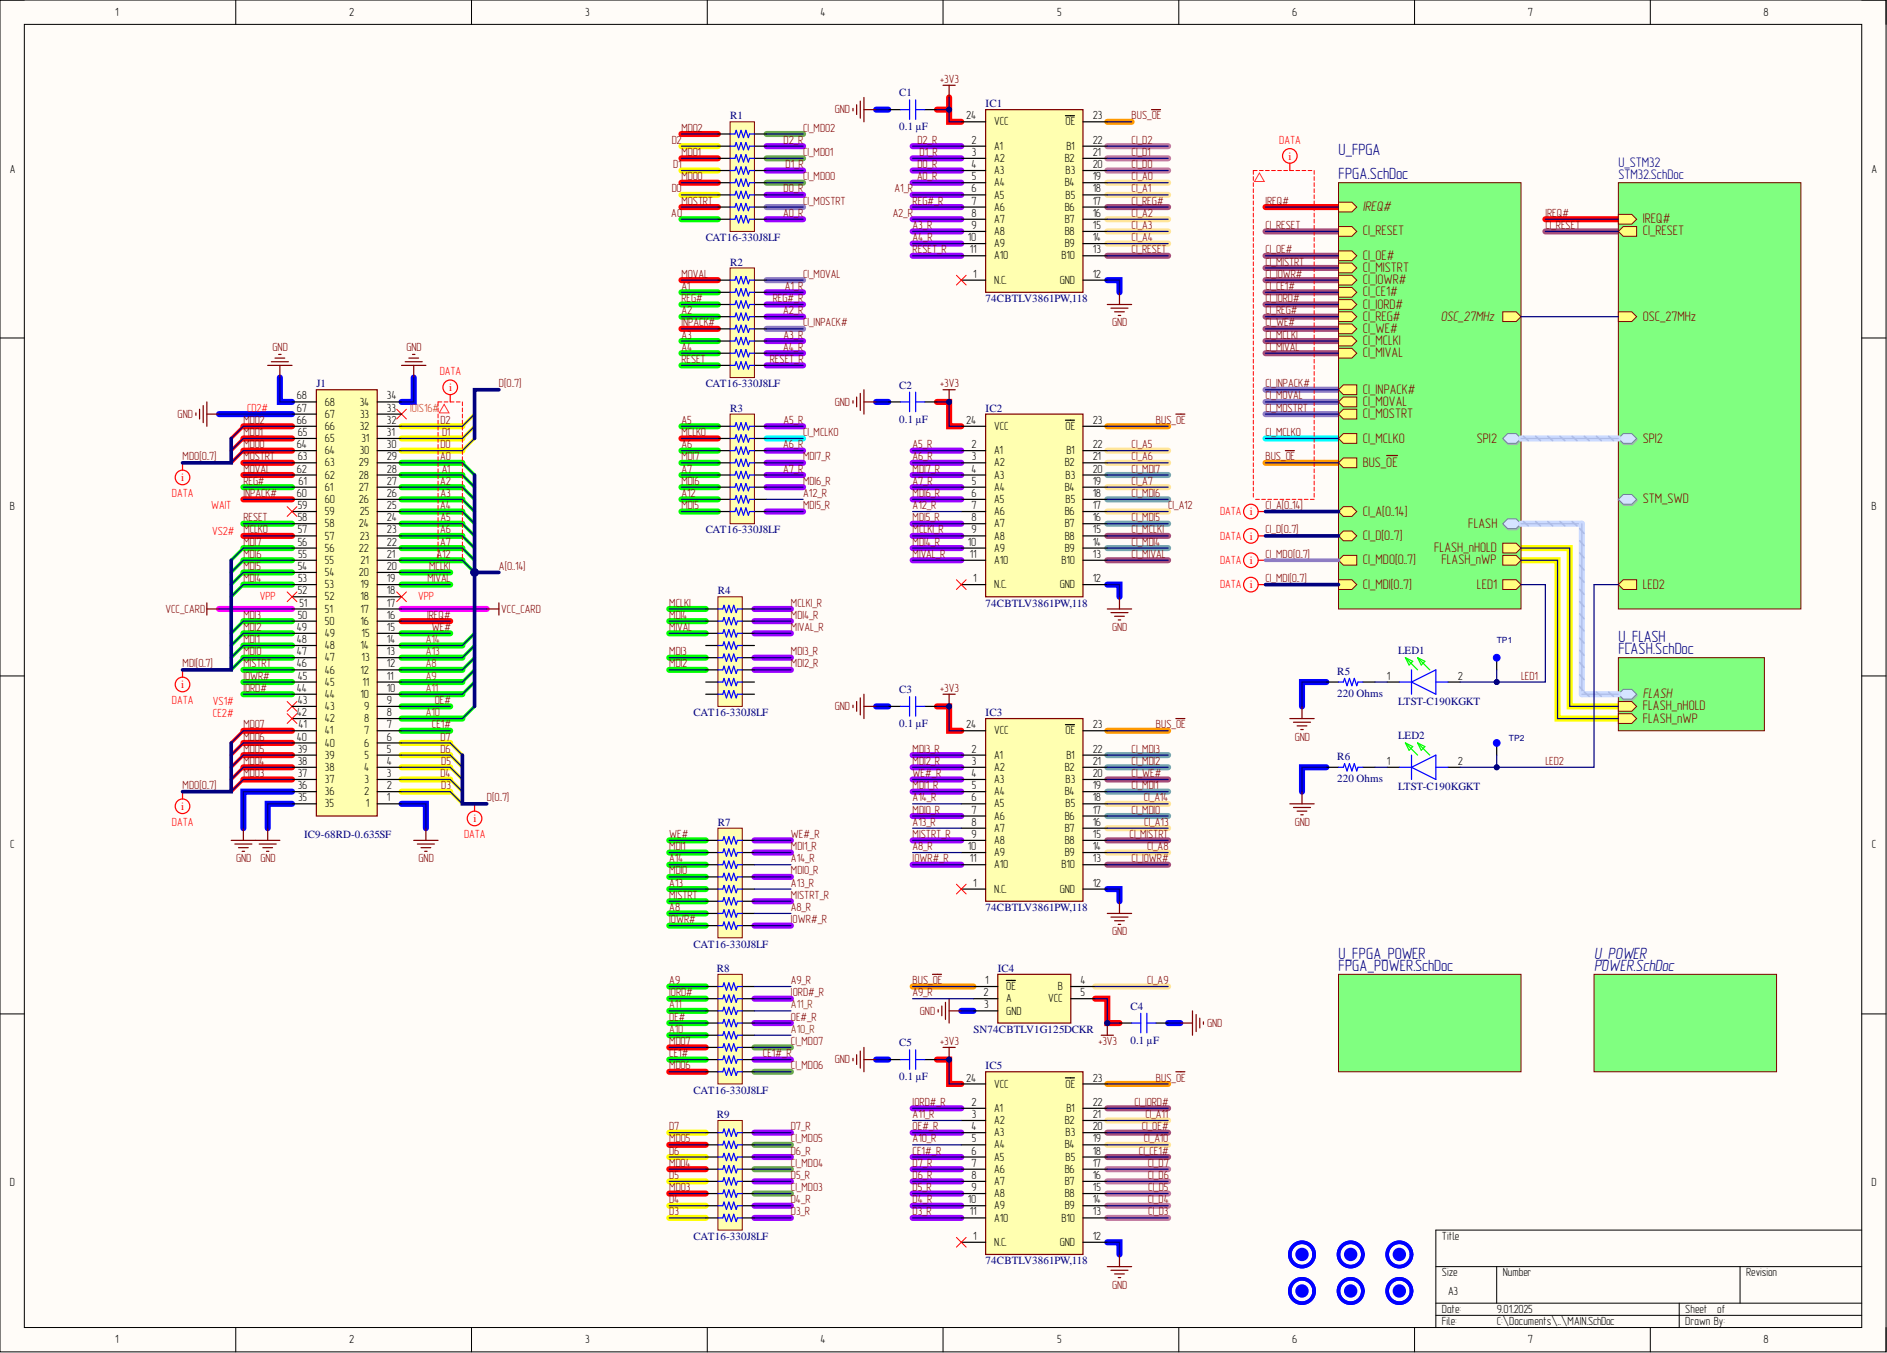
[picture p120: page 1]

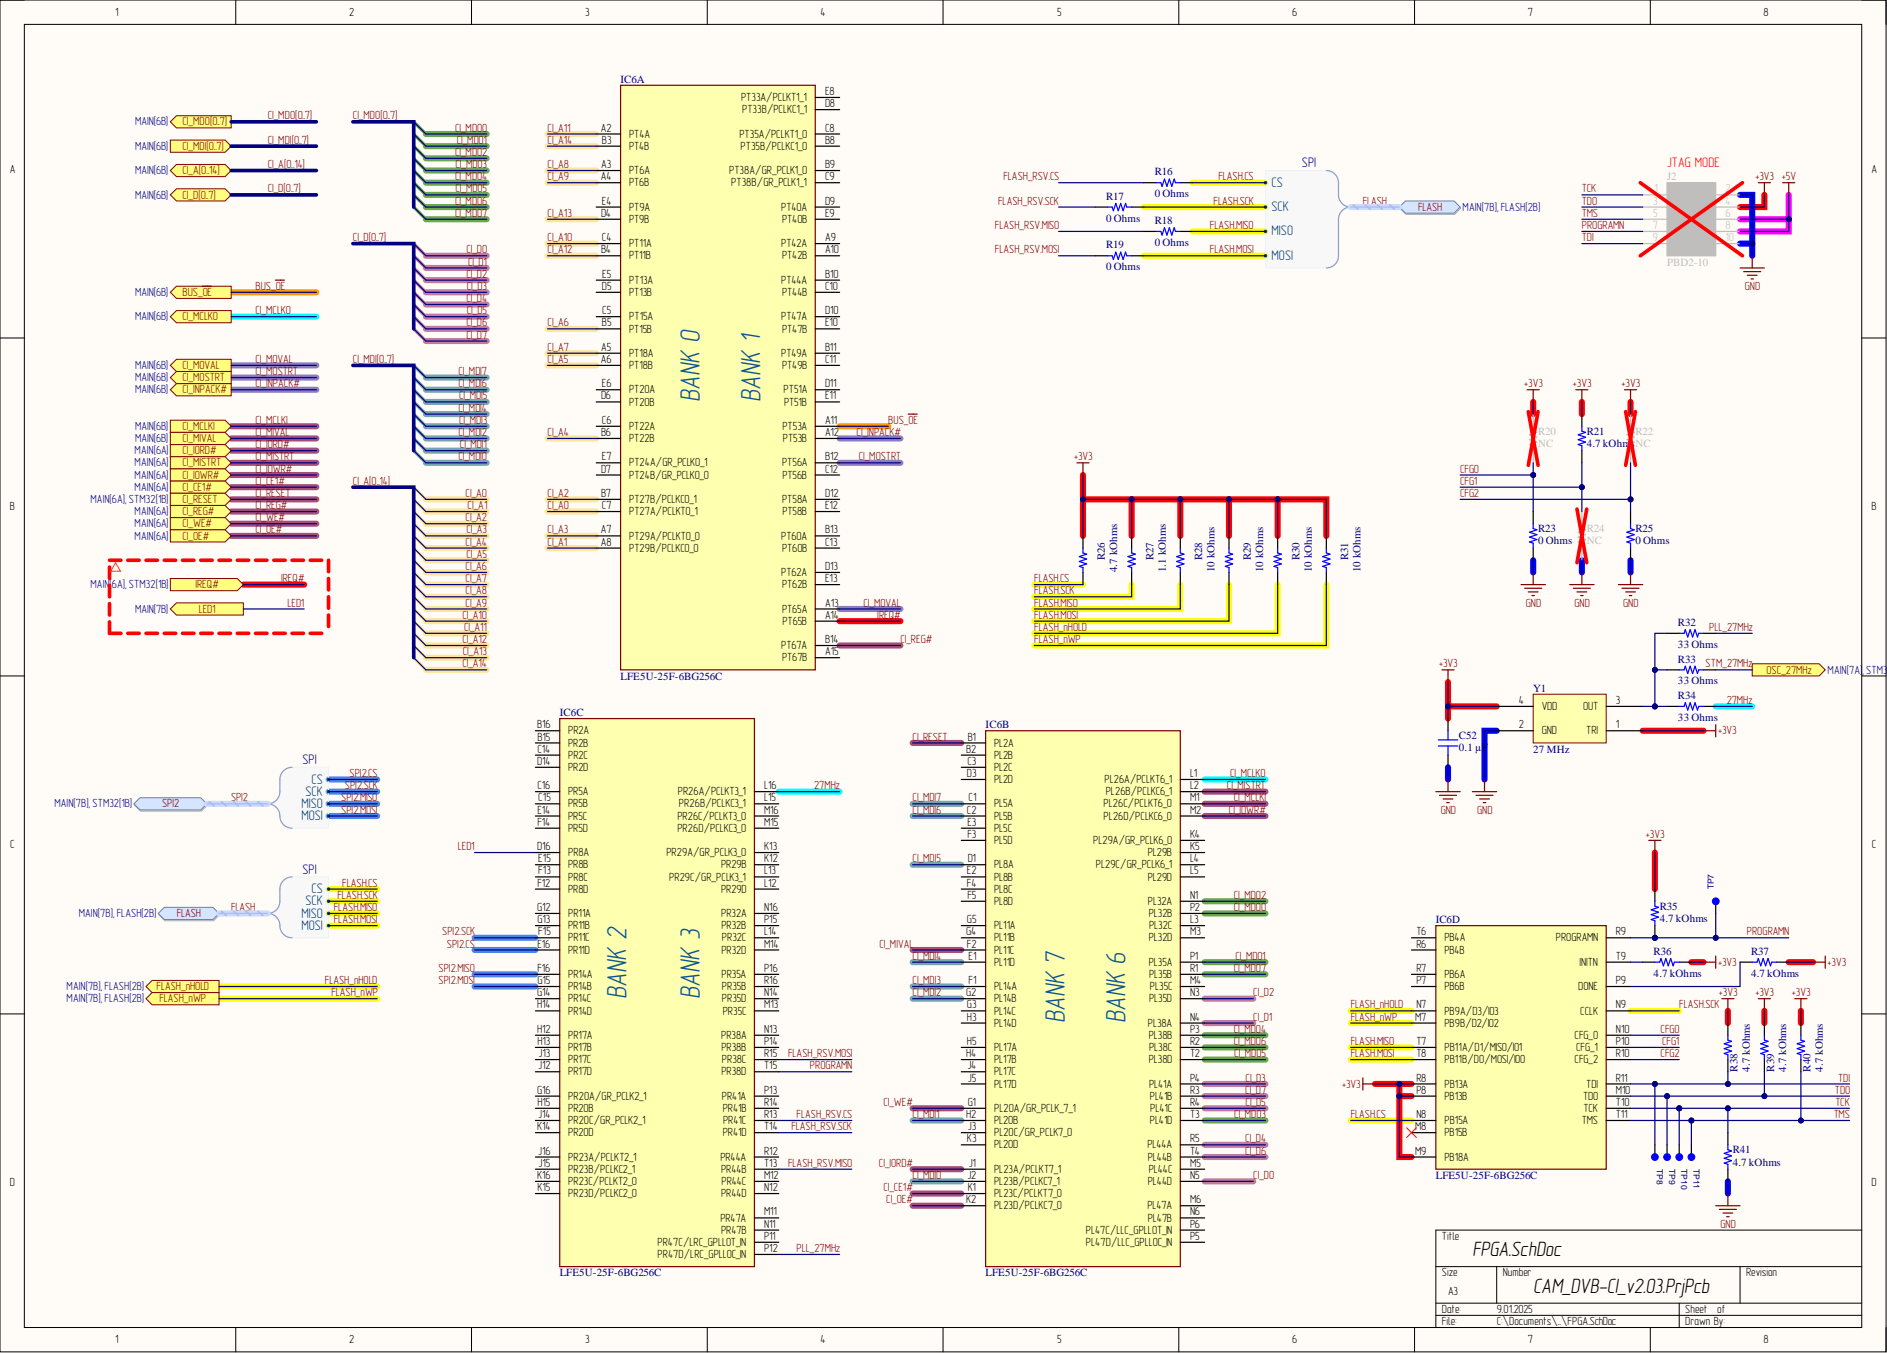
[picture p121: page 2]

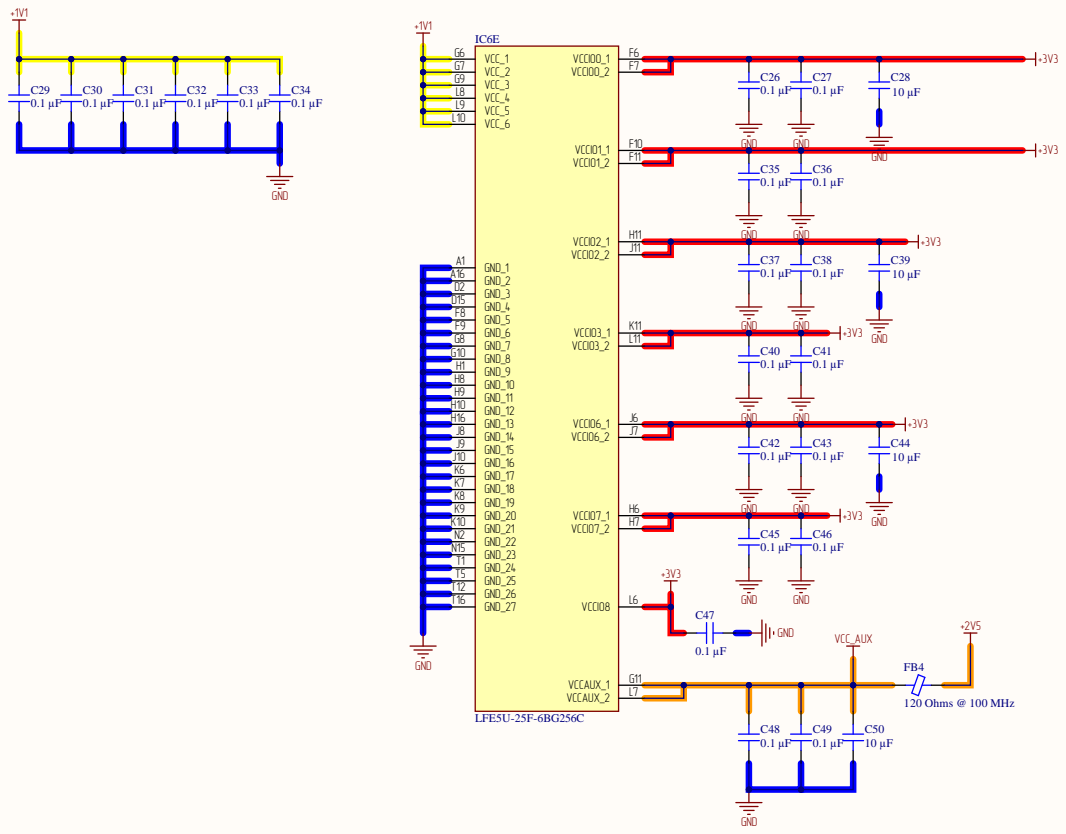
[picture p122: page 3]

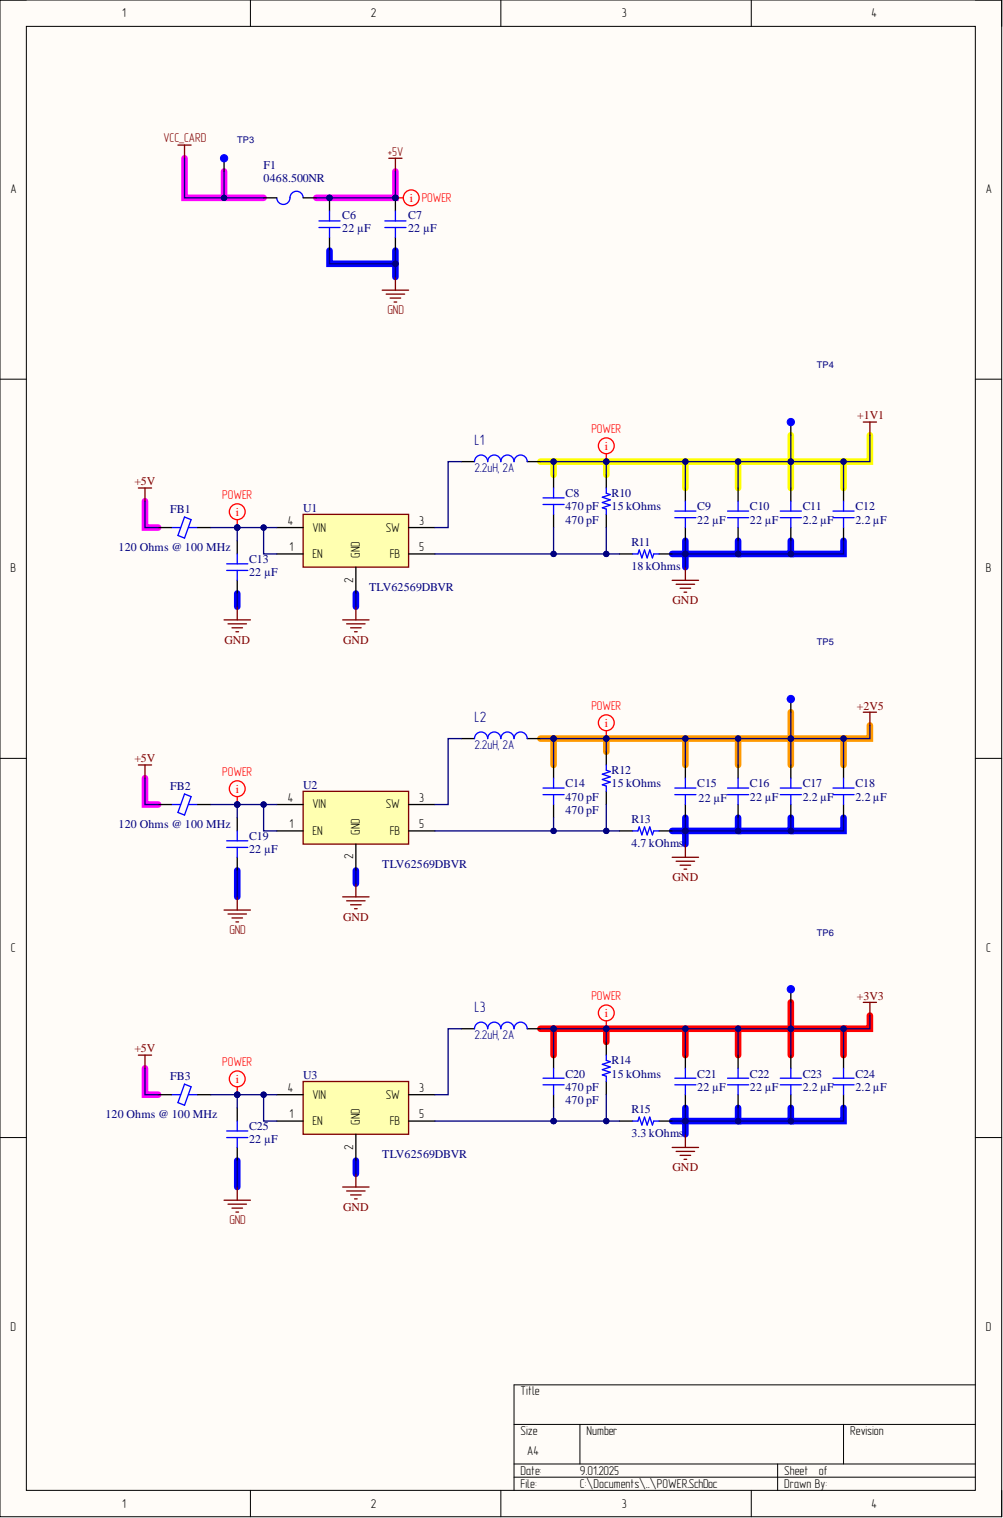
[picture p123: page 4]

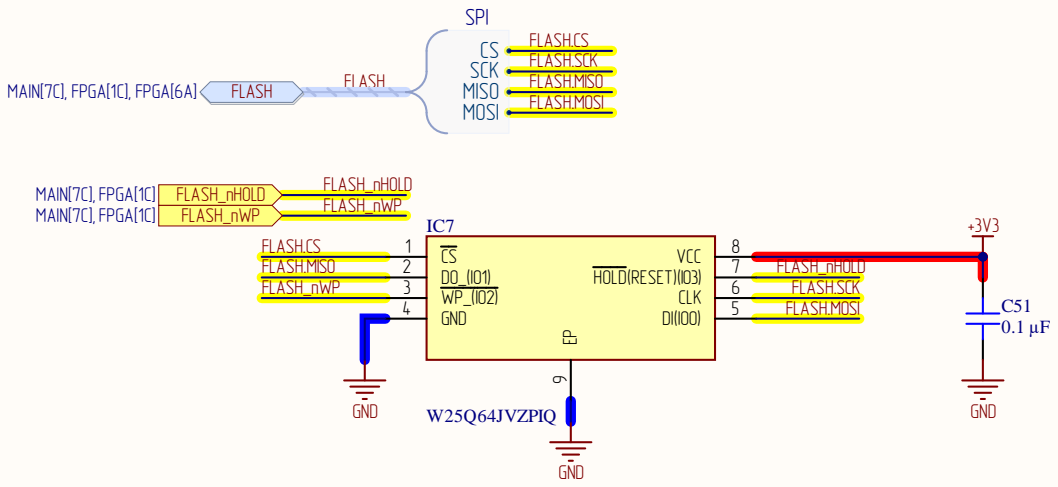
[picture p124: page 5]

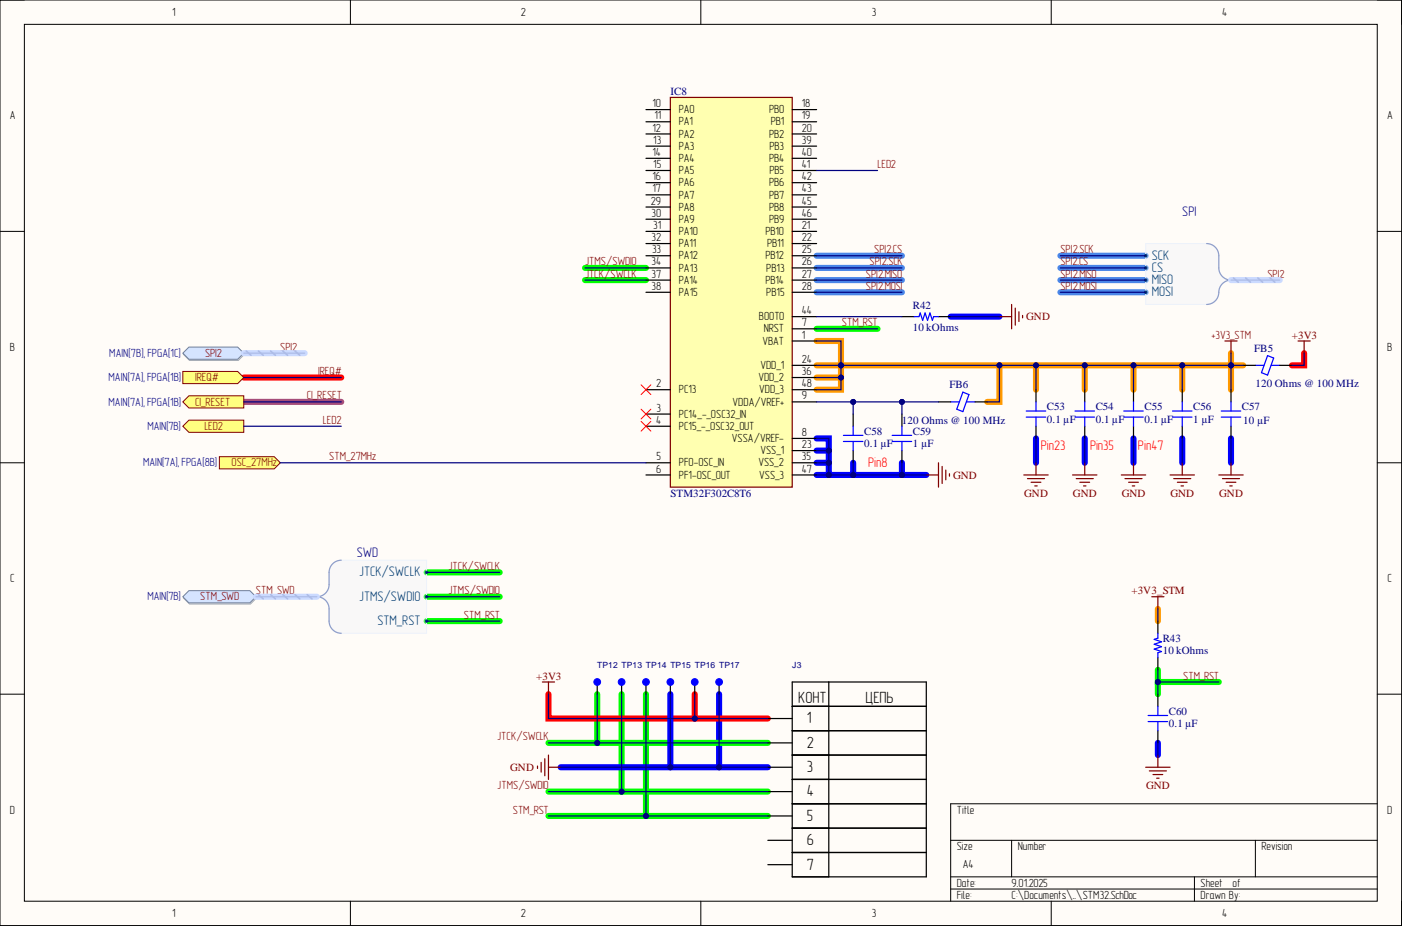
[picture p125: page 6]

SWD
JTCK/SWCLK

КОНТ | ЦЕПЬ
