SiwaNetwork/CASS/CAM-ALTERA_STM/V1.3/ECAD/REFERENCE.pdf

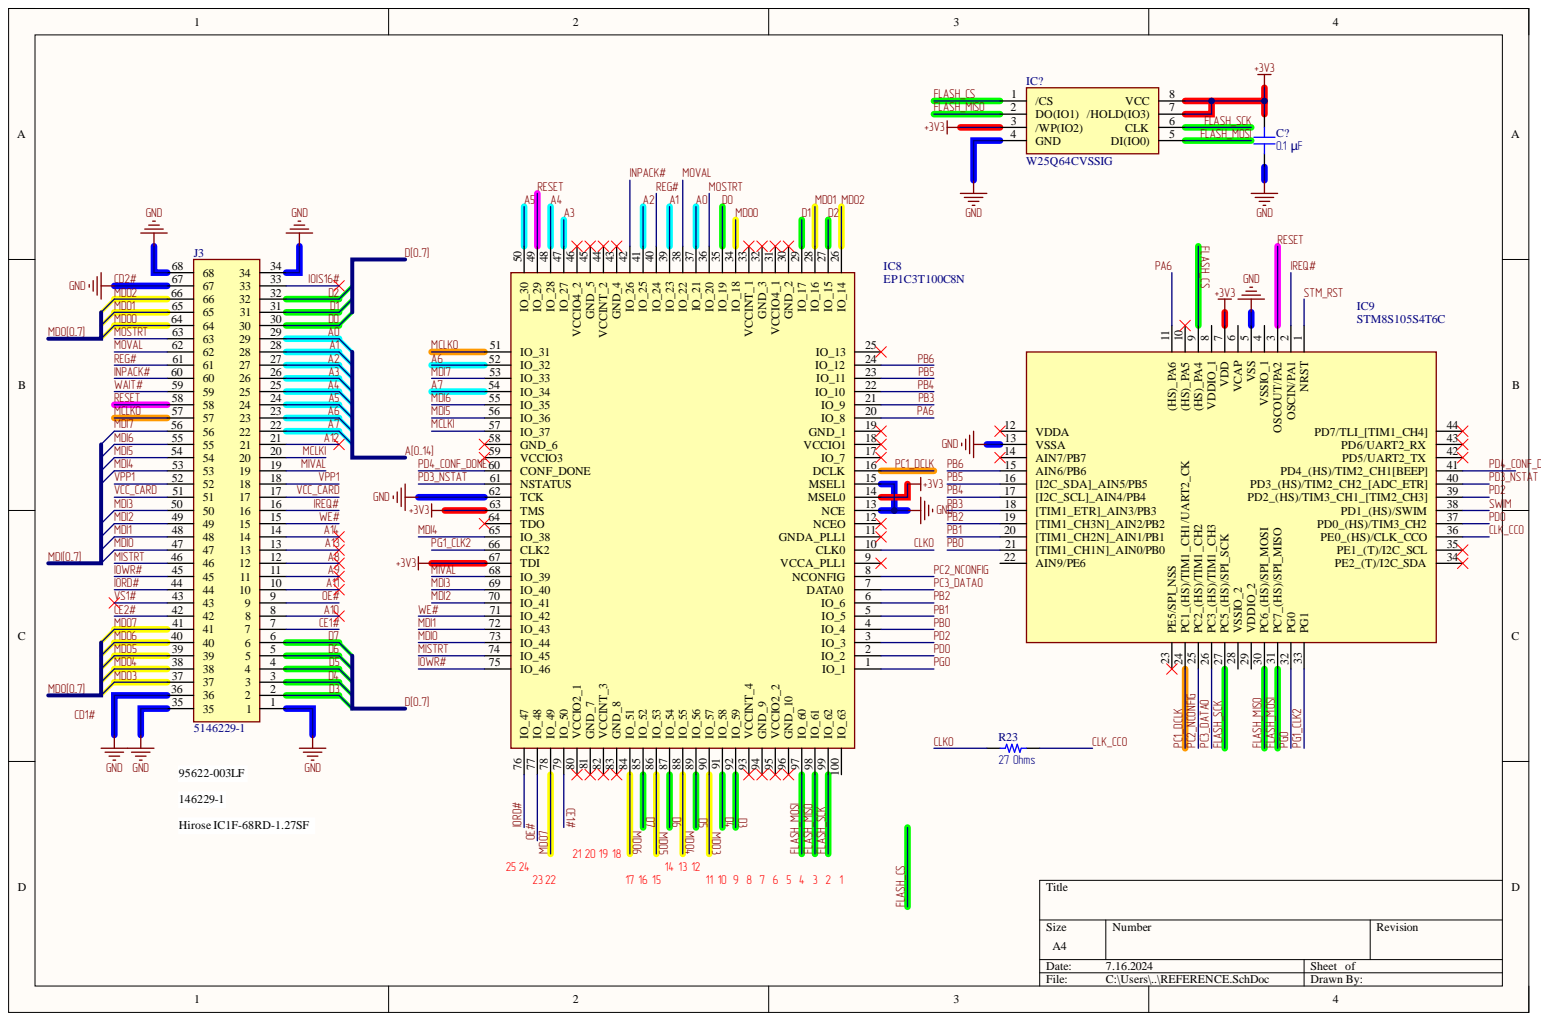
[picture p133: page 1]

NRST 1 OSCIN/PA1 2 OSCOUT/PA2 3 VSSIO_1 4 VSS 5 VCAP 6 VDD 7 VDDIO_1 8 (HS)_PA4 9 (HS)_PA5 10 (HS)_PA6 11

PG1 33 PG0 32 PC7_(HS)/SPI_MISO 31 PC6_(HS)/SPI_MOSI 30 VDDIO_2 29 VSSIO_2 28 PC5_(HS)/SPI_SCK 27 PC3_(HS)/TIM1_CH3 26 PC2_(HS)/TIM1_CH2 25 PC1_(HS)/TIM1_CH1/UART2_CK 24 PE5/SPI_NSS 23
