SiwaNetwork/CASS/CAM-ALTERA_STM/V1.1/VM_CAM_DVB-CI/CAM_DVB-CI.pdf

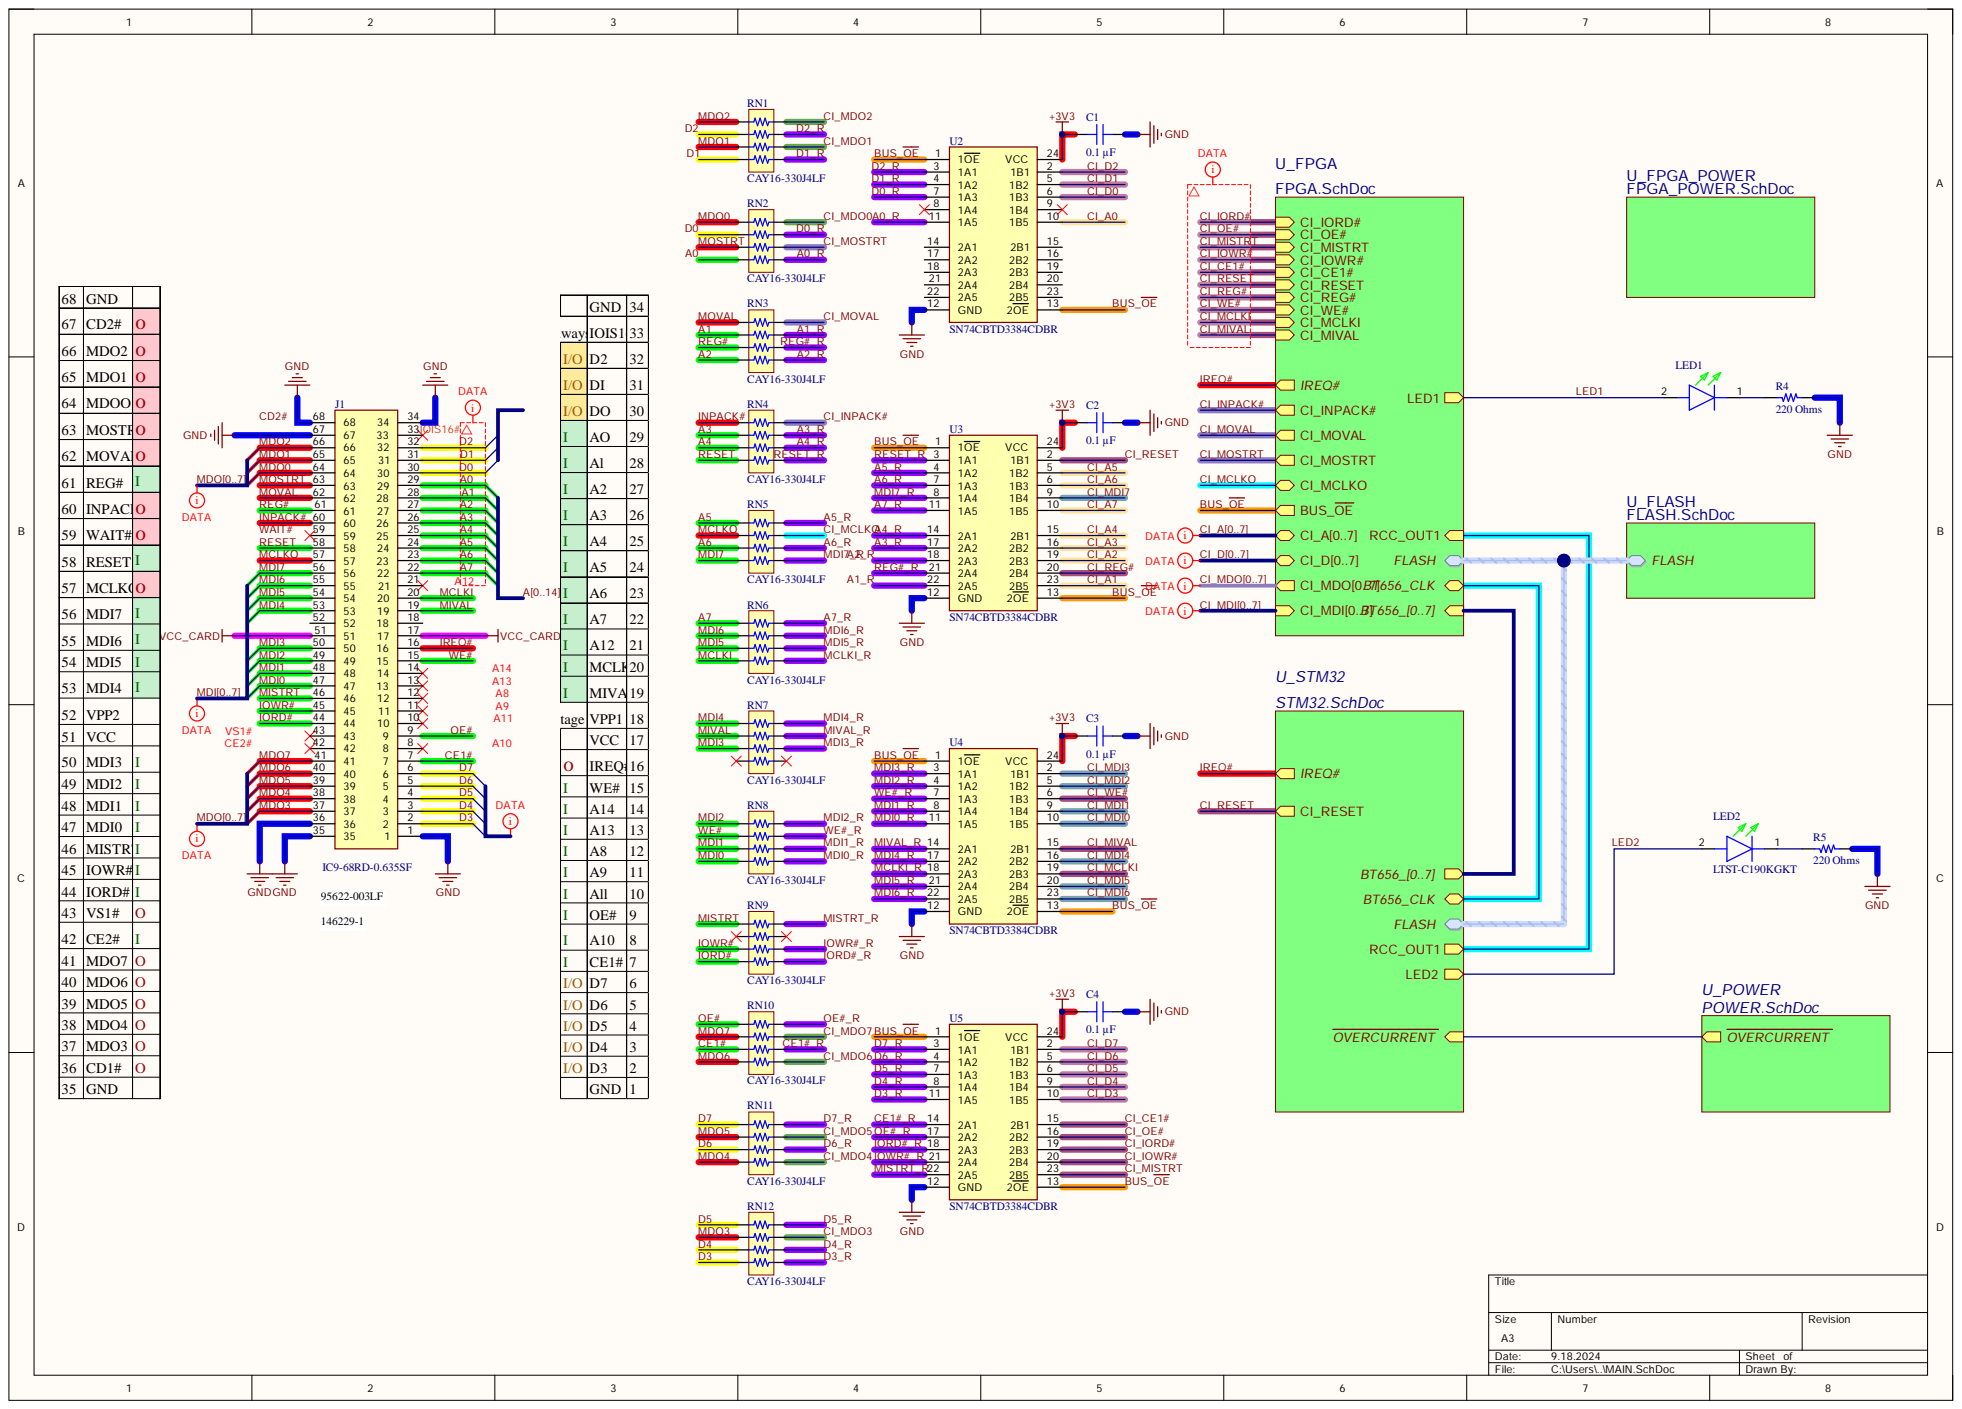
[picture p134: page 1]

6 6 | MDO2 | o

6 5 | MDO1 | o

6 4 | MDOO | o

6 3 | TRTo MOS

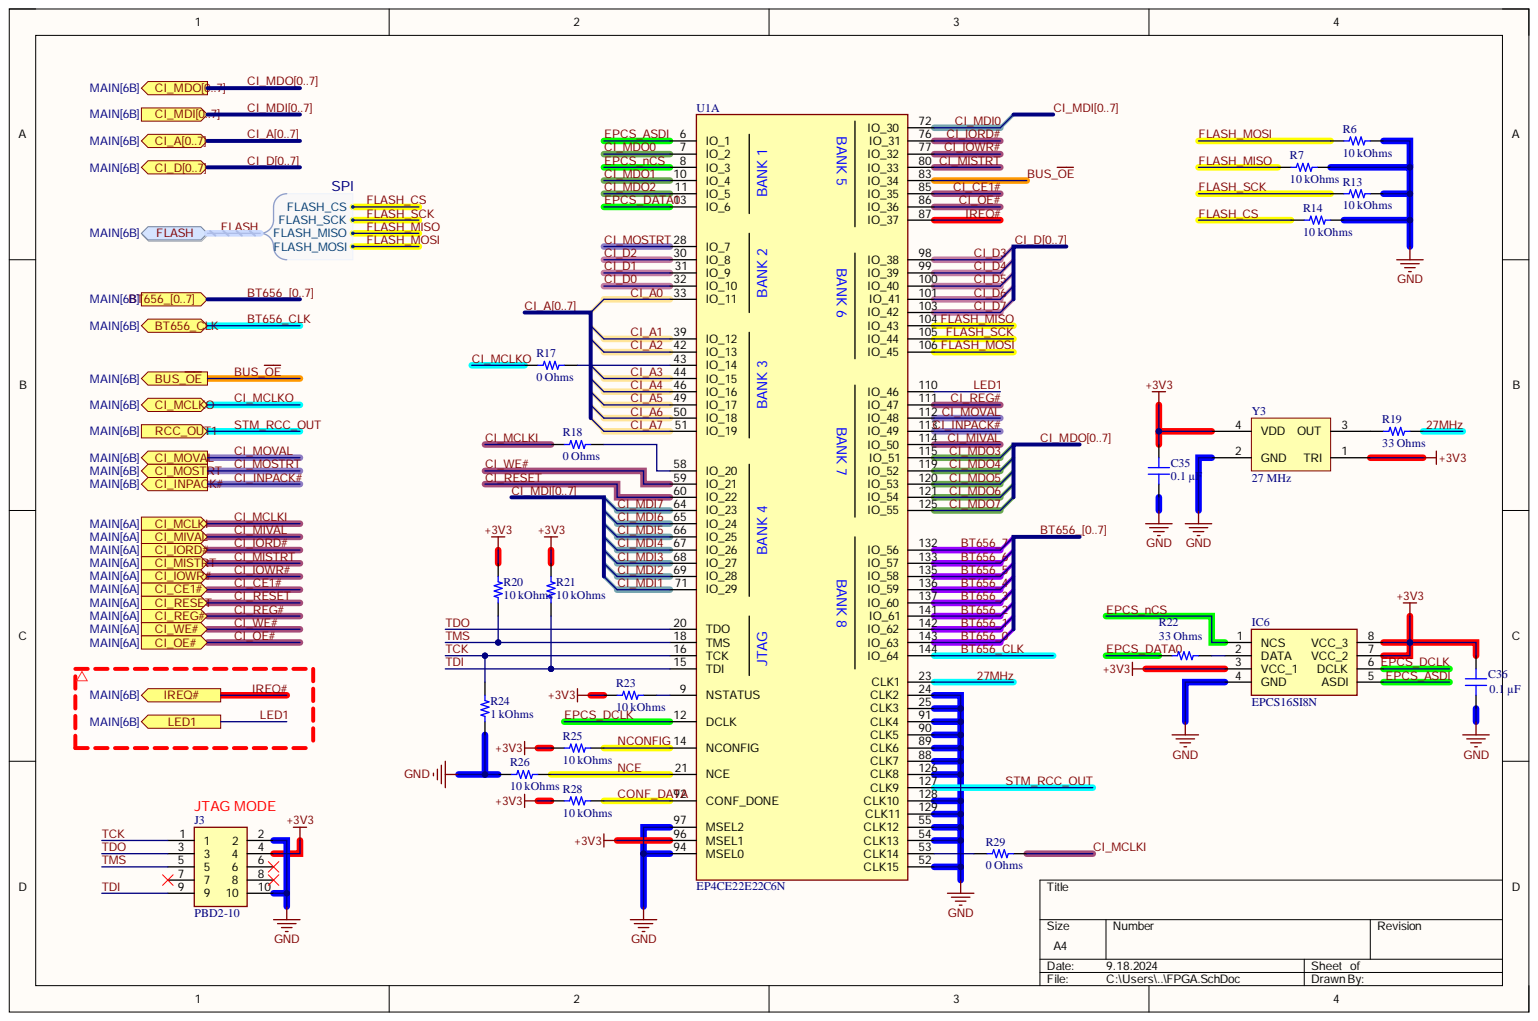
[picture p135: page 2]

BANK 5 BANK 6 BANK 7 BANK 8

C I_R E S E T
C I_M D I [0. . 7 ]

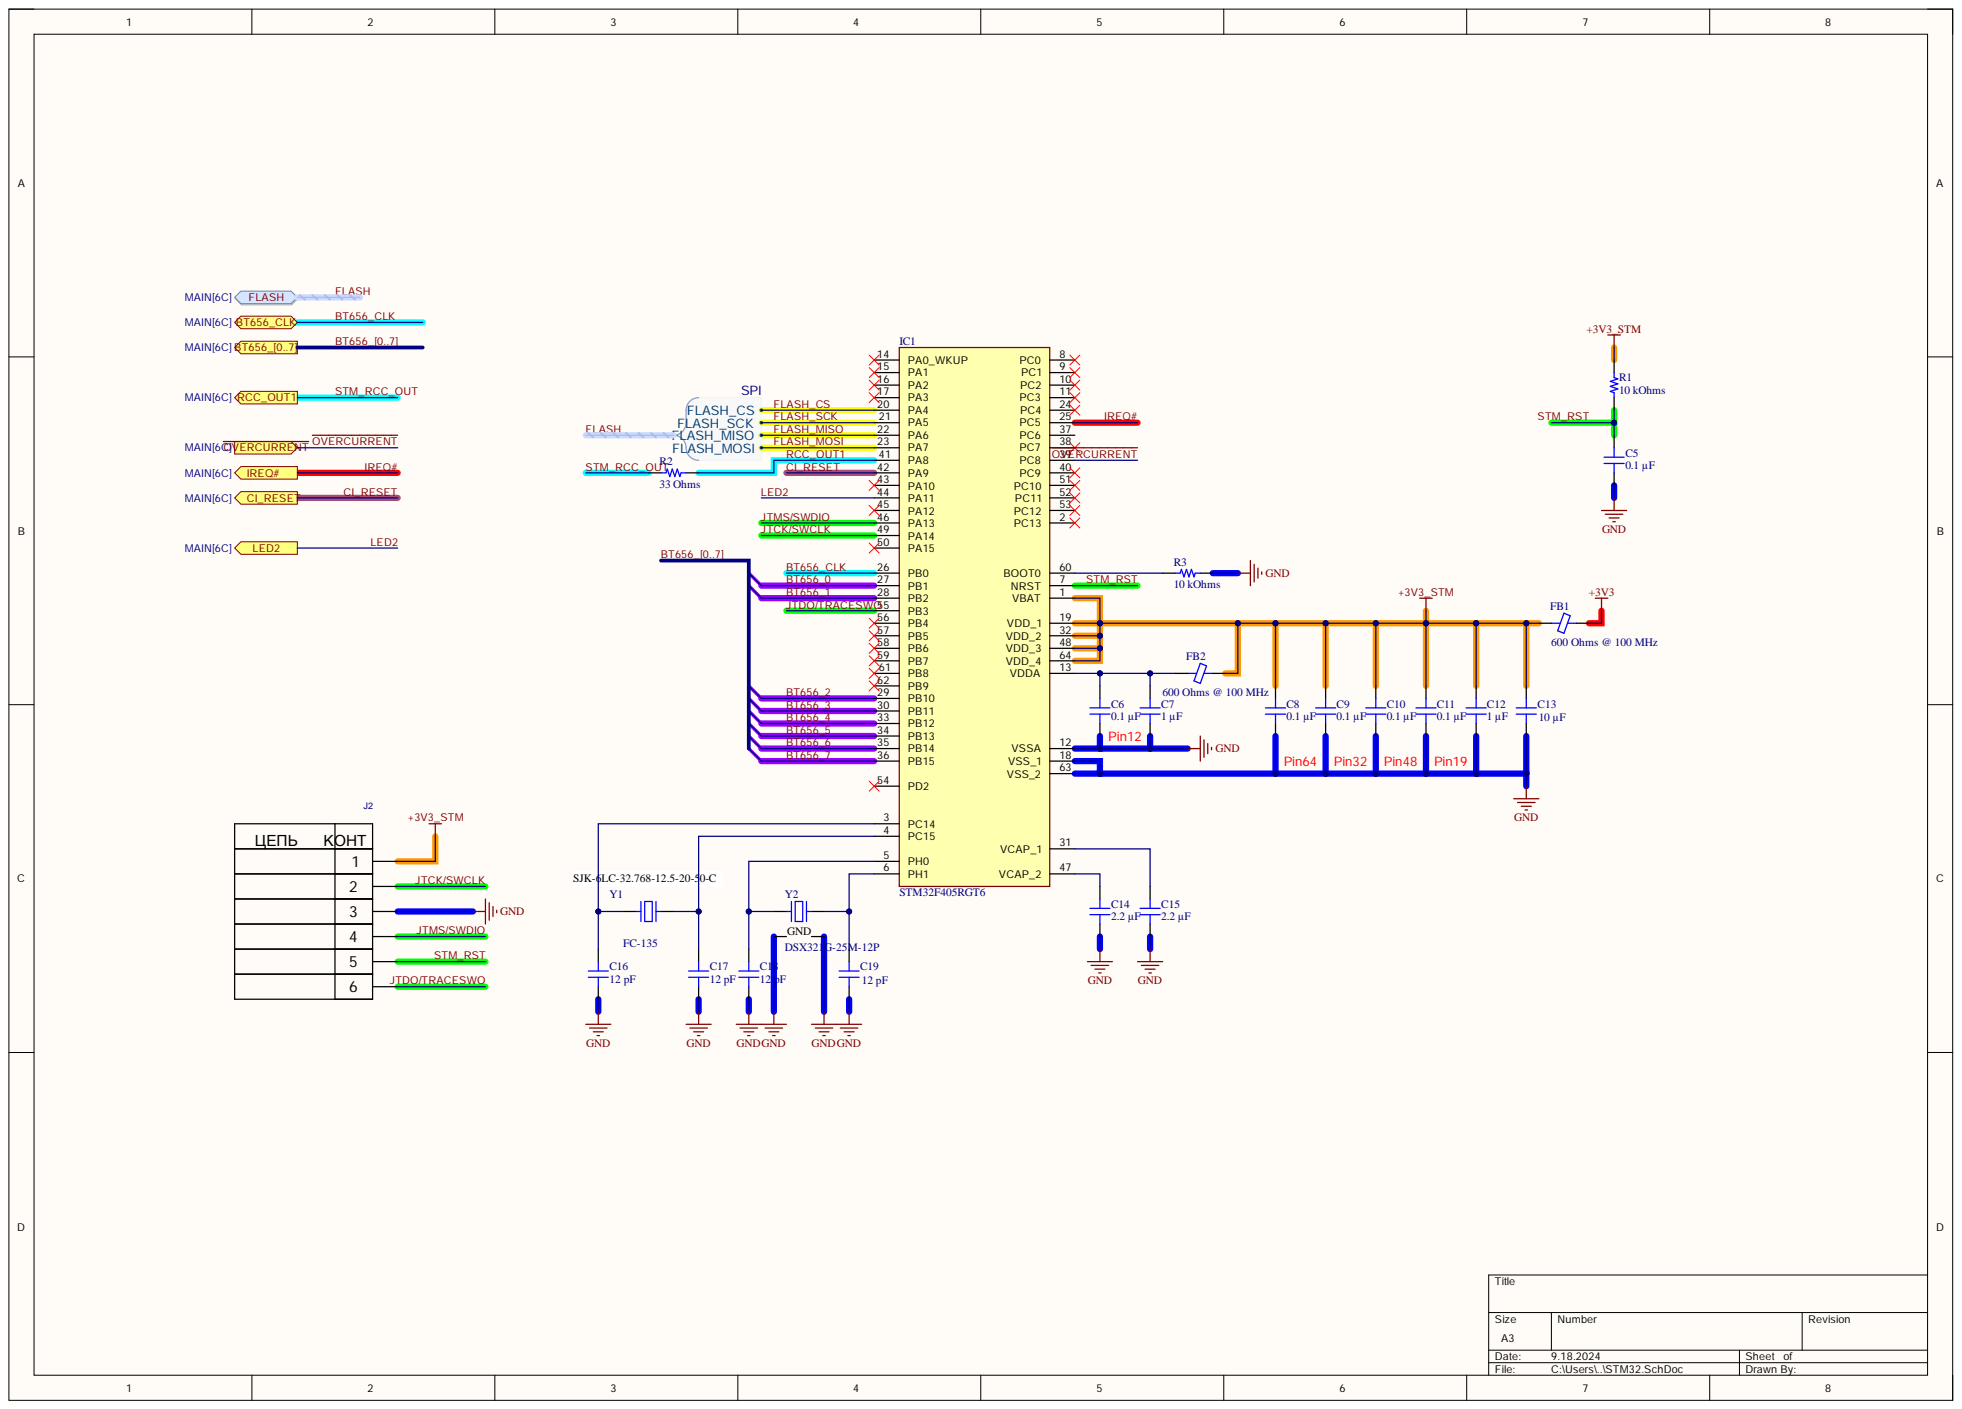
[picture p136: page 3]

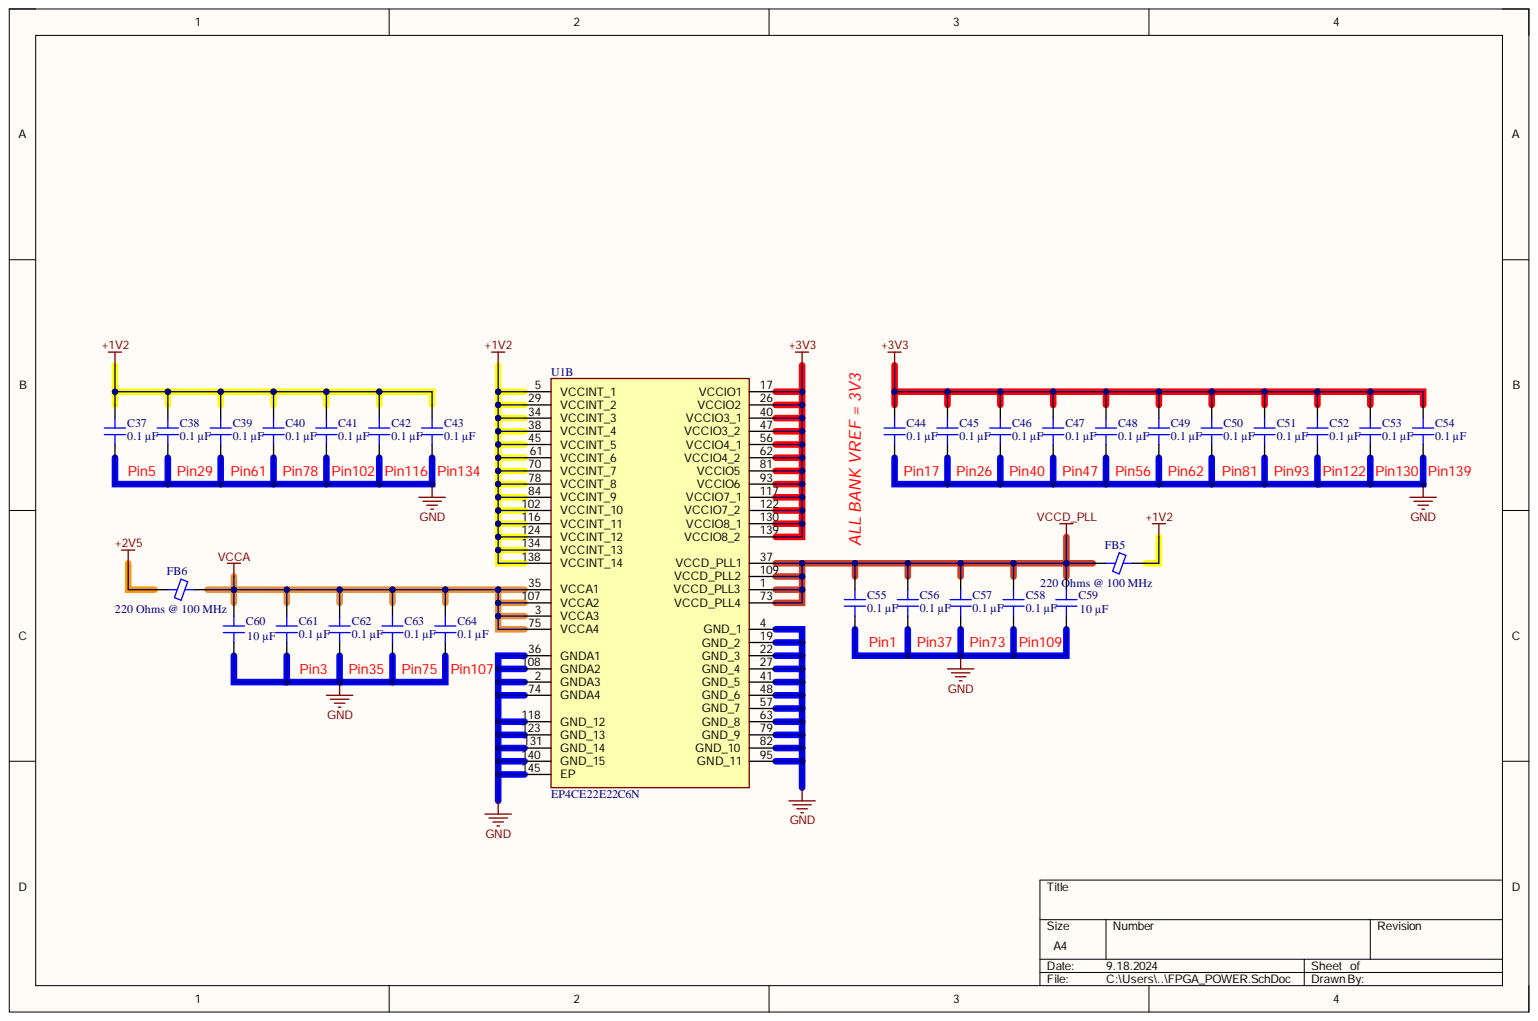
[picture p137: page 4]

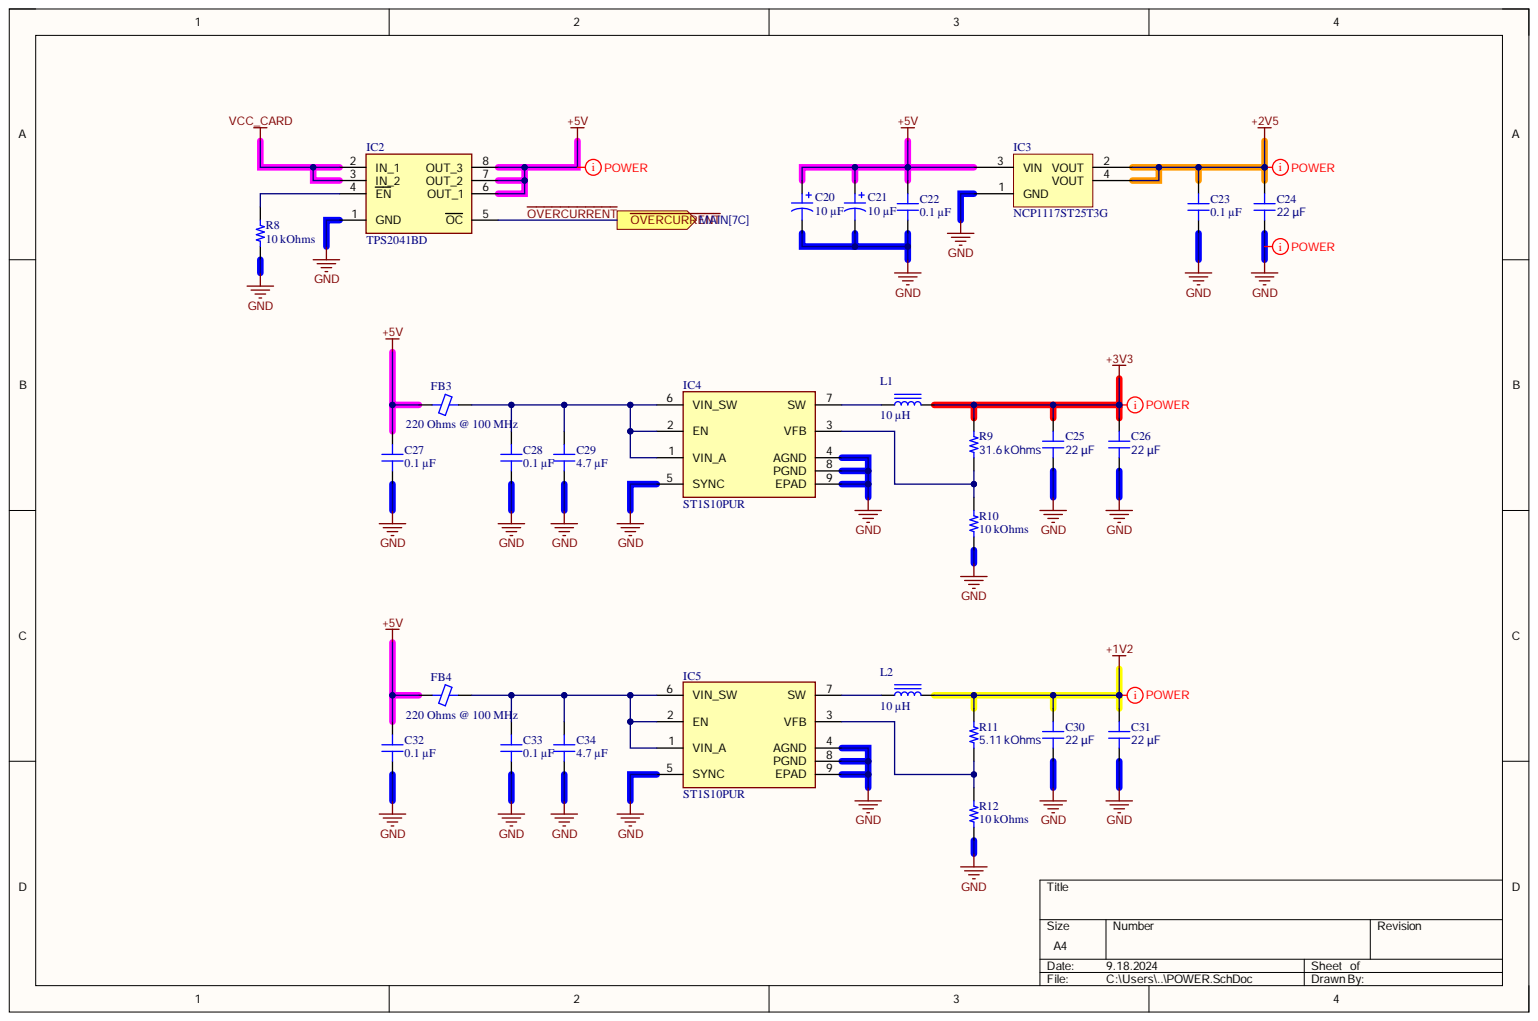
[picture p138: page 5]

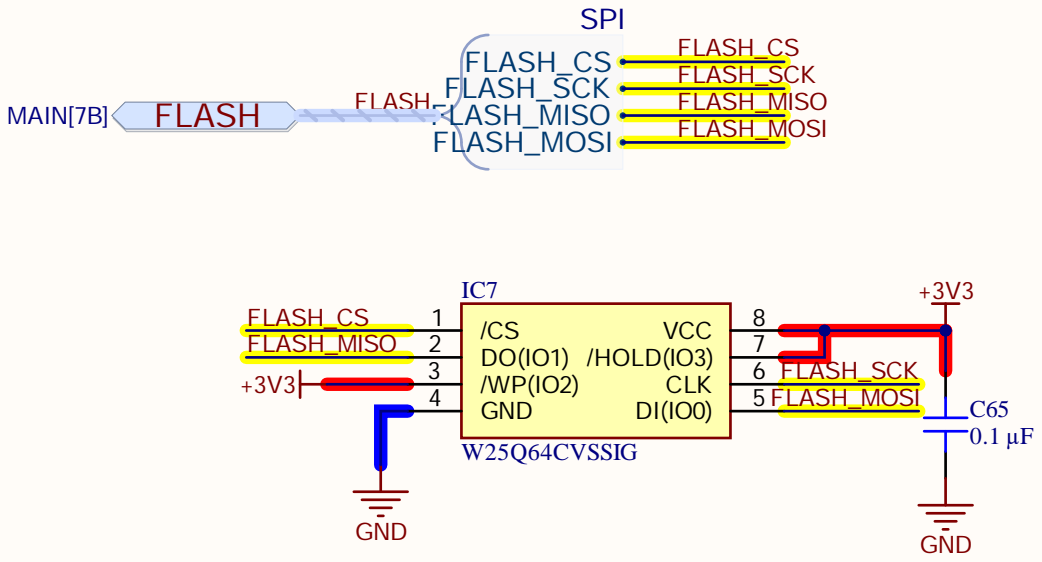
[picture p139: page 6]

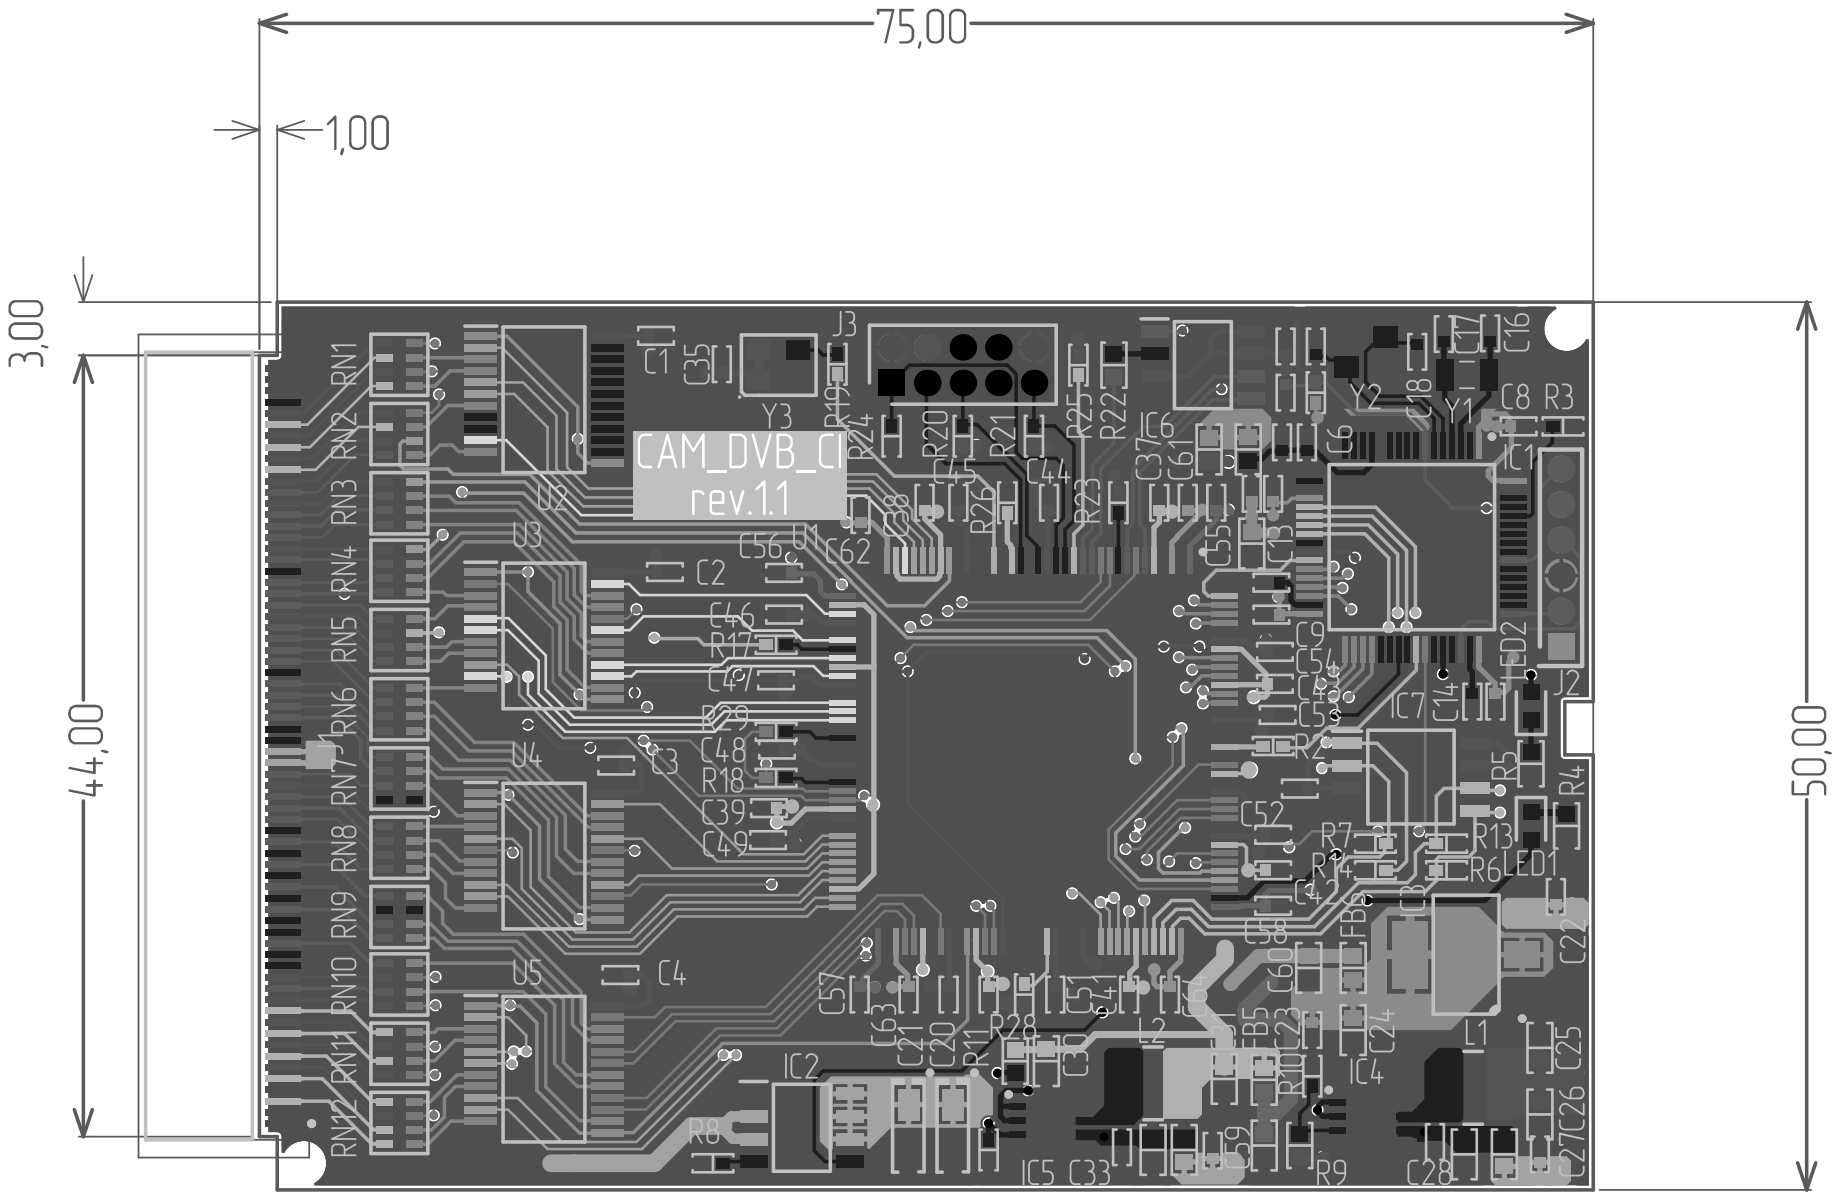
[picture p140: page 7]

Comment | Description | Designator | Footprint | LibRef | Quantity
0.1 µF | CAP CER 0.1UF 16V X7R 0402 | C1, C2, C3, C4, C5, C6, C8, C9, C10, C11, C22, C23, C27, C28, C32, C33, C35, C36, C37, C38, C39, C40, C41, C42, C43, C44, C45, C46, C47, C48, C49, C50, C51, C52, C53, C54, C55, C56, C57, C58, C61, C62, C63, C64, C65 | CAP 0402_1005 | CC0402KRX7R7BB104 | 45
1 µF | CAP CER 1UF 10V X5R 0402 | C7, C12 | CAP 0402_1005 | CC0402KRX5R6BB105 | 2
CC0603KRX5R6BB106 | CAP CER 10UF 10V X5R 0603 | C13, C59, C60 | CAP 0603_1608 | CC0603KRX5R6BB106 | 3
2.2 µF | CAP CER 2.2UF 10V X5R 0402 | C14, C15 | CAP 0402_1005 | CC0402KRX5R6BB225 | 2
12 pF | CAP CER 12PF 50V C0G/NPO 0402 | C16, C17, C18, C19 | CAP 0402_1005 | CC0402FRNPO9BN12 0 | 4
10 µF | CAP TANT 10UF 10% 16V 1206 | C20, C21 | CAP POL 1206_3216 | T494A106K016AT | 2
22 µF | CAP CER 22UF 6.3V X5R 0603 | C24, C25, C26, C30, C31 | CAP 0603_1608 | CC0603MRX5R5BB22 6 | 5
4.7 µF | CAP CER 4.7UF 10V X5R 0603 | C29, C34 | CAP 0603_1608 | CC0603KRX5R6BB475 | 2
600 Ohms @ 100 MHz | FERRITE BEAD 600 OHM 0603 1LN | FB1, FB2 | FER 0603_1608 | BLM18KG601SN1D | 2
220 Ohms @ 100 MHz | FERRITE BEAD 220 OHM 0603 1LN | FB3, FB4, FB5, FB6 | FER 0603_1608 | BLM18EG221SN1D | 4
STM32F405RGT6 | Integrated Circuit | IC1 | QFP50P1200X1200X16 0-64N | STM32F405RGT6 | 1
TPS2041BD | Integrated Circuit | IC2 | SOIC127P600X175-8N | TPS2041BD | 1
NCP1117ST25T3G | IC REG LINEAR 2.5V 1A SOT223 | IC3 | ON SEMI SOT-223 ST(318H) | NCP1117ST25T3G | 1
ST1S10PUR | Integrated Circuit | IC4, IC5 | SON80P400X400X100-9N-D | ST1S10PUR | 2
EPCS16SI8N | Integrated Circuit | IC6 | SOIC127P600X175-8N | EPCS16SI8N | 1
W25Q64CVSSIG | Integrated Circuit | IC7 | SOIC127P790X216-8N | W25Q64CVSSIG | 1
IC9-68RD-0.635SF | Connector Card Bus Socket | J1 | IC9-68RD-0.635SF | IC9-68RD-0.635SF | 1
PBS2-6 | Connector, Header, Pitch 2mm, H=4.3mm | J2 | PBS2-6 | PBS2-6 | 1
PBD2-10 | Connector | J3 | PBD2-10 | PBD2-10 | 1
10 µH | FIXED IND 10UH 1.3A 180 MOHM SMD | L1, L2 | BOURNS SRN4018 | SRN4018-100M | 2
| LED, 0603, GREEN | LED1 | LEDC1608X80N | LTST-C190KGKT | 1
LTST-C190KGKT | LED, 0603, GREEN | LED2 | LEDC1608X80N | LTST-C190KGKT | 1
10 kOhms | RES 10K OHM 1% 1/16W 0402 | R1, R3, R6, R7, R8, R10, R12, R13, R14, R20, R21, R23, R25, R26, R28 | RES 0402_1005 | RC0402FR-0710KL | 15
33 Ohms | RES 33 OHM 1% 1/16W 0402 | R2, R19 | RES 0402_1005 | RC0402FR-0733RL | 2
220 Ohms | RES 220 OHM 1% 1/10W 0603 | R4, R5 | RES 0603_1608 | RC0603FR-07220RL | 2
31.6 kOhms | RES 31.6K OHM 1% 1/10W 0603 | R9 | RES 0603_1608 | RC0603FR-0731K6L | 1
5.11 kOhms | RES 5.11K OHM 1% 1/10W 0603 | R11 | RES 0603_1608 | RC0603FR-075K11L | 1
0 Ohms | RES 0 OHM JUMPER 1/16W 0402 | R17, R18, R29 | RES 0402_1005 | RC0402JR-070RL | 3
33 Ohms | RES 33 OHM 1% 1/10W 0603 | R22 | RES 0603_1608 | RC0603FR-0733RL | 1
1 kOhms | RES 1K OHM 1% 1/16W 0402 | R24 | RES 0402_1005 | RC0402FR-071KL | 1
CAY16-330J4LF | RES ARRAY 4 RES 33 OHM 1206 | RN1, RN2, RN3, RN4, RN5, RN6, RN7, RN8, RN9, RN10, RN11, RN12 | RESNET 1206-8 CONVEX | CAY16-330J4LF | 12
EP4CE22E22C6N | IC FPGA 79 I/O 144EQFP | U1 | QFP50P2200X2200X16 5-145N | EP4CE22E22C6N_1 | 1
SN74CBTD3384CDBR | Integrated Circuit | U2, U3, U4, U5 | SOP65P780X200-24N | SN74CBTD3384CDBR | 4
FC-135 | Crystal or Oscillator | Y1 | FC135 | FC-135_32.7680KA-A3 | 1
DSX321G-25M-12P | Crystal or Oscillator | Y2 | DSX321G20M | DSX321G-25M | 1
27 MHz | XTAL OSC XO 27.0000MHZ CMOS SMD | Y3 | ABRACON ASE | ASE-27.000MHZ-ET | 1
