SiwaNetwork/CASS/CAM_LATTICE_STM/ECAD/cam_dvb_ci_v2.1/Output/CAM_DVB-CI_v2.1_release_rev.2.1_ SCH 2025-09-05 15-06.PDF

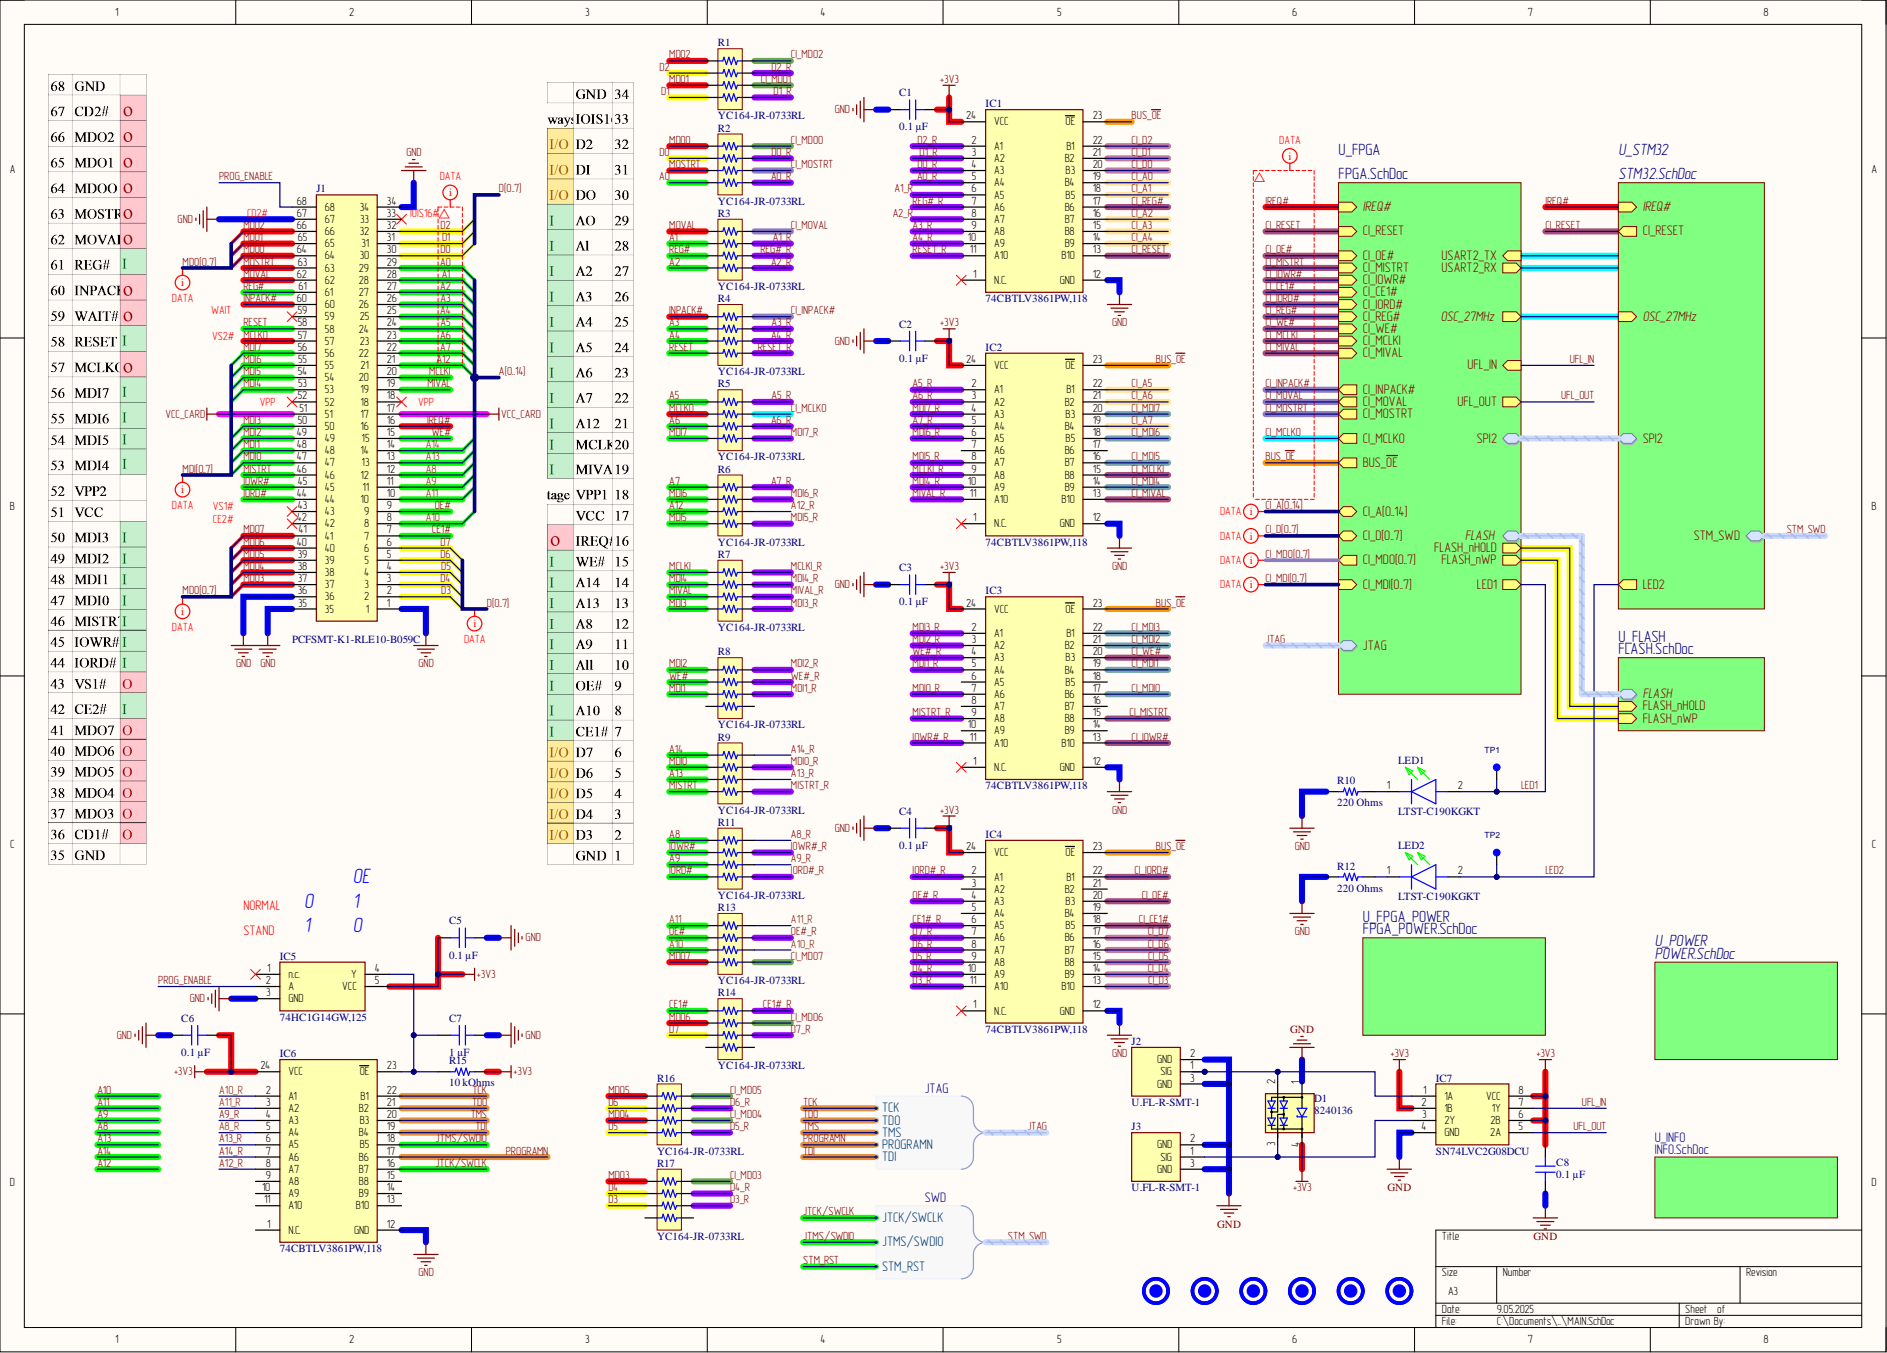
[picture p141: page 1]

A2
A3

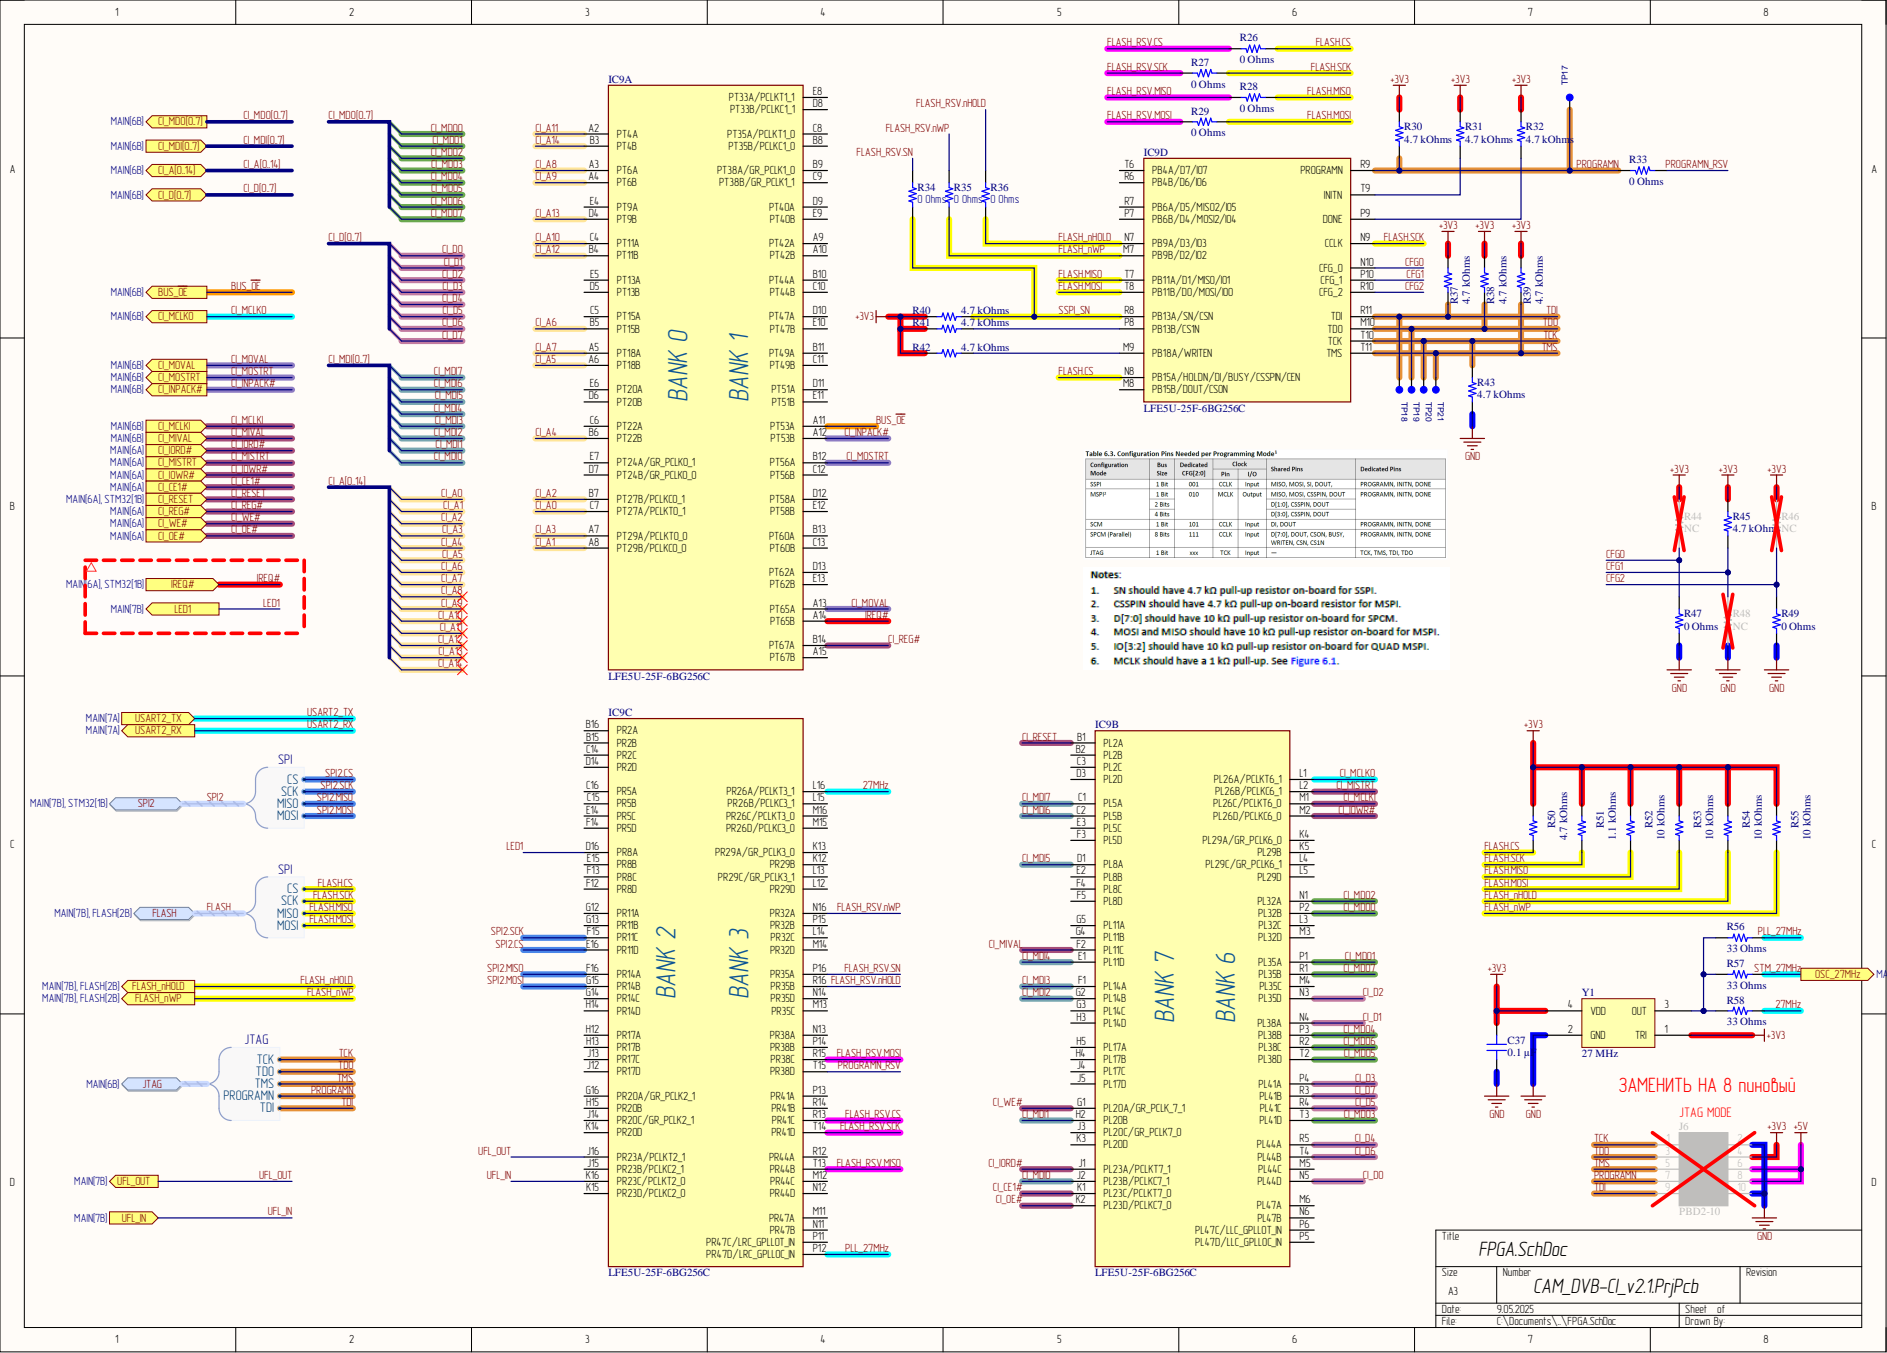
[picture p142: page 2]

R4 0 | | FLASH_ nHO L D | N 7

FLASH_ n W P | M 7 | 0 C F G 0

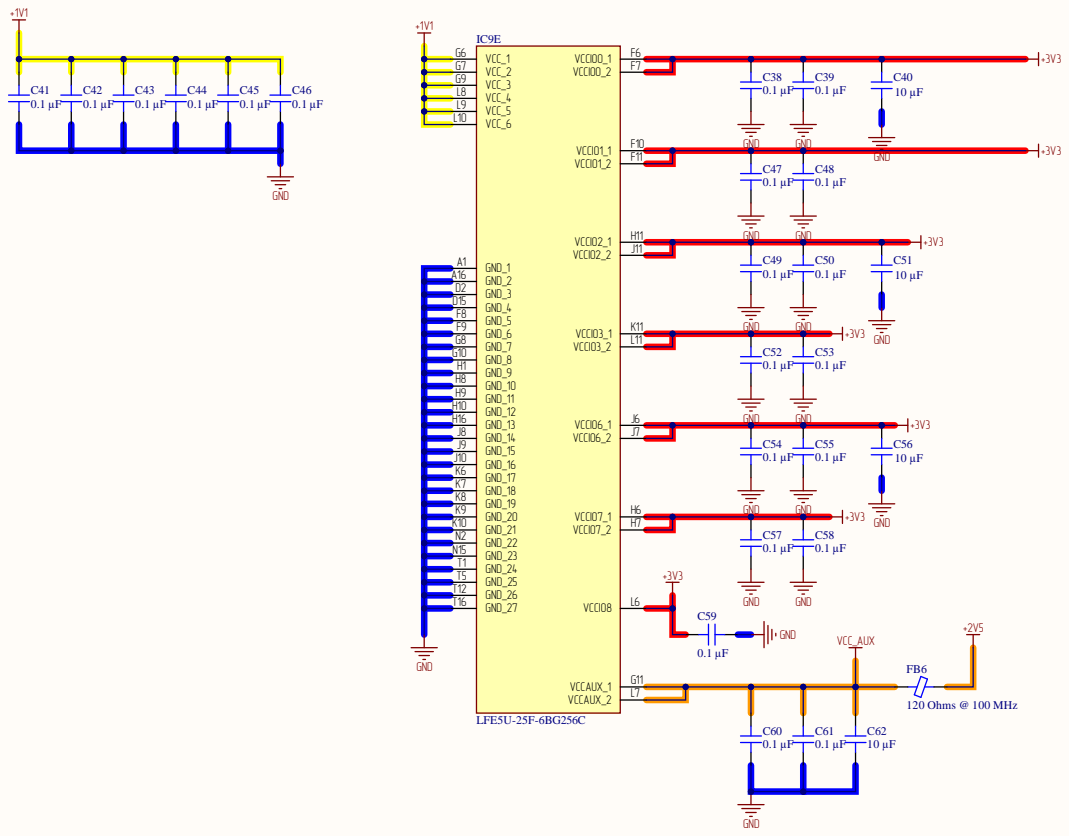
[picture p143: page 3]

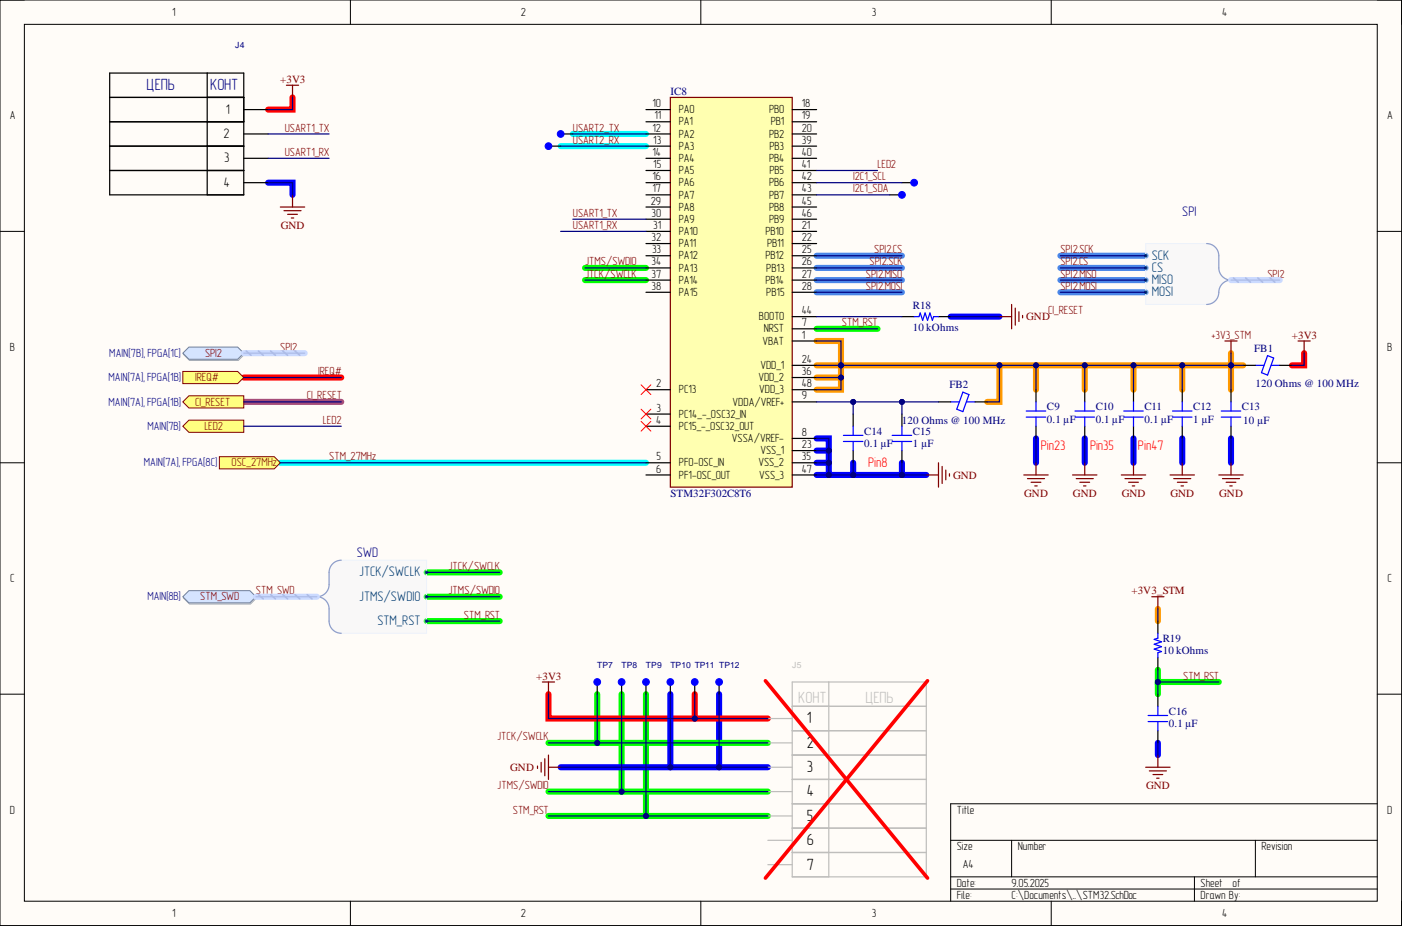
[picture p144: page 4]

SWD
JTCK/SWCLK

КОНТ | ЦЕПЬ

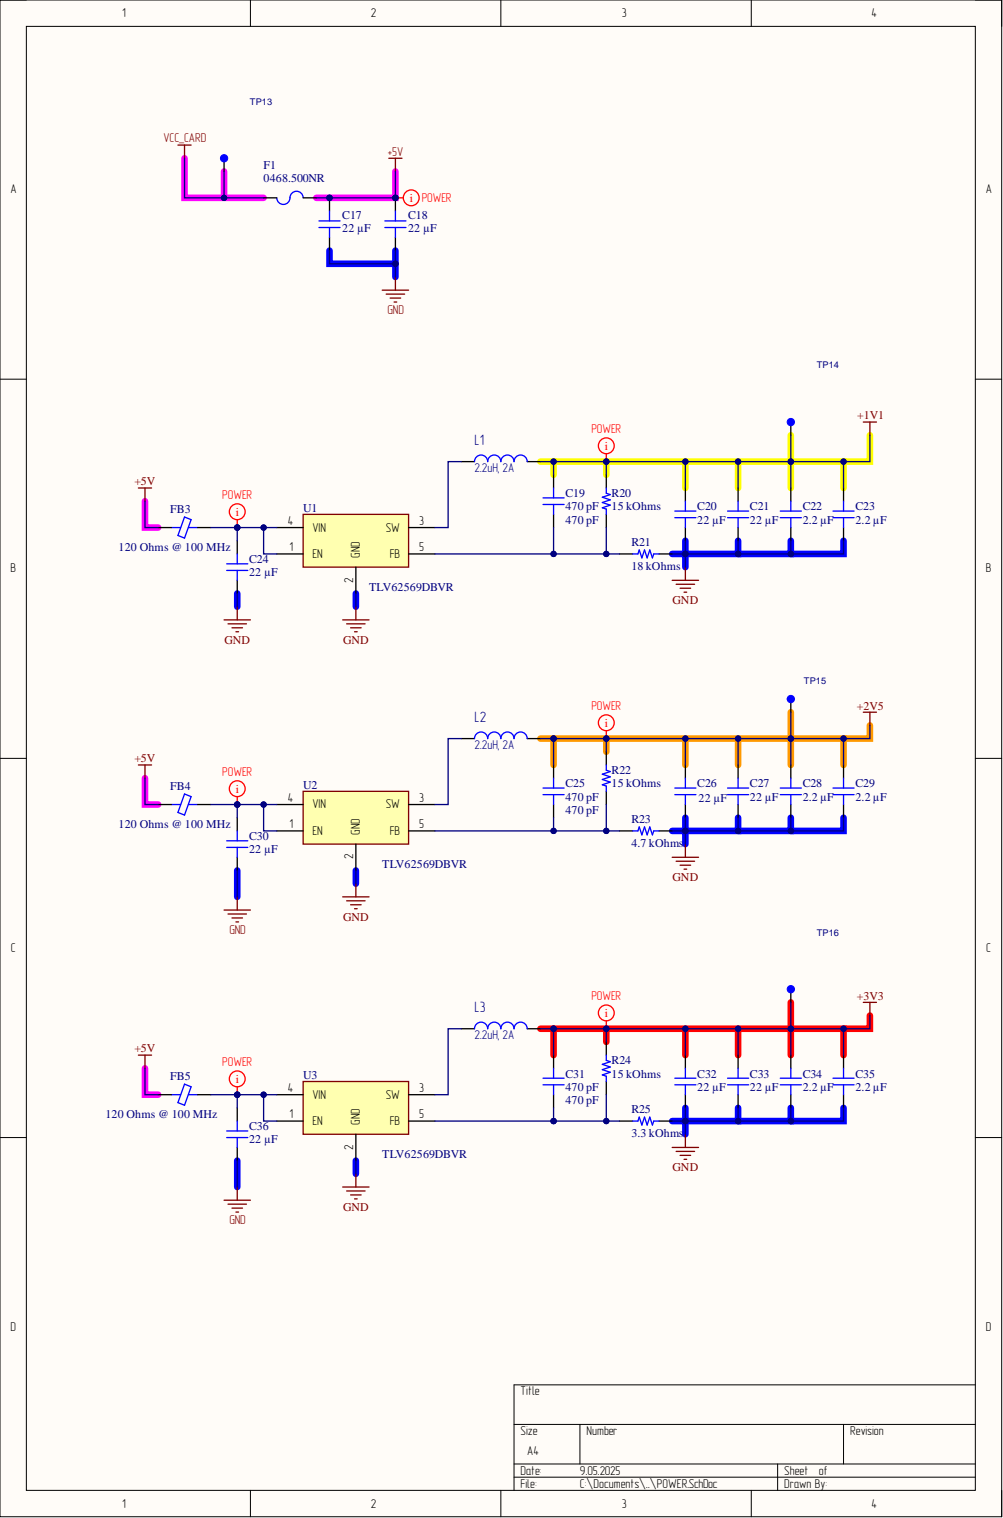
[picture p145: page 5]

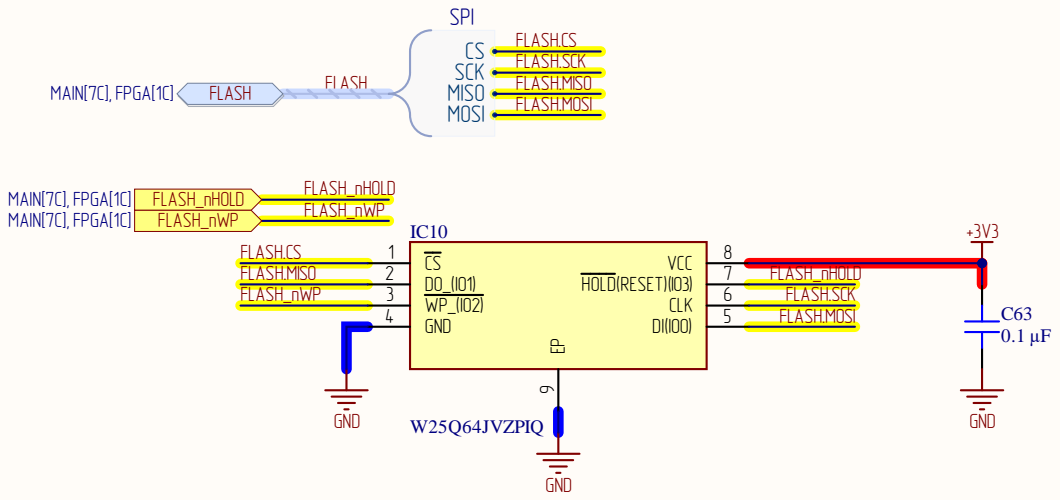
[picture p146: page 6]

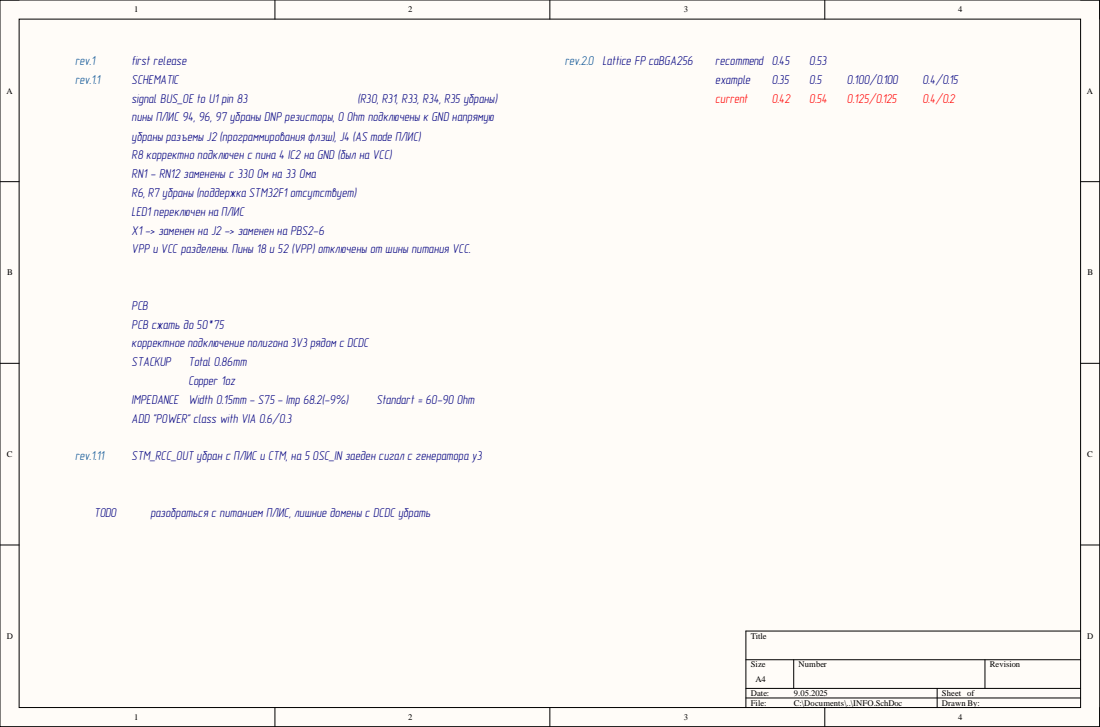
[picture p147: page 7]

SCHEMATIC
signal BUS_OE to U1 pin 83
пины ПЛИС 94, 96, 97 убраны DNP резисторы, 0 Ohm подключены к GND напрямую
убраны разъемы J2 (программирования флэш), J4 (AS mode ПЛИС)
R8 корректно подключен с пина 4 IC2 на GND (был на VCC)
RN1 - RN12 заменены с 330 Ом на 33 Ома
R6, R7 убраны (поддержка STM32F1 отсутствует)
LED1 переключен на ПЛИС
X1 -> заменен на J2 -> заменен на PBS2-6
VPP и VCC разделены. Пины 18 и 52 (VPP) отключены от шины питания VCC.

PCB
PCB сжать до 50*75
корректное подключение полигона 3V3 рядом с DCDC

ADD "POWER" class with VIA 0.6/0.3
