SiwaNetwork/CASS/CAM_LATTICE_STM/ECAD/cam_dvb_ci_v2.01/Project Outputs for CAM_DVB-CI_v2.01/CAM_DVB-CI_v2.01_rev.2.01_ SCH 2025-04-23 22-51.PDF

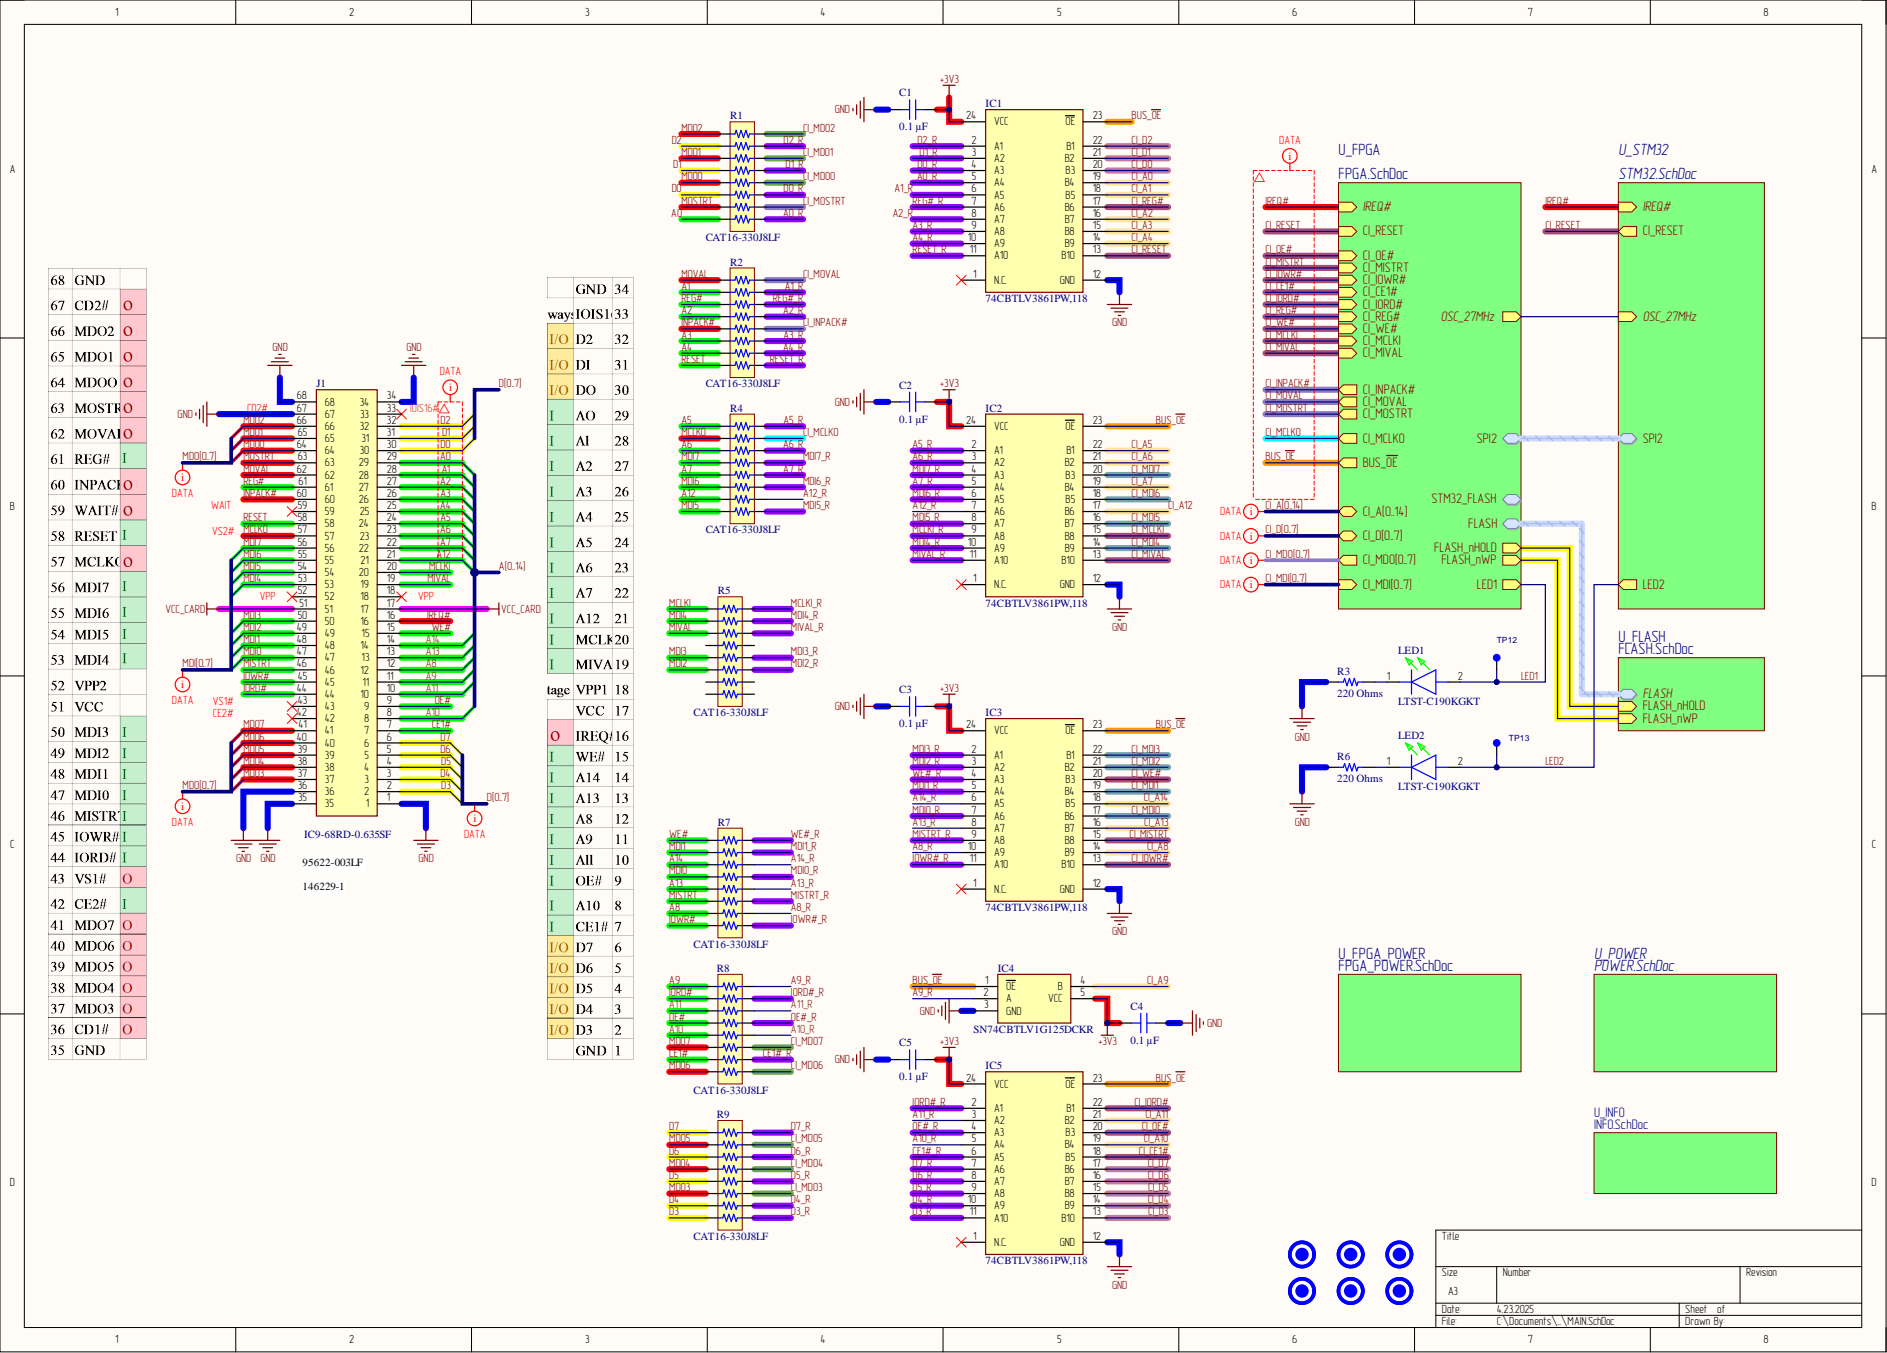
[picture p153: page 1]

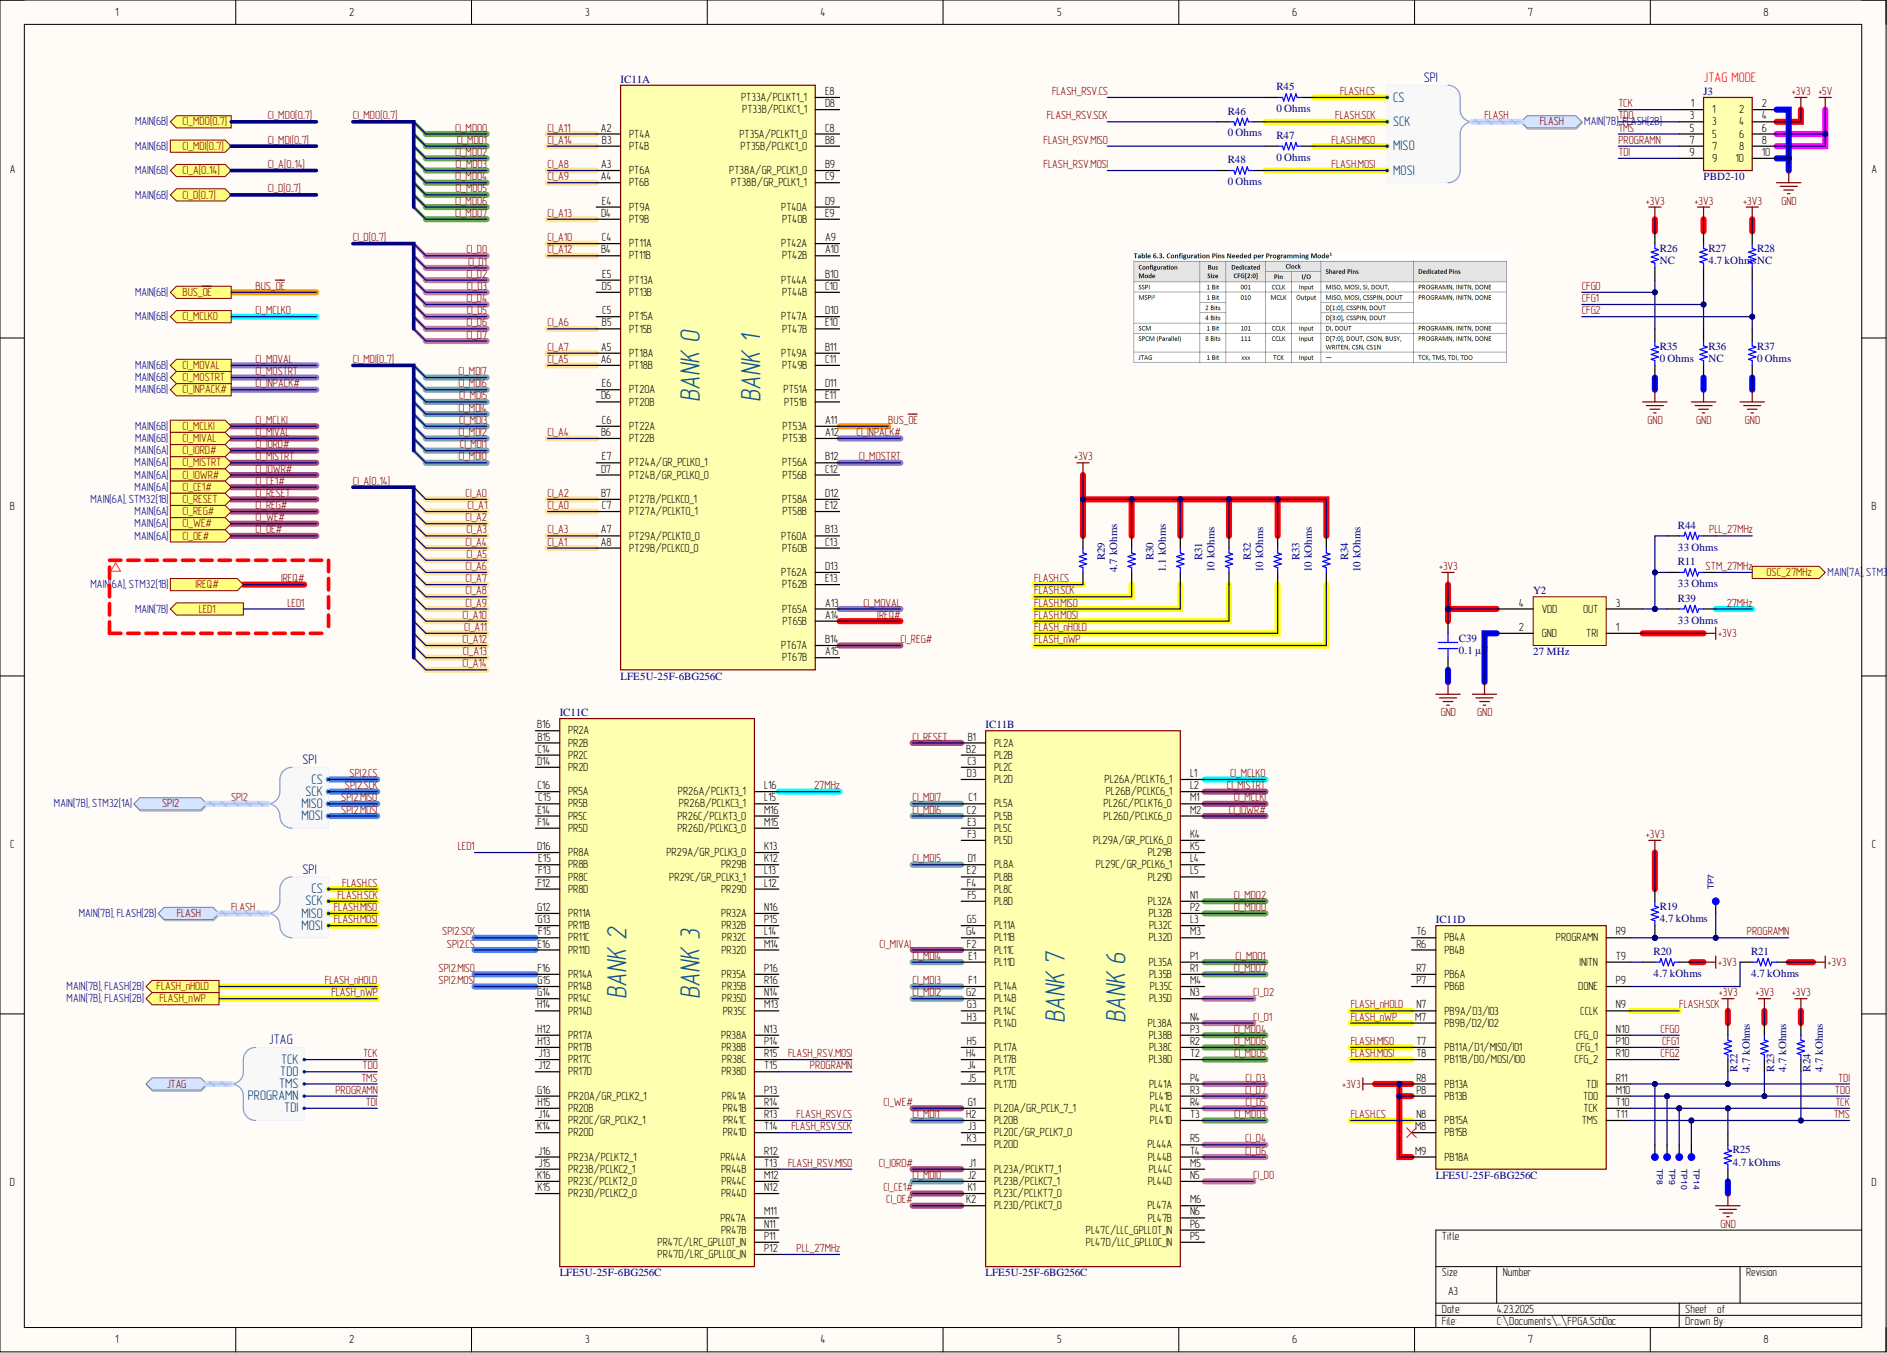
[picture p154: page 2]

1 0


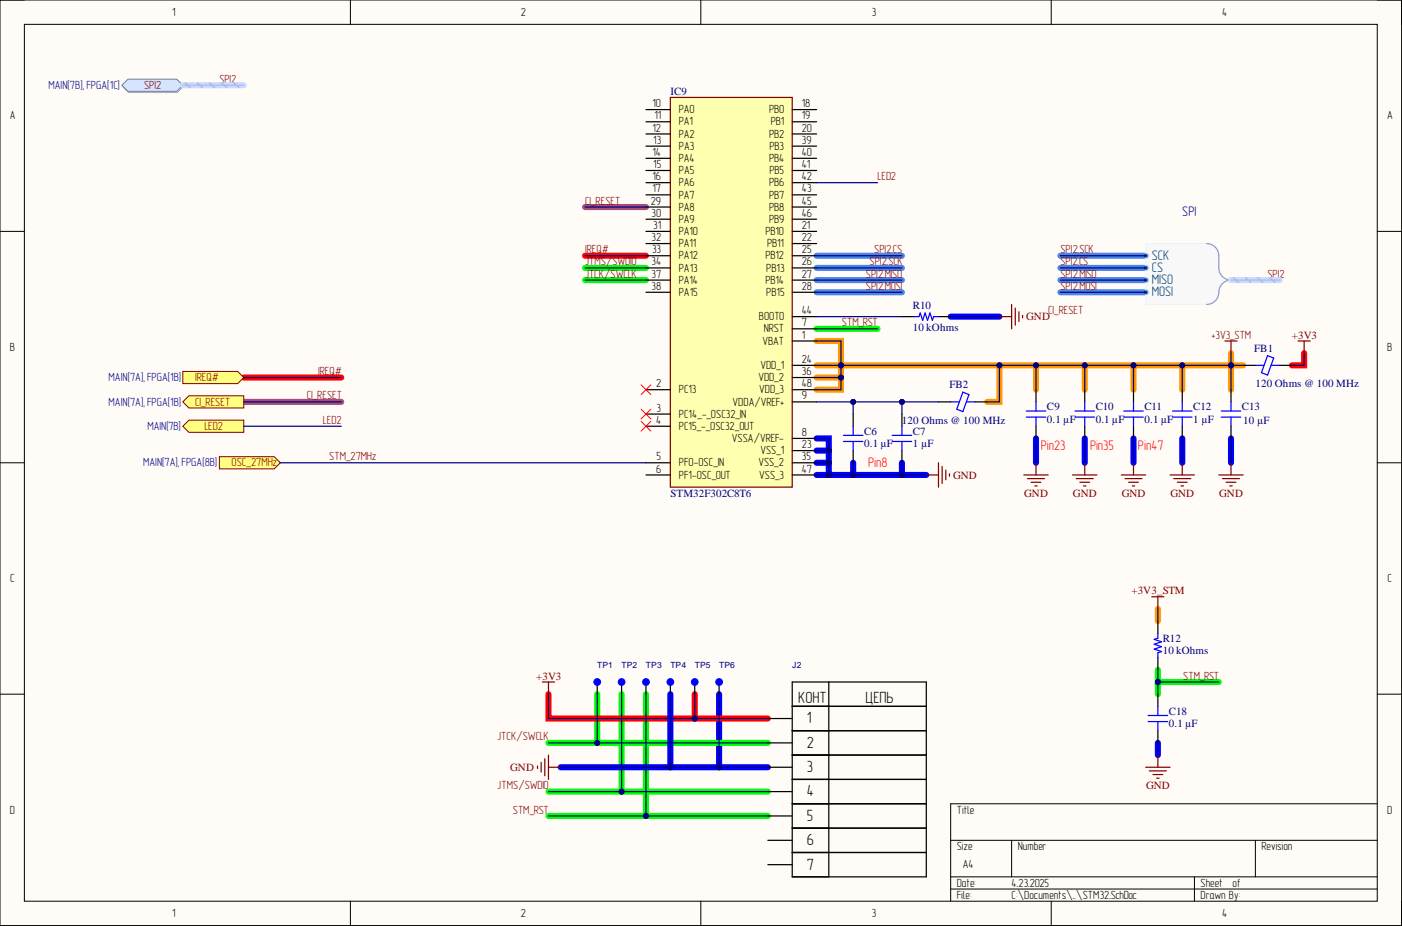
[picture p155: page 4]

КОНТ | ЦЕПЬ

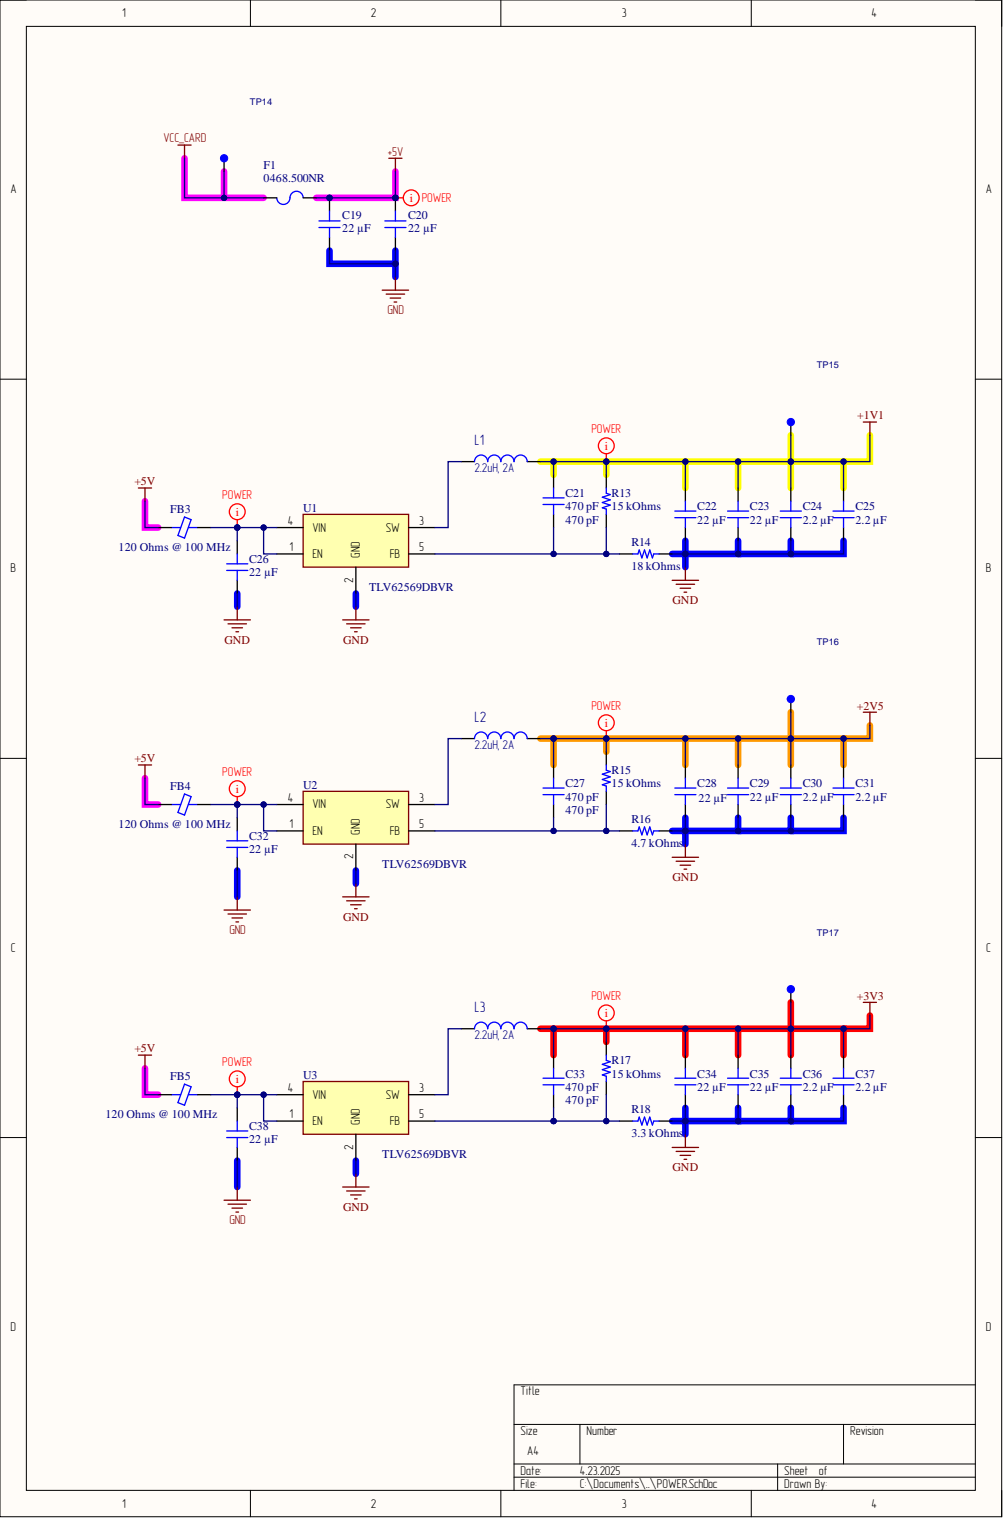
[picture p156: page 5]


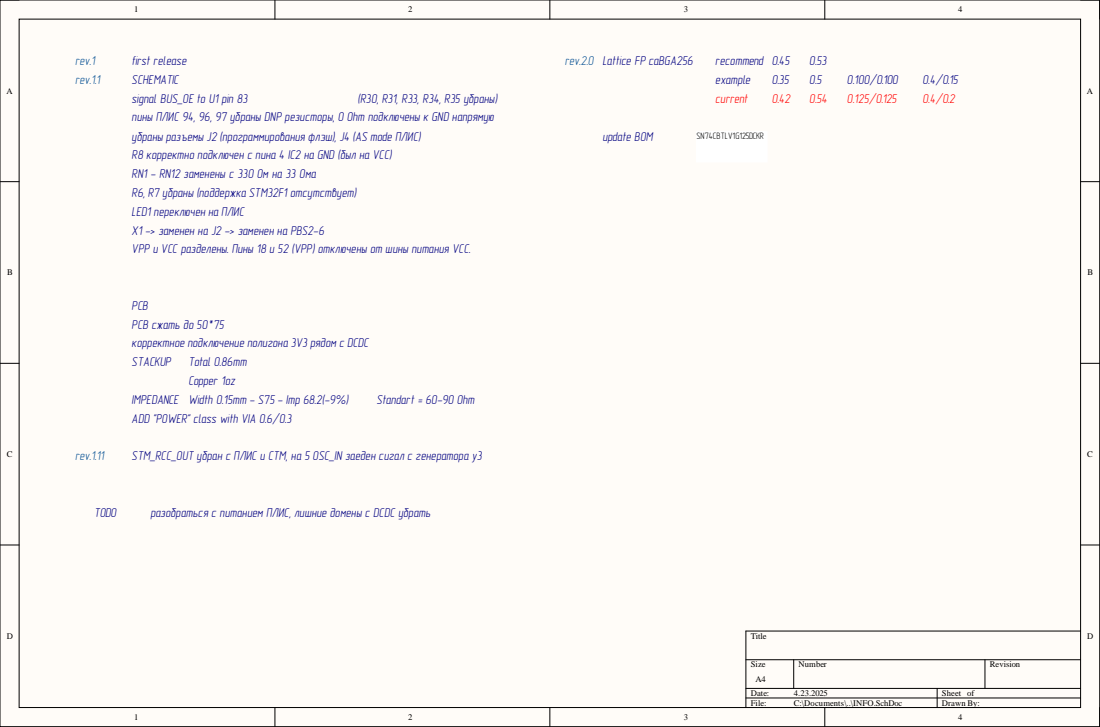
[picture p157: page 7]

SCHEMATIC
signal BUS_OE to U1 pin 83
пины ПЛИС 94, 96, 97 убраны DNP резисторы, 0 Ohm подключены к GND напрямую
убраны разъемы J2 (программирования флэш), J4 (AS mode ПЛИС)
R8 корректно подключен с пина 4 IC2 на GND (был на VCC)
RN1 - RN12 заменены с 330 Ом на 33 Ома
R6, R7 убраны (поддержка STM32F1 отсутствует)
LED1 переключен на ПЛИС
X1 -> заменен на J2 -> заменен на PBS2-6
VPP и VCC разделены. Пины 18 и 52 (VPP) отключены от шины питания VCC.

PCB
PCB сжать до 50*75
корректное подключение полигона 3V3 рядом с DCDC

ADD "POWER" class with VIA 0.6/0.3
