SiwaNetwork/CASS/CAM-ALTERA_STM/V1.3/ECAD/Project Outputs for CAM_DVB-CI/CAM_DVB-CI_rev.1.3_ SCH 2025-02-11 20-12.PDF

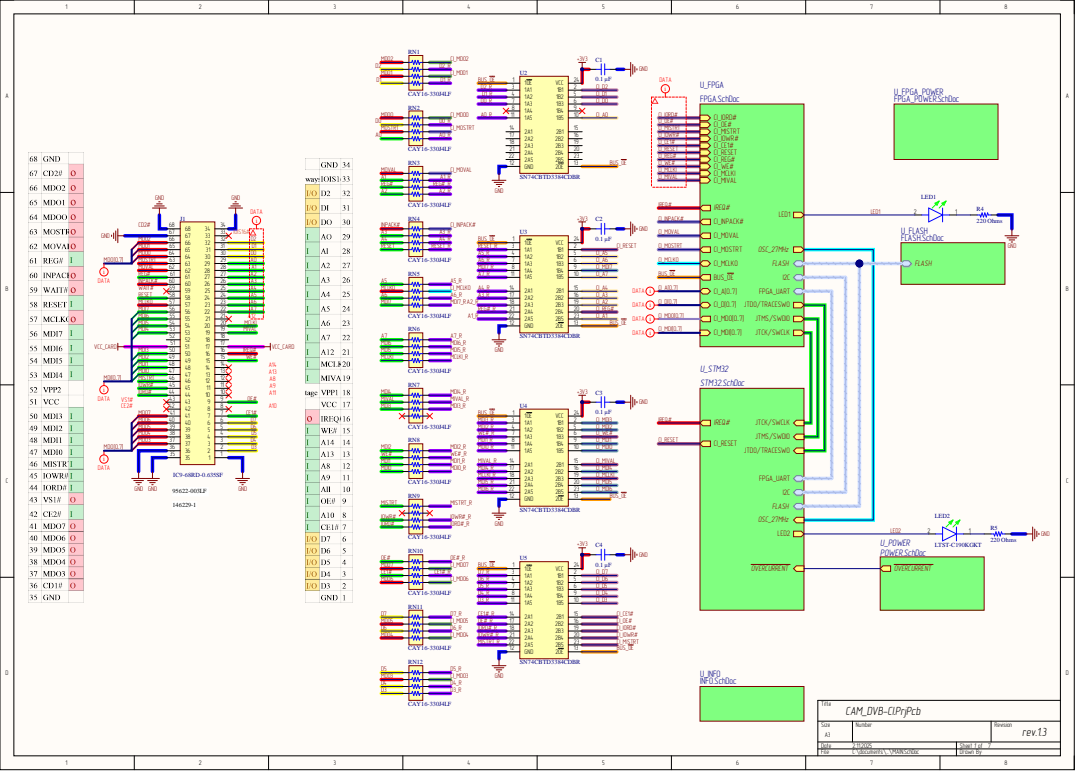
[picture p169: page 1]

Siz e A3 | Nu m b e r | Re visio n rev.1.3

Da t e : 2. 1 1 . 2 0 2 5 | Sh e e t 1 o f 7
File : C:\ d o c u m e n t s \ . . \ MAIN.Sc h D o c | Drawn By :

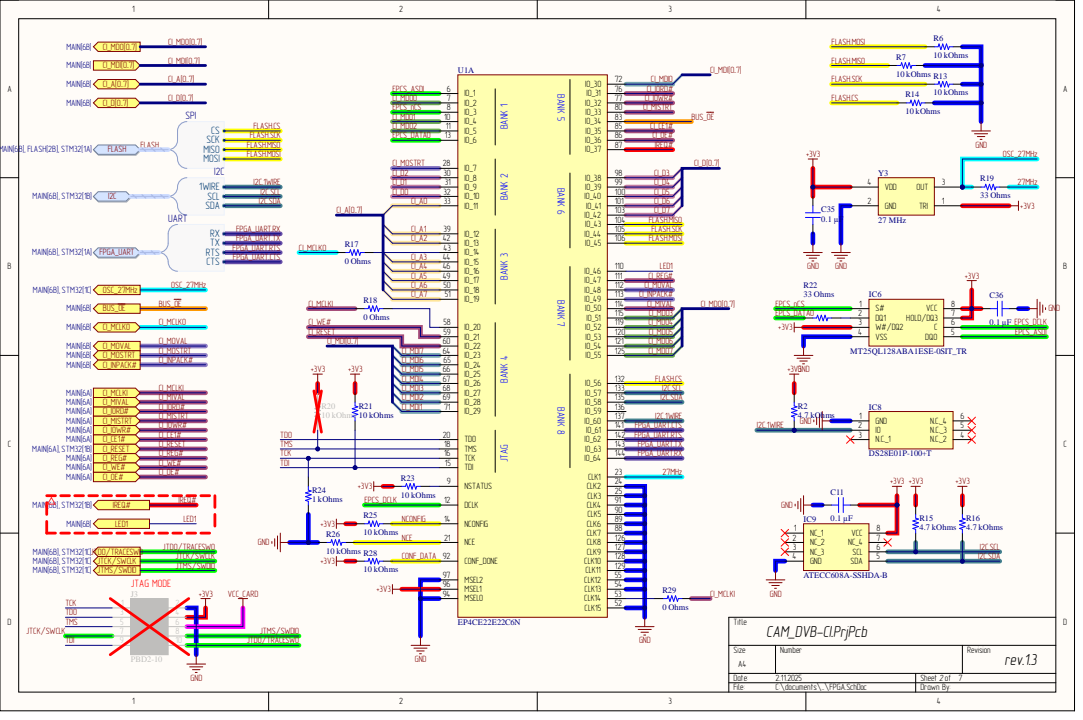
[picture p170: page 2]

BANK 5 BANK 6 BANK 7 BANK 8

BANK 1 BANK 2 BANK 3 BANK 4

CI_RESE T | 5 9
CI_ MDI[0. . 7 ] | 6 0

1 | | CI_ MDI 1 7 1

9 6 | | 5 4
9 4 | | 5 3 5 2

Siz e A4 | Nu m b e r | Re visio n rev.1.3

Da t e : 2. 1 1 . 2 0 2 5 | Sh e e t 2 o f 7
File : C:\ d o c u m e n t s \ . . \ FPGA.Sc h D o c | Drawn By :

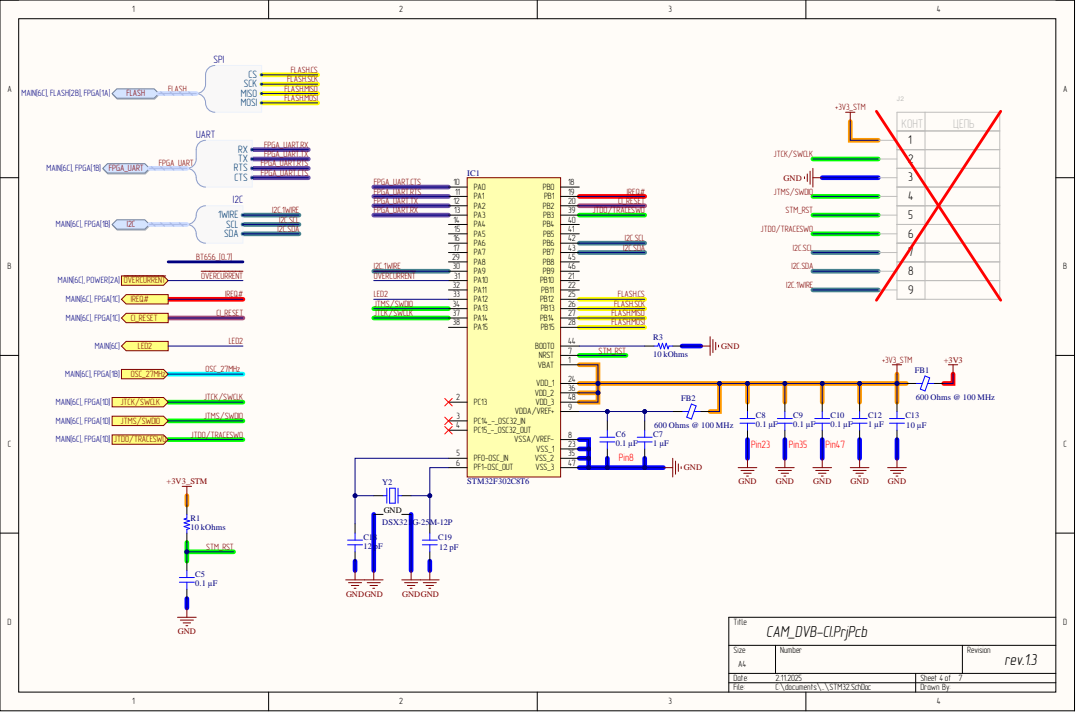
[picture p171: page 3]

2 4
3 6
4 8

Siz e A4 | Nu m b e r | Re visio n rev.1.3

Da t e : 2. 1 1 . 2 0 2 5 | Sh e e t 4 o f 7
File : C:\ d o c u m e n t s \ . . \STM 32. S c h D o c | Drawn By :

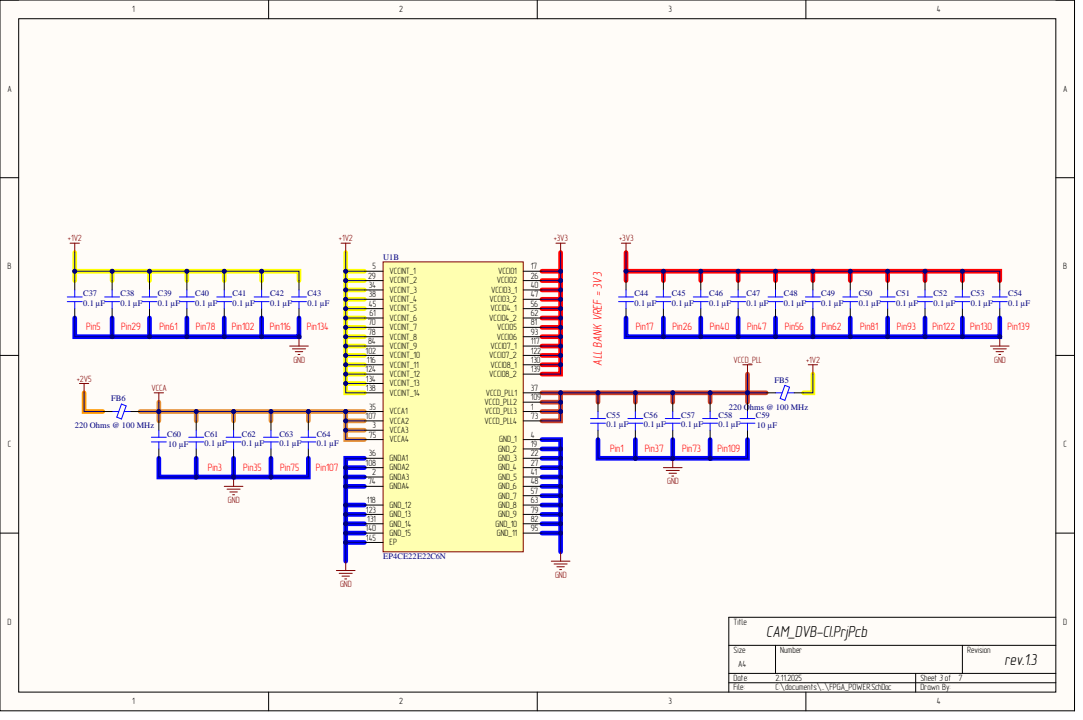
[picture p172: page 4]

Size A4 | Number | Revision rev.1.3

Date: 2.11.2025 | Sheet of 3 7
File: C:\documents\..\FPGA_POWER.SchDoc | Drawn By:

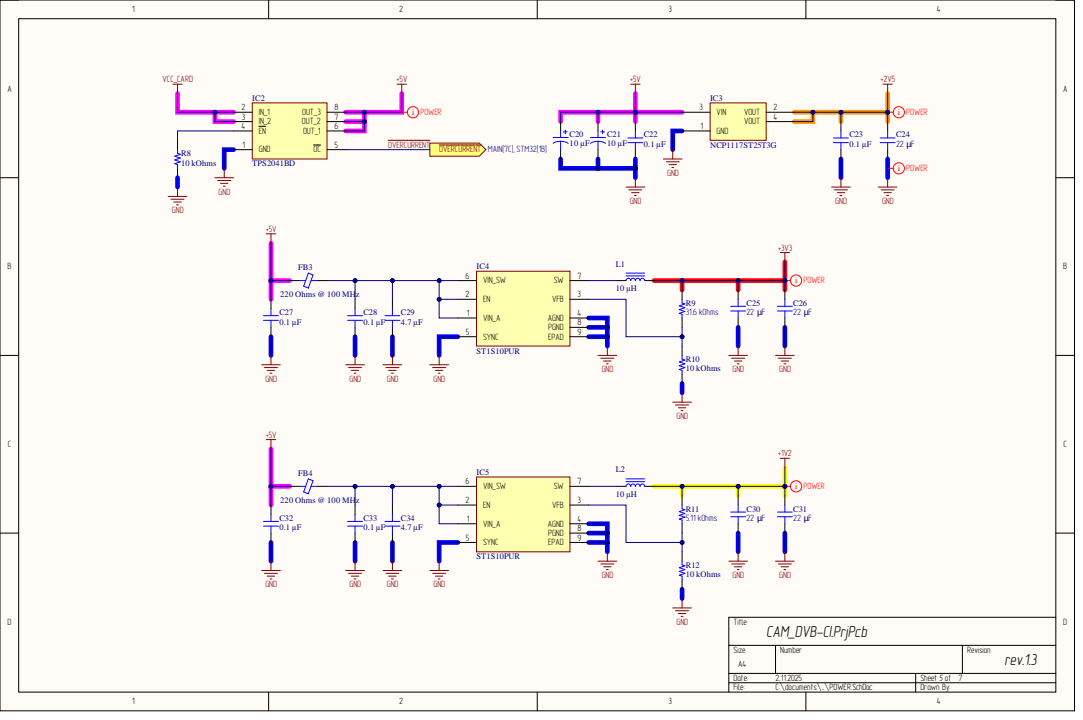
[picture p173: page 5]

Size A4 | Number | Revision rev.1.3

Date: 2.11.2025 | Sheet of 5 7
File: C:\documents\..\POWER.SchDoc | Drawn By:

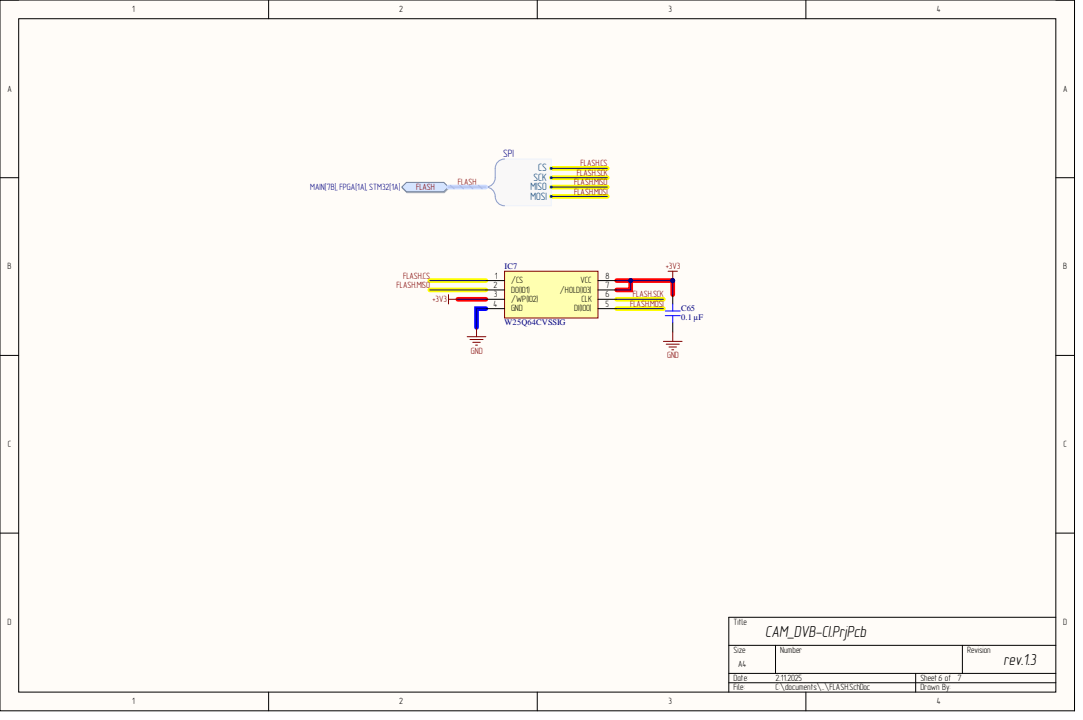
[picture p174: page 6]

Size A4 | Number | Revision rev.1.3

Date: 2.11.2025 | Sheet of 6 7
File: C:\documents\..\FLASH.SchDoc | Drawn By:

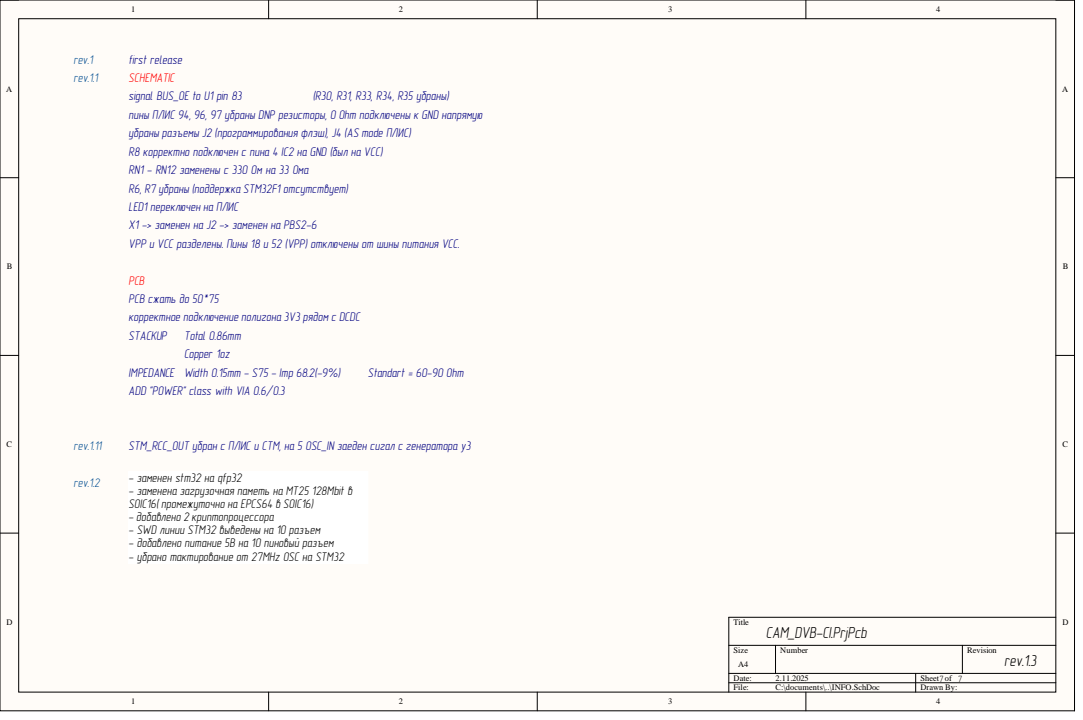
[picture p175: page 7]

SCHEMATIC
signal BUS_OE to U1 pin 83
пины ПЛИС 94, 96, 97 убраны DNP резисторы, 0 Ohm подключены к GND напрямую
убраны разъемы J2 (программирования флэш), J4 (AS mode ПЛИС)
R8 корректно подключен с пина 4 IC2 на GND (был на VCC)
RN1 - RN12 заменены с 330 Ом на 33 Ома
R6, R7 убраны (поддержка STM32F1 отсутствует)
LED1 переключен на ПЛИС
X1 -> заменен на J2 -> заменен на PBS2-6
VPP и VCC разделены. Пины 18 и 52 (VPP) отключены от шины питания VCC.

PCB
PCB сжать до 50*75
корректное подключение полигона 3V3 рядом с DCDC

ADD "POWER" class with VIA 0.6/0.3

- заменена загрузочная паметь на MT25 128Mbit в
SOIC16( промежуточно на EPCS64 в SOIC16)
- добавлено 2 криптопроцессора
- SWD линии STM32 выведены на 10 разъем
- добавлено питание 5В на 10 пиновый разъем
- убрано тактирование от 27MHz OSC на STM32

Size A4 | Number | Revision rev.1.3

Date: 2.11.2025 | Sheet of 7 7
File: C:\documents\..\INFO.SchDoc | Drawn By:
