SiwaNetwork/CASS/CAM_LATTICE_STM/ECAD/cam_dvb_ci_v2/Project Outputs for CAM_DVB-CI_v2/CAM_DVB-CI_v2_testpoints 2024-10-30 00-38.PDF

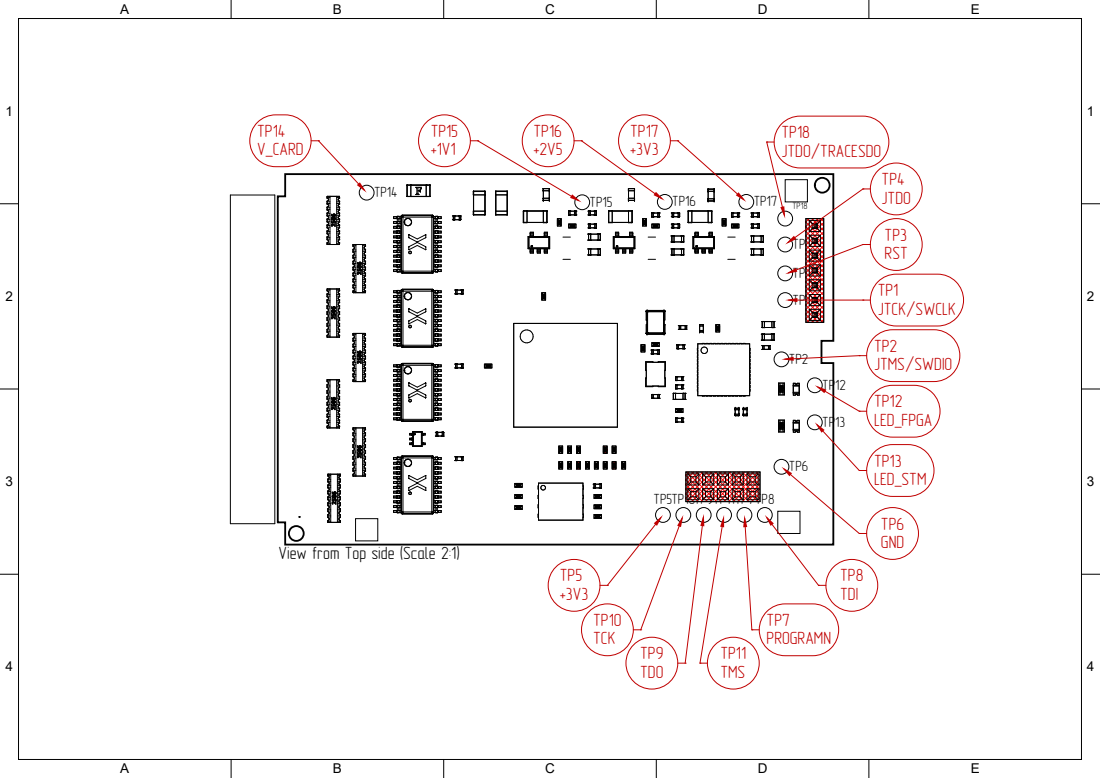
[picture p183: page 1]

View from Top side (Scale 2:1)
