SiwaNetwork/CASS/(list of files, drawings)

Other design files:
CAM-ALTERA_STM/V1.1/VM_CAM_DVB-CI/CAM_DVB-CI.PrjPcb
CAM-ALTERA_STM/V1.1/VM_CAM_DVB-CI/FLASH.SchDoc
CAM-ALTERA_STM/V1.1/VM_CAM_DVB-CI/FPGA.SchDoc
CAM-ALTERA_STM/V1.1/VM_CAM_DVB-CI/FPGA_POWER.SchDoc
CAM-ALTERA_STM/V1.1/VM_CAM_DVB-CI/INFO.SchDoc
CAM-ALTERA_STM/V1.1/VM_CAM_DVB-CI/MAIN.SchDoc
CAM-ALTERA_STM/V1.1/VM_CAM_DVB-CI/POWER.SchDoc
CAM-ALTERA_STM/V1.1/VM_CAM_DVB-CI/STM32.SchDoc
CAM-ALTERA_STM/V1.2/VM_CAM_DVB-CI/CAM_DVB-CI.PrjPcb
CAM-ALTERA_STM/V1.2/VM_CAM_DVB-CI/FPGA.SchDoc
CAM-ALTERA_STM/V1.2/VM_CAM_DVB-CI/INFO.SchDoc
CAM-ALTERA_STM/V1.2/VM_CAM_DVB-CI/MAIN.SchDoc
CAM-ALTERA_STM/V1.2/VM_CAM_DVB-CI/POWER.SchDoc
CAM-ALTERA_STM/V1.2/VM_CAM_DVB-CI/STM32.SchDoc
CAM-ALTERA_STM/V1.3/ECAD/CAM_DVB-CI_v1.3.PrjPcb
CAM-ALTERA_STM/V1.3/ECAD/FLASH.SchDoc
CAM-ALTERA_STM/V1.3/ECAD/FPGA.SchDoc
CAM-ALTERA_STM/V1.3/ECAD/FPGA_POWER.SchDoc
CAM-ALTERA_STM/V1.3/ECAD/INFO.SchDoc
CAM-ALTERA_STM/V1.3/ECAD/MAIN.SchDoc
CAM-ALTERA_STM/V1.3/ECAD/POWER.SchDoc
CAM-ALTERA_STM/V1.3/ECAD/STM32.SchDoc
CAM-ALTERA_STM/V1.4/ECAD/CAM_DVB-CI_v1.4.PrjPcb
CAM-ALTERA_STM/V1.4/ECAD/FLASH.SchDoc
CAM-ALTERA_STM/V1.4/ECAD/FPGA.SchDoc
CAM-ALTERA_STM/V1.4/ECAD/FPGA_POWER.SchDoc
CAM-ALTERA_STM/V1.4/ECAD/INFO.SchDoc
CAM-ALTERA_STM/V1.4/ECAD/MAIN.SchDoc
CAM-ALTERA_STM/V1.4/ECAD/POWER.SchDoc
CAM-ALTERA_STM/V1.4/ECAD/STM32.SchDoc
CAM-ALTERA_STM/V1/CAM_DVB-CI (08.03.2024 16-16-03)/SM_Project/CAM_DVB-CI/CAM_DVB-CI.PrjPcb
CAM-ALTERA_STM/V1/CAM_DVB-CI (08.03.2024 16-16-03)/SM_Project/CAM_DVB-CI/CAM_DVB-CI_r1.PCB
CAM-ALTERA_STM/V1/CAM_DVB-CI (08.03.2024 16-16-03)/SM_Project/CAM_DVB-CI/FLASH.SchDoc
CAM-ALTERA_STM/V1/CAM_DVB-CI (08.03.2024 16-16-03)/SM_Project/CAM_DVB-CI/FPGA.SchDoc
CAM-ALTERA_STM/V1/CAM_DVB-CI (08.03.2024 16-16-03)/SM_Project/CAM_DVB-CI/FPGA_POWER.SchDoc
CAM-ALTERA_STM/V1/CAM_DVB-CI (08.03.2024 16-16-03)/SM_Project/CAM_DVB-CI/MAIN.SchDoc
CAM-ALTERA_STM/V1/CAM_DVB-CI (08.03.2024 16-16-03)/SM_Project/CAM_DVB-CI/POWER.SchDoc
CAM-ALTERA_STM/V1/CAM_DVB-CI (08.03.2024 16-16-03)/SM_Project/CAM_DVB-CI/STM32.SchDoc
CAM_EXTENSION/cam_ext_v1/CAM_EXT_v1.PcbDoc
CAM_EXTENSION/cam_ext_v1/CAM_EXT_v1.PrjPcb
CAM_EXTENSION/cam_ext_v1/MAIN.SchDoc
CAM_LATTICE_STM/ECAD/cam_dvb_ci_v2.01/CAM_DVB-CI_v2.01.PrjPcb
CAM_LATTICE_STM/ECAD/cam_dvb_ci_v2.1/CAM_DVB-CI_v2.1.PrjPcb
CAM_LATTICE_STM/ECAD/cam_dvb_ci_v2.1/FLASH.SchDoc
CAM_LATTICE_STM/ECAD/cam_dvb_ci_v2.1/FPGA.SchDoc
CAM_LATTICE_STM/ECAD/cam_dvb_ci_v2.1/FPGA_POWER.SchDoc
CAM_LATTICE_STM/ECAD/cam_dvb_ci_v2.1/MAIN.SchDoc
CAM_LATTICE_STM/ECAD/cam_dvb_ci_v2.1/POWER.SchDoc
CAM_LATTICE_STM/ECAD/cam_dvb_ci_v2.1/STM32.SchDoc
CAM_LATTICE_STM/ECAD/cam_dvb_ci_v2.02/CAM_DVB-CI_v2.02.PrjPcb
CAM_LATTICE_STM/ECAD/cam_dvb_ci_v2.02/FLASH.SchDoc
CAM_LATTICE_STM/ECAD/cam_dvb_ci_v2.02/FPGA.SchDoc
CAM_LATTICE_STM/ECAD/cam_dvb_ci_v2.02/FPGA_POWER.SchDoc
CAM_LATTICE_STM/ECAD/cam_dvb_ci_v2.02/INFO.SchDoc
CAM_LATTICE_STM/ECAD/cam_dvb_ci_v2.02/INPUTs.SchDoc
CAM_LATTICE_STM/ECAD/cam_dvb_ci_v2.02/MAIN.SchDoc
CAM_LATTICE_STM/ECAD/cam_dvb_ci_v2.02/POWER.SchDoc
CAM_LATTICE_STM/ECAD/cam_dvb_ci_v2.02/STM32.SchDoc
CAM_LATTICE_STM/ECAD/cam_dvb_ci_v2.03/CAM_DVB-CI_v2.03.PrjPcb
CAM_LATTICE_STM/ECAD/cam_dvb_ci_v2.03/FLASH.SchDoc
CAM_LATTICE_STM/ECAD/cam_dvb_ci_v2.03/FPGA.SchDoc
CAM_LATTICE_STM/ECAD/cam_dvb_ci_v2.03/FPGA_POWER.SchDoc
CAM_LATTICE_STM/ECAD/cam_dvb_ci_v2.03/MAIN.SchDoc
CAM_LATTICE_STM/ECAD/cam_dvb_ci_v2.03/POWER.SchDoc
CAM_LATTICE_STM/ECAD/cam_dvb_ci_v2.03/STM32.SchDoc
CAM_LATTICE_STM/ECAD/cam_dvb_ci_v2/CAM_DVB-CI_v2.PrjPcb
CAM_LATTICE_STM/ECAD/cam_dvb_ci_v2/FPGA.SchDoc
CAM_LATTICE_STM/LATTICE REFERENCE/ECP5-Development-Board-master/[01] - POWER.SchDoc
CAM_LATTICE_STM/LATTICE REFERENCE/ECP5-Development-Board-master/[02] - USB.SchDoc
CAM_LATTICE_STM/LATTICE REFERENCE/ECP5-Development-Board-master/[03] - SDCARD.SchDoc
CAM_LATTICE_STM/LATTICE REFERENCE/ECP5-Development-Board-master/[04] - RAM.SchDoc
CAM_LATTICE_STM/LATTICE REFERENCE/ECP5-Development-Board-master/[05] - FLASH.SchDoc
CAM_LATTICE_STM/LATTICE REFERENCE/ECP5-Development-Board-master/[06] - GPIO.SchDoc
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
