SiwaNetwork/CASS/(commit log)

2024-08-19 Create Копия CAM_DVB-CI_rev.1.1_release BOM-offer(1).xlsx
    [Копия CAM_DVB-CI_rev.1.1_release BOM-offer(1).xlsx]
2024-08-22 Update Копия CAM_DVB-CI_rev.1.1_release BOM-offer(1).xlsx
    [Копия CAM_DVB-CI_rev.1.1_release BOM-offer(1).xlsx]
2024-12-22 Create даташит аналогов 0923.zip
2025-02-11 update
    * PC Card standart files update with full name
    * add Jocker SCH and BOM
    * add CAM v2 (LATTICE)
    [Joker-TV.csv, Joker_BOM.xlsx]
2025-02-11 add CAM rev.2.0
    add CAM rev.2.0 LATTICE version
    [CAM_DVB-CI_v2.PrjPcb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]
2025-02-11 update tree
    [CAM_DVB-CI.GBL, CAM_DVB-CI.GBO, CAM_DVB-CI.GBP, CAM_DVB-CI.GBS, CAM_DVB-CI.GTL, CAM_DVB-CI.GTO, CAM_DVB-CI.GTP, CAM_DVB-CI.GTS]
2025-02-11 Create CAM_versions
    * добавлен файл с описанием версий
    * исправлено дерево
    * в2 это в1.1
    * в1.2.1 это в.1.3
2025-02-11 add v.1.3
    [CAM_DVB-CI.PrjPcb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]
2025-02-11 tree fix
    [CAM_DVB-CI.PrjPcb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]
2025-02-11 add v1.4
    [CAM_DVB-CI.PrjPcb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]
2025-02-15 updt rev.1.4
    [CAM_DVB-CI_v1.4.PrjPcb, CAM_DVB-CI_v2.PrjPcb, FLASH.SchDoc, FPGA.SchDoc, FPGA_POWER.SchDoc, INFO.SchDoc, MAIN.SchDoc, POWER.SchDoc]
2025-02-16 тз на стенд
2025-02-24 cam 2.1 update
    [CAM_DVB-CI_v2.PrjPcb, FPGA.SchDoc]
2025-03-04 LATTICE CAM update
    * CAM 2.0 обновлено обозначение LATTICE на схеме, сгенерирована схема
    * CAM 2.1 в работе. добавлен шинник внешнего программирования
    [CAM_DVB-CI_v2.1.PrjPcb, CAM_DVB-CI_v2.PrjPcb, FPGA.SchDoc, FPGA_POWER.SchDoc, MAIN.SchDoc]
2025-03-04 cam 2.0 update
    [FPGA.SchDoc]
2025-03-09 upd cam rev.2.1
    [CAM_DVB-CI_v2.1.PrjPcb, CAM_DVB-CI_v2.PrjPcb, FPGA.SchDoc, FPGA_POWER.SchDoc, MAIN.SchDoc, STM32.SchDoc]
2025-03-17 CAM rev.1.4 and 2.1 gerber and output update
    [CAM_DVB-CI_v1.4.PrjPcb, CAM_DVB-CI_v1.4_rev.1.4_BOM 2025-03-16 23-31.xlsx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]
2025-04-02 add rev. 2.01
    [CAM_DVB-CI_v2.01.PrjPcb, CAM_DVB-CI_v2.1.PrjPcb, CAM_DVB-CI_v2.PrjPcb, FLASH.SchDoc, FPGA.SchDoc, FPGA_POWER.SchDoc, INFO.SchDoc, INPUTs.SchDoc]
2025-04-02 add CAM stand
    [CAM_DVB-CI_v2.01.PrjPcb, CAM_STAND_v1.PrjPcb, INFO.SchDoc, MAIN.SchDoc]
2025-04-03 upd CAM rev2.01
    [CAM_DVB-CI_v2.01.PrjPcb, FPGA.SchDoc, MAIN.SchDoc, STM32.SchDoc]
2025-04-04 add lattice references
    [003-00004.PrjPcb, 003-00004.SchDoc, 1054500101.stp, ECP5_V2.PcbLib, ECP5_V2.PrjPcb, ECP5_V2.SchLib, ECP5_V2_BOM-ECP5_V2.xlsx, FPGA-SC-02033-2-0-ECP5U-25-Pinout color.xlsx]
2025-04-04 upd CAM rev2.01
    добавлен сигнал PROGRAMN на T15
    [FPGA.SchDoc]
2025-04-04 upd CAM rev.2.01
    [CAM_DVB-CI_v2.01.PrjPcb]
2025-04-05 Удалил
2025-04-07 схема
2025-04-14 upd CAM 2.01 и CAM_STAND
    CAM 2.01
    - убраны ошибки трассировки
    - добавлены файлы для производства
    CAM_STAND
    - добавлен разъем JTAG для другой распиновки FPGA
    - трассировка закончена
    [CAM_DVB-CI_v2.01_rev.2.01_BOM 2025-04-14 13-43.xlsx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]
2025-04-15 Update CAM_DVB-CI_v2.01_rev.2.01_BOM 2025-04-14 13-43.xlsx
    [CAM_DVB-CI_v2.01_rev.2.01_BOM 2025-04-14 13-43.xlsx]
2025-05-19 add CAM_LATTICE rev.2.02
    - изменена ширина платы до 49мм
    [CAM_DVB-CI_v2.02.PrjPcb, CAM_DVB-CI_v2.02_rev.2.02_BOM 2025-05-19 17-12.xlsx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]
2025-05-19 upd CAM_2.02
    [CAM_DVB-CI_v2.02.PrjPcb]
2025-05-28 upd 2.02 files
    [EQ - CAM_DVB-CI_v2.01_ans.xls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]
2025-05-29 Добавил описание товаров, КД, ЭД
    [Комплект оснастки.xlsx, Плита для рамки 6 мульти.stp, Плита для рамки2.stp, Плита пресс 6 мульти.stp, Плита пресс.stp, Плита_ТЕНШ.741428.001.stp, Плита_ТЕНШ.741428.002.stp, Штырь.stp]
2025-06-02 очепятка
2025-09-01 upd
    - добавлен CAM V2.1
    - добавлен удлинитель CAM_EXT
    [CAM_DVB-CI_v2.01_rev.2.01_BOM 2025-07-21 01-32.xlsx, CAM_DVB-CI_v2.02.PrjPcb, CAM_DVB-CI_v2.1.PrjPcb, CAM_DVB-CI_v2.1_release_rev.2.1_BOM 2025-09-01 13-29.xlsx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]
2025-09-01 add CAM_DVB_CI_v.2.03
    [CAM_DVB-CI_v2.03.PrjPcb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]
