SiwaNetwork/CASS/(notices)

Notices in the files:
INCUBATION/joker-tv-fpga-master/opencores_i2c/i2c_master_top.v:
Copyright (C) 2001 Richard Herveille
INCUBATION/Open_DVB_CI/Open DVB-CI/tlproject/src/CITLMsg.h:
under the terms of the GNU General Public License as published by the
Free Software Foundation; either version 2 of the License,
or (at your option) any later version.
CAM_LATTICE_STM/LATTICE REFERENCE/logicbone-master/supervisor.sch:
Licensed under CERN OHL v1.2
